fingoldin/lpddr5-testbed/fab/README.md

# Fabrication and assembly package: LPDDR5-CMD-TESTBED ZCU104 R0.2

Generated by `scripts/make_fab.py` and verified by `scripts/check_fab.py`; do not edit by hand. Regenerate with
`scripts/pcb/build.sh && python3 scripts/make_fab.py` (or `scripts/pcb/build.sh --fab`).

| | |
|---|---|
| Board file | `lpddr5-testbed.kicad_pcb` |
| SHA-256 of the board file | `ad7fe7fb7fc2977633b94e019d2710f937414a46d8ac770d9c7f32a83e93a95c` |
| Generated | 2026-11-11 04:40:53 -0800, KiCad (kicad-cli) 10.0.6 |
| Verification | **56 checks, 0 failed** (`verify/report.txt`) |
| KiCad DRC, all severities, with schematic parity | **0 errors, 0 unconnected, 0 parity issues**; 9 warnings (diff_pair_gap_out_of_range x 9) |

No fab vendor is targeted. The data are plain Gerber X2 and Excellon; everything a quotation form asks for is in the next section, and
everything the Gerbers cannot say is in `drawings/lpddr5-testbed-fabrication.pdf` (the notes are also on layer User.Comments).

## Order parameters

### Bare board

| Parameter | Value |
|---|---|
| Size | 69.6 x 30.0 mm (DDR4 SO-DIMM module outline), one board per unit; must be delivered in a panel (30 mm high) |
| Layers | 6 |
| Material | FR-4, Tg >= 170 C |
| **Finished thickness** | **1.20 +/-0.10 mm measured over the gold fingers** (an absolute tolerance, not +/-10 %); nominal 1.212 mm with mask, 1.192 mm at the bare fingers |
| Stackup | specified, see below; the three 0.11 mm prepregs set the impedances |
| Copper | outer 0.035 mm (0.040 mm finished nominal), inner 0.018 mm |
| Minimum track / gap | 0.09 mm track (inside the BGA field of U1 only; 0.10 mm elsewhere) / 0.10 mm gap |
| Holes | 393 plated (235 x 0.15 mm, 158 x 0.20 mm), 2 non-plated (1.80 mm); through holes only |
| Minimum annular ring | 0.10 mm (IPC-6012 class 2; class 3 is not attainable) |
| Via-in-pad | **253 vias filled and capped, IPC-4761 type VII** (235 x 0.15 mm in the lands of U1, 18 x 0.20 mm: `drill/filled_capped_vias.csv`); all other vias tented |
| Unused inner-layer pads | removed in the data on all vias except the ten command node vias: do not add them back |
| Surface finish | hard gold over nickel on the 260 finger lands of J1 (30 uin min), ENIG on all other exposed copper |
| Edge connector | 260 gold fingers, 0.25 mm x 45 deg chamfer only (no deep bevel); finger copper starts <= 0.30 mm from the edge; no plating tie bars left on the card |
| Controlled impedance | yes, five geometries, all +/-10 %, table below; TDR coupons on the panel border |
| Solder mask | LPI, both faces, black (green allowed if the 0.08 mm dam of the 0201 lands cannot be held in black) |
| Legend | white, both faces |
| Copper thieving | **none inside the card outline** (outer layers are 16-17 % copper by design; balance with robber bars on the panel border) |
| Acceptance | IPC-6012 class 2; 100 % netlist test against `netlist/lpddr5-testbed.d356`; bow and twist <= 0.5 %, flatness over the finger row <= 0.15 mm |
| Panel | routed outline, break-off tabs on the top edge or on the sides above the latch notches only (y > 22 mm), no V-score; three fiducials per face on the rails |

Stackup (top to bottom):

| Layer | Material | Thickness mm | er |
|---|---|---|---|
| F.Mask | LPI solder mask | 0.010 | 3.50 |
| F.Cu | copper | 0.035 |  |
|  | prepreg PR2116 | 0.110 | 4.29 |
| In1.Cu | copper | 0.018 |  |
|  | core FR4 | 0.360 | 4.29 |
| In2.Cu | copper | 0.018 |  |
|  | prepreg PR2116 | 0.110 | 4.29 |
| In3.Cu | copper | 0.018 |  |
|  | core FR4 | 0.360 | 4.29 |
| In4.Cu | copper | 0.018 |  |
|  | prepreg PR2116 | 0.110 | 4.29 |
| B.Cu | copper | 0.035 |  |
| B.Mask | LPI solder mask | 0.010 | 3.50 |

Impedance classes (design values from the 2-D field solver, `design/impedance_results.json`; outer layers for 0.040 mm copper under 0.020 mm mask):

| Layer | Type | Width / gap mm | Design | Order |
|---|---|---|---|---|
| In3.Cu (stripline between In2 and In4) | single | 0.15 | 45.6 ohm | 46 ohm |
| In3.Cu | differential | 0.10 / 0.10 | 84.6 ohm | 85 ohm |
| F.Cu / B.Cu (microstrip over In1 / In4) | single | 0.20 | 45.6 ohm | 46 ohm |
| F.Cu | single | 0.15 | 52.4 ohm | 52 ohm |
| F.Cu / B.Cu | differential | 0.10 / 0.10 | 91.8 ohm | 92 ohm |

### Assembly

| Parameter | Value |
|---|---|
| Parts | 119 placements, 27 BOM lines, none DNP: 59 on the top face, 60 on the bottom face (double-sided reflow) |
| Smallest part | 0201 (0603 metric): 61 of them |
| Fine pitch | U1: 315-ball FBGA, 0.80 x 0.70 mm pitch, lands 0.41 mm, via-in-pad filled and capped; U2 VSON-10 0.5 mm; U5 WSON-8 0.5 mm; U4 MLF-6 0.65 mm |
| Tallest part | 1.10 mm on either face (module limit 1.20 mm per face); see the open item on the body height of U1 in `design/DESIGN.md` section 8 |
| Fiducials | three per face on the card (`assembly/lpddr5-testbed-fiducials.csv`): 1.0 mm copper dot in a 2.0 mm mask opening |
| Stencil | 0.10 mm; no paste on the fingers, the test pads and the fiducials |
| Not placed | J1 (the card edge), TP1-TP5 (test pads), FID1-FID6 |

## Conventions of the coordinate files

- **Origin**: the drill / place origin of the board = the lower-left corner of the card rectangle seen from the front (the finger-1 end of the
  finger edge). **x to the right, y up, millimetres** in the Gerber, Excellon and placement files; the IPC-D-356 file uses 0.0001 inch, same origin.
  The profile therefore spans x 0 .. 69.6, y 0 .. 30.0.
- **Gerber**: X2 attributes, format 4.6, aperture macros enabled, one file per layer, KiCad file names (`.gbr`); the mask files are negative
  (drawn = opening); the legend files have the mask openings subtracted.
- **Excellon**: metric, decimal coordinates, plated and non-plated holes in separate files, finished hole sizes.
- **Placement files** (`Ref, Val, Package, PosX, PosY, Rot, Side`): PosX / PosY are the footprint origin (the centre of the part) in the frame above.
  **The bottom face is NOT mirrored**: x is as seen from the front, through the card. **Rot** is the KiCad footprint orientation: degrees
  counter-clockwise **seen from the front (top) of the card for both faces**; at Rot = 0 a top-side part has its library orientation (pin 1 as in the
  KiCad footprint), and a bottom-side part is the library footprint mirrored top-to-bottom (KiCad's flip). Seen from the back, a bottom-side part is
  therefore rotated by (180 - Rot) degrees counter-clockwise from its library orientation. `check_fab.py` recomputes every numbered pad of every part
  from the row and this convention and compares it with the board.

## Files

| File | Size | Content |
|---|---|---|
| `gerber/lpddr5-testbed-F_Cu.gbr` | 64.5 kB | copper layer 1 (top): parts, the DQ comb, finger stubs, 1.2 V strip; no pour |
| `gerber/lpddr5-testbed-In1_Cu.gbr` | 178.0 kB | copper layer 2: GND plane |
| `gerber/lpddr5-testbed-In2_Cu.gbr` | 190.3 kB | copper layer 3: GND plane with the 1.2 V island under the VDD fingers |
| `gerber/lpddr5-testbed-In3_Cu.gbr` | 12.8 kB | copper layer 4: high-speed stripline (command bundle, read branches, RDQS) |
| `gerber/lpddr5-testbed-In4_Cu.gbr` | 212.6 kB | copper layer 5: GND plane with the VDD2H island under U1 |
| `gerber/lpddr5-testbed-B_Cu.gbr` | 81.8 kB | copper layer 6 (bottom): WCK pair, read finger tracks, decoupling, U3 / U4, power pours under U1 |
| `gerber/lpddr5-testbed-F_Mask.gbr` | 17.3 kB | solder mask top (negative: drawn = opening); the finger strip is open up to y = 2.75 mm |
| `gerber/lpddr5-testbed-B_Mask.gbr` | 9.7 kB | solder mask bottom |
| `gerber/lpddr5-testbed-F_Paste.gbr` | 13.7 kB | paste top (stencil) |
| `gerber/lpddr5-testbed-B_Paste.gbr` | 6.3 kB | paste bottom (stencil) |
| `gerber/lpddr5-testbed-F_Silkscreen.gbr` | 79.1 kB | legend top (mask openings subtracted) |
| `gerber/lpddr5-testbed-B_Silkscreen.gbr` | 40.7 kB | legend bottom (mask openings subtracted) |
| `gerber/lpddr5-testbed-Edge_Cuts.gbr` | 1.6 kB | board profile: 69.6 x 30.0 mm with key slot, two latch notches, four corner chamfers |
| `gerber/lpddr5-testbed-User_Comments.gbr` | 1.80 MB | fabrication notes 1-13 as drawn on the board (the same text is sheet 3 of the fabrication drawing) |
| `gerber/lpddr5-testbed-User_Drawings.gbr` | 28.4 kB | mechanical layer of the card-edge footprint: component keep-out and height zones, finger numbers |
| `gerber/lpddr5-testbed-F_Fab.gbr` | 152.8 kB | assembly layer top: part outlines and references |
| `gerber/lpddr5-testbed-B_Fab.gbr` | 141.0 kB | assembly layer bottom |
| `gerber/lpddr5-testbed-job.gbrjob` | 5.5 kB | Gerber job file: layer list, stackup, thickness, finish, design rules |
| `drill/lpddr5-testbed-PTH.drl` | 5.3 kB | Excellon, plated holes: every via (0.15 and 0.20 mm) |
| `drill/lpddr5-testbed-NPTH.drl` | 389 B | Excellon, non-plated holes: the two 1.80 mm tooling holes |
| `drill/lpddr5-testbed-PTH-drl_map.pdf` | 25.3 kB | drill map of the plated holes |
| `drill/lpddr5-testbed-NPTH-drl_map.pdf` | 12.8 kB | drill map of the non-plated holes |
| `drill/lpddr5-testbed-drill_report.txt` | 869 B | KiCad drill report: tools and hit counts |
| `drill/lpddr5-testbed-filled_capped.drl` | 3.9 kB | Excellon subset: the vias to be filled and capped (IPC-4761 type VII) |
| `drill/filled_capped_vias.csv` | 13.7 kB | the same vias as a list: position, drill, pad, net and what each one sits in |
| `drill/gerber_x2/lpddr5-testbed-PTH-drl.gbr` | 9.3 kB | the plated holes as a Gerber X2 drill file (same holes as the Excellon file) |
| `drill/gerber_x2/lpddr5-testbed-NPTH-drl.gbr` | 633 B | the non-plated holes as a Gerber X2 drill file |
| `drill/gerber_x2/lpddr5-testbed-filling-front-back.gbr` | 6.3 kB | KiCad's via-filling layer: the filled vias |
| `drill/gerber_x2/lpddr5-testbed-capping-front-back.gbr` | 6.3 kB | KiCad's via-capping layer: the capped vias (the same set) |
| `netlist/lpddr5-testbed.d356` | 90.0 kB | IPC-D-356 netlist for the bare-board electrical test (inches x 0.0001, same origin) |
| `assembly/lpddr5-testbed-top.pos.csv` | 4.0 kB | pick-and-place, top face |
| `assembly/lpddr5-testbed-bottom.pos.csv` | 4.2 kB | pick-and-place, bottom face (x NOT mirrored) |
| `assembly/lpddr5-testbed-fiducials.csv` | 277 B | the six card fiducials (not in the placement files) |
| `assembly/lpddr5-testbed-bom.csv` | 4.5 kB | bill of materials, one line per part number: item, quantity, references, value, footprint, manufacturer, MPN, DNP, side, quantity per face |
| `assembly/lpddr5-testbed-bom-per-part.csv` | 18.1 kB | bill of materials, one row per reference with its face |
| `assembly/lpddr5-testbed-assembly-top.pdf` | 104.1 kB | assembly drawing top, 4.5 : 1, with the parts of that face |
| `assembly/lpddr5-testbed-assembly-bottom.pdf` | 80.7 kB | assembly drawing bottom, 4.5 : 1, seen from the back |
| `drawings/lpddr5-testbed-fabrication.pdf` | 61.6 kB | fabrication drawing, 3 sheets A3: outline with dimensions and drill map; stackup, impedance, via treatment; notes |
| `drawings/lpddr5-testbed-schematic.pdf` | 545.4 kB | schematic, 7 sheets |
| `3d/lpddr5-testbed.step` | 773.2 kB | STEP model of the card with the parts that have a 3-D model |
| `verify/report.txt` | 8.0 kB | result of scripts/check_fab.py, one line per check |
| `verify/report.json` | 17.5 kB | the same with the measured numbers |
| `verify/drc.json` | 8.9 kB | KiCad DRC report (all severities, schematic parity) |
| `verify/gerber_*.png` | 13 images | the Gerber files read back and rasterised by `check_fab.py` (30 px/mm): six copper layers with the drill hits, masks, pastes, legends, profile |

Notes on single files:

- `3d/lpddr5-testbed.step`: board body with the 117 parts whose footprint has a 3-D model (stock KiCad models). **No model**: FID1, FID2, FID3, FID4, FID5, FID6, J1, TP1, TP2, TP3, TP4, TP5, U1, U4 (project footprints, test pads, fiducials, the card edge): the BGA U1, the tallest part, is NOT in the model.
- `drill/gerber_x2/`: KiCad 10.0.6 writes the file-function attribute of its filling and capping layers as `%TF,FileFunction` (a comma instead of
  the dot); `make_fab.py` corrects that one character in `lpddr5-testbed-capping-front-back.gbr` and `lpddr5-testbed-filling-front-back.gbr`. Nothing else in any exported file is altered.
- The filled-and-capped set is given three ways (Excellon subset, CSV list, KiCad's X2 filling / capping layers) and in fabrication note 6; they are
  checked against each other and against the via attributes of the board file.
- `.gitignore` of the repository ignores `*.csv`: the BOM, placement and via-list files of this directory are hidden from git unless `!fab/**/*.csv` is added.

## Verification (`scripts/check_fab.py`)

The files are read back with parsers written for this purpose (Gerber with aperture macros, regions, arcs and polarity; Excellon; IPC-D-356; CSV)
and compared with the board as the pcbnew API reports its items, not with another plot. Copper layers are rasterised at 80 px/mm from the Gerber
file and, separately, from the tracks, arcs, via pads per layer, pad polygons and zone fills of the board; the two images must agree to one pixel.

| Group | Check | Result | Measured |
|---|---|---|---|
| gerber | all 17 layer files present and readable | pass | 17 files |
| gerber | six copper layers carry the X2 file functions L1 (Top), L2 .. L5 (Inr), L6 (Bot) | pass | F.Cu=Copper,L1,Top; In1.Cu=Copper,L2,Inr; In2.Cu=Copper,L3,Inr; In3.Cu=Copper,L4,Inr; In4.Cu=Copper,L5,Inr; B.Cu=Copper,L6,Bot |
| gerber | mask, paste, legend, profile and drawing files carry their X2 file functions | pass | all as expected |
| gerber | every selected aperture is defined, none has a zero dimension, no unsupported statement | pass | apertures per file: F.Cu 31, In1.Cu 2, In2.Cu 2, In3.Cu 4, In4.Cu 2, B.Cu 27, F.Mask 21, B.Mask 17, F.Paste 16, B.Paste 13, F.Silkscreen 23, B.Silkscreen 19, Edge.Cuts 1, User.Comments 2, User.Drawings 4, F.Fab 4, B.Fab 4 |
| gerber | job file: 6 layers, board thickness of the stackup, edge connector without bevel | pass | layers 6, thickness 1.212 mm, finish ENIG, impedance controlled True |
| profile | extents of the profile centre line = 0 .. 69.6 x 0 .. 30.0 mm, origin at the lower-left card corner | pass | x 0.0000 .. 69.6000, y 0.0000 .. 30.0000 |
| profile | the profile is ONE closed contour; its area equals the board outline of the board file | pass | 1 contour(s), 2069.750 mm2 (board 2069.754 mm2, difference area 0.0084 mm2) |
| drill | plated file: every hit is a via / plated hole of the board with that diameter, and the reverse | pass | file 235 x 0.15 mm, 158 x 0.20 mm; board 235 x 0.15 mm, 158 x 0.20 mm (393 vias) |
| drill | non-plated file: the two 1.80 mm tooling holes of the card edge | pass | file 2 x 1.80 mm; board 2 x 1.80 mm |
| drill | filled = capped on every via that carries either attribute | pass | 253 filled and capped of 393 vias |
| drill | filled-and-capped drill file = the vias with the attribute in the board file | pass | file 235 x 0.15 mm, 18 x 0.20 mm |
| drill | X2 filling layer = the same 253 vias; header well-formed | pass | 253 flashes |
| drill | X2 capping layer = the same 253 vias; header well-formed | pass | 253 flashes |
| drill | filled_capped_vias.csv lists the same vias | pass | 253 rows |
| copper | F.Cu: the Gerber image equals the layer drawn from the board items (tolerance one pixel = 12.5 um) | pass | 2171781 / 2171017 copper pixels, 764 differ at edges (0.035 %), beyond one pixel: 0 only in the Gerber, 0 only on the board |
| copper | F.Cu: no copper outside the profile | pass | nearest copper 0.163 mm from the edge; 16.4 % of the card area is copper |
| copper | In1.Cu: the Gerber image equals the layer drawn from the board items (tolerance one pixel = 12.5 um) | pass | 12184343 / 12184343 copper pixels, 0 differ at edges (0.000 %), beyond one pixel: 0 only in the Gerber, 0 only on the board |
| copper | In1.Cu: no copper outside the profile | pass | nearest copper 0.302 mm from the edge; 92.0 % of the card area is copper |
| copper | In2.Cu: the Gerber image equals the layer drawn from the board items (tolerance one pixel = 12.5 um) | pass | 12386240 / 12386240 copper pixels, 0 differ at edges (0.000 %), beyond one pixel: 0 only in the Gerber, 0 only on the board |
| copper | In2.Cu: no copper outside the profile | pass | nearest copper 0.301 mm from the edge; 93.5 % of the card area is copper |
| copper | In3.Cu: the Gerber image equals the layer drawn from the board items (tolerance one pixel = 12.5 um) | pass | 301158 / 301159 copper pixels, 1 differ at edges (0.000 %), beyond one pixel: 0 only in the Gerber, 0 only on the board |
| copper | In3.Cu: no copper outside the profile | pass | nearest copper 1.818 mm from the edge; 2.3 % of the card area is copper |
| copper | In4.Cu: the Gerber image equals the layer drawn from the board items (tolerance one pixel = 12.5 um) | pass | 12124966 / 12124966 copper pixels, 0 differ at edges (0.000 %), beyond one pixel: 0 only in the Gerber, 0 only on the board |
| copper | In4.Cu: no copper outside the profile | pass | nearest copper 0.302 mm from the edge; 91.5 % of the card area is copper |
| copper | B.Cu: the Gerber image equals the layer drawn from the board items (tolerance one pixel = 12.5 um) | pass | 2089602 / 2088730 copper pixels, 872 differ at edges (0.042 %), beyond one pixel: 0 only in the Gerber, 0 only on the board |
| copper | B.Cu: no copper outside the profile | pass | nearest copper 0.163 mm from the edge; 15.8 % of the card area is copper |
| copper | edge clearance: outer layers 0.15 mm (the fingers), every inner layer pulled back 0.3 mm or more | pass | F.Cu 0.16, In1.Cu 0.30, In2.Cu 0.30, In3.Cu 1.82, In4.Cu 0.30, B.Cu 0.16 |
| drill | every plated hit lies on copper on F.Cu and on B.Cu (outer via pads are kept) | pass | 393 of 393 hits |
| mask | all 260 fingers of J1 are free of solder mask over their whole land | pass | 260 lands inside the openings |
| mask | test pads and fiducials are open | pass | 11 pads |
| mask | plain vias are tented: the mask covers the centre of each on both faces | pass | 140 plain vias, 0 openings over a via centre |
| mask | the mask-free finger strip ends below the row of finger vias (y = 3.05 mm) | pass | 57 finger vias covered |
| paste | F.Paste: one aperture per pad that has paste | pass | 457 flashes, 457 pads with paste |
| paste | F.Paste: every paste aperture lies inside a mask opening | pass | 0 pixels outside |
| paste | B.Paste: one aperture per pad that has paste | pass | 129 flashes, 129 pads with paste |
| paste | B.Paste: every paste aperture lies inside a mask opening | pass | 0 pixels outside |
| paste | no paste on the fingers, the test pads and the fiducials | pass | 271 lands checked |
| legend | F.Silkscreen: no legend ink on exposed copper, none outside the card | pass | 152897 pixels of legend, 0 over mask openings, 0 outside |
| legend | B.Silkscreen: no legend ink on exposed copper, none outside the card | pass | 55630 pixels of legend, 0 over mask openings, 0 outside |
| netlist | IPC-D-356: one record per via, per numbered pad, per fiducial and per non-plated hole of the board | pass | 393 via records (393 vias), 844 pad records (844 numbered pads, 840 distinct pins), 6 fiducials, 2 non-plated holes |
| netlist | IPC-D-356: net names are in one-to-one relation with the nets of the board (names are cut to 14 characters) | pass | 225 nets |
| netlist | IPC-D-356: vias per net equal the board | pass | GND 199, 35 nets with vias |
| position | lpddr5-testbed-top.pos.csv: one row per placed part of that face (fingers, test pads and fiducials excluded) | pass | 59 rows, 59 parts on the board |
| position | lpddr5-testbed-top.pos.csv: X / Y = footprint position in the card frame (origin lower-left corner seen from the front, y up, x not mirrored), side column 'top' | pass | 59 rows |
| position | lpddr5-testbed-top.pos.csv: Rot = KiCad orientation; every numbered pad lands where 'counter-clockwise seen from the front' puts it | pass | 59 parts |
| position | lpddr5-testbed-bottom.pos.csv: one row per placed part of that face (fingers, test pads and fiducials excluded) | pass | 60 rows, 60 parts on the board |
| position | lpddr5-testbed-bottom.pos.csv: X / Y = footprint position in the card frame (origin lower-left corner seen from the front, y up, x not mirrored), side column 'bottom' | pass | 60 rows |
| position | lpddr5-testbed-bottom.pos.csv: Rot = KiCad orientation; every numbered pad lands where 'counter-clockwise seen from the front, footprint mirrored top-to-bottom' puts it | pass | 60 parts |
| position | fiducial list = FID1 .. FID6 of the board, three per face | pass | 6 rows |
| bom | BOM: every line agrees with the board (value, footprint, manufacturer, MPN, DNP, quantity, side counts) | pass | 27 lines |
| bom | BOM: every BOM part of the board is listed exactly once; nothing else is | pass | 119 references in 27 lines; board 119 (59 top, 60 bottom) |
| bom | BOM: lines and quantities equal design/netlist.json (bom_summary) | pass | 27 lines, 119 parts, 0 DNP |
| bom | position files and BOM list the same parts | pass | 119 / 119 |
| bom | per-part list: one row per BOM part with its face | pass | 119 rows |
| drc | kicad-cli DRC, all severities, with schematic parity: 0 errors, 0 unconnected, 0 parity issues; the only warnings are pair gaps where legs part | pass | KiCad 10.0.6: 0 errors, 9 warnings (diff_pair_gap_out_of_range x 9), 0 unconnected, 0 parity issues |
| board | the board file is unchanged by the verification | pass | ad7fe7fb7fc2977633b94e019d2710f937414a46d8ac770d9c7f32a83e93a95c |

Copper per layer, measured on the Gerber images:

| Layer | Flashes / draws / regions | Copper, % of the card | Nearest copper to the edge mm | Pixels that differ from the board items beyond one pixel |
|---|---|---|---|---|
| F.Cu | 982 / 451 / 0 | 16.4 | 0.16 | 0 |
| In1.Cu | 209 / 0 / 1 | 92.0 | 0.30 | 0 |
| In2.Cu | 218 / 0 / 2 | 93.5 | 0.30 | 0 |
| In3.Cu | 40 / 222 / 0 | 2.3 | 1.82 | 0 |
| In4.Cu | 198 / 0 / 2 | 91.5 | 0.30 | 0 |
| B.Cu | 654 / 259 / 6 | 15.8 | 0.16 | 0 |
