fingoldin/lpddr5-testbed/design/gateware/PINMAP.md

# Pin map of the LPDDR5 test card on the ZCU104 (socket J1)

> GENERATED by scripts/gen_gateware.py from design/netlist.json (revision 0.2, 2026-11-10) and
> design/gateware_deskew.json.  Do not edit: change the spec and re-run the generator.

Constraints: `lpddr5_testbed_zcu104.xdc`. The same table as CSV: `pinmap.csv` (with the full FPGA pin names). Part `xczu7ev-ffvc1156-2-e`.

- **P / N** is the polarity of the FPGA pin inside its I/O pair. A port `<x>_p` is always the FPGA P pin.
- **Bitslice** is the position inside the nibble (lower nibble N0-N5 = 0-5, upper nibble N6-N12 = 0-6); position 0 is
  the strobe / clock position of a native-mode nibble.
- **Level** is min / nominal / max over FPGA driver 26 / 36 / 44 ohm, VCCO 1.14 / 1.20 / 1.26 V and 1 % resistors
  (`analysis.dividers`), at the DRAM ball for outputs and at the FPGA pin for inputs.
- **Deskew** is the static delay the FPGA adds on that pin (`design/gateware_deskew.json`): ODELAYE3 for outputs,
  IDELAYE3 for inputs, `DELAY_FORMAT = "TIME"`, ps. Empty = none (matched on the card or static).

## Command (matched on the card)

| Port | Finger | FPGA ball | Bank | Nibble | Bitslice | P / N | Net at the finger | DRAM ball | Direction | I/O standard | On-card network | Level | Deskew ps |
|---|---|---|---|---|---|---|---|---|---|---|---|---|---|
| `ca[0]` | 84 B | AN22 | 65 | T0U | 2 | P | CA0_F | G4 | out | SSTL12, OUTPUT_IMPEDANCE RDRV_40_40, SLEW FAST | finger - R101 91R series - node CA0 - U1.G4; R111 68R node to GND | 0.378 / 0.418 / 0.468 V high, 0 V low |  |
| `ca[1]` | 83 F | AP23 | 65 | T0U | 3 | N | CA1_F | H5 | out | SSTL12, OUTPUT_IMPEDANCE RDRV_40_40, SLEW FAST | finger - R102 91R series - node CA1 - U1.H5; R112 68R node to GND | 0.378 / 0.418 / 0.468 V high, 0 V low |  |
| `ca[2]` | 79 F | AN19 | 65 | T0L | 3 | N | CA2_F | G8 | out | SSTL12, OUTPUT_IMPEDANCE RDRV_40_40, SLEW FAST | finger - R103 91R series - node CA2 - U1.G8; R113 68R node to GND | 0.378 / 0.418 / 0.468 V high, 0 V low |  |
| `ca[3]` | 70 B | AN23 | 65 | T0U | 5 | N | CA3_F | H11 | out | SSTL12, OUTPUT_IMPEDANCE RDRV_40_40, SLEW FAST | finger - R104 91R series - node CA3 - U1.H11; R114 68R node to GND | 0.378 / 0.418 / 0.468 V high, 0 V low |  |
| `ca[4]` | 71 F | AM23 | 65 | T0U | 4 | P | CA4_F | G10 | out | SSTL12, OUTPUT_IMPEDANCE RDRV_40_40, SLEW FAST | finger - R105 91R series - node CA4 - U1.G10; R115 68R node to GND | 0.378 / 0.418 / 0.468 V high, 0 V low |  |
| `ca[5]` | 66 B | AP22 | 65 | T0L | 5 | N | CA5_F | H13 | out | SSTL12, OUTPUT_IMPEDANCE RDRV_40_40, SLEW FAST | finger - R106 91R series - node CA5 - U1.H13; R116 68R node to GND | 0.378 / 0.418 / 0.468 V high, 0 V low |  |
| `ca[6]` | 67 F | AP21 | 65 | T0L | 4 | P | CA6_F | G12 | out | SSTL12, OUTPUT_IMPEDANCE RDRV_40_40, SLEW FAST | finger - R107 91R series - node CA6 - U1.G12; R117 68R node to GND | 0.378 / 0.418 / 0.468 V high, 0 V low |  |
| `ck_p` | 76 B | AM21 | 65 | T0U | 0 | P (DBC) | CK_F_P | H9 | out | DIFF_SSTL12, OUTPUT_IMPEDANCE RDRV_40_40, SLEW FAST | finger - R109 91R series - node CK_P - U1.H9; R119 68R node to GND | per leg 0.378 / 0.418 / 0.468 V high, 0 V low |  |
| `ck_n` | 74 B | AN21 | 65 | T0U | 1 | N (DBC) | CK_F_N | J9 | out | DIFF_SSTL12, OUTPUT_IMPEDANCE RDRV_40_40, SLEW FAST | finger - R110 91R series - node CK_N - U1.J9; R120 68R node to GND | per leg 0.378 / 0.418 / 0.468 V high, 0 V low |  |
| `cs0` | 80 B | AM19 | 65 | T0L | 2 | P | CS0_F | H7 | out | SSTL12, OUTPUT_IMPEDANCE RDRV_40_40, SLEW FAST | finger - R108 33R series - node CS0 - U1.H7; R118 100R node to GND | 0.640 / 0.710 / 0.797 V high, 0 V low |  |
| `cmd_open_low` | 75 F | AP19 | 65 | T0L | 0 | P (DBC) | (open) | - | out (static low) | SSTL12, OUTPUT_IMPEDANCE RDRV_40_40, SLEW SLOW | finger open on the card (no copper) | - |  |

## Write

| Port | Finger | FPGA ball | Bank | Nibble | Bitslice | P / N | Net at the finger | DRAM ball | Direction | I/O standard | On-card network | Level | Deskew ps |
|---|---|---|---|---|---|---|---|---|---|---|---|---|---|
| `wdq[0]` | 150 B | AL15 | 64 | T1L | 3 | N | DQ0_WF | D1 | out (Hi-Z during reads) | SSTL12, OUTPUT_IMPEDANCE RDRV_40_40, SLEW FAST | finger - R201 240R series - node DQ0 - U1.D1; R211 150R node to GND | 0.389 / 0.423 / 0.460 V high, 0 V low | 40.7 |
| `wdq[1]` | 145 F | AL16 | 64 | T1L | 2 | P | DQ1_WF | C2 | out (Hi-Z during reads) | SSTL12, OUTPUT_IMPEDANCE RDRV_40_40, SLEW FAST | finger - R202 240R series - node DQ1 - U1.C2; R212 150R node to GND | 0.389 / 0.423 / 0.460 V high, 0 V low | 51.0 |
| `wdq[2]` | 156 B | AA14 | 64 | T3U | 2 | P | DQ2_WF | E2 | out (Hi-Z during reads) | SSTL12, OUTPUT_IMPEDANCE RDRV_40_40, SLEW FAST | finger - R203 240R series - node DQ2 - U1.E2; R213 150R node to GND | 0.389 / 0.423 / 0.460 V high, 0 V low | 27.1 |
| `wdq[3]` | 151 F | AA16 | 64 | T3U | 0 | P (DBC) | DQ3_WF | D3 | out (Hi-Z during reads) | SSTL12, OUTPUT_IMPEDANCE RDRV_40_40, SLEW FAST | finger - R204 240R series - node DQ3 - U1.D3; R214 150R node to GND | 0.389 / 0.423 / 0.460 V high, 0 V low | 41.0 |
| `wdq[4]` | 143 F | AD16 | 64 | T3U | 5 | N | DQ4_WF | B5 | out (Hi-Z during reads) | SSTL12, OUTPUT_IMPEDANCE RDRV_40_40, SLEW FAST | finger - R205 240R series - node DQ4 - U1.B5; R215 150R node to GND | 0.389 / 0.423 / 0.460 V high, 0 V low | 53.5 |
| `wdq[5]` | 144 B | AH16 | 64 | T2U | 6 | - | DQ5_WF | C6 | out (Hi-Z during reads) | SSTL12, OUTPUT_IMPEDANCE RDRV_40_40, SLEW FAST | finger - R206 240R series - node DQ5 - U1.C6; R216 150R node to GND | 0.389 / 0.423 / 0.460 V high, 0 V low | 23.1 |
| `wdq[6]` | 157 F | AL17 | 64 | T1U | 6 | - | DQ6_WF | E6 | out (Hi-Z during reads) | SSTL12, OUTPUT_IMPEDANCE RDRV_40_40, SLEW FAST | finger - R207 240R series - node DQ6 - U1.E6; R217 150R node to GND | 0.389 / 0.423 / 0.460 V high, 0 V low | 3.4 |
| `wdq[7]` | 161 F | AM16 | 64 | T1L | 0 | P (QBC) | DQ7_WF | F5 | out (Hi-Z during reads) | SSTL12, OUTPUT_IMPEDANCE RDRV_40_40, SLEW FAST | finger - R208 240R series - node DQ7 - U1.F5; R218 150R node to GND | 0.389 / 0.423 / 0.460 V high, 0 V low | 0.0 |
| `wck_p` | 137 F | AF18 | 64 | T2L | 2 | P (GC), **inverted pair** | WCK_F_N | D5 | out | DIFF_SSTL12, OUTPUT_IMPEDANCE RDRV_40_40, SLEW FAST | finger - R210 91R series - node WCK_N - U1.D5; R220 68R node to GND | per leg 0.378 / 0.418 / 0.468 V high, 0 V low |  |
| `wck_n` | 139 F | AG18 | 64 | T2L | 3 | N (GC), **inverted pair** | WCK_F_P | E4 | out | DIFF_SSTL12, OUTPUT_IMPEDANCE RDRV_40_40, SLEW FAST | finger - R209 91R series - node WCK_P - U1.E4; R219 68R node to GND | per leg 0.378 / 0.418 / 0.468 V high, 0 V low |  |

## Read

| Port | Finger | FPGA ball | Bank | Nibble | Bitslice | P / N | Net at the finger | DRAM ball | Direction | I/O standard | On-card network | Level | Deskew ps |
|---|---|---|---|---|---|---|---|---|---|---|---|---|---|
| `rdq_p[0]` | 204 B | AH11 | 66 | T2L | 2 | P (GC) | DQ0 | D1 | in | MIPI_DPHY_DCI, DIFF_TERM_ADV TERM_NONE | U1.D1 - node DQ0 - finger (no series part); R211 150R node to GND = read load; R201 240R to the write finger 150 | read high 0.374 / 0.386 / 0.405 V into 150 ohm (LPDDR4X IBIS proxies (0.766 .. 0.792 x VDDQ into 150 ohm)), low 0 V | 52.8 |
| `rdq_n[0]` | 203 F | AJ11 | 66 | T2L | 3 | N (GC) | VREF_N0 | - | in (DC) | MIPI_DPHY_DCI, DIFF_TERM_ADV TERM_NONE | finger - R321 39R - VREF_RD (DAC_OUT -300R- VREF_RD ; VDDQ -300R- VREF_RD ; VREF_RD -180R- GND ; 1 uF + 8 x 100 nF on the bus) | VREF_RD: 0.187 V with the DAC Hi-Z (power-up), 0.195 V at DAC code 121; range 0.136 .. 0.631 V |  |
| `rdq_p[1]` | 208 B | AG11 | 66 | T2U | 2 | P | DQ1 | C2 | in | MIPI_DPHY_DCI, DIFF_TERM_ADV TERM_NONE | U1.C2 - node DQ1 - finger (no series part); R212 150R node to GND = read load; R202 240R to the write finger 145 | read high 0.374 / 0.386 / 0.405 V into 150 ohm (LPDDR4X IBIS proxies (0.766 .. 0.792 x VDDQ into 150 ohm)), low 0 V | 37.4 |
| `rdq_n[1]` | 207 F | AG10 | 66 | T2U | 3 | N | VREF_N1 | - | in (DC) | MIPI_DPHY_DCI, DIFF_TERM_ADV TERM_NONE | finger - R322 39R - VREF_RD (DAC_OUT -300R- VREF_RD ; VDDQ -300R- VREF_RD ; VREF_RD -180R- GND ; 1 uF + 8 x 100 nF on the bus) | VREF_RD: 0.187 V with the DAC Hi-Z (power-up), 0.195 V at DAC code 121; range 0.136 .. 0.631 V |  |
| `rdq_p[2]` | 190 B | AG13 | 66 | T2L | 4 | P | DQ2 | E2 | in | MIPI_DPHY_DCI, DIFF_TERM_ADV TERM_NONE | U1.E2 - node DQ2 - finger (no series part); R213 150R node to GND = read load; R203 240R to the write finger 156 | read high 0.374 / 0.386 / 0.405 V into 150 ohm (LPDDR4X IBIS proxies (0.766 .. 0.792 x VDDQ into 150 ohm)), low 0 V | 88.3 |
| `rdq_n[2]` | 191 F | AH13 | 66 | T2L | 5 | N | VREF_N2 | - | in (DC) | MIPI_DPHY_DCI, DIFF_TERM_ADV TERM_NONE | finger - R323 39R - VREF_RD (DAC_OUT -300R- VREF_RD ; VDDQ -300R- VREF_RD ; VREF_RD -180R- GND ; 1 uF + 8 x 100 nF on the bus) | VREF_RD: 0.187 V with the DAC Hi-Z (power-up), 0.195 V at DAC code 121; range 0.136 .. 0.631 V |  |
| `rdq_p[3]` | 194 B | AF8 | 66 | T2U | 4 | P | DQ3 | D3 | in | MIPI_DPHY_DCI, DIFF_TERM_ADV TERM_NONE | U1.D3 - node DQ3 - finger (no series part); R214 150R node to GND = read load; R204 240R to the write finger 151 | read high 0.374 / 0.386 / 0.405 V into 150 ohm (LPDDR4X IBIS proxies (0.766 .. 0.792 x VDDQ into 150 ohm)), low 0 V | 69.1 |
| `rdq_n[3]` | 195 F | AG8 | 66 | T2U | 5 | N | VREF_N3 | - | in (DC) | MIPI_DPHY_DCI, DIFF_TERM_ADV TERM_NONE | finger - R324 39R - VREF_RD (DAC_OUT -300R- VREF_RD ; VDDQ -300R- VREF_RD ; VREF_RD -180R- GND ; 1 uF + 8 x 100 nF on the bus) | VREF_RD: 0.187 V with the DAC Hi-Z (power-up), 0.195 V at DAC code 121; range 0.136 .. 0.631 V |  |
| `rdq_p[4]` | 215 F | AJ9 | 66 | T1U | 4 | P (GC) | DQ4 | B5 | in | MIPI_DPHY_DCI, DIFF_TERM_ADV TERM_NONE | U1.B5 - node DQ4 - finger (no series part); R215 150R node to GND = read load; R205 240R to the write finger 143 | read high 0.374 / 0.386 / 0.405 V into 150 ohm (LPDDR4X IBIS proxies (0.766 .. 0.792 x VDDQ into 150 ohm)), low 0 V | 0.0 |
| `rdq_n[4]` | 216 B | AK9 | 66 | T1U | 5 | N (GC) | VREF_N4 | - | in (DC) | MIPI_DPHY_DCI, DIFF_TERM_ADV TERM_NONE | finger - R325 39R - VREF_RD (DAC_OUT -300R- VREF_RD ; VDDQ -300R- VREF_RD ; VREF_RD -180R- GND ; 1 uF + 8 x 100 nF on the bus) | VREF_RD: 0.187 V with the DAC Hi-Z (power-up), 0.195 V at DAC code 121; range 0.136 .. 0.631 V |  |
| `rdq_p[5]` | 212 B | AK12 | 66 | T1L | 4 | P | DQ5 | C6 | in | MIPI_DPHY_DCI, DIFF_TERM_ADV TERM_NONE | U1.C6 - node DQ5 - finger (no series part); R216 150R node to GND = read load; R206 240R to the write finger 144 | read high 0.374 / 0.386 / 0.405 V into 150 ohm (LPDDR4X IBIS proxies (0.766 .. 0.792 x VDDQ into 150 ohm)), low 0 V | 3.5 |
| `rdq_n[5]` | 211 F | AL12 | 66 | T1L | 5 | N | VREF_N5 | - | in (DC) | MIPI_DPHY_DCI, DIFF_TERM_ADV TERM_NONE | finger - R326 39R - VREF_RD (DAC_OUT -300R- VREF_RD ; VDDQ -300R- VREF_RD ; VREF_RD -180R- GND ; 1 uF + 8 x 100 nF on the bus) | VREF_RD: 0.187 V with the DAC Hi-Z (power-up), 0.195 V at DAC code 121; range 0.136 .. 0.631 V |  |
| `rdq_p[6]` | 186 B | AE12 | 66 | T3U | 2 | P | DQ6 | E6 | in | MIPI_DPHY_DCI, DIFF_TERM_ADV TERM_NONE | U1.E6 - node DQ6 - finger (no series part); R217 150R node to GND = read load; R207 240R to the write finger 157 | read high 0.374 / 0.386 / 0.405 V into 150 ohm (LPDDR4X IBIS proxies (0.766 .. 0.792 x VDDQ into 150 ohm)), low 0 V | 105.3 |
| `rdq_n[6]` | 187 F | AF12 | 66 | T3U | 3 | N | VREF_N6 | - | in (DC) | MIPI_DPHY_DCI, DIFF_TERM_ADV TERM_NONE | finger - R327 39R - VREF_RD (DAC_OUT -300R- VREF_RD ; VDDQ -300R- VREF_RD ; VREF_RD -180R- GND ; 1 uF + 8 x 100 nF on the bus) | VREF_RD: 0.187 V with the DAC Hi-Z (power-up), 0.195 V at DAC code 121; range 0.136 .. 0.631 V |  |
| `rdq_p[7]` | 182 B | AD14 | 66 | T3L | 2 | P | DQ7 | F5 | in | MIPI_DPHY_DCI, DIFF_TERM_ADV TERM_NONE | U1.F5 - node DQ7 - finger (no series part); R218 150R node to GND = read load; R208 240R to the write finger 161 | read high 0.374 / 0.386 / 0.405 V into 150 ohm (LPDDR4X IBIS proxies (0.766 .. 0.792 x VDDQ into 150 ohm)), low 0 V | 113.7 |
| `rdq_n[7]` | 183 F | AE14 | 66 | T3L | 3 | N | VREF_N7 | - | in (DC) | MIPI_DPHY_DCI, DIFF_TERM_ADV TERM_NONE | finger - R328 39R - VREF_RD (DAC_OUT -300R- VREF_RD ; VDDQ -300R- VREF_RD ; VREF_RD -180R- GND ; 1 uF + 8 x 100 nF on the bus) | VREF_RD: 0.187 V with the DAC Hi-Z (power-up), 0.195 V at DAC code 121; range 0.136 .. 0.631 V |  |
| `rdqs_p` | 221 F | AK8 | 66 | T1U | 0 | P (QBC), **inverted pair** | RDQS_N | C4 | in | MIPI_DPHY_DCI, DIFF_TERM_ADV TERM_NONE | U1.C4 - finger (no series part); R310 150R to GND | true differential: VID +/-0.386 V, VICM 0.193 V while the DRAM drives; both legs 0 V when idle | 0.0 |
| `rdqs_n` | 219 F | AL8 | 66 | T1U | 1 | N (QBC), **inverted pair** | RDQS_P | B3 | in | MIPI_DPHY_DCI, DIFF_TERM_ADV TERM_NONE | U1.B3 - finger (no series part); R309 150R to GND | true differential: VID +/-0.386 V, VICM 0.193 V while the DRAM drives; both legs 0 V when idle | 0.0 |

## Reset

| Port | Finger | FPGA ball | Bank | Nibble | Bitslice | P / N | Net at the finger | DRAM ball | Direction | I/O standard | On-card network | Level | Deskew ps |
|---|---|---|---|---|---|---|---|---|---|---|---|---|---|
| `reset_n` | 232 B | AP11 | 66 | T0L | 5 | N | RESET_N_F | H1 | out (static) | LVCMOS12, DRIVE 8 | finger - R402 100R series - node RESET_N - U1.H1; R403 1k node to GND | 0.959 / 1.034 / 1.121 V high, 0 V low |  |

## Pair polarities

| Pair | FPGA P pin carries | FPGA N pin carries | Gateware |
|---|---|---|---|
| CK | CK_t (finger 76, AM21) | CK_c (finger 74, AN21) | not inverted |
| WCK | WCK_c (finger 137, AF18) | WCK_t (finger 139, AG18) | **inverted**: drive the pair with inverted data (or shift the WCK generator by 180 degrees) |
| RDQS | RDQS_c (finger 221, AK8) | RDQS_t (finger 219, AL8) | **inverted**: invert the strobe after the differential receiver (or swap the capture edges) |

## Deskew table (start values; training refines them)

| Bit | Write total ps (die pad to ball) | Output delay ps | Read total ps (ball to die pad) | To the strobe ps | Input delay ps |
|---|---|---|---|---|---|
| DQ0 | 760.77 | 40.7 | 896.87 | -26.24 | 52.8 |
| DQ1 | 750.55 | 51.0 | 912.31 | -10.81 | 37.4 |
| DQ2 | 774.43 | 27.1 | 861.37 | -61.75 | 88.3 |
| DQ3 | 760.53 | 41.0 | 880.59 | -42.53 | 69.1 |
| DQ4 | 748.03 | 53.5 | 949.67 | +26.56 | 0.0 |
| DQ5 | 778.44 | 23.1 | 946.18 | +23.06 | 3.5 |
| DQ6 | 798.09 | 3.4 | 844.38 | -78.74 | 105.3 |
| DQ7 | 801.51 | 0.0 | 835.98 | -87.13 | 113.7 |
| RDQS | | | 923.12 / 923.12 | 0 | 0.0 |
| WCK | 784.26 / 784.79 | 0 | | | |

- Write: spread +/-26.7 ps, latest total 801.51 ps; WCK arrives -17.0 ps after the latest DQ before the table is applied
  (negative = before) and is not matched to DQ (tWCK2DQI is trained).
- Read: spread +/-56.8 ps about 892.83 ps; with the table every DQ reaches the capture flop 26.56 ps after the strobe edge that
  left the DRAM with it. Pass the strobe through an IDELAYE3 at value 0 too, so that the insertion delay of the primitive cancels.
- RDQS: In3 from the balls B3 / C4 to a via pair just above fingers 219 / 221 (y = 8.50 mm), then 5.80 mm of F.Cu into the fingers: the same form as a read DQ line. It arrives +30.29 ps from the centre of the read group (-26.56 ps from the latest bit, +87.13 ps from the
  earliest); strobe minus each bit before the table: DQ0 +26.2, DQ1 +10.8, DQ2 +61.8, DQ3 +42.5, DQ4 -26.6, DQ5 -23.1, DQ6 +78.7, DQ7 +87.1 ps.
- IDELAYE3: range 0 .. 1100 ps, 512 taps of 2.1 .. 12.0 ps.
- The command bus needs no table: its ten nets are matched on the card; what the +/-5 ps knowledge of the host leaves is
  removed per bit with the output delay of the command pins.

## What follows from the pin names

- command: bank 65, 11 pins in 2 nibble(s): T0L, T0U
- write: bank 64, 10 pins in 5 nibble(s): T1L, T1U, T2L, T2U, T3U
- read: bank 66, 18 pins in 6 nibble(s): T1L, T1U, T2L, T2U, T3L, T3U
- reset: bank 66, 1 pins in 1 nibble(s): T0L
- ck_p / ck_n on AM21 / AN21 (IO_L4P_T0U_N6_DBC_AD7P_SMBALERT_65, bitslice 0 of T0U): clock-capable: DBC
- wck_p / wck_n on AF18 / AG18 (IO_L14P_T2L_N2_GC_64, bitslice 2 of T2L): clock-capable: GC; pair inverted on the host
- rdqs_p / rdqs_n on AK8 / AL8 (IO_L10P_T1U_N6_QBC_AD4P_66, bitslice 0 of T1U): clock-capable: QBC; pair inverted on the host
- ck_p (AM21, IO_L4P_T0U_N6_DBC_AD7P_SMBALERT_65) has the multi-function name SMBALERT: UG1075 table 1-4 warns that such a pin can be driven before configuration (it names Kintex / Virtex UltraScale+; whether that holds for this Zynq part is not stated). On this card it could only move one divider node between 0 V and its high level while the DRAM is held in reset
- outputs in the read bank: reset_n (AP11, LVCMOS12)
- read data on global-clock (GC) pins: rdq_p[0] (AH11), rdq_p[4] (AJ9)

## Other fingers the card uses (not FPGA socket pins)

| Finger | DDR4 name | Card net | Function |
|---|---|---|---|
| 253 F | SCL | SCL | I2C clock to the reference DAC (host 4.99 k pull-up to 3.3 V, mux 0x74 channel 7) |
| 254 B | SDA | SDA | I2C data to the reference DAC (host 4.99 k pull-up to 3.3 V) |
| 255 F | VDDSPD | V3P3 | VDDSPD: 3.3 V on the ZCU104 (VDD1 regulator input, LDO bias, DAC) |
| 19 fingers | VDD | V1P2 | host 1.2 V rail |
| 94 fingers | VSS | GND | |

## FPGA pins of the socket that the card leaves open

86 pins; none is tied to a rail on the card. Leave them out of the design or drive them low.

| Finger | DDR4 name | FPGA ball | Bank | Nibble |
|---|---|---|---|---|
| 3 F | DQ5 | AG19 | 65 | T2L |
| 4 B | DQ4 | AG20 | 65 | T2L |
| 7 F | DQ1 | AE23 | 65 | T2U |
| 8 B | DQ0 | AE24 | 65 | T2U |
| 11 F | DQS0_C | AG23 | 65 | T2U |
| 12 B | DM0_N/DBI0_N | AH22 | 65 | T2L |
| 13 F | DQS0_T | AF23 | 65 | T2U |
| 16 B | DQ6 | AH21 | 65 | T2L |
| 17 F | DQ7 | AG21 | 65 | T2L |
| 20 B | DQ2 | AF22 | 65 | T2U |
| 21 F | DQ3 | AF21 | 65 | T2U |
| 24 B | DQ12 | AE20 | 65 | T3L |
| 25 F | DQ13 | AD20 | 65 | T3L |
| 28 B | DQ8 | AA20 | 65 | T3U |
| 29 F | DQ9 | AA19 | 65 | T3U |
| 32 B | DQS1_C | AB18 | 65 | T3U |
| 33 F | DM1_N/DBI1_N | AE18 | 65 | T3L |
| 34 B | DQS1_T | AA18 | 65 | T3U |
| 37 F | DQ15 | AB19 | 65 | T3L |
| 38 B | DQ14 | AC19 | 65 | T3L |
| 41 F | DQ10 | AD19 | 65 | T3U |
| 42 B | DQ11 | AC18 | 65 | T3U |
| 45 F | DQ21 | AJ19 | 65 | T1L |
| 46 B | DQ20 | AK19 | 65 | T1L |
| 49 F | DQ17 | AJ21 | 65 | T1U |
| 50 B | DQ16 | AJ22 | 65 | T1U |
| 53 F | DQS2_C | AK23 | 65 | T1U |
| 54 B | DM2_N/DBI2_N | AL20 | 65 | T1L |
| 55 F | DQS2_T | AK22 | 65 | T1U |
| 58 B | DQ22 | AL23 | 65 | T1L |
| 59 F | DQ23 | AL22 | 65 | T1L |
| 62 B | DQ18 | AK20 | 65 | T1U |
| 63 F | DQ19 | AJ20 | 65 | T1U |
| 75 F | DM3_N/DBI3_N | AP19 | 65 | T0L |
| 108 B | RESET_N | AB14 | 64 | T3U |
| 109 F | CKE0 | AD17 | 64 | T3U |
| 110 B | CKE1 | AM15 | 64 | T1L |
| 113 F | BG1 | AB16 | 64 | T3L |
| 114 B | ACT_N | AC17 | 64 | T3L |
| 115 F | BG0 | AC16 | 64 | T3L |
| 116 B | ALERT_N | AB15 | 64 | T3L |
| 119 F | A12 | AL18 | 64 | T1L |
| 120 B | A11 | AK15 | 64 | T1U |
| 121 F | A9 | AJ17 | 64 | T1U |
| 122 B | A7 | AF17 | 64 | T2L |
| 125 F | A8 | AK17 | 64 | T1U |
| 126 B | A5 | AJ14 | 64 | T2U |
| 127 F | A6 | AH14 | 64 | T2U |
| 128 B | A4 | AF16 | 64 | T2U |
| 131 F | A3 | AF15 | 64 | T2U |
| 132 B | A2 | AG15 | 64 | T2U |
| 133 F | A1 | AG14 | 64 | T2U |
| 138 B | CK1_T/NF | AJ16 | 64 | T1U |
| 140 B | CK1_C/NF | AJ15 | 64 | T1U |
| 146 B | A10/AP | AK14 | 64 | T1U |
| 149 F | CS0_N | AA15 | 64 | T3U |
| 152 B | RAS_N/A16 | AD15 | 64 | T3L |
| 155 F | ODT0 | AE15 | 64 | T3L |
| 158 B | A13 | AK18 | 64 | T1L |
| 162 B | C0/CS2_N/NC | AN17 | 64 | T0U |
| 165 F | C1/CS3_N/NC | AN16 | 64 | T0U |
| 169 F | DQ37 | AE13 | 66 | T3L |
| 170 B | DQ36 | AF13 | 66 | T3L |
| 173 F | DQ33 | AB13 | 66 | T3U |
| 174 B | DQ32 | AC13 | 66 | T3U |
| 177 F | DQS4_C | AD12 | 66 | T3U |
| 178 B | DM4_N/DBI4_N | AF11 | 66 | T3L |
| 179 F | DQS4_T | AC12 | 66 | T3U |
| 198 B | DQS5_C | AH9 | 66 | T2U |
| 199 F | DM5_N/DBI5_N | AH12 | 66 | T2L |
| 200 B | DQS5_T | AG9 | 66 | T2U |
| 220 B | DM6_N/DBI6_N | AK13 | 66 | T1L |
| 224 B | DQ54 | AL10 | 66 | T1L |
| 225 F | DQ55 | AL11 | 66 | T1L |
| 228 B | DQ50 | AK10 | 66 | T1U |
| 229 F | DQ51 | AJ10 | 66 | T1U |
| 233 F | DQ61 | AN11 | 66 | T0L |
| 236 B | DQ57 | AM9 | 66 | T0U |
| 237 F | DQ56 | AM8 | 66 | T0U |
| 240 B | DQS7_C | AN8 | 66 | T0U |
| 241 F | DM7_N/DBI7_N | AN12 | 66 | T0L |
| 242 B | DQS7_T | AN9 | 66 | T0U |
| 245 F | DQ62 | AP9 | 66 | T0L |
| 246 B | DQ63 | AP10 | 66 | T0L |
| 249 F | DQ58 | AM10 | 66 | T0U |
| 250 B | DQ59 | AM11 | 66 | T0U |
