fingoldin/lpddr5-testbed/doc/img/all_copper.png

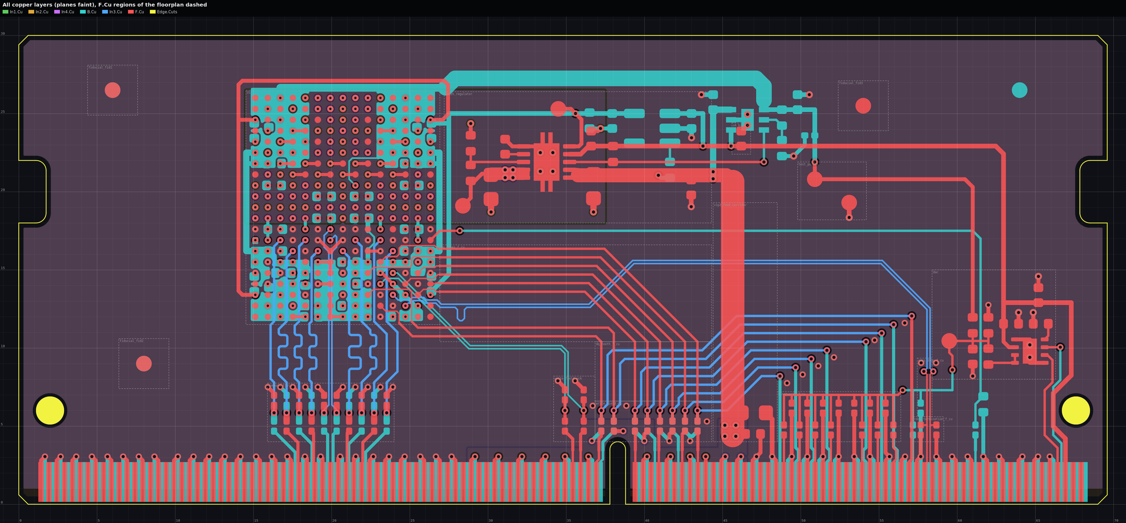
doc/img/all_copper.png
