fingoldin/lpddr5-testbed/doc/img/asm_bottom.png

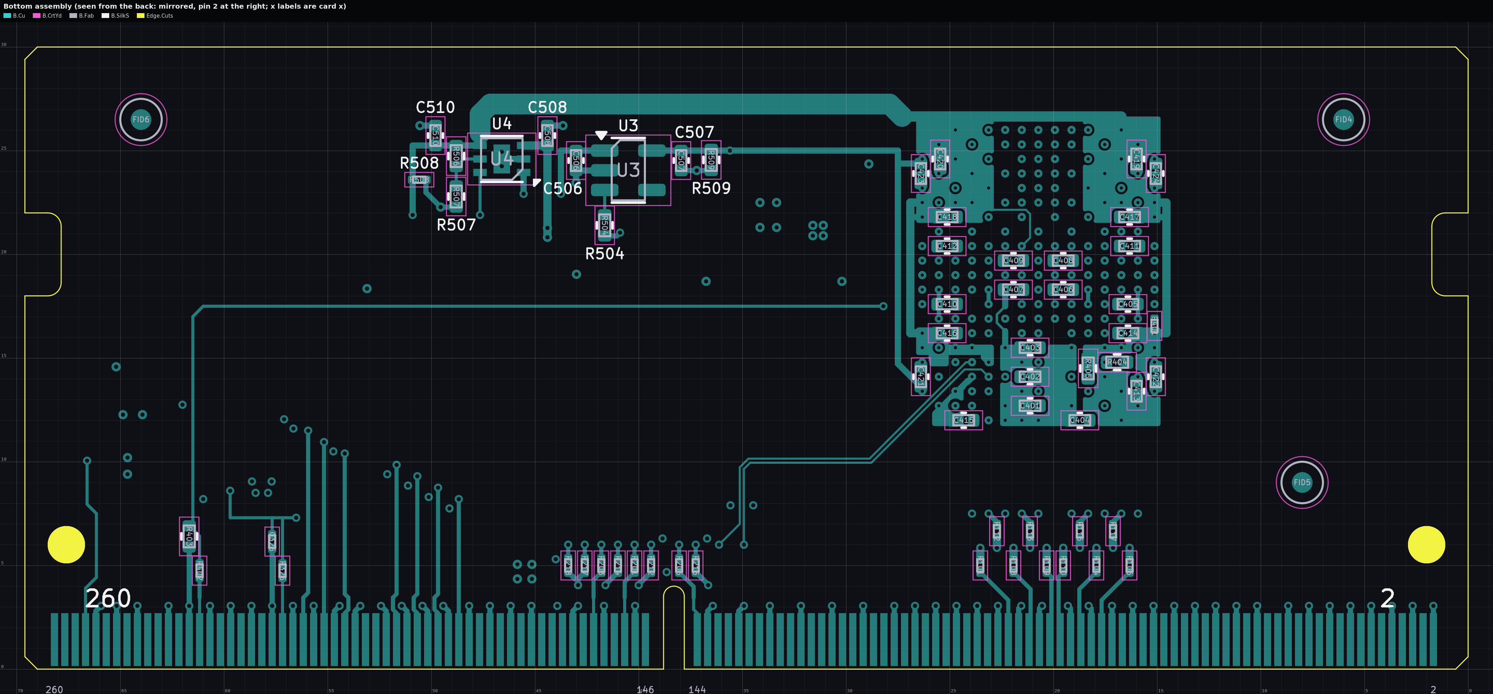
doc/img/asm_bottom.png
