fingoldin/lpddr5-testbed/doc/img/asm_top.png

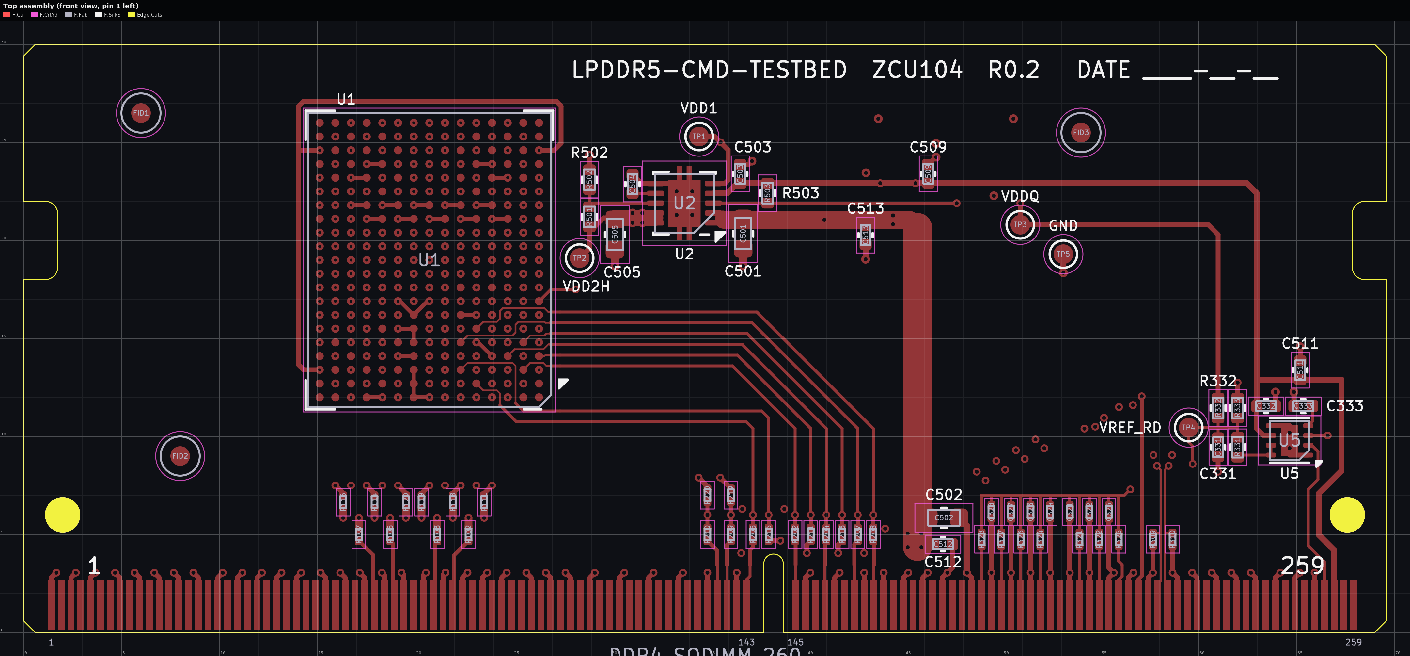
doc/img/asm_top.png
