fingoldin/lpddr5-testbed/doc/img/layer_B_Cu.png

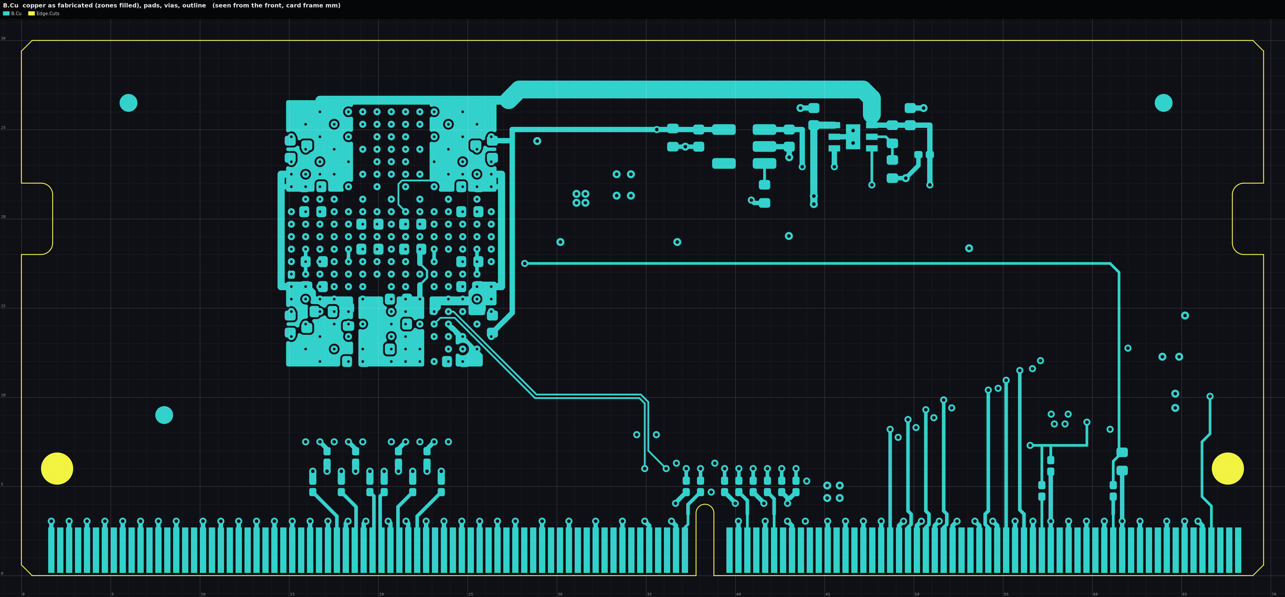
doc/img/layer_B_Cu.png
