fingoldin/lpddr5-testbed/doc/img/layer_F_Cu.png

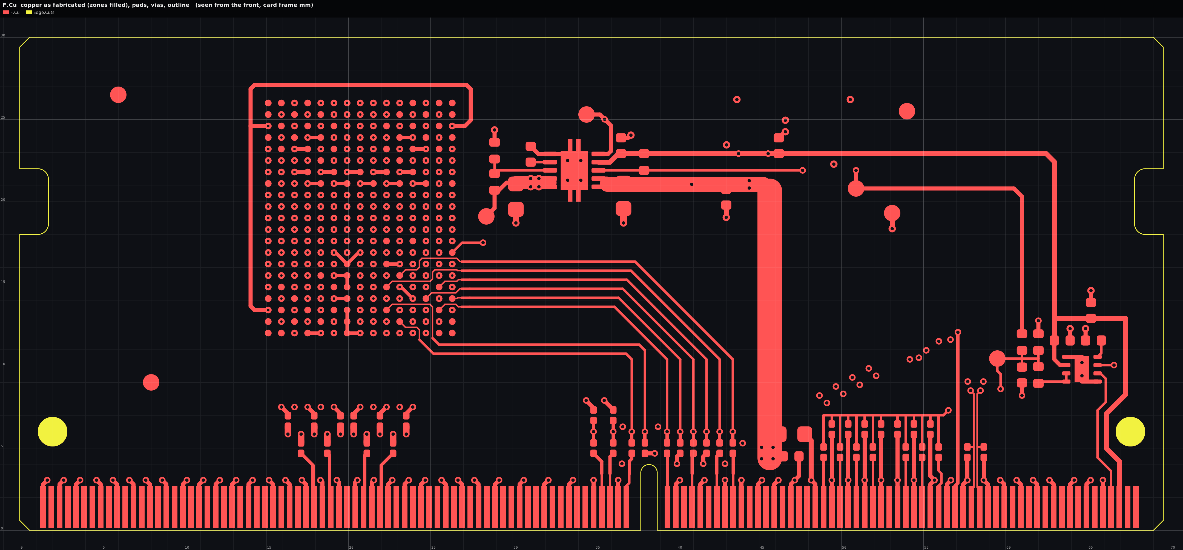
doc/img/layer_F_Cu.png
