fingoldin/lpddr5-testbed/doc/img/layer_In1_Cu.png

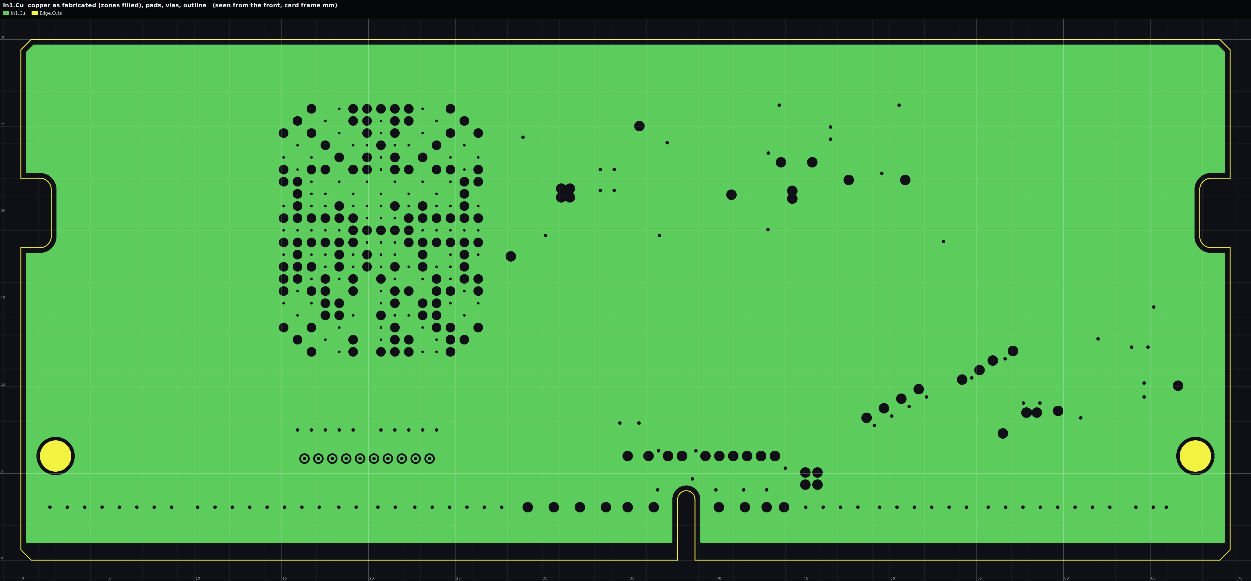
doc/img/layer_In1_Cu.png
