fingoldin/lpddr5-testbed/doc/img/layer_In3_Cu.png

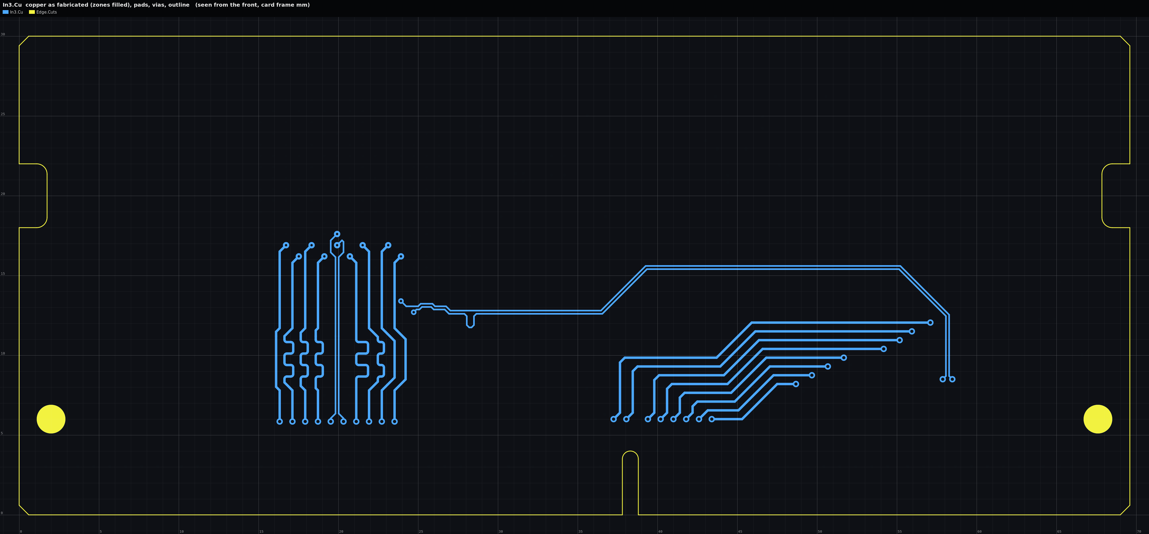
doc/img/layer_In3_Cu.png
