fingoldin/lpddr5-testbed/references/dram/Micron_315b_ballmap.png

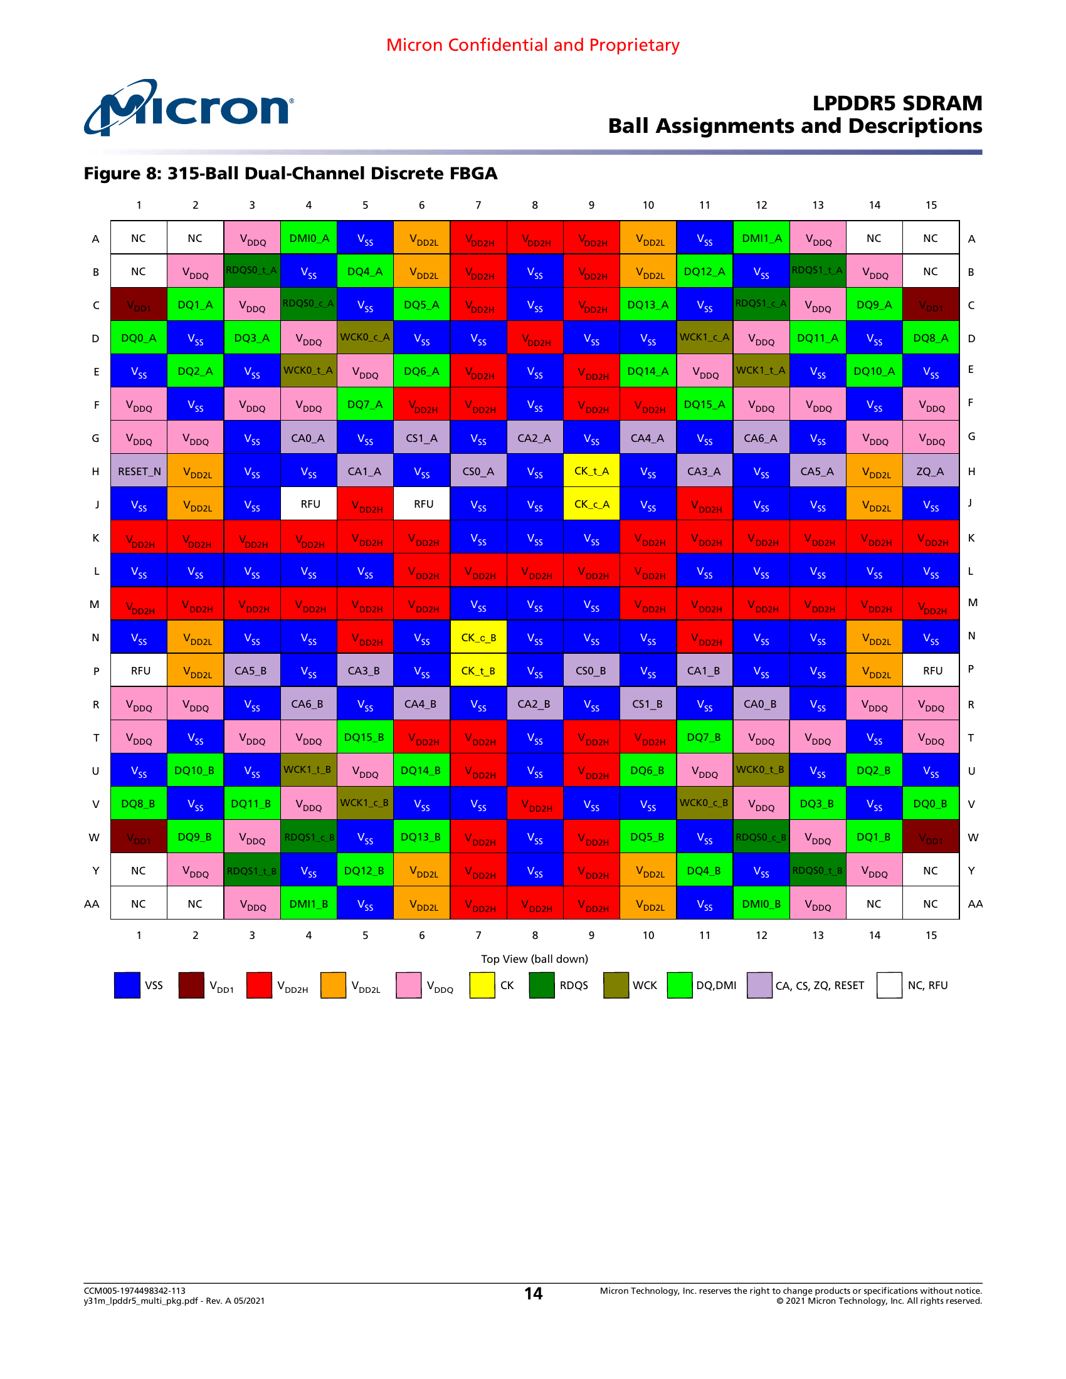
references/dram/Micron_315b_ballmap.png
