fingoldin/lpddr5-testbed/references/sodimm_module/foxconn_317-0000-2253_contact_point_estimate.png

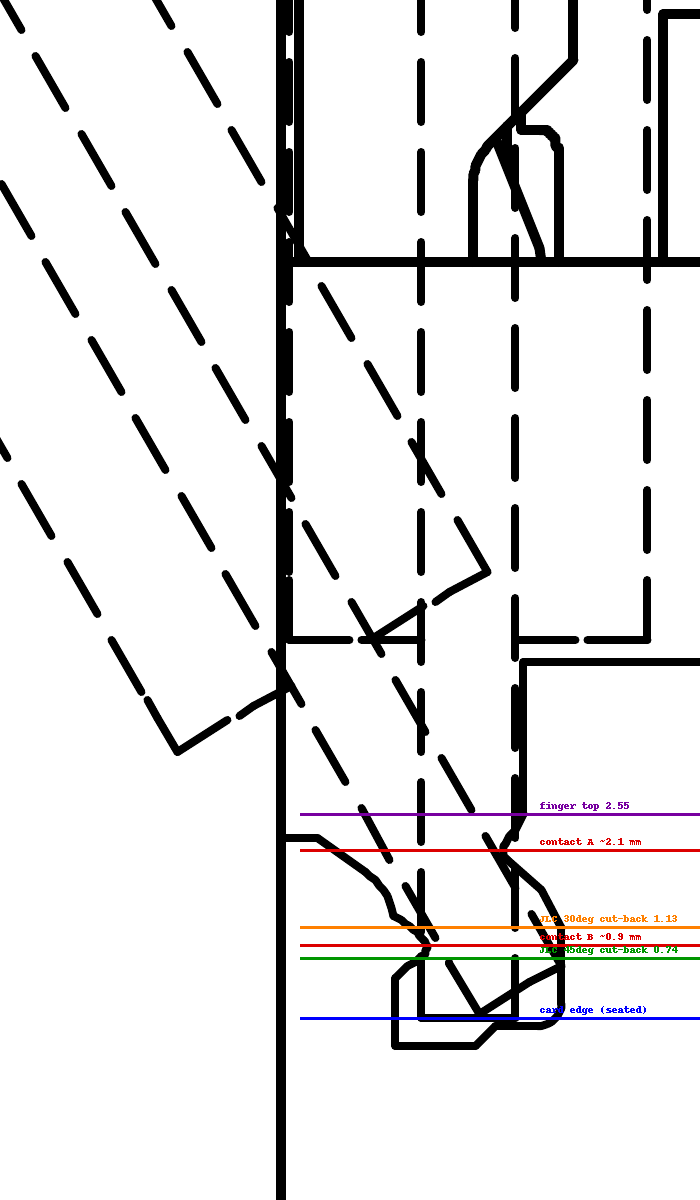
references/sodimm_module/foxconn_317-0000-2253_contact_point_estimate.png
