fingoldin/lpddr5-testbed/references/jlc/jlc_pcba_parts_sourcing.txt

Source: https://jlcpcb.com/help/article/pcba-parts-sourcing-instruction
Retrieved 2026-10-02 (text of the server-rendered HTML, including collapsed sections; layout is in jlc_pcba_parts_sourcing.pdf)

PCBA Parts Sourcing InstructionThis website requires JavaScript.
Account Restriction Notice
Get Coupon Here
Coupons
Country / Region
Language
undefined
Currency
USD $
The currency you select is for reference only, payments must be made in US dollars.
Save
Language Coming Soon
Ship to
JLCPCB PCB Service
FR-4 PCBs
Flexible PCBs
Metal Core PCBs
High-Frequency PCBs
PCBA Service
PCB Assembly
Parts Library
More
SMT Stencil
PCB Layout
Mechanical Services
JLC3DP - 3D Printing
JLCCNC - CNC Machining
JLCCNC - Sheet Metal
JLCMC - Mechanical Components
Tools
EasyEDA - PCB Design Tool
JLCDFM - DFM Check
Impedance Calculator
PI Stiffener Calculator
More
OSHWLAB - Open Source Hardware
JLCPCB - Flexible Heater
Products
Capabilities Contact Us
Online Chat>
Mon-Fri: 24 hours, Sat: 9am-6pm, GMT+8
Email Us>
Mon-Fri: 24 hours, Sat: 9am-6pm, GMT+8
WhatsApp>
Mon-Fri: 24 hours, Sat: 9am-6pm, GMT+8
Support
Help Center Get instant answers. 24/7 Available.
Blog
Community
Support
About Us
JLCPCB delivers one-stop electronic and mechanical manufacturing solutions to empower hardware innovators worldwide.
Explore Us
Why JLCPCB?
Quality Assurance
How We Work
Certifications
Company News
About Us
Search
0
Order Now
Sign In
Sign In
Help Center
Help Center
PCBA Parts Sourcing
PCBA Parts Sourcing Instruction
Help Center
Get Started
Register
Know Before Ordering
Account Setting
Ordering
PCB Ordering
PCB Assembly Ordering
PCB Stencil Ordering
PCB Manufacturing
PCB Files Preparation
PCB Capabilities & Instructions
PCB Technical Guidelines
PCB Assembly
PCB Assembly FAQs
PCBA Price Details
PCBA Parts Sourcing
PCBA Capabilities & Instructions
PCBA Technical Guidelines
PCBA Files Preparation
PCBA Lead Time
PCBA After-Sale
FPC Manufacturing
FPC Materials & Options
FPC Design Guidelines
SMT Stencil
Stencil Ordering
Stencil Technical Guidelines
PCB Layout
PCB Layout Ordering
PCB Layout FAQs
JLCDFM Tool
DFM Tool Help
DFM FAQs
JLCONE
JLCONE FAQs
JLCONE Download and Installation
Shipping & Delivery
Shipping Policies
Shipping Instructions
Payment & Invoice
Payments
Collab & Activities
JLCPCB API
Coupons & Promotions
Policies & Certifications
Policies
Certifications
Information
Notice
Flexible Heater
Flexible Heater Ordering
PCBA Parts Sourcing Instruction
Last updated on Sep 09, 2026
1. What are the sources of PCBA parts?
PCBA parts can be sourced from the following options:
JLCPCB parts: These are JLCPCB's public in-stock parts, readily available for selection in our library.
Global sourcing parts: These parts are sourced by JLCPCB from global distributors, offering a wide range of options. (Lead time: 9-15 days)
Pre-order parts: In cases where we have no stock or low stock, customers can make pre-orders to replenish them in their private library within the JLCPCB library. However, parts can only be selected for use in customers' assembly orders once they arrive at our warehouse.
Consign parts: Customers have the option to consign their own parts to our stock and use them when placing PCBA orders.
New Parts Request: If customers cannot find a specific part in our part library, it may be because it hasn't been listed yet. In such cases, customers can submit a new part request.
2. Are there any limitations when placing PCBA orders with these parts?
Yes, there are limitations based on the type of parts selected.
Global sourcing parts can be chosen alongside consign parts within the same order. Similarly, parts from JLCPCB public parts library can be selected along with private pre-order parts/global sourcing parts/consign parts within the same order.
It's important to note that this rule applies to the same part in a single order. However, customers have the flexibility to choose global sourcing parts and pre-order parts simultaneously for different parts within the same order.
3. Instruction for ordering parts
Global sourcing parts Instruction
Pre-order parts Instruction
Pre-Ordering Parts Terms & Conditions
How to use parts from Pre-order/Global sourcing
Consign parts Instruction
Consignment Parts Terms & Conditions
Online Chat >
Chat with our live agent for fast reply.
Mon-Fri: 24 hours, Sat: 9am-6pm, GMT+8
Email Us >
Contact us at supportjlcpcb.com
Typically reply within hours.
Help Center >
Get instant answers.
24/7 Available.
Products
FR-4 PCBs
Flexible PCBs
Metal Core PCBs
High-Frequency PCBs
PCBA Service
PCB Layout
SMT Stencil
Flex Heater
Support
Help Center
Contact Us
Community
Shipping & Delivery
Payment Methods
How to Order
How to Track
After-Sales Service
Blog
Company
About Us
Quality Assurance
How We Work
Certifications
Security
Environment
JLCAPI
News
Cooperation
Electronics
EasyEDA
JLCPCB
JLCDFM
LCSC
OSHWLAB
Mechanical
JLC3DP
JLCCNC
JLCMC
CONNECT WITH US
© 2026 JLCPCB.COM All Rights Reserved.
Privacy Policy
Terms & Conditions
Cookies Policy
Get Coupon >
Live Chat >
Home
Cart
Files
Message
Me
