fingoldin/lpddr5-testbed/design/ref/zcu104_finger_total_delay.csv

finger | ddr4_name | fpga_ball | fpga_pin_func | bank | byte_group | nibble | io_pair | pn | partner_ball | host_layers | host_nvia | host_len_mm | host_len_L1_mm | host_len_inner_mm | host_stub_mm | host_delay_ps | pkg_min_ps | pkg_max_ps | total_min_ps | total_max_ps | total_mid_ps | ibis_sqrtLC_pkg_ps | vivado_mid_minus_ibis_ps | host_note
3 | DQ5 | AG19 | IO_L15P_T2L_N4_AD11P_65 | 65 | T2 | L | L15 | P | AG20 | L1+L12 | 2 | 63.36 | 1.86 | 61.5 | 0.0 | 378.2 | 138.746 | 140.14 | 517.0 | 518.4 | 517.7 | 138.3 | 1.2
4 | DQ4 | AG20 | IO_L15N_T2L_N5_AD11N_65 | 65 | T2 | L | L15 | N | AG19 | L1+L12 | 2 | 64.53 | 1.59 | 62.94 | 0.0 | 385.4 | 136.194 | 137.563 | 521.6 | 523.0 | 522.3 | 135.3 | 1.6
7 | DQ1 | AE23 | IO_L18P_T2U_N10_AD2P_65 | 65 | T2 | U | L18 | P | AE24 | L1+L12 | 2 | 66.48 | 2.39 | 64.1 | 0.0 | 396.6 | 126.489 | 127.76 | 523.1 | 524.4 | 523.8 | 126.5 | 0.6
8 | DQ0 | AE24 | IO_L18N_T2U_N11_AD2N_65 | 65 | T2 | U | L18 | N | AE23 | L1+L12 | 2 | 65.33 | 1.66 | 63.67 | 0.0 | 390.2 | 130.582 | 131.894 | 520.8 | 522.1 | 521.4 | 130.1 | 1.2
11 | DQS0_C | AG23 | IO_L16N_T2U_N7_QBC_AD3N_65 | 65 | T2 | U | L16 | N | AF23 | L1+L12 | 2 | 65.05 | 3.37 | 61.68 | 0.0 | 387.3 | 131.773 | 133.097 | 519.1 | 520.4 | 519.8 | 131.2 | 1.2
12 | DM0_N/DBI0_N | AH22 | IO_L13P_T2L_N0_GC_QBC_65 | 65 | T2 | L | L13 | P | AH23 | L1+L12 | 2 | 64.24 | 2.55 | 61.69 | 0.0 | 383.0 | 134.767 | 136.121 | 517.8 | 519.2 | 518.5 | 135.2 | 0.2
13 | DQS0_T | AF23 | IO_L16P_T2U_N6_QBC_AD3P_65 | 65 | T2 | U | L16 | P | AG23 | L1+L12 | 2 | 65.1 | 2.28 | 62.82 | 0.0 | 388.4 | 131.587 | 132.909 | 520.0 | 521.3 | 520.6 | 130.7 | 1.5
16 | DQ6 | AH21 | IO_L14N_T2L_N3_GC_65 | 65 | T2 | L | L14 | N | AG21 | L1+L12 | 2 | 64.57 | 2.52 | 62.05 | 0.0 | 385.0 | 132.854 | 134.189 | 517.9 | 519.2 | 518.6 | 132.1 | 1.4
17 | DQ7 | AG21 | IO_L14P_T2L_N2_GC_65 | 65 | T2 | L | L14 | P | AH21 | L1+L12 | 2 | 64.56 | 2.57 | 61.99 | 0.0 | 384.9 | 132.854 | 134.189 | 517.8 | 519.1 | 518.5 | 131.9 | 1.6
20 | DQ2 | AF22 | IO_L17N_T2U_N9_AD10N_65 | 65 | T2 | U | L17 | N | AF21 | L1+L12 | 2 | 67.48 | 1.39 | 66.09 | 0.0 | 403.2 | 118.493 | 119.684 | 521.7 | 522.9 | 522.3 | 117.8 | 1.3
21 | DQ3 | AF21 | IO_L17P_T2U_N8_AD10P_65 | 65 | T2 | U | L17 | P | AF22 | L1+L12 | 2 | 68.49 | 3.21 | 65.29 | 0.0 | 408.1 | 113.13 | 114.267 | 521.2 | 522.4 | 521.8 | 112.8 | 0.9
24 | DQ12 | AE20 | IO_L21N_T3L_N5_AD8N_65 | 65 | T3 | L | L21 | N | AD20 | L1+L3 | 2 | 70.67 | 1.61 | 69.06 | 0.0 | 422.2 | 108.956 | 110.051 | 531.2 | 532.3 | 531.7 | 104.3 | 5.2
25 | DQ13 | AD20 | IO_L21P_T3L_N4_AD8P_65 | 65 | T3 | L | L21 | P | AE20 | L1+L3 | 2 | 71.37 | 1.39 | 69.98 | 0.07 | 426.5 | 107.053 | 108.129 | 533.6 | 534.7 | 534.1 | 101.4 | 6.2
28 | DQ8 | AA20 | IO_L24N_T3U_N11_PERSTN0_65 | 65 | T3 | U | L24 | N | AA19 | L1+L3 | 2 | 68.37 | 1.35 | 67.01 | 0.0 | 408.5 | 119.782 | 120.986 | 528.3 | 529.5 | 528.9 | 116.7 | 3.7
29 | DQ9 | AA19 | IO_L24P_T3U_N10_PERSTN1_I2C_SDA_65 | 65 | T3 | U | L24 | P | AA20 | L1+L3 | 2 | 68.89 | 1.48 | 67.42 | 0.0 | 411.7 | 117.056 | 118.232 | 528.7 | 529.9 | 529.3 | 114.2 | 3.4
32 | DQS1_C | AB18 | IO_L22N_T3U_N7_DBC_AD0N_65 | 65 | T3 | U | L22 | N | AA18 | L1+L3 | 2 | 66.53 | 1.81 | 64.72 | 0.1 | 397.3 | 134.62 | 135.973 | 531.9 | 533.2 | 532.6 | 134.1 | 1.1
33 | DM1_N/DBI1_N | AE18 | IO_L19P_T3L_N0_DBC_AD9P_65 | 65 | T3 | L | L19 | P | AE19 | L1+L3 | 2 | 69.4 | 3.03 | 66.37 | 0.0 | 413.6 | 112.974 | 114.11 | 526.6 | 527.7 | 527.2 | 111.5 | 2.1
34 | DQS1_T | AA18 | IO_L22P_T3U_N6_DBC_AD0P_65 | 65 | T3 | U | L22 | P | AB18 | L1+L3 | 2 | 66.78 | 1.93 | 64.85 | 0.0 | 398.7 | 133.583 | 134.925 | 532.3 | 533.6 | 532.9 | 132.0 | 2.2
37 | DQ15 | AB19 | IO_L20P_T3L_N2_AD1P_65 | 65 | T3 | L | L20 | P | AC19 | L1+L3 | 2 | 67.76 | 3.62 | 64.13 | 0.0 | 403.3 | 123.072 | 124.309 | 526.4 | 527.6 | 527.0 | 122.7 | 1.0
38 | DQ14 | AC19 | IO_L20N_T3L_N3_AD1N_65 | 65 | T3 | L | L20 | N | AB19 | L1+L3 | 2 | 68.61 | 1.28 | 67.33 | 0.0 | 410.1 | 117.99 | 119.176 | 528.1 | 529.3 | 528.7 | 116.6 | 2.0
41 | DQ10 | AD19 | IO_L23N_T3U_N9_65 | 65 | T3 | U | L23 | N | AC18 | L1+L3 | 2 | 71.17 | 1.44 | 69.73 | 0.0 | 425.3 | 109.939 | 111.044 | 535.3 | 536.4 | 535.8 | 108.5 | 2.0
42 | DQ11 | AC18 | IO_L23P_T3U_N8_I2C_SCLK_65 | 65 | T3 | U | L23 | P | AD19 | L1+L3 | 2 | 70.77 | 2.12 | 68.65 | 0.0 | 422.4 | 109.352 | 110.451 | 531.8 | 532.9 | 532.4 | 107.9 | 2.0
45 | DQ21 | AJ19 | IO_L9P_T1L_N4_AD12P_65 | 65 | T1 | L | L9 | P | AK19 | L1+L7 | 2 | 60.5 | 4.42 | 56.08 | 0.0 | 359.3 | 166.817 | 168.493 | 526.2 | 527.8 | 527.0 | 166.7 | 1.0
46 | DQ20 | AK19 | IO_L9N_T1L_N5_AD12N_65 | 65 | T1 | L | L9 | N | AJ19 | L1+L7 | 2 | 60.33 | 1.42 | 58.9 | 0.0 | 360.3 | 166.727 | 168.403 | 527.1 | 528.7 | 527.9 | 166.3 | 1.3
49 | DQ17 | AJ21 | IO_L12P_T1U_N10_GC_65 | 65 | T1 | U | L12 | P | AJ22 | L1+L7 | 2 | 64.54 | 2.09 | 62.45 | 0.0 | 385.2 | 141.862 | 143.288 | 527.0 | 528.4 | 527.7 | 140.6 | 2.0
50 | DQ16 | AJ22 | IO_L12N_T1U_N11_GC_65 | 65 | T1 | U | L12 | N | AJ21 | L1+L7 | 2 | 65.09 | 2.1 | 62.99 | 0.0 | 388.4 | 141.775 | 143.2 | 530.2 | 531.6 | 530.9 | 140.3 | 2.2
53 | DQS2_C | AK23 | IO_L10N_T1U_N7_QBC_AD4N_65 | 65 | T1 | U | L10 | N | AK22 | L1+L7 | 2 | 63.72 | 1.48 | 62.24 | 0.0 | 380.7 | 146.581 | 148.054 | 527.2 | 528.7 | 528.0 | 147.6 | -0.3
54 | DM2_N/DBI2_N | AL20 | IO_L7P_T1L_N0_QBC_AD13P_65 | 65 | T1 | L | L7 | P | AL21 | L1+L7 | 2 | 60.19 | 1.46 | 58.73 | 0.0 | 359.5 | 168.472 | 170.166 | 528.0 | 529.7 | 528.8 | 168.2 | 1.1
55 | DQS2_T | AK22 | IO_L10P_T1U_N6_QBC_AD4P_65 | 65 | T1 | U | L10 | P | AK23 | L1+L7 | 2 | 63.72 | 1.58 | 62.14 | 0.0 | 380.6 | 146.341 | 147.812 | 526.9 | 528.4 | 527.7 | 145.5 | 1.6
58 | DQ22 | AL23 | IO_L8N_T1L_N3_AD5N_65 | 65 | T1 | L | L8 | N | AL22 | L1+L7 | 2 | 62.71 | 1.55 | 61.16 | 0.0 | 374.6 | 149.908 | 151.415 | 524.5 | 526.0 | 525.2 | 150.0 | 0.7
59 | DQ23 | AL22 | IO_L8P_T1L_N2_AD5P_65 | 65 | T1 | L | L8 | P | AL23 | L1+L7 | 2 | 64.41 | 2.06 | 62.34 | 0.0 | 384.3 | 144.393 | 145.845 | 528.7 | 530.2 | 529.5 | 143.5 | 1.6
62 | DQ18 | AK20 | IO_L11N_T1U_N9_GC_65 | 65 | T1 | U | L11 | N | AJ20 | L1+L7 | 2 | 63.86 | 1.5 | 62.36 | 0.0 | 381.5 | 146.231 | 147.701 | 527.7 | 529.2 | 528.5 | 145.9 | 1.1
63 | DQ19 | AJ20 | IO_L11P_T1U_N8_GC_65 | 65 | T1 | U | L11 | P | AK20 | L1+L7 | 2 | 63.62 | 1.53 | 62.08 | 0.08 | 380.0 | 145.798 | 147.264 | 525.8 | 527.2 | 526.5 | 145.9 | 0.6
66 | DQ28 | AP22 | IO_L3N_T0L_N5_AD15N_65 | 65 | T0 | L | L3 | N | AP21 | L1+L5 | 2 | 62.55 | 1.46 | 61.09 | 0.0 | 373.7 | 158.478 | 160.071 | 532.1 | 533.7 | 532.9 | 158.8 | 0.5
67 | DQ29 | AP21 | IO_L3P_T0L_N4_AD15P_65 | 65 | T0 | L | L3 | P | AP22 | L1+L5 | 2 | 61.96 | 1.68 | 60.27 | 0.0 | 369.9 | 156.665 | 158.239 | 526.6 | 528.2 | 527.4 | 157.1 | 0.4
70 | DQ24 | AN23 | IO_L6N_T0U_N11_AD6N_65 | 65 | T0 | U | L6 | N | AM23 | L1+L5 | 2 | 60.59 | 2.95 | 57.63 | 0.0 | 360.8 | 165.511 | 167.174 | 526.3 | 528.0 | 527.2 | 167.8 | -1.4
71 | DQ25 | AM23 | IO_L6P_T0U_N10_AD6P_65 | 65 | T0 | U | L6 | P | AN23 | L1+L5 | 2 | 60.81 | 1.67 | 59.14 | 0.0 | 363.1 | 169.691 | 171.396 | 532.8 | 534.5 | 533.6 | 170.8 | -0.2
74 | DQS3_C | AN21 | IO_L4N_T0U_N7_DBC_AD7N_65 | 65 | T0 | U | L4 | N | AM21 | L1+L5 | 2 | 60.86 | 2.79 | 58.07 | 0.0 | 362.6 | 166.974 | 168.652 | 529.6 | 531.3 | 530.4 | 162.0 | 5.8
75 | DM3_N/DBI3_N | AP19 | IO_L1P_T0L_N0_DBC_65 | 65 | T0 | L | L1 | P | AP20 | L1+L5 | 2 | 62.94 | 2.56 | 60.38 | 0.0 | 375.2 | 151.182 | 152.701 | 526.4 | 527.9 | 527.2 | 151.1 | 0.8
76 | DQS3_T | AM21 | IO_L4P_T0U_N6_DBC_AD7P_SMBALERT_65 | 65 | T0 | U | L4 | P | AN21 | L1+L5 | 2 | 60.84 | 1.53 | 59.31 | 0.0 | 363.4 | 166.975 | 168.653 | 530.4 | 532.0 | 531.2 | 169.4 | -1.6
79 | DQ30 | AN19 | IO_L2N_T0L_N3_65 | 65 | T0 | L | L2 | N | AM19 | L1+L5 | 2 | 62.37 | 2.57 | 59.8 | 0.0 | 371.8 | 153.599 | 155.142 | 525.4 | 527.0 | 526.2 | 155.8 | -1.4
80 | DQ31 | AM19 | IO_L2P_T0L_N2_65 | 65 | T0 | L | L2 | P | AN19 | L1+L5 | 2 | 61.45 | 2.77 | 58.68 | 0.0 | 366.2 | 159.994 | 161.602 | 526.2 | 527.8 | 527.0 | 162.1 | -1.3
83 | DQ26 | AP23 | IO_L5N_T0U_N9_AD14N_65 | 65 | T0 | U | L5 | N | AN22 | L1+L5 | 2 | 59.95 | 2.51 | 57.44 | 0.0 | 357.4 | 172.06 | 173.79 | 529.4 | 531.2 | 530.3 | 174.3 | -1.4
84 | DQ27 | AN22 | IO_L5P_T0U_N8_AD14P_65 | 65 | T0 | U | L5 | P | AP23 | L1+L5 | 2 | 61.48 | 2.27 | 59.21 | 0.0 | 366.7 | 167.514 | 169.198 | 534.2 | 535.9 | 535.1 | 168.8 | -0.5
108 | RESET_N | AB14 | IO_L23N_T3U_N9_64 | 64 | T3 | U | L23 | N | AA14 | L1+L12 | 2 | 70.5 | 4.46 | 66.04 | 0.0 | 419.2 | 73.205 | 73.941 | 492.4 | 493.2 | 492.8 | 72.8 | 0.7
109 | CKE0 | AD17 | IO_L24P_T3U_N10_64 | 64 | T3 | U | L24 | P | AD16 | L1+L14 | 2 | 85.0 | 3.44 | 81.56 | 3.13 | 506.8 | 99.509 | 100.509 | 606.3 | 607.3 | 606.8 | 99.0 | 1.0 | R506 4.70k 1% pull-down to GND
110 | CKE1 | AM15 | IO_L7N_T1L_N1_QBC_AD13N_64 | 64 | T1 | L | L7 | N | AM16 | L1+L12 | 2 | 79.01 | 2.61 | 76.4 | 2.28 | 471.5 | 139.828 | 141.233 | 611.3 | 612.7 | 612.0 | 143.0 | -2.4 | R505 4.70k 1% pull-down to GND
113 | BG1 | AB16 | IO_L21P_T3L_N4_AD8P_64 | 64 | T3 | L | L21 | P | AB15 | L1+L12 | 2 | 89.75 | 2.01 | 87.74 | 0.03 | 536.2 | 72.783 | 73.515 | 609.0 | 609.7 | 609.4 | 73.6 | -0.5
114 | ACT_N | AC17 | IO_L20P_T3L_N2_AD1P_64 | 64 | T3 | L | L20 | P | AC16 | L1+L12 | 2 | 88.9 | 5.62 | 83.28 | 0.13 | 528.6 | 77.892 | 78.674 | 606.5 | 607.3 | 606.9 | 78.5 | -0.2
115 | BG0 | AC16 | IO_L20N_T3L_N3_AD1N_64 | 64 | T3 | L | L20 | N | AC17 | L1+L12 | 2 | 90.11 | 2.83 | 87.29 | 0.0 | 537.9 | 71.312 | 72.029 | 609.2 | 609.9 | 609.5 | 72.0 | -0.3
116 | ALERT_N | AB15 | IO_L21N_T3L_N5_AD8N_64 | 64 | T3 | L | L21 | N | AB16 | L1+L12 | 2 | 89.98 | 5.03 | 84.94 | 0.0 | 535.4 | 71.906 | 72.629 | 607.4 | 608.1 | 607.7 | 70.8 | 1.5
119 | A12 | AL18 | IO_L9N_T1L_N5_AD12N_64 | 64 | T1 | L | L9 | N | AK18 | L1+L14 | 2 | 82.37 | 3.42 | 78.96 | 0.0 | 491.1 | 117.603 | 118.785 | 608.7 | 609.9 | 609.3 | 117.9 | 0.3
120 | A11 | AK15 | IO_L10P_T1U_N6_QBC_AD4P_64 | 64 | T1 | U | L10 | P | AK14 | L1+L14 | 2 | 79.61 | 3.04 | 76.57 | 0.0 | 474.8 | 135.896 | 137.262 | 610.7 | 612.0 | 611.3 | 137.0 | -0.5
121 | A9 | AJ17 | IO_L11P_T1U_N8_GC_64 | 64 | T1 | U | L11 | P | AK17 | L1+L14 | 2 | 82.48 | 1.38 | 81.11 | 0.02 | 493.2 | 117.008 | 118.184 | 610.2 | 611.3 | 610.8 | 118.5 | -0.9
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
191 | DQ44 | AH13 | IO_L15N_T2L_N5_AD11N_66 | 66 | T2 | L | L15 | N | AG13 | L1+L5 | 2 | 72.65 | 4.88 | 67.77 | 0.0 | 431.8 | 172.88 | 174.618 | 604.7 | 606.4 | 605.6 | 170.0 | 3.7
194 | DQ41 | AF8 | IO_L18P_T2U_N10_AD2P_66 | 66 | T2 | U | L18 | P | AG8 | L1+L5 | 2 | 74.41 | 1.59 | 72.82 | 0.0 | 444.6 | 159.33 | 160.931 | 603.9 | 605.5 | 604.7 | 159.0 | 1.1
195 | DQ40 | AG8 | IO_L18N_T2U_N11_AD2N_66 | 66 | T2 | U | L18 | N | AF8 | L1+L5 | 2 | 73.62 | 2.33 | 71.29 | 0.0 | 439.4 | 166.037 | 167.706 | 605.4 | 607.1 | 606.2 | 165.9 | 0.9
198 | DQS5_C | AH9 | IO_L16N_T2U_N7_QBC_AD3N_66 | 66 | T2 | U | L16 | N | AG9 | L1+L5 | 2 | 73.9 | 3.93 | 69.97 | 0.0 | 439.9 | 165.403 | 167.065 | 605.4 | 607.0 | 606.2 | 167.0 | -0.8
199 | DM5_N/DBI5_N | AH12 | IO_L13P_T2L_N0_GC_QBC_66 | 66 | T2 | L | L13 | P | AJ12 | L1+L5 | 2 | 75.88 | 2.81 | 73.08 | 0.0 | 452.6 | 156.913 | 158.49 | 609.6 | 611.1 | 610.3 | 156.4 | 1.3
200 | DQS5_T | AG9 | IO_L16P_T2U_N6_QBC_AD3P_66 | 66 | T2 | U | L16 | P | AH9 | L1+L5 | 2 | 74.15 | 4.03 | 70.13 | 0.0 | 441.4 | 164.115 | 165.764 | 605.6 | 607.2 | 606.4 | 165.3 | -0.4
203 | DQ46 | AJ11 | IO_L14N_T2L_N3_GC_66 | 66 | T2 | L | L14 | N | AH11 | L1+L5 | 2 | 73.46 | 2.18 | 71.28 | 0.05 | 438.5 | 170.805 | 172.522 | 609.3 | 611.0 | 610.2 | 168.4 | 3.3
204 | DQ47 | AH11 | IO_L14P_T2L_N2_GC_66 | 66 | T2 | L | L14 | P | AJ11 | L1+L5 | 2 | 73.28 | 1.7 | 71.57 | 0.0 | 437.7 | 169.468 | 171.171 | 607.2 | 608.9 | 608.0 | 168.9 | 1.4
207 | DQ42 | AG10 | IO_L17N_T2U_N9_AD10N_66 | 66 | T2 | U | L17 | N | AG11 | L1+L5 | 2 | 75.79 | 2.5 | 73.29 | 0.0 | 452.3 | 154.371 | 155.922 | 606.6 | 608.2 | 607.4 | 155.8 | -0.6
208 | DQ43 | AG11 | IO_L17P_T2U_N8_AD10P_66 | 66 | T2 | U | L17 | P | AG10 | L1+L5 | 2 | 75.26 | 1.66 | 73.59 | 0.0 | 449.6 | 154.33 | 155.881 | 603.9 | 605.5 | 604.7 | 153.6 | 1.5
211 | DQ52 | AL12 | IO_L9N_T1L_N5_AD12N_66 | 66 | T1 | L | L9 | N | AK12 | L1+L7 | 2 | 71.86 | 2.58 | 69.29 | 0.0 | 428.7 | 163.386 | 165.028 | 592.1 | 593.7 | 592.9 | 163.9 | 0.3
212 | DQ53 | AK12 | IO_L9P_T1L_N4_AD12P_66 | 66 | T1 | L | L9 | P | AL12 | L1+L7 | 2 | 72.47 | 1.35 | 71.12 | 0.0 | 433.2 | 163.127 | 164.767 | 596.3 | 597.9 | 597.1 | 162.8 | 1.1
215 | DQ49 | AJ9 | IO_L12P_T1U_N10_GC_66 | 66 | T1 | U | L12 | P | AK9 | L1+L7 | 2 | 69.35 | 1.75 | 67.6 | 0.0 | 414.2 | 183.49 | 185.334 | 597.7 | 599.5 | 598.6 | 182.4 | 2.1
216 | DQ48 | AK9 | IO_L12N_T1U_N11_GC_66 | 66 | T1 | U | L12 | N | AJ9 | L1+L7 | 2 | 69.42 | 3.12 | 66.3 | 0.0 | 413.7 | 183.552 | 185.396 | 597.2 | 599.1 | 598.1 | 184.2 | 0.3
219 | DQS6_C | AL8 | IO_L10N_T1U_N7_QBC_AD4N_66 | 66 | T1 | U | L10 | N | AK8 | L1+L7 | 2 | 67.96 | 1.74 | 66.22 | 0.0 | 405.9 | 189.59 | 191.496 | 595.5 | 597.4 | 596.4 | 191.5 | -1.0
220 | DM6_N/DBI6_N | AK13 | IO_L7P_T1L_N0_QBC_AD13P_66 | 66 | T1 | L | L7 | P | AL13 | L1+L7 | 2 | 72.01 | 1.63 | 70.38 | 0.0 | 430.2 | 163.08 | 164.719 | 593.3 | 594.9 | 594.1 | 163.8 | 0.1
221 | DQS6_T | AK8 | IO_L10P_T1U_N6_QBC_AD4P_66 | 66 | T1 | U | L10 | P | AL8 | L1+L7 | 2 | 68.08 | 1.85 | 66.23 | 0.0 | 406.5 | 189.131 | 191.031 | 595.7 | 597.6 | 596.6 | 189.7 | 0.3
224 | DQ54 | AL10 | IO_L8N_T1L_N3_AD5N_66 | 66 | T1 | L | L8 | N | AL11 | L1+L7 | 2 | 70.21 | 2.39 | 67.82 | 0.0 | 418.9 | 179.274 | 181.076 | 598.2 | 600.0 | 599.1 | 180.0 | 0.2
225 | DQ55 | AL11 | IO_L8P_T1L_N2_AD5P_66 | 66 | T1 | L | L8 | P | AL10 | L1+L7 | 2 | 70.97 | 1.39 | 69.59 | 0.0 | 424.2 | 174.129 | 175.879 | 598.3 | 600.1 | 599.2 | 172.4 | 2.6
228 | DQ50 | AK10 | IO_L11N_T1U_N9_GC_66 | 66 | T1 | U | L11 | N | AJ10 | L1+L7 | 2 | 70.61 | 2.79 | 67.82 | 0.0 | 421.0 | 172.191 | 173.922 | 593.2 | 595.0 | 594.1 | 173.5 | -0.5
229 | DQ51 | AJ10 | IO_L11P_T1U_N8_GC_66 | 66 | T1 | U | L11 | P | AK10 | L1+L7 | 2 | 71.35 | 2.13 | 69.23 | 0.0 | 426.0 | 170.932 | 172.65 | 596.9 | 598.6 | 597.8 | 170.4 | 1.4
232 | DQ60 | AP11 | IO_L3N_T0L_N5_AD15N_66 | 66 | T0 | L | L3 | N | AN11 | L1+L3 | 2 | 85.47 | 3.36 | 82.11 | 0.0 | 509.6 | 180.959 | 182.778 | 690.6 | 692.4 | 691.5 | 181.8 | 0.1
233 | DQ61 | AN11 | IO_L3P_T0L_N4_AD15P_66 | 66 | T0 | L | L3 | P | AP11 | L1+L3 | 2 | 85.99 | 1.88 | 84.11 | 0.0 | 513.8 | 175.675 | 177.44 | 689.5 | 691.2 | 690.3 | 175.3 | 1.2
236 | DQ57 | AM9 | IO_L6P_T0U_N10_AD6P_66 | 66 | T0 | U | L6 | P | AM8 | L1+L3 | 2 | 84.48 | 1.74 | 82.74 | 0.0 | 504.8 | 189.548 | 191.453 | 694.4 | 696.3 | 695.3 | 190.2 | 0.3
237 | DQ56 | AM8 | IO_L6N_T0U_N11_AD6N_66 | 66 | T0 | U | L6 | N | AM9 | L1+L3 | 2 | 82.8 | 2.16 | 80.63 | 0.0 | 494.4 | 195.484 | 197.449 | 689.9 | 691.9 | 690.9 | 195.8 | 0.7
240 | DQS7_C | AN8 | IO_L4N_T0U_N7_DBC_AD7N_66 | 66 | T0 | U | L4 | N | AN9 | L1+L3 | 2 | 83.47 | 1.93 | 81.54 | 0.0 | 498.7 | 193.41 | 195.354 | 692.1 | 694.0 | 693.0 | 194.6 | -0.2
241 | DM7_N/DBI7_N | AN12 | IO_L1P_T0L_N0_DBC_66 | 66 | T0 | L | L1 | P | AP12 | L1+L3 | 2 | 85.91 | 1.28 | 84.64 | 0.0 | 513.8 | 176.82 | 178.597 | 690.6 | 692.4 | 691.5 | 177.4 | 0.3
242 | DQS7_T | AN9 | IO_L4P_T0U_N6_DBC_AD7P_66 | 66 | T0 | U | L4 | P | AN8 | L1+L3 | 2 | 83.71 | 1.91 | 81.8 | 0.0 | 500.1 | 192.537 | 194.472 | 692.6 | 694.6 | 693.6 | 192.9 | 0.6
245 | DQ62 | AP9 | IO_L2N_T0L_N3_66 | 66 | T0 | L | L2 | N | AP10 | L1+L3 | 2 | 84.15 | 2.62 | 81.53 | 0.0 | 502.3 | 189.881 | 191.789 | 692.1 | 694.0 | 693.1 | 190.2 | 0.7
246 | DQ63 | AP10 | IO_L2P_T0L_N2_66 | 66 | T0 | L | L2 | P | AP9 | L1+L3 | 2 | 84.36 | 2.69 | 81.66 | 0.0 | 503.4 | 186.811 | 188.689 | 690.2 | 692.1 | 691.2 | 188.0 | -0.2
249 | DQ58 | AM10 | IO_L5N_T0U_N9_AD14N_66 | 66 | T0 | U | L5 | N | AM11 | L1+L3 | 2 | 85.2 | 1.39 | 83.81 | 0.0 | 509.4 | 181.818 | 183.645 | 691.2 | 693.0 | 692.1 | 181.3 | 1.5
250 | DQ59 | AM11 | IO_L5P_T0U_N8_AD14P_66 | 66 | T0 | U | L5 | P | AM10 | L1+L3 | 2 | 86.73 | 1.73 | 85.0 | 0.0 | 518.3 | 177.241 | 179.022 | 695.6 | 697.3 | 696.5 | 176.6 | 1.6
