fingoldin/lpddr5-testbed/fab/3d/lpddr5-testbed.step

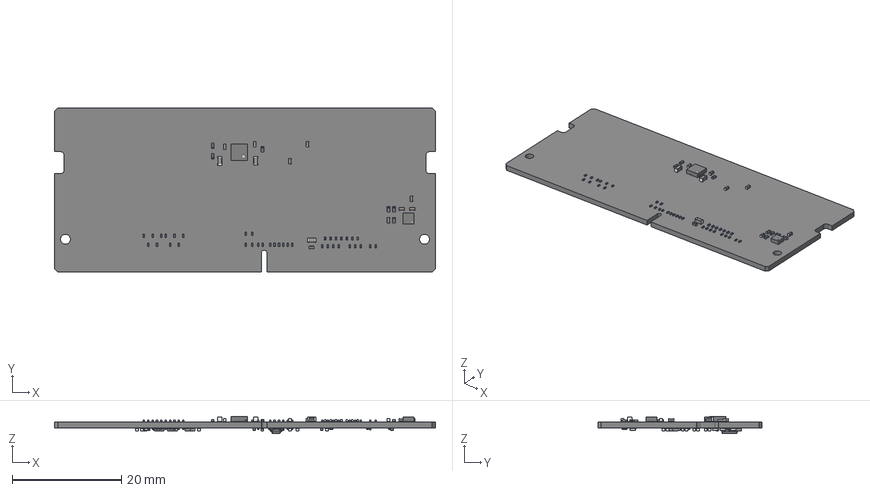
[picture p10: CAD file, 2026-11-12]
fab/3d/lpddr5-testbed.step
69.6 x 30.0 x 3.16 mm
C_0201_0603Metric x 8
C_0402_1005Metric x 37
C_0603_1608Metric x 3
R_0201_0603Metric x 53
R_0402_1005Metric x 13
VSON_10_1EP_3x3mm_Pitch05mm_ThermalPad
WSON_8_1EP_2x2mm_P05mm_EP09x16mm
TSOT_23_5
lpddr5-testbed_PCB
