fingoldin/lpddr5-testbed/references/dram/Acer_service_manual_memory_AVL_extract.txt

Acer Chromebook R756T/R756TN

 SERVICE GUIDE

Revision History
     Refer to the table below for the updates made to this service guide.

 Date           Version     Chapter              Updates

 01-07-2023     V 1.00      All (except CH2)

 03-22-2023     V 1.01      All                  Add CH2 and update SPL

 03-21-2023     V 1.02      CH3                  Update the Keyboard Removal section

 04-20-2023     V 1.03      CH3                  Update the Keyboard Removal section

     Service guide files and updates are available on the ACER/CSD Website. For more
     information, go to http://csd.acer.com.tw.The information in this guide is subject to
     change without notice.

Copyright
     Copyright © 2023 by Acer Incorporated. All rights reserved. No part of this publication
     may be reproduced, transmitted, transcribed, stored in a retrieval system, or translated
     into any language or computer language, in any form or by any means, electronic,
     mechanical, magnetic, optical, chemical, manual or otherwise, without the prior written
     permission of Acer Incorporated.

Disclaimer
     The information in this guide is subject to change without notice.
     There are no representations or warranties, either expressed or implied, with respect to
     the contents hereof and specifically disclaims any warranties of merchantability or
     fitness for any particular purpose. The software described in this manual is sold or
     licensed "as is". Should the programs prove defective following their purchase, the
     buyer (not the manufacturer, distributor, or its dealer) assumes the entire cost of all
     necessary servicing, repair, and any incidental or consequential damages resulting from
     any defect in the software.

ii

Conventions
    The following conventions are used in this manual:

!   WARNING:
               Indicates a potential for personal injury.

!   CAUTION:
              Indicates a potential loss of data or damage to equipment.

+ IMPORTANT:
                  Indicates information that is important to know for the proper
                  completion of a procedure, choice of an option, or completing a task.
    The following typographical conventions are used in this document:
       Book titles, directory names, file names, path names, and program/process names
         are shown in italics.
                  Example:

                      the DRS5 User's Guide
                      /usr/local/bin/fd
                      the /TPH15spool_M program
       Computer output (text that represents information displayed on a computer
         screen, such as menus, prompts, responses to input, and error messages) are
         shown in constant width.
                  Example:

                     [01] The server has been stopped
       User input (text that represents information entered by a computer user, such as
         command names, option letters, and words) are shown in constant width bold.
                  Variables contained within user input are shown in angle brackets (< >).

                  Example:

                      At the prompt, type run <file name> -m
       Keyboard keys are shown in bold italics.

                  Example:

                      After entering data, press Enter.

                                                                                          iii

General Information                                                                                0

     This service guide provides all technical information relating to the basic configuration
     for Acer’s global product offering. To better fit local market requirements and enhance
     product competitiveness, the regional office may have decided to extend the
     functionality of a machine (such as add-on cards, modems, or extra memory capabilities).
     These localized features are not covered in this generic service guide. In such cases,
     contact the regional offices or the responsible personnel/channel to provide further
     technical details.
     When ordering FRU parts: Check the most up-to-date information available on the
     Website. If, for whatever reason, a part number change is made, it may not be noted in
     this printed service guide.
     Acer-authorized Service Providers: The Acer office may have a different part number
     code than those given in the FRU list in this service guide. A list must be provided by the
     regional Acer office to order FRU parts for repair and service of customer machines.

iv

CHAPTER 1
Hardware Specifications

       Features . . . . . . . . . . . . . . . . . . . . . . . . . . . . . . . . . . . . . . . . . . . . 1-4
          Operating System . . . . . . . . . . . . . . . . . . . . . . . . . . . . . . . . . . 1-4
          CPU and Chipset . . . . . . . . . . . . . . . . . . . . . . . . . . . . . . . . . . . 1-4
          System Memory . . . . . . . . . . . . . . . . . . . . . . . . . . . . . . . . . . . 1-4
          Display. . . . . . . . . . . . . . . . . . . . . . . . . . . . . . . . . . . . . . . . . . . 1-5
          Audio. . . . . . . . . . . . . . . . . . . . . . . . . . . . . . . . . . . . . . . . . . . . 1-5
          Graphics . . . . . . . . . . . . . . . . . . . . . . . . . . . . . . . . . . . . . . . . . 1-5
          Storage . . . . . . . . . . . . . . . . . . . . . . . . . . . . . . . . . . . . . . . . . . 1-6
          Webcam . . . . . . . . . . . . . . . . . . . . . . . . . . . . . . . . . . . . . . . . . 1-6
          Wireless and Networking. . . . . . . . . . . . . . . . . . . . . . . . . . . . 1-7
          Dimension and Weight . . . . . . . . . . . . . . . . . . . . . . . . . . . . . 1-7
          Power Adapter and Battery. . . . . . . . . . . . . . . . . . . . . . . . . . 1-7
          Input and Control. . . . . . . . . . . . . . . . . . . . . . . . . . . . . . . . . . 1-7
          Input and Output (I/O) Ports . . . . . . . . . . . . . . . . . . . . . . . . . 1-8
          Sensors . . . . . . . . . . . . . . . . . . . . . . . . . . . . . . . . . . . . . . . . . . 1-8
          Warranty . . . . . . . . . . . . . . . . . . . . . . . . . . . . . . . . . . . . . . . . . 1-8
          Privacy Control . . . . . . . . . . . . . . . . . . . . . . . . . . . . . . . . . . . . 1-8
          Environment . . . . . . . . . . . . . . . . . . . . . . . . . . . . . . . . . . . . . . 1-8
       Notebook Tour. . . . . . . . . . . . . . . . . . . . . . . . . . . . . . . . . . . . . . . 1-9
          TouchPad Basics . . . . . . . . . . . . . . . . . . . . . . . . . . . . . . . . . . . 1-15
          Using the Keyboard . . . . . . . . . . . . . . . . . . . . . . . . . . . . . . . . 1-17
          System Block Diagram . . . . . . . . . . . . . . . . . . . . . . . . . . . . . . 1-19
       Specification Tables . . . . . . . . . . . . . . . . . . . . . . . . . . . . . . . . . . . 1-20
          Computer specifications. . . . . . . . . . . . . . . . . . . . . . . . . . . . . 1-20
          System Board Major Chips . . . . . . . . . . . . . . . . . . . . . . . . . . . 1-21
          Processor . . . . . . . . . . . . . . . . . . . . . . . . . . . . . . . . . . . . . . . . . 1-21
          Processor Specifications . . . . . . . . . . . . . . . . . . . . . . . . . . . . . 1-22
          CPU Fan True Value Table (N/A) . . . . . . . . . . . . . . . . . . . . . . 1-22
          System Memory . . . . . . . . . . . . . . . . . . . . . . . . . . . . . . . . . . . 1-22
          Keyboard. . . . . . . . . . . . . . . . . . . . . . . . . . . . . . . . . . . . . . . . . 1-23
          USB Port . . . . . . . . . . . . . . . . . . . . . . . . . . . . . . . . . . . . . . . . . 1-23
          USB Type-C Port . . . . . . . . . . . . . . . . . . . . . . . . . . . . . . . . . . . 1-23
          HDMI Port (N/A) . . . . . . . . . . . . . . . . . . . . . . . . . . . . . . . . . . . 1-24
          Video Interface (N/A) . . . . . . . . . . . . . . . . . . . . . . . . . . . . . . . 1-24
          Battery. . . . . . . . . . . . . . . . . . . . . . . . . . . . . . . . . . . . . . . . . . . 1-24
          AC Adapter . . . . . . . . . . . . . . . . . . . . . . . . . . . . . . . . . . . . . . . 1-25
          Card Reader . . . . . . . . . . . . . . . . . . . . . . . . . . . . . . . . . . . . . . 1-26
          Hard Disk Drive (N/A) . . . . . . . . . . . . . . . . . . . . . . . . . . . . . . . 1-27
          Solid State Drive (N/A) . . . . . . . . . . . . . . . . . . . . . . . . . . . . . . 1-27
          Embedded MultiMedia Card (eMMC) . . . . . . . . . . . . . . . . . . 1-28
          LCD 11.6” . . . . . . . . . . . . . . . . . . . . . . . . . . . . . . . . . . . . . . . . 1-29
          LCD Inverter (N/A) . . . . . . . . . . . . . . . . . . . . . . . . . . . . . . . . . 1-31

                                                                                                              v

           Graphics Controller . . . . . . . . . . . . . . . . . . . . . . . . . . . . . . . . 1-31
           Display Supported Resolution (LCD Supported
           Resolution) . . . . . . . . . . . . . . . . . . . . . . . . . . . . . . . . . . . . . . . 1-31
           LAN Interface (N/A) . . . . . . . . . . . . . . . . . . . . . . . . . . . . . . . . 1-31
           Wireless + Bluetooth Module . . . . . . . . . . . . . . . . . . . . . . . . 1-32
           Audio Interface. . . . . . . . . . . . . . . . . . . . . . . . . . . . . . . . . . . . 1-32
           Audio Codec and Amplifier . . . . . . . . . . . . . . . . . . . . . . . . . 1-32
           HD Camera . . . . . . . . . . . . . . . . . . . . . . . . . . . . . . . . . . . . . . . 1-33
           5M Camera . . . . . . . . . . . . . . . . . . . . . . . . . . . . . . . . . . . . . . . 1-33
           4G Module . . . . . . . . . . . . . . . . . . . . . . . . . . . . . . . . . . . . . . . 1-34
           VRAM (N/A). . . . . . . . . . . . . . . . . . . . . . . . . . . . . . . . . . . . . . . 1-34
           System Power Management . . . . . . . . . . . . . . . . . . . . . . . . . 1-34
           System LED Indicator . . . . . . . . . . . . . . . . . . . . . . . . . . . . . . . 1-35
           System DMA Specification (N/A) . . . . . . . . . . . . . . . . . . . . . . 1-35
           System Interrupt Specification (N/A) . . . . . . . . . . . . . . . . . . . 1-35
           System I/O Address Map (N/A) . . . . . . . . . . . . . . . . . . . . . . . . 1-35
           Memory Address Map (N/A) . . . . . . . . . . . . . . . . . . . . . . . . . 1-35

CHAPTER 2
System Utilities

       Introduction . . . . . . . . . . . . . . . . . . . . . . . . . . . . . . . . . . . . . . . . . 2-3
       Key Component Replacement and HWID Re-configuration . . . 2-3
           Creating RMA Shim Using “Chromebook Recovery Utility” in
           Windows System/Chromebook . . . . . . . . . . . . . . . . . . . . . . . 2-5
           Install RMA Shim Process by RSU. . . . . . . . . . . . . . . . . . . . . . 2-10
           Run RMA Shim Process. . . . . . . . . . . . . . . . . . . . . . . . . . . . . . 2-17
           Start the RMA Main Test . . . . . . . . . . . . . . . . . . . . . . . . . . . . 2-18
           Start the RMA FFT Test. . . . . . . . . . . . . . . . . . . . . . . . . . . . . . 2-20

CHAPTER 3
Machine Maintenance Procedures

       Introduction . . . . . . . . . . . . . . . . . . . . . . . . . . . . . . . . . . . . . . . . . 3-4
       General Information . . . . . . . . . . . . . . . . . . . . . . . . . . . . . . . . . . 3-4
       Recommended Equipment . . . . . . . . . . . . . . . . . . . . . . . . . . . . . 3-4
       Pre-disassembly Instructions . . . . . . . . . . . . . . . . . . . . . . . . . . . . 3-5
       Disassembly Process . . . . . . . . . . . . . . . . . . . . . . . . . . . . . . . . . . . 3-6
       Main Unit Disassembly Process . . . . . . . . . . . . . . . . . . . . . . . . . . 3-7
           Main Unit Disassembly Flowchart . . . . . . . . . . . . . . . . . . . . . 3-7
           Base Cover Removal . . . . . . . . . . . . . . . . . . . . . . . . . . . . . . . . 3-8
           Battery Pack Removal. . . . . . . . . . . . . . . . . . . . . . . . . . . . . . . 3-10
           Touchpad Module Removal. . . . . . . . . . . . . . . . . . . . . . . . . . 3-12

vi

   Keyboard Removal . . . . . . . . . . . . . . . . . . . . . . . . . . . . . . . . . 3-15
   Speaker Module Removal . . . . . . . . . . . . . . . . . . . . . . . . . . . 3-18
   USB Board Removal . . . . . . . . . . . . . . . . . . . . . . . . . . . . . . . . 3-20
   LED Board Removal . . . . . . . . . . . . . . . . . . . . . . . . . . . . . . . . 3-24
   Microphone Board Removal . . . . . . . . . . . . . . . . . . . . . . . . . 3-26
   LCD Module Removal. . . . . . . . . . . . . . . . . . . . . . . . . . . . . . . 3-28
   Mainboard Removal. . . . . . . . . . . . . . . . . . . . . . . . . . . . . . . . 3-32
   Top Camera Module Removal . . . . . . . . . . . . . . . . . . . . . . . . 3-37
   Top Assembly Removal . . . . . . . . . . . . . . . . . . . . . . . . . . . . . 3-39
LCD Module Disassembly Process . . . . . . . . . . . . . . . . . . . . . . . . 3-40
   LCD Module Disassembly Flowchart . . . . . . . . . . . . . . . . . . . 3-40
   LCD Panel Removal. . . . . . . . . . . . . . . . . . . . . . . . . . . . . . . . . 3-41
   LCD Hinges Removal . . . . . . . . . . . . . . . . . . . . . . . . . . . . . . . 3-44
   Camera Module Removal. . . . . . . . . . . . . . . . . . . . . . . . . . . . 3-46
   G-Sensor Board Removal . . . . . . . . . . . . . . . . . . . . . . . . . . . . 3-49
   eDP Cable Removal . . . . . . . . . . . . . . . . . . . . . . . . . . . . . . . . 3-51
   WLAN Antenna Removal . . . . . . . . . . . . . . . . . . . . . . . . . . . . 3-55
LCD Module Reassembly Process . . . . . . . . . . . . . . . . . . . . . . . . 3-57
   Replacing the WLAN Antenna. . . . . . . . . . . . . . . . . . . . . . . . 3-57
   Replacing the eDP Cable . . . . . . . . . . . . . . . . . . . . . . . . . . . . 3-59
   Replacing the G-Sensor Board . . . . . . . . . . . . . . . . . . . . . . . . 3-63
   Replacing the Camera Module . . . . . . . . . . . . . . . . . . . . . . . 3-64
   Replacing the LCD Hinges . . . . . . . . . . . . . . . . . . . . . . . . . . . 3-66
   Replacing the LCD Panel . . . . . . . . . . . . . . . . . . . . . . . . . . . . 3-68
Main Unit Reassembly Process . . . . . . . . . . . . . . . . . . . . . . . . . . 3-70
   Replacing the Top Assembly . . . . . . . . . . . . . . . . . . . . . . . . . 3-70
   Replacing the Top Camera Module. . . . . . . . . . . . . . . . . . . . 3-71
   Replacing the Mainboard . . . . . . . . . . . . . . . . . . . . . . . . . . . 3-73
   Replacing the LCD Module . . . . . . . . . . . . . . . . . . . . . . . . . . 3-77
   Replacing the Microphone Board . . . . . . . . . . . . . . . . . . . . . 3-80
   Replacing the LED Board . . . . . . . . . . . . . . . . . . . . . . . . . . . . 3-82
   Replacing the USB Board . . . . . . . . . . . . . . . . . . . . . . . . . . . . 3-84
   Replacing the Speaker Module . . . . . . . . . . . . . . . . . . . . . . . 3-88
   Replacing the Keyboard. . . . . . . . . . . . . . . . . . . . . . . . . . . . . 3-90
   Replacing the Touchpad Module . . . . . . . . . . . . . . . . . . . . . 3-92
   Replacing the Battery Pack . . . . . . . . . . . . . . . . . . . . . . . . . . 3-95
   Replacing the Base Cover. . . . . . . . . . . . . . . . . . . . . . . . . . . . 3-97

                                                                                         vii

CHAPTER 4
Troubleshooting

       Introduction . . . . . . . . . . . . . . . . . . . . . . . . . . . . . . . . . . . . . . . . . 4-3
       General Information . . . . . . . . . . . . . . . . . . . . . . . . . . . . . . . . . . 4-3
           Power On Issues . . . . . . . . . . . . . . . . . . . . . . . . . . . . . . . . . . . 4-4
           No Display Issues. . . . . . . . . . . . . . . . . . . . . . . . . . . . . . . . . . . 4-5
           LCD Picture Failure . . . . . . . . . . . . . . . . . . . . . . . . . . . . . . . . . 4-7
           Internal Keyboard Failure . . . . . . . . . . . . . . . . . . . . . . . . . . . 4-8
           Touch Pad Failure . . . . . . . . . . . . . . . . . . . . . . . . . . . . . . . . . . 4-9
           Internal Speaker Failure. . . . . . . . . . . . . . . . . . . . . . . . . . . . . 4-10
           Audio Codec Failure . . . . . . . . . . . . . . . . . . . . . . . . . . . . . . . . 4-12
           Other Functions Failure . . . . . . . . . . . . . . . . . . . . . . . . . . . . . 4-13
       Intermittent Problems . . . . . . . . . . . . . . . . . . . . . . . . . . . . . . . . . 4-14
       Undetermined Problems . . . . . . . . . . . . . . . . . . . . . . . . . . . . . . . 4-14

CHAPTER 5
Jumper and Connector Locations

       Mainboard Jumper and Connector Locations . . . . . . . . . . . . . . 5-3

CHAPTER 6
FRU (Field Replaceable Unit) List

       Exploded Diagrams . . . . . . . . . . . . . . . . . . . . . . . . . . . . . . . . . . . 6-4
       FRU List . . . . . . . . . . . . . . . . . . . . . . . . . . . . . . . . . . . . . . . . . . . . . 6-8
       Screw List . . . . . . . . . . . . . . . . . . . . . . . . . . . . . . . . . . . . . . . . . . . 6-17

CHAPTER 7
Model Definition and Configuration

       Acer Chromebook R756T. . . . . . . . . . . . . . . . . . . . . . . . . . . . . . . 7-3
       Acer Chromebook R756TN . . . . . . . . . . . . . . . . . . . . . . . . . . . . . 7-9

CHAPTER 8
Test Compatible Components

       Chrome OS Environment Test . . . . . . . . . . . . . . . . . . . . . . . . . . . 8-4

viii

CHAPTER 9
Online Support Information

       Introduction . . . . . . . . . . . . . . . . . . . . . . . . . . . . . . . . . . . . . . . . . 9-3

                                                                                                            ix

     CHAPTER 1
Hardware Specifications

Features . . . . . . . . . . . . . . . . . . . . . . . . . . . . . . . . . . . . . . . . . . . . 1-4
   Operating System . . . . . . . . . . . . . . . . . . . . . . . . . . . . . . . . . . .1-4
   CPU and Chipset . . . . . . . . . . . . . . . . . . . . . . . . . . . . . . . . . . . .1-4
   System Memory . . . . . . . . . . . . . . . . . . . . . . . . . . . . . . . . . . . .1-4
   Display. . . . . . . . . . . . . . . . . . . . . . . . . . . . . . . . . . . . . . . . . . . .1-5
   Audio. . . . . . . . . . . . . . . . . . . . . . . . . . . . . . . . . . . . . . . . . . . . .1-5
   Graphics . . . . . . . . . . . . . . . . . . . . . . . . . . . . . . . . . . . . . . . . . .1-5
   Storage . . . . . . . . . . . . . . . . . . . . . . . . . . . . . . . . . . . . . . . . . . .1-6
   Webcam . . . . . . . . . . . . . . . . . . . . . . . . . . . . . . . . . . . . . . . . . .1-6
   Wireless and Networking. . . . . . . . . . . . . . . . . . . . . . . . . . . . .1-7
   Dimension and Weight . . . . . . . . . . . . . . . . . . . . . . . . . . . . . .1-7
   Power Adapter and Battery. . . . . . . . . . . . . . . . . . . . . . . . . . .1-7
   Input and Control. . . . . . . . . . . . . . . . . . . . . . . . . . . . . . . . . . .1-7
   Input and Output (I/O) Ports . . . . . . . . . . . . . . . . . . . . . . . . . .1-8
   Sensors . . . . . . . . . . . . . . . . . . . . . . . . . . . . . . . . . . . . . . . . . . .1-8
   Warranty . . . . . . . . . . . . . . . . . . . . . . . . . . . . . . . . . . . . . . . . . .1-8
   Privacy Control . . . . . . . . . . . . . . . . . . . . . . . . . . . . . . . . . . . . .1-8
   Environment . . . . . . . . . . . . . . . . . . . . . . . . . . . . . . . . . . . . . . .1-8
Notebook Tour. . . . . . . . . . . . . . . . . . . . . . . . . . . . . . . . . . . . . . . 1-9
   TouchPad Basics . . . . . . . . . . . . . . . . . . . . . . . . . . . . . . . . . . . .1-15
   Using the Keyboard . . . . . . . . . . . . . . . . . . . . . . . . . . . . . . . . .1-17
   System Block Diagram . . . . . . . . . . . . . . . . . . . . . . . . . . . . . . .1-19
Specification Tables . . . . . . . . . . . . . . . . . . . . . . . . . . . . . . . . . . . 1-20
   Computer specifications. . . . . . . . . . . . . . . . . . . . . . . . . . . . . .1-20
   System Board Major Chips . . . . . . . . . . . . . . . . . . . . . . . . . . . .1-21
   Processor . . . . . . . . . . . . . . . . . . . . . . . . . . . . . . . . . . . . . . . . . .1-21
   Processor Specifications . . . . . . . . . . . . . . . . . . . . . . . . . . . . . .1-22
   CPU Fan True Value Table (N/A) . . . . . . . . . . . . . . . . . . . . . . .1-22
   System Memory . . . . . . . . . . . . . . . . . . . . . . . . . . . . . . . . . . . .1-22
   Keyboard. . . . . . . . . . . . . . . . . . . . . . . . . . . . . . . . . . . . . . . . . .1-23
   USB Port . . . . . . . . . . . . . . . . . . . . . . . . . . . . . . . . . . . . . . . . . .1-23
   USB Type-C Port . . . . . . . . . . . . . . . . . . . . . . . . . . . . . . . . . . . .1-23
   HDMI Port (N/A) . . . . . . . . . . . . . . . . . . . . . . . . . . . . . . . . . . . .1-24
   Video Interface (N/A) . . . . . . . . . . . . . . . . . . . . . . . . . . . . . . . .1-24
   Battery. . . . . . . . . . . . . . . . . . . . . . . . . . . . . . . . . . . . . . . . . . . .1-24
   AC Adapter . . . . . . . . . . . . . . . . . . . . . . . . . . . . . . . . . . . . . . . .1-25
   Card Reader . . . . . . . . . . . . . . . . . . . . . . . . . . . . . . . . . . . . . . .1-26
   Hard Disk Drive (N/A) . . . . . . . . . . . . . . . . . . . . . . . . . . . . . . . .1-27
   Solid State Drive (N/A) . . . . . . . . . . . . . . . . . . . . . . . . . . . . . . .1-27
   Embedded MultiMedia Card (eMMC) . . . . . . . . . . . . . . . . . . .1-28
   LCD 11.6” . . . . . . . . . . . . . . . . . . . . . . . . . . . . . . . . . . . . . . . . .1-29
   LCD Inverter (N/A) . . . . . . . . . . . . . . . . . . . . . . . . . . . . . . . . . .1-31
   Graphics Controller . . . . . . . . . . . . . . . . . . . . . . . . . . . . . . . . .1-31
   Display Supported Resolution (LCD Supported
   Resolution) . . . . . . . . . . . . . . . . . . . . . . . . . . . . . . . . . . . . . . . .1-31
   LAN Interface (N/A) . . . . . . . . . . . . . . . . . . . . . . . . . . . . . . . . .1-31

                                                                                                  1-2

      Wireless + Bluetooth Module . . . . . . . . . . . . . . . . . . . . . . . . .1-32
      Audio Interface. . . . . . . . . . . . . . . . . . . . . . . . . . . . . . . . . . . . .1-32
      Audio Codec and Amplifier . . . . . . . . . . . . . . . . . . . . . . . . . .1-32
      HD Camera . . . . . . . . . . . . . . . . . . . . . . . . . . . . . . . . . . . . . . . .1-33
      5M Camera . . . . . . . . . . . . . . . . . . . . . . . . . . . . . . . . . . . . . . . .1-33
      4G Module . . . . . . . . . . . . . . . . . . . . . . . . . . . . . . . . . . . . . . . .1-34
      VRAM (N/A). . . . . . . . . . . . . . . . . . . . . . . . . . . . . . . . . . . . . . . .1-34
      System Power Management . . . . . . . . . . . . . . . . . . . . . . . . . .1-34
      System LED Indicator . . . . . . . . . . . . . . . . . . . . . . . . . . . . . . . .1-35
      System DMA Specification (N/A) . . . . . . . . . . . . . . . . . . . . . . .1-35
      System Interrupt Specification (N/A) . . . . . . . . . . . . . . . . . . . .1-35
      System I/O Address Map (N/A) . . . . . . . . . . . . . . . . . . . . . . . . .1-35
      Memory Address Map (N/A) . . . . . . . . . . . . . . . . . . . . . . . . . .1-35

1-3

Hardware Specifications and Configurations

Features                                                                              0

    Below is a summary of the computer’s features:

  Operating System                                                                    0

       Chrome OS

       Chrome OS with Chrome Education Upgrade

  CPU and Chipset                                                                     0

                 ®
       Intel  Processor N200 (6 MB Smart Cache, 1.0 GHz with Intel® Turbo Boost
          Technology 2.0 up to 3.7 GHz)
       Intel® Processor N100 (6 MB Smart Cache, 0.8 MHz with Intel® Turbo Boost
          Technology 2.0 up to 3.4 GHz)

  System Memory                                                                       0

    Single-channel LPDDR5 SDRAM supports:
       8 GB of onboard LPDDR5 system memory

    Single-channel LPDDR5 SDRAM supports:
       4 GB of onboard LPDDR5 system memory

    Memory Frequency: Up to 4266 MT/s

Hardware Specifications and Configurations                                          1-4

  Display                                                                                     0

      R756T
        11.6" display with IPS (In-Plane Switching) technology, HD 1366 x 768 resolution,
          high-brightness, LED-backlit TFT LCD with integrated multi-touch/Antibacterial
          cover glass
              Wide viewing angle

              16:9 aspect ratio

              Mercury free, environment friendly
                                        ®
              Antimicrobial Corning       Gorilla® Glass
      R756TN
        11.6" display with IPS (In-Plane Switching) technology, HD 1366 x 768,
          high-brightness, LED-backlit TFT LCD with integrated multi-touch, supporting USI
          pen solution
              Wide viewing angle

              16:9 aspect ratio

              Mercury free, environment friendly

              Anti-microbial

              Antimicrobial Corning® Gorilla® Glass

  Audio                                                                                       0

        Two built-in stereo speakers

        Two built-in microphones

        Google Assistant™ Lab Certification (ART)

  Graphics                                                                                    0

        Intel® UHD Graphics
          Graphics Special Technology#
              OpenGL & OpenGL ES

              AVC, HEVC,VP9, AV1, VP8 HW Accelerated Video Decode

              AVC, VP9 HW Accelerated Video Encode

              JPEG HW Accelerated Imaging Decode

1-5                                                  Hardware Specifications and Configurations

  Storage                                                                                   0

       32 / 64GB eMMC

       128 GB eMMC

       Card reader: Micro SD / Micro SDHC / Micro SDXC card reader

       Specifications:

                Type                            Model                         Test Result

                           Transcend Micro SD 2G + Transcend Adapter             Pass

             Micro SD      Silicon Power Micro SD 2G                             Pass

                           Ridata Micro SD 2G + RiDATA Adapter                   Pass

                           Kingston 16G UHS-I Class10 U1 & Kingston Adapter      Pass

                           ADATA Micro SDHC 32G C10                              Pass

                           Transcend Micro SDHC 4G C6 + Transcend Adapter        Pass
           Micro SDHC
                           SanDisk Ultra Micro SDHC 32G C10 I + Sandisk
                                                                                 Pass
                           Adapter

                           SAMSUNG 32GB USH-I Class10 EVO                        Pass

                           Kingston Micro SDXC 64G C10 + Kingston Adapter        Pass

                           SanDisk Micro SDXC Ultra 64GB Class4 15MB/s 100x      Pass

           Micro SDXC      ADATA Micro SDXC 64G U1 I Class10                     Pass

                           Toshiba 128GB U3 C10 A1 V30 & Sandisk Adapter         Pass

                           SAMSUNG 64GB USH-I Class10 EVO                        Pass

  Webcam                                                                                    0

    UFC with:
       USB 6 mm HD camera

       Compatible with Chromebook only

       1280 x 720 resolution

       720p HD video at 30 fps with Temporal Noise Reduction

       Support ROI (region of interest) feature

       Blue Glass lens

       Dual Mic (33 mm + 33 mm)

       78 x 6.1 x 3 mm

    5MAF MIPI webcam with:
       2560 x 1920 resolution

       1080p Full HD video recording

Hardware Specifications and Configurations                                              1-6

  Wireless and Networking                                                                         0

      WLAN:
                   ®
         Intel       Wireless Wi-Fi 6E AX211
         802.11 a/b/g/n/ac/ax wireless LAN

         Band: 2.4 GHz, 5 GHz and 6 GHz

         2x2 MU-MIMO technology

         Support Bluetooth® 5.2 and later

         Support CNVi interface

  Dimension and Weight                                                                            0

      Dimensions:
         296 (W) x 208.3 (D) x 21.1 (H) mm (11.65 x 8.2 x 0.83 inches)

      Weight:
         1.35 kg (2.98 lbs.) with 3-cell battery pack

  Power Adapter and Battery                                                                       0

      Power adapter
         USB Type-C 45 W Google PD AC adapter

              95 (W) x 40 (D) x 26.5 (H) mm (3.74 x 1.57 x 1.04 inches)

              5 V / 3 A or 9 V / 3 A or 12 V / 3 A or 15 V / 3 A or 20 V / 2.25 A as output power

              200 g with 150 cm DC cable

      Battery
         50 Wh 3-cell Li-ion battery

         Battery life up to 12 hours

  Input and Control                                                                               0

      Keyboard
         74-/75-/78-key ChromeOS FineTip EDU anchored frame Service 2.0 keyboard with
           international language support

      TouchPad
         Fully clickable touchpad featuring click-anywhere functionality: One-finger touch
           to left-click, two-finger touch to right-click, and two-finger scrolling
         Moisture resistant

         OceanGlass™ Touchpad

1-7                                                Hardware Specifications and Configurations

  Input and Output (I/O) Ports                                                         0

       Two USB Type-C™ ports. These ports support:

           USB 3.2 Gen 1 (up to 5 Gbps)

           DisplayPort over USB-C

           USB charging 5/9/15/20 V; 3 A

           DC-in port 20 V; 45 W

       Two USB 3.2 Gen 1 Type-A ports

       microSD™ card reader

       3.5 mm headphone/speaker jack, supporting headsets with built-in microphone

  Sensors                                                                              0

       Accelerometer (G-sensor)

       Gyroscope

  Warranty                                                                             0

       One-year International Travelers Warranty (ITW)

  Privacy Control                                                                      0

       Discrete H1 Trusted Platform Module (TPM) solution for Chromebook

       Kensington lock

  Environment                                                                          0

       Temperature:

           Operating: 0°C to 40°C

           Non-operating: -20°C to 60°C

       Humidity (non-condensing):

           Operating: 80% (at 40°C)

           Non-operating: 20% to 90%

Hardware Specifications and Configurations                                         1-8

Notebook Tour                                                                                     0

                                              1     2    1

                   3

                   2

                   1                                                                  1

                   4

                   5

             Figure 1-1.      Opened Front View

      Table 1-1.       Opened Front View

 #         Icon                 Item                             Description
 1                      Microphones          Internal microphones for sound recording.
 2                      Integrated webcams   Web camera for video communication.
                                             Also called Liquid-Crystal Display (LCD), displays
                                             computer output (configuration may vary by
 3                      Display screen
                                             model), and supports multi-touch functionality
                                             (for touchscreen model only).
 4                      Keyboard             For entering data into your computer.
                                             Touch-sensitive pointing device which functions
 5                      TouchPad
                                             like a computer mouse.

1-9                                                Hardware Specifications and Configurations

                                                   1      2    3    4

            Figure 1-2.   Right View

     Table 1-2.   Right View

 #         Icon                 Item                          Description
 1                    Volume button          Adjusts the sound volume.
                      USB 3.2 Gen 1 Type-A   Connects to USB devices (e.g., USB mouse,
 2
                      port                   USB camera).
                                              Connects a USB Type-C™ AC adapter to
                                               supply power to the system (20 V; 45 W).
                                              Connects to USB devices with a USB
                                               Type-C connector.
                                              Supports:

                                                USB 3.2 Gen 1 (up to 5 Gbps)
 3           /        USB Type-C™ port
                                                DisplayPort over USB-C

                                                USB charging 5/9/15/20 V; 3 A

                                                NOTE:
                                                USB Type-C™ port can only be used with
                                                products compliant with the USB
                                                Type-C™ cable and connector.
                                             Connects to a Kensington-compatible
                      Kensington lock slot   computer security lock.
                                                NOTE:
                                                Wrap the computer security lock cable
 4                                              around an immovable object such as a
                                                table or handle of a locked drawer.
                                                Insert the lock into the notch and turn
                                                the key to secure the lock. Some keyless
                                                models are also available.

Hardware Specifications and Configurations                                           1-10

                       1      2     3    4 5 6

            Figure 1-3.    Left View

     Table 1-3.   Left View

 #         Icon                   Item                           Description
                                                  Connects a USB Type-C™ AC adapter to
                                                   supply power to the system (20 V; 45 W).
                                                  Connects to USB devices with a USB
                                                   Type-C connector.
                                                  Supports:

                                                    USB 3.2 Gen 1 (up to 5 Gbps)
 1           /        USB Type-C™ port
                                                    DisplayPort over USB-C

                                                    USB charging 5/9/15/20 V; 3 A

                                                    NOTE:
                                                    USB Type-C™ port can only be used with
                                                    products compliant with the USB
                                                    Type-C™ cable and connector.
                      USB 3.2 Gen 1 Type-A       Connects to USB devices (e.g., USB mouse,
 2
                      port                       USB camera).
                                                 Accepts microSD cards.

 3                    MicroSD card slot             NOTE:
                                                    Push to remove/install the card. Only
                                                    one card can operate at any given time.
                                                 Connects to audio line-out devices and
                      Headphone/
 4                                               accepts input from external microphone
                      Microphone jack
                                                 (3.5 mm Standard TRRS / OMTP TRRS Type).

 5                    Power button               Turns the computer on and off.

1-11                                             Hardware Specifications and Configurations

     Table 1-3.   Left View

 #         Icon                 Item                             Description
                                                Indicates the computer's battery status.
                                                  Battery charging: Solid Amber

                                                  Fully charged: Solid Blue

                                                  Discharge in S3: Blinking Amber (1 sec.
                                                   on, 3 sec. off)
 6                    Battery indicator           Discharge in S5: Off

                                                  Error: Blinking Amber (1 sec. on, 1 sec.
                                                   off)
                                                  Discharge in S0: Solid Blue

                                                  Factory mode: Blinking (Blue 2 sec. on,
                                                   Amber 2 sec. on)

     NOTE:        NOTE:
           When plugging a microphone or combined headset into the audio combo jack,
           make sure the required connector type is correct or the microphone will not work.
                               Audio Connector Plug Configurations

 TRS Type (Headphone only)             Standard TRRS Type             OMTP TRRS Type
                                   (Headphone/Mic Combo)          (Headphone/Mic Combo)

                                 Support audio/headphone
Support audio/headphone                                         Support audio/headphone
                                 output and microphone
output only                                                     output only
                                 input

            Figure 1-4.   Audio Connector Plug Configurations

Hardware Specifications and Configurations                                                1-12

       Figure 1-5.   Top View

1-13                            Hardware Specifications and Configurations

          1                                                                          1

          2                                                                          2

                                               1

              Figure 1-6.   Base View

     Table 1-4.   Base View

 #        Icon                  Item                           Description
                                             Use to drain out the liquid from your
 1                   Drain holes
                                             computer.
 2                   Speakers                Emits audio from your computer.

Hardware Specifications and Configurations                                               1-14

  TouchPad Basics                                              0

                  1

                                      2                           3

            Figure 1-7.    TouchPad

         Move your finger across the TouchPad (1) to move the cursor.

         Press the left (2) and right (3) button areas located beneath the TouchPad to
           perform selection and execution functions. These two button areas are the
           equivalent of the left and right buttons on a mouse.

   Function               Main TouchPad (1)         Left Button Area (2) Right Button Area (3)
                  Tap twice (at the same speed
Execute           as double-clicking a mouse        Quickly click twice.
                  button).
Select            Tap once with one finger.         Click once.
                  Tap twice (at the same speed
                                                    Click and hold,
                  as double-clicking a mouse
                                                    then use finger on
Drag              button); rest your finger on
                                                    the TouchPad to
                  the TouchPad on the second
                                                    drag the cursor.
                  tap and drag the cursor.
                  Place two fingers on the
                  TouchPad and move them
Scroll            up and down to scroll
                  vertically or left and right to
                  scroll horizontally.
Access
                  Tap once with two fingers.                               Click once.
context menu

1-15                                                Hardware Specifications and Configurations

    NOTE:     NOTE:
         When using the TouchPad, keep it - and fingers - dry and clean. The TouchPad is
         sensitive to finger movement; hence, the lighter the touch, the better the
         response. Tapping too hard will not increase the TouchPad’s responsiveness.

Hardware Specifications and Configurations                                           1-16

  Using the Keyboard                                           0

       The computer has a close-to-full-sized keyboard and an embedded numeric keypad,
       separate cursor, and special keys.

        Hot Keys                                                                           0

       The computer has a close-to-full-sized keyboard and separate cursor, function and
       special keys.

              Figure 1-8.   Keyboard Hotkeys

 Hot key (icon)             Function                               Description

                      Previous           Jumps to the previous page.

                      Reload             Reloads the current page.

                      Full-screen        Opens the page in full screen.

                      Next window        Shows all windows in Overview mode.

                      Screenshot         Takes a screenshot.

                      Brightness down    Decreases the screen brightness.

                      Brightness up      Increases the screen brightness.

                      Mute               Turns off audio output.

                      Volume down        Decreases the sound volume.

1-17                                             Hardware Specifications and Configurations

 Hot key (icon)       Function                           Description

                  Volume up          Increases the sound volume.

                                     Locks the currently logged in user. To access your
                  Lock
                                     account, you need to provide a password.
                                     Use the Launcher key to search, show your apps,
                                     and interact with Google Assistant.
                  Launcher               NOTE:
                                         To turn Caps Lock on or off, press Alt +
                                         Launcher.

Hardware Specifications and Configurations                                             1-18

  System Block Diagram                                0

       Figure 1-9.   System Block Diagram

1-19                                        Hardware Specifications and Configurations

Specification Tables                                                                                 0

  Computer specifications

               Item                          Metric                              Imperial
Dimensions
Length                             296 mm                         11.65 in.
Width                              208.3 mm                       8.2 in.
Height                             21.1 mm                        0.83 in.
Weight (equipped with 3-cell
                                   1.35 kg                        2.98 lbs.
battery pack)
Input power
Operating voltage                                       5 / 9 / 12 / 15 / 20 V
Operating current                  3 A (5 V) / 3 A (9 V) / 3 A (12 V) / 3 A (15 V) / 2.25 A (20 V)
Temperature
Operating                          0°C to 40°C                    32°F to 104°F
Nonoperating                       -20°C to 60°C                  -4°F to 140°F
Relative humidity
Operating                                                 80% (at 40°C)
Nonoperating                                               20% to 90%
Maximum altitude (unpressurized)
Operating                                                       N/A
Nonoperating                                                    N/A
Shock
Operating                                                  140 G, 2 ms
Nonoperating                                               220 G, 2 ms
Random vibration
Operating                                                    0.6 G-rms
Nonoperating                                  1.66 G-rms (package vibration test)
    NOTE:
    Applicable product safety standards specify thermal limits for plastic surfaces. The
    computer operates well within this range of temperatures.

Hardware Specifications and Configurations                                                    1-20

  System Board Major Chips

          Item                                      Specification

Core logic             Intel® Alder Lake Processor Family

VGA                    Intel® UHD Graphics
LAN                    N/A
                        USB Type-C™ ports x2
USB
                        USB 3.2 Gen 1 ports x2

Super I/O controller   Nuvoton NPCX993FA0BX
Bluetooth              Bluetooth 5.2
                                 ®
                        Intel Wireless Wi-Fi 6E AX211
Wireless                802.11 a/b/g/n/ac/ax wireless LAN

                        Band: 2.4 GHz, 5 GHz and 6 GHz

PCMCIA                 N/A
Audio codec            Nuvoton NAU88L25
Audio amplifier        Maxim Integrated MAX98360A
Card reader            Embedded in CPU (Integrated)
Touch controller       I2C
GPS                    N/A
eMMC                   Embedded in CPU (Integrated), eMMC 5.1 controller
eSata                  N/A
                        Accelerometer (G-sensor)
Sensor
                        Gyroscope

  Processor

          Item                                      Specification

CPU type               Intel® Alder Lake Processor Family
CPU package            FC-BGA16F
Core Logic             N/A
                              ®
                        Intel       N200
Chipset                       ®
                        Intel       N100

1-21                                            Hardware Specifications and Configurations

  Processor Specifications

  Item     CPU Speed     Cores/           Graphics    Mfg Tech    Cache     Package        TDP
             (GHz)      Threads          Frequency     (nm)        Size                   (Watt)
              1.0
N200                         4/4         0.45 GHz         14      6MB      FC-BGA16F        6
           up to 3.7
              0.8
N100                         4/4          0.4 GHz         14      6MB      FC-BGA16F        6
           up to 3.4

  CPU Fan True Value Table (N/A)

         Temperature (°C)                    Fan Speed (RPM)               SPL Spec (dBA)

  System Memory

            Item                                           Specification
Memory controller                  Built-in at CPU
Memory size                         Single-channel LPDDR5 SDRAM supports 4 GB of onboard
                                     LPDDR5 system memory
                                    Single-channel LPDDR5 SDRAM supports 8 GB of onboard
                                     LPDDR5 system memory
                                   MICRON            SAMSUNG          SK HYNIX
                                    MT62F512M32D2D    K3LKLKL0EM-MG   H9JCNNNBK3ML
Model                                R-031              CN               YR-N6E
                                    MT62F1G32D4DR-0   K3LKBKB0BM-M    H9JCNNNCP3ML
                                     31                 GCP              YR-N6E
Supports maximum
                                   4 GB or 8 GB (single-channel design)
memory size
Supports DIMM type                 LPDDR5 SDRAM
Supports DIMM speed                Up to 4266Mbps
Support DIMM voltage               1.8V/1.05V/0.9V/0.5V                      1.05V/0.5V

Hardware Specifications and Configurations                                                   1-22

  Keyboard

             Item                                      Specification
Type                          SUNREX AD01G_C21B
                              74-/75-/78-key ChromeOS FineTip EDU anchored frame
Total number of keypads
                              Service 2.0 keyboard
Simultaneous Operation of
Internal & External           Yes
Keyboard
Features                      Support international language support

  USB Port

             Item                                       Specification
USB compliance level           USB 3.2 Gen 1 compliant
EHCI                           2
Number of USB port(s)          2
Location                       Left side x1, Right side x1
Output Current                 2.0A

  USB Type-C Port

             Item                                       Specification
USB compliance level           USB 3.2 Gen 1 compliant (speed up to 5 Gb/s)
Output Current of Power        5V / 3.0 A max.
Bus
Power-off USB Charging         Not supported
Mode
DisplayPort Version            DisplayPort 1.4a
Thunderbolt Version            Not supported
Power Delivery for Charging    45 mwh (15 V / 3 A) Type-C USB power adapter
Number of USB port(s)          2
Location                       Left side x1, Right side x1

1-23                                             Hardware Specifications and Configurations

  HDMI Port (N/A)

               Item                                Specification
Compliance level
Data throughput
Number of HDMI port(s)
Location

  Video Interface (N/A)

               Item                                Specification
Chipset
Package
Interface
Compatibility
Sampling rate

  Battery

      Item                                   Specification
                                 LGES                              COSMX
Vendor & Model
                                AP18C8K                            AP20CBL

Battery Type                                 Lithium-ion
                       4471 mAh (nominal)             4590 mAh (nominal)
Pack capacity
                       4343 mAh (minimum)             4457 mAh (minimum)

Number of
                                                  3
battery cell
Package
                                                3S1P
configuration

Hardware Specifications and Configurations                                   1-24

  AC Adapter

       Item                                  Specification
                 DELTA                                 LITE-ON
Vendor & Model    ADP-45HG BA                           PA-1450-50AD

                                                         PA-1450-50A9

                 100-240 Vac, 50-60 Hz (The adapter    115-230 Vac, 50-60 Hz (The
Normal Input     should operate from 90-264 Vac        adapter should operate from
voltage          with an input frequency from 47-63    90-264 Vac with an input
                 Hz.)                                  frequency from 47-63 Hz.)
Input current    1.5 Amps max. at 100 Vac              1.3 Amps max. at 90 Vac
                                                        Should not damage fuse and
                                                         rectifier diode.
                 No damage; Meet fuse and bridge                                 2
Inrush current                                          The inrush current and I t shall
                 diode specifications.
                                                         be less than maximum rated
                                                         value of components.
                  More than 81.84% of average          More than 81.83% of average
                   efficiency load tested at 5V          efficiency load tested at 5V
                   output voltage condition.             output voltage condition.
                  More than 87.3% of average           More than 87.3% of average
                   efficiency load tested at 9V          efficiency load tested at 9V
                   output voltage condition.             output voltage condition.
Efficiency        More than 88.3% of average           More than 88.3% of average
                   efficiency load tested at 12V         efficiency load tested at 12V
                   output voltage condition.             output voltage condition.
                  More than 88.85% of average          More than 88.85% of average
                   efficiency load tested at 15V&20V     efficiency load tested at
                   output voltage condition.             15V&20V output voltage
                                                         condition.

1-25                                        Hardware Specifications and Configurations

       Item                                       Specification
                     Chicony
Vendor & Model        A045RP05P

                      A045RP50P

Normal Input         100-240 Vac, 50-60 Hz (The adapter should operate from 90-264 Vac
voltage              with an input frequency from 47-63 Hz.)
Input current        Shall be less than 1.2 Amps at normal operation range
                      Should not damage fuse and rectifier diode.
                                                      2
                      The peak inrush current and I t shall be less than 85% of their
Inrush current
                       maximum rated value of components@ maximum input voltage,
                       Ta=25°C.
                      Efficiency is measured at nominal input voltage, Ta=25°C and after 30
                       minutes warm up.
                      More than 81.39% of average efficiency (DoE VI) load tested at 5V
                       output voltage condition.
                      More than 86.62% of average efficiency (DoE VI) load tested at 9V
Efficiency
                       output voltage condition.
                      More than 87.4% of average efficiency (DoE VI) load tested at 12V
                       output voltage condition.
                      More than 87.73% of average efficiency (DoE VI) load tested at
                       15V&20V output voltage condition.

  Card Reader

              Item                                        Specification
Chipset                         MicroSD Card
Package                         Built-in to the CPU
Location                        Left side
                                Supported card formats:
                                  Micro SD
Features
                                  Micro SDHC

                                  Micro SDXC

Hardware Specifications and Configurations                                               1-26

  Hard Disk Drive (N/A)

        Item                   Specification
Vendor &
Model Name
Capacity (GB)
Bytes per sector
Data heads
Drive Format
Disks
Spindle speed
(RPM)
Performance Specifications
Buffer size
Interface
Fast data transfer
rate
(Gbits / sec, max)
Media data
transfer rate
(Mbytes/sec max)
DC Power Requirements
Voltage tolerance

  Solid State Drive (N/A)

        Item                   Specification
Vendor &
Model Name
Capacity (GB)
Performance Specifications
Interface
Fast data transfer
rate
(Gbits / sec, max)
DC Power Requirements
Voltage tolerance

1-27                         Hardware Specifications and Configurations

  Embedded MultiMedia Card (eMMC)

       Item                                      Specification
Vendor &           Kingston                               Western Digital
Model Name         EMMC128-TY29-PA5B                      SDINBDV4-1281220VT
Capacity (GB)                                         128
                     Packaged NAND flash memory            Complies with eMMC™ 5.1
                      with eMMC™ 5.1 interface               HS400
                     Backward compatible with all          Supports three different data
                      prior eMMC™ specification              bus widths: 1 bit (default),
Features
                      revisions                              4 bits, 8 bits
                     Data transfer rate: up to             Data transfer rate: up to
                      52Mbyte/s (using 8 parallel data       400MB/s (using 8 parallel data
                      lines at 52 MHz)                       lines at 200 MHz, HS400 Mode)

       Item                                      Specification
Vendor &           Kingston                               Western Digital
Model Name         EMMC32G-TX29-PA8B                      SDINBDV4-32-1220VT
Capacity (GB)                                         32
                     Packaged NAND flash memory            Complies with eMMC™ 5.1
                      with eMMC™ 5.1 interface               HS400
                     Compliant with eMMC™                  Supports three different data
                      Specification Ver.4.4, 4.41, 4.5,      bus widths: 1 bit (default),
Features
                      5.0, 5.1                               4 bits, 8 bits
                     Data transfer rate: up to             Data transfer rate: up to
                      52Mbyte/s (using 8 parallel data       400MB/s (using 8 parallel data
                      lines at 52 MHz)                       lines at 200 MHz, HS400 Mode)

       Item                                      Specification
Vendor &           Kingston                               Western Digital
Model Name         EMMC64G-TY29-PA5B                      SDINBDV4-64-1220VT
Capacity (GB)                                         64
                     Packaged NAND flash memory            Complies with eMMC™ 5.1
                      with eMMC™ 5.1 interface               HS400
                     Backward compatible with all          Supports three different data
                      prior eMMC™ specification              bus widths: 1 bit (default),
Features
                      revisions                              4 bits, 8 bits
                     Data transfer rate: up to             Data transfer rate: up to
                      52Mbyte/s (using 8 parallel data       400MB/s (using 8 parallel data
                      lines at 52 MHz)                       lines at 200 MHz, HS400 Mode)

Hardware Specifications and Configurations                                               1-28

  LCD 11.6”

           Item                                         Specification
Vendor & Model name                  HENGHAO                                  AUO
                                 HD-L116HM03-F5PA                         B116XAB01.4
Screen Diagonal (mm)                     295                                  294.09
Active Area (mm)                256.125 (H) x 144 (V)                 309.4 (H) x 173.95 (V)
Display resolution (pixels)                         1366 x 3(RGB) x 768
Pixel Pitch (mm)                                   0.1875 (H) X 0.1875 (V)
Typical White Luminance               250 (typ.)                             235 (typ.)
(cd/m2) also called
Brightness
Contrast Ratio                                           800 (typ.)
Response Time (Optical
                                                    27 (typ.) / 35 (max.)
Rise Time/Fall Time) msec
Typical Power
                                     2.35 (max.)                            2.8 (max.)
Consumption (Watt)
Weight (Without                      200g (max.)                            310g (max.)
inverter)
Physical Size (mm)            278 (W) x 168 (H) x 3.0 (D)       268.52 (W) x 168.52(H) x 3.2
                                        (max.)                        (D) (PCBA side)
Electrical Interface                                      eDP1.2
Viewing Angle (degree)
Horizontal (Right)                     85 (typ.)                       80 (min.) / 85 (typ.)
CR >= 10 (Left)                        85 (typ.)                       80 (min.) / 85 (typ.)
Vertical (Upper)                       85 (typ.)                       80 (min.) / 85 (typ.)
CR >= 10 (Lower)                       85 (typ.)                       80 (min.) / 85 (typ.)

1-29                                           Hardware Specifications and Configurations

           Item                                    Specification
Vendor & Model name                                HENGHAO
                                               HD-L116HM06-F5PA
Screen Diagonal (mm)                                    295
Active Area (mm)                               256.125 (H) x 144 (V)
Display resolution (pixels)                         1366 x 768
Pixel Pitch (mm)                              0.1875 (H) x 0.1875 (V)
Typical White Luminance                              250 (typ.)
(cd/m2) also called
Brightness
Contrast Ratio                                       800 (typ.)
Response Time (Optical
                                                27 (typ.) / 35 (max.)
Rise Time/Fall Time) msec
Typical Power
                                                    2.35 (max.)
Consumption (Watt)
Weight (Without                                     200g (max.)
inverter)
Physical Size (mm)                       278 (W) x 168 (H) x 3.0 (D) (max.)
Electrical Interface                                  eDP1.2
Viewing Angle (degree)
Horizontal (Right)                                    85 (typ.)
CR = 10 (Left)                                        85 (typ.)
Vertical (Upper)                                      85 (typ.)
CR = 10 (Lower)                                       85 (typ.)

Hardware Specifications and Configurations                                    1-30

  LCD Inverter (N/A)

              Item                                  Specification
Vendor & Model name
Brightness conditions
Input voltage (v)
Input current (mA)
Output voltage (V, RMS)
Output current (mA, RMS)
Output voltage frequency
(KHz)

  Graphics Controller

              Item                                  Specification

VGA Chip                     Intel® UHD Graphics
                             Graphics Special Technology#
Package                      Built-in to the CPU
                             Supports:
                               OpenGL & OpenGL ES

Features                       AVC, HEVC,VP9, AV1, VP8 HW Accelerated Video Decode

                               AVC, VP9 HW Accelerated Video Encode

                               JPEG HW Accelerated Imaging Decode

  Display Supported Resolution (LCD Supported Resolution)

           Resolution                               Specification
eDP                          Version 1.2

  LAN Interface (N/A)

              Item                                  Specification
LAN chipset
LAN connector type
LAN connector location
Features

1-31                                         Hardware Specifications and Configurations

  Wireless + Bluetooth Module

              Item                                      Specifications

Vendor & Model                  Intel® Wi-Fi 6E AX211
Chipset                         Garfield Peak 2
                                 M.2 2230
Form factor
                                 M.2 1216

Frequency band                  2.4 GHz, 5 GHz, and 6 GHz
Protocols and data rates         WiFi: 802.11 a/b/g/n/ac/ax wireless LAN
supported                        BT: Bluetooth 5.2

                                Yes.
Antenna
                                Both AUX and MAIN are routed on the top assembly.
                                 Support Windows 10/11, Linux, Chrome OS

Features                         MIMO Tx/Tx and Rx/Rx Concurrency

                                 Support CNVi interface

  Audio Interface

              Item                                      Specification
Audio Controller                Nuvoton NAU88L25
Audio onboard or optional       On board
Mono or Stereo                  Stereo
Compatibility                   I2S/PCM interface
Sampling rate                   8 kHz ~ 192 kHz
Internal microphone             Two built-in microphones
Internal speaker                Two built-in stereo speakers

  Audio Codec and Amplifier

              Item                                      Specification
Audio Controller                Maxim Integrated MAX98360A
Features                         Simple Plug-and-Play Design

                                 Single-Supply Operation (2.5V to 5.5V)

                                 3.2W Output Power into 4Ω, at 5V

                                 2.2mA Quiescent Current

                                 1ms Turn-On Time

                                 92% Efficiency (RL=8Ω, THD+N=10%)

Hardware Specifications and Configurations                                          1-32

  HD Camera

              Item                          Specification
Vendor               Chicony                       Tech Front
Model Name           CNFLH35-2                     YHV-3
Sensor Type          OV9728 CMOS sensor            1/9” HD CMOS (HM1091)
Pixel Resolution     1280 x 720
                      Automatic image control:     Automatic image control:
                       Automatic Exposure            Automatic Exposure
                       Control, Automatic White      Control and Automatic
                       Balance Control, and          White Balance Control.
                       Automatic Gain Control.      Image Quality Control:
                      Image Quality Control:        Brightness, Contrast, Hue,
                       Color saturation, Hue,        Saturation, Sharpness,
                       Gamma, Sharpness,             Gamma, Backlight
Features
                       Brightness, Contrast, and     Compensation, Low Light
                       Backlight Compensation.       Compensation, and Gain.
                      Resolution Support for       Resolution Support for
                       Still/Motion Image:           Still/Motion Image:
                       1280x720, 640x480,            1280x720 (YUV/MJPG),
                       640x360, and 320x240          640x480 (YUV/MJPG),
                                                     640x360 (YUV/MJPG), and
                                                     320x240 (YUV/MJPG)

  5M Camera

              Item                          Specification
Vendor               Tech Front
Model                YHUJ
Sensor Type          1/5” 5MP CMOS (OV05675)
Pixel Resolution     2592 x 1944
                       Auto focus
Features
                       MIPI output RGB camera module

1-33                                 Hardware Specifications and Configurations

  4G Module

            Item                                      Specification
Vendor                        Fibocom LTE FM101-GL
                                LTE FDD: B1, B2, B3, B4, B5, B7, B8, B12, B13, B14, B17,
                                 B18, B19, B20, B25, B26, B28, B29, B30, B66, B71
                                LTE TDD: B38, B39, B40, B41, B42, B43, B48(CBRS)

                                WCDMA: B1, B2, B4, B5, B6, B8, B19
Features
                                HPUE: B41

                                Integrated GPS, GLONASS, BeiDou, Galileo

                                Assisted GNSS (A-GNSS)

                                Built-in eSIM

  VRAM (N/A)

            Item                                      Specification
Vendor & Model name
Memory size
Interface

  System Power Management

            Item                                      Specification
Full On (G0/S0)               This is the normal operating state of the processor.
                              Individual devices may be shut down to save power. The
                              different CPU operating levels are defined by Cx states.
Suspend to RAM (Standby)      S0ix is a suspend state in which the core power planes of
(G1/S0ix)                     the processor are turned off and the suspend wells remain
                              powered.
                                VGA Suspend

                                Audio Power Down

                                Hard Disk Power Down

                                Super I/O Low Power mode

Soft Off (G2/S5)              OS initiated shutdown. All devices in the system are turned
                              off completely. A full boot is required when waking.
Mechanical Off (G3)           All devices in the system are turned off completely.

Hardware Specifications and Configurations                                               1-34

  System LED Indicator

              Item                                     Specification
System power state           System has no Power State LED
                               Battery charging: Solid Amber

                               Fully charged: Solid Blue

                               Discharge in S3: Blinking Amber (1 sec. on, 3 sec. off)

Battery state                  Discharge in S5: Off

                               Error: Blinking Amber (1 sec. on, 1 sec. off)

                               Discharge in S0: Solid Blue

                               Factory mode: Blinking (Blue 2 sec. on, Amber 2 sec. on)

Power button backlight       Power button has no LED
                               Wi-Fi has no LED
Communication state
                               Bluetooth has no LED

  System DMA Specification (N/A)

        Legacy Mode                                Power Management

  System Interrupt Specification (N/A)

        Hardware IRQ                                 System Function

  System I/O Address Map (N/A)

       I/O address (hex)                 System Function (shipping configuration)

  Memory Address Map (N/A)

  Memory address (hex)                   System Function (shipping configuration)

1-35                                             Hardware Specifications and Configurations

CHAPTER 2
 System Utilities

      Introduction . . . . . . . . . . . . . . . . . . . . . . . . . . . . . . . . . . . . . . . . . 2-3
      Key Component Replacement and HWID Re-configuration . . . 2-3
          Creating RMA Shim Using “Chromebook Recovery Utility” in
          Windows System/Chromebook . . . . . . . . . . . . . . . . . . . . . . . .2-5
          Install RMA Shim Process by RSU. . . . . . . . . . . . . . . . . . . . . . .2-10
          Run RMA Shim Process. . . . . . . . . . . . . . . . . . . . . . . . . . . . . . .2-17
          Start the RMA Main Test . . . . . . . . . . . . . . . . . . . . . . . . . . . . .2-18
          Start the RMA FFT Test. . . . . . . . . . . . . . . . . . . . . . . . . . . . . . .2-20

2-2

System Utilities

Introduction                                                                                 0

    This chapter contains information on how to re-configure the Acer Chromebook
    R756T/R756TN HWID as well as test procedures for your notebook’s various components.

Key Component Replacement and HWID
Re-configuration                                                                             0

    When certain key components are replaced, the correct hardware ID (HWID) must be
    re-configured.
        Battery

        Motherboard

        Touchpad

        Keyboard

        Camera

        SSD

        LCD panel

    To re-configure the HWID you must prepare the following items:
        A 16 GB or larger USB 3.0 flash drive.

        The RMA.bin file that is needed to re-configure the HWID after replacing a key
           component.
        The Chrome Recovery Utility is the tool used to write the image to the USB flash
           drive.
           https://chrome.google.com/webstore/detail/chromebook-recovery-utili/jndclpdbaa
           mdhonoechobihbbiimdgai

System Utilities                                                                        2-3

      The HWID re-configuration procedure is outlined in the following flow chart:

                            Use chromebook recovery utility
                            to create a RAM shim install disk

                                                                     Fail
                                                                If always fail
                                   Switch DEV mode              Please try to
                                                                   re-copy
                                                                The RMA.bin

                                Install image from install
                                  shim to chrome book

                                         PASS

                                       Verify HW

                                   Change to release
                                        image

            Figure 2-1.   HWID Re-Configuration Flow Chart

2-4                                                                              System Utilities

  Creating RMA Shim Using “Chromebook Recovery Utility” in
  Windows System/Chromebook                                                                0

    1. In another notebook or PC running Windows, copy RMA_SHIM.bin in a folder.
    2. Insert a USB flash drive or SD card (must be at least 8 GB of storage) into the
       Windows OS system or Chromebook.

            Figure 2-2.   USB Disk

    3. Double-click “Chromebook recovery Utility" to open the program.

            Figure 2-3.   Chromebook Recovery Utility Shortcut Icon

System Utilities                                                                         2-5

      4. Select Use local image.

             Figure 2-4.   Select Local Image

      5. Browse the file and select the RMA_SHIM.bin image file. Then Click Open.

             Figure 2-5.   Access Image File

2-6                                                                          System Utilities

    6. Select the media you’d like to use, and then click Continue.

            Figure 2-6.   Select Media Device

    7. Click Create Now.

            Figure 2-7.   Creating Recovery Image Initialization (1 of 2)

System Utilities                                                            2-7

      8. Click Yes to allow the Chromebook Recovery Utility program to start creating RMA
         shim disk.

             Figure 2-8.   Creating Recovery Image Initialization (2 of 2)

      9. The RMA shim disk creation process begins.

             Figure 2-9.   Writing in Progress

2-8                                                                          System Utilities

    10. Once the program has successfully written the image, the system shows Success!
        Your recovery media is ready message. Click Done, and then remove the USB
        drive from the notebook or PC running Windows.

            Figure 2-10.   Write Successful

System Utilities                                                                   2-9

  Install RMA Shim Process by RSU                                                       0

       The enrolled machine only can use mandatory RMA server Unlock(RSU).

   1. Place the system on a stable work surface.
   2. Plug in the AC adapter and open the lid to turn on the system.
   3. Press and hold Esc + Refresh keys, and press Power. Then release Power. When a
      message shows on the screen, release the Esc + Refresh keys.
   4. When the system displays Let's step you through the recovery process
      message on the screen, press Ctrl+ D keys.

            Figure 2-11.   Enable Developer Mode (1 of 2)

2-10                                                                     System Utilities

    5. Select Confirm.

            Figure 2-12.   Enable Developer Mode (2 of 2)

    6. Press and hold Esc + Refresh keys, and press Power. Then release Power. When a
       message shows on the screen, release the Esc + Refresh keys.

            Figure 2-13.   Return to Secure Mode

System Utilities                                                                        2-11

   7. When the system displays Let's step you through the recovery process
      message on the screen, install the RMA Shim USB disk to the machine.

          Figure 2-14.   Initiate Recovery Process

   8. After the USB disk is inserted, the system starts installing RMA shim.

          Figure 2-15.    Installation Process

2-12                                                                           System Utilities

    9. Scan the QR code to get the link.

            Figure 2-16.   QR Code Scanning

    10. Insert the U2F security key and click the link. Then touch the U2F security key.

                                                                        U2F security key

            Figure 2-17.   U2F Security Key Installation

System Utilities                                                                           2-13

   11. Get the Unlock code.

          Figure 2-18.    Obtain the Unlock Code

   12. Enter the Unlock code into the system and click Enter. The machine will restart.

                          Unlock code

          Figure 2-19.    Enter the Unlock Code

   13. Press and hold Esc + Refresh keys, and press Power. Then release Power. A message
       shows on the screen as shown in Figure 2-20.

          Figure 2-20.   Enter Developer Mode

2-14                                                                         System Utilities

    14. The system will display the RAM shim installation process as shown in Figure 2-21.

            Figure 2-21.    Start RMA Shim Installation

    15. Press Enter twice to restart.

            Figure 2-22.    System Restart

System Utilities                                                                        2-15

   16. Unplug the USB RMA drive and AC adapter from the machine during the restart.
       NOTE:   NOTE:
          If below message appears on the screen as shown in Figure 2-23, do the following:
          a.Enter VT2 by pressing Ctrl + Alt + F2.
          b.Log in as root with password test0000 if required.
          c.Run the following command: enable_dev_usb_boot.
          d.Insert the USB memory stick, reboot and press Ctrl -U at the dev mode warning
           screen to start install RMA shim. You can also enter VT2 and install the RMA shim.

           Figure 2-23.    Error Message

2-16                                                                         System Utilities

  Run RMA Shim Process                                   0

    1. Plug in the AC adapter and open the lid to turn on the system.
    2. The system will restart automatically when RMA image installation is completed and
       automatically boot to Factory Test mode.

            Figure 2-24.   Factory Test Mode

System Utilities                                                                     2-17

  Start the RMA Main Test                              0

   1. Verify the Boxster model name and SKU. Then press Enter to pass.
   2. Verify the Local model name and SKU. Then press Enter to pass.

   3. Update the firmware.

          Figure 2-25.    Firmware Update Screen

   4. Update device data.
       a) Enter the device serial number.

          Figure 2-26.    Enter Device Serial Number

2-18                                                                     System Utilities

        b) Select the region.

            Figure 2-27.   Select the Region

5. Starts running the Finalize procedure.
        a) Factory wiping in progress.

            Figure 2-28.   Finalizing Process

    NOTE:          NOTE:
          Do NOT restart the system or terminate the test manually during the finalize
          procedure.
        b) Unplug the AC adapter. Then the system begins to wipe image. Wait until the
           procedure is completed.

            Figure 2-29.   Finishing RMA Shim Process

System Utilities                                                                         2-19

  Start the RMA FFT Test                                                                         0

       If you need to check the function of each devices, you need to switch the device to FFT
       (Final Functional Test) mode.
   1. Press Ctrl + Alt + 0 simultaneously to enter CrOS mode.
   2. Enter cros in the Password field and click OK to begin the test.

              Figure 2-30.   FFT Test

   3. Select CrOS Factory > Switch test list > Crassk/Crasskbowl/Craskvin Main RMA
      FFT Test-List.

              Figure 2-31.   Start RMA FFT Test

2-20                                                                            System Utilities

    4. Confirm your decision in the pop-up window. The Crassk/Crasskbowl/Craskvin Main
       RMA FFT test will start.

            Figure 2-32.   Confirmation Window

System Utilities                                                                   2-21

Conventions

   Boxster Model and SKU                                                                  0

   Verify the Boxster model name and SKU. Then press Enter to pass.

   Local Model and SKU                                                                    0

   Verify the Local model name and SKU. Then press Enter to pass.

   Wifi Test                                                                              0

   The test will start automatically.

   Touchscreen Uniformity Test                                                            0

   The test will start automatically.

   Display Point Test                                                                     0

       Press Space to test the display point and start the points check.

              Figure 2-33.   Display Point Test

2-22                                                                       System Utilities

    a. Check if there is any point shown. Then enter the number of points found.

            Figure 2-34.   Display Point Test

    b. Check if there is any point shown. Then enter the number of points found.

            Figure 2-35.   Display Point Test

System Utilities                                                                   2-23

   Display Test                                                                                  0

   1. Press Space to test the color listed in the display test.

           Figure 2-36.    Display Test

   2. If the color displayed on the screen matches the color listed in the display test, press
      Enter.
       NOTE:   NOTE:
          If the color displayed on the screen does not match with the description, press Esc.

           Figure 2-37.    Display Test

   3. Repeat this process for each color listed in the display test.

2-24                                                                           System Utilities

   Backlight Test                                                                              0

    1. Press Space to change the backlight brightness. Then press Esc to reset the backlight
       brightness to its default setting.
    2. After checking, enter H if pressing Space changes the backlight to be brighter.
       Otherwise, enter L if pressing Space changes the backlight to be dimmer.

            Figure 2-38.   Backlight Test

    3. Repeat step 1 and 2 twice.

   Update SSFC Test                                                                            0

   The test will start automatically.

System Utilities                                                                        2-25

   Base Accelerometers Auto Calibration Test                                                   0

   Place the device in face-up position and press Enter to start calibration.

           Figure 2-39.   Base Accelerometers Auto Calibration Test

2-26                                                                            System Utilities

   Lid Accelerometers Calibration Test                                               0

   Place the device on a horizontal plane and press Space to start calibration.

            Figure 2-40.   Lid Accelerometers Calibration Test

System Utilities                                                                  2-27

   Accelerometers Lid Angle Test                                                  0

   Open the lid to 180 degrees and press Space to start testing.

          Figure 2-41.    Accelerometers Lid Angle Test

2-28                                                               System Utilities

   Gyroscope Calibration Test                  0

   The test will start automatically.

   Gyroscope Test                              0

   Rotate the device.

            Figure 2-42.   Gyroscope Test

System Utilities                            2-29

   Screen Rotation Test                                                                      0

       a) Tablet mode
       Flip the lid into tablet mode, then tap Confirm tablet mode to start test.

              Figure 2-43.   Tablet Mode Test

       b) Tablet Rotation Base-Accel
   1. Rotate the tablet to correctly align the picture, holding it at an upright 90-degree
      angle.

              Figure 2-44.   Tablet Rotation Base-Accel Test

2-30                                                                          System Utilities

    2. Rotate the tablet to correctly align the picture, holding it at an upright 90-degree
       angle.

            Figure 2-45.   Tablet Rotation Base-Accel Test

    3. Rotate the tablet to correctly align the picture, holding it at an upright 90-degree
       angle.

            Figure 2-46.   Tablet Rotation Base-Accel Test

    4. Rotate the tablet to correctly align the picture, holding it at an upright 90-degree
       angle.

            Figure 2-47.   Tablet Rotation Base-Accel Test

System Utilities                                                                         2-31

   5. Rotate the tablet to correctly align the picture, holding it at an upright 90-degree
      angle.

             Figure 2-48.   Tablet Rotation Base-Accel Test

       c) Notebook mode
       Open the lid back to notebook mode and press Space to confirm notebook mode.

             Figure 2-49.   Notebook Mode Test

2-32                                                                         System Utilities

   Rear Camera QR Code Test                                                                   0

   Print the QR code with a white paper. Then place the QR code in front the camera to test
   it.

            Figure 2-50.   Rear Camera QR Code Test

   Front Camera QR Code Test                                                                  0

   Print the QR code with a white paper. Then place the QR code in front the camera to test
   it.

            Figure 2-51.   Front Camera QR Code Test

System Utilities                                                                       2-33

   Speaker/Front Microphone Test                                        0

   The test will start automatically.

   Speaker/Rear Microphone Test                                         0

   The test will start automatically.

   LED Test                                                             0

   1. Press the number key according to the LED color.

           Figure 2-52.    LED Test

           Figure 2-53.    Battery LED Location

   2. Repeat step 1 until the test is completed.

2-34                                                     System Utilities

     Manual Test Left USB Type-A                                                                  0

     A. USB2 Type-A Performance Test                                                              0

     1. Insert a USB 2.0 drive to the USB port on the left side of the notebook.

 !   CAUTION:
                   Any data in the inserted USB drive will cleared during the USB test. Please
                   ensure that you either use an empty USB drive or backup all the data located
                   in the drive before you proceed with the USB test.

            Figure 2-54.      USB 2.0 Performance Test

     2. Remove the USB 2.0 drive when you see the message instructing you to do so.

            Figure 2-55.      USB 2.0 Performance Test

System Utilities                                                                           2-35

     B. USB3 Type-A Performance Test                                                           0

     1. Insert a USB 3.0 drive to the USB port on the left side of the notebook.

 !   CAUTION:
                Any data in the inserted USB drive will cleared during the USB test. Please
                ensure that you either use an empty USB drive or backup all the data located
                in the drive before you proceed with the USB test.

            Figure 2-56.    USB 3.0 Performance Test

     2. Remove the USB 3.0 drive when you see the message instructing you to do so.

            Figure 2-57.    USB 3.0 Performance Test

2-36                                                                          System Utilities

     Manual Test Right USB Type-A                                                                 0

     A. USB2 Type-A Performance Test                                                              0

     1. Insert a USB 2.0 drive to the USB port on the right side of the notebook.

 !   CAUTION:
                   Any data in the inserted USB drive will cleared during the USB test. Please
                   ensure that you either use an empty USB drive or backup all the data located
                   in the drive before you proceed with the USB test.

            Figure 2-58.      USB 2.0 Performance Test

     2. Remove the USB 2.0 drive when you see the message instructing you to do so.

            Figure 2-59.      USB 2.0 Performance Test

System Utilities                                                                           2-37

     B. USB3 Type-A Performance Test                                                           0

     1. Insert a USB 3.0 drive to the USB port on the right side of the notebook.

 !   CAUTION:
                Any data in the inserted USB drive will cleared during the USB test. Please
                ensure that you either use an empty USB drive or backup all the data located
                in the drive before you proceed with the USB test.

            Figure 2-60.   USB 3.0 Performance Test

     2. Remove the USB 3.0 drive when you see the message instructing you to do so.

            Figure 2-61.   USB 3.0 Performance Test

2-38                                                                          System Utilities

     Manual Test Right USB Type-C                                                                 0

     A. USB2 Performance Test                                                                     0

     1. Insert a USB 2.0 drive to the USB Type-C port on the right side of the notebook.

 !   CAUTION:
                   Any data in the inserted USB drive will cleared during the USB test. Please
                   ensure that you either use an empty USB drive or backup all the data located
                   in the drive before you proceed with the USB test.

            Figure 2-62.      USB 2.0 Performance Test

     2. Remove the USB 2.0 drive when you see the message instructing you to do so.

            Figure 2-63.      USB 2.0 Performance Test

System Utilities                                                                           2-39

     B. USB3 CC1 Performance Test                                                              0

     1. Insert a USB 3.0 drive to the USB Type-C port on the right side of the notebook.

 !   CAUTION:
                Any data in the inserted USB drive will cleared during the USB test. Please
                ensure that you either use an empty USB drive or backup all the data located
                in the drive before you proceed with the USB test.

            Figure 2-64.   USB 3.0 CC1 Performance Test

     2. Remove the USB 3.0 drive when you see the message instructing you to do so.

            Figure 2-65.   USB 3.0 CC1 Performance Test

2-40                                                                          System Utilities

     C. USB3 CC2 Performance Test                                                                 0

     1. Insert a USB 3.0 drive to the USB Type-C port on the right side of the notebook.

 !   CAUTION:
                   Any data in the inserted USB drive will cleared during the USB test. Please
                   ensure that you either use an empty USB drive or backup all the data located
                   in the drive before you proceed with the USB test.

            Figure 2-66.      USB 3.0 CC2 Performance Test

     2. Remove the USB 3.0 drive when you see the message instructing you to do so.

            Figure 2-67.      USB 3.0 CC2 Performance Test

System Utilities                                                                           2-41

   D. USB Type-C 15V Charging Test                                                              0

       Connect the Type-C adapter to the right USB Type-C port to start test the 15V charging
       test.

   E. USB3 External Display Test                                                                0

   1. Connect one end of the USB Type-C cable to the USB Type-C port on the right side of
      the notebook. Then connect the other end of the USB Type-C cable to an external
      monitor.
   2. Press the number displayed on the screen to finish the test.

              Figure 2-68.   USB3 External Display Test

   3. Disconnect the USB Type-C cable from the notebook and external monitor.

              Figure 2-69.   USB3 External Display Test

2-42                                                                           System Utilities

     Manual Test Left USB Type-C                                                                  0

     A. USB2 Performance Test                                                                     0

     1. Insert a USB 2.0 drive to the USB Type-C port on the left side of the notebook.

 !   CAUTION:
                   Any data in the inserted USB drive will cleared during the USB test. Please
                   ensure that you either use an empty USB drive or backup all the data located
                   in the drive before you proceed with the USB test.

            Figure 2-70.      USB 2.0 Performance Test

     2. Remove the USB 2.0 drive when you see the message instructing you to do so.

            Figure 2-71.      USB 2.0 Performance Test

System Utilities                                                                           2-43

     B. USB3 CC1 Performance Test                                                              0

     1. Insert a USB 3.0 drive to the USB Type-C port on the left side of the notebook.

 !   CAUTION:
                Any data in the inserted USB drive will cleared during the USB test. Please
                ensure that you either use an empty USB drive or backup all the data located
                in the drive before you proceed with the USB test.

            Figure 2-72.   USB 3.0 CC1 Performance Test

     2. Remove the USB 3.0 drive when you see the message instructing you to do so.

            Figure 2-73.   USB 3.0 CC1 Performance Test

2-44                                                                          System Utilities

     C. USB3 CC2 Performance Test                                                                 0

     1. Insert a USB 3.0 drive to the USB Type-C port on the left side of the notebook.

 !   CAUTION:
                   Any data in the inserted USB drive will cleared during the USB test. Please
                   ensure that you either use an empty USB drive or backup all the data located
                   in the drive before you proceed with the USB test.

            Figure 2-74.      USB 3.0 CC2 Performance Test

     2. Remove the USB 3.0 drive when you see the message instructing you to do so.

            Figure 2-75.      USB 3.0 CC2 Performance Test

System Utilities                                                                           2-45

   D. USB Type-C 15V Charging Test                                                             0

       Connect the Type-C adapter to the left USB Type-C port to start test the 15V charging
       test.

   E. USB3 External Display Test                                                               0

   1. Connect one end of the USB Type-C cable to the USB Type-C port on the left side of
      the notebook. Then connect the other end of the USB Type-C cable to an external
      monitor.
   2. Press the number displayed on the screen to finish the test.

              Figure 2-76.   USB3 External Display Test

   3. Disconnect the USB Type-C cable from the notebook and external monitor.

              Figure 2-77.   USB3 External Display Test

2-46                                                                           System Utilities

     SD Performance Test                                                                         0

     1. Insert an SD card to the card reader.

 !   CAUTION:
                   Any data in the inserted SD card reader will cleared during the card reader
                   test. Please ensure that you either use an empty SD card or backup all the
                   data located in the drive before you proceed with the card reader test.

            Figure 2-78.      Insert SD Card

     2. Remove the SD card when you see the message instructing you to do so.

            Figure 2-79.      SD Performance Test

System Utilities                                                                            2-47

   Keyboard Test                                                                  0

   Press the keyboard keys from left to right and top to bottom.

          Figure 2-80.   Keyboard Test

2-48                                                               System Utilities

   Hardware Button Test                                 0

    1. Press the Power button.

            Figure 2-81.   Power Button Test

    2. Press the Volume Down button.

            Figure 2-82.   Volume Down Button Test

    3. Press the Volume Up button.

            Figure 2-83.   Volume Up Button Test

System Utilities                                     2-49

   Touchpad Test                                                                              0

   a. Remove your fingers, and then press Space to start testing.

           Figure 2-84.   Touchpad Test

   b. Place one finger on the touchpad and move your finger in the all area.
   c.   Place 2 fingers on the touchpad. One finger hold. The other One finger on the right
        edge of the touchpad and slide the finger up to down.
   d. Click Left-Top/Left Bottom/Right-Top/Right-Bottom by one finger. Repeat the same
      procedure for each item 2 times.
   e. Place 2 fingers on the touchpad and click it 3 times.

             b                                                       c

              d                                           e

           Figure 2-85.   Touchpad Test

2-50                                                                        System Utilities

   Touchscreen Test                                                                   0

    1. Draw blocks on the screen beginning from upper left corner in a sequence.
    2. Press Esc if the test fails.

            Figure 2-86.   Touchscreen Test

   Lid Switch Test                                                                    0

   Close then open the lid. Open the lid when you hear “OK" from the device.

System Utilities                                                                   2-51

   Bluetooth Test                                                                         0

   Enable the Bluetooth function of a device and place the device near the system. Then
   press Enter to start the test.

   Finish the Test                                                                        0

   All tests are complete.

           Figure 2-87.      Finish Test

2-52                                                                       System Utilities

             CHAPTER 3
Machine Maintenance Procedures

      Introduction . . . . . . . . . . . . . . . . . . . . . . . . . . . . . . . . . . . . . . . . . 3-4
      General Information . . . . . . . . . . . . . . . . . . . . . . . . . . . . . . . . . . 3-4
      Recommended Equipment . . . . . . . . . . . . . . . . . . . . . . . . . . . . . 3-4
      Pre-disassembly Instructions . . . . . . . . . . . . . . . . . . . . . . . . . . . . 3-5
      Disassembly Process . . . . . . . . . . . . . . . . . . . . . . . . . . . . . . . . . . . 3-6
      Main Unit Disassembly Process . . . . . . . . . . . . . . . . . . . . . . . . . . 3-7
          Main Unit Disassembly Flowchart . . . . . . . . . . . . . . . . . . . . . .3-7
          Base Cover Removal . . . . . . . . . . . . . . . . . . . . . . . . . . . . . . . . .3-8
          Battery Pack Removal. . . . . . . . . . . . . . . . . . . . . . . . . . . . . . . .3-10
          Touchpad Module Removal. . . . . . . . . . . . . . . . . . . . . . . . . . .3-12
          Keyboard Removal . . . . . . . . . . . . . . . . . . . . . . . . . . . . . . . . . .3-15
          Speaker Module Removal . . . . . . . . . . . . . . . . . . . . . . . . . . . .3-18
          USB Board Removal . . . . . . . . . . . . . . . . . . . . . . . . . . . . . . . . .3-20
          LED Board Removal . . . . . . . . . . . . . . . . . . . . . . . . . . . . . . . . .3-24
          Microphone Board Removal . . . . . . . . . . . . . . . . . . . . . . . . . .3-26
          LCD Module Removal. . . . . . . . . . . . . . . . . . . . . . . . . . . . . . . .3-28
          Mainboard Removal. . . . . . . . . . . . . . . . . . . . . . . . . . . . . . . . .3-32
          Top Camera Module Removal . . . . . . . . . . . . . . . . . . . . . . . . .3-37
          Top Assembly Removal . . . . . . . . . . . . . . . . . . . . . . . . . . . . . .3-39
      LCD Module Disassembly Process . . . . . . . . . . . . . . . . . . . . . . . . 3-40
          LCD Module Disassembly Flowchart . . . . . . . . . . . . . . . . . . . .3-40
          LCD Panel Removal. . . . . . . . . . . . . . . . . . . . . . . . . . . . . . . . . .3-41
          LCD Hinges Removal . . . . . . . . . . . . . . . . . . . . . . . . . . . . . . . .3-44
          Camera Module Removal. . . . . . . . . . . . . . . . . . . . . . . . . . . . .3-46
          G-Sensor Board Removal . . . . . . . . . . . . . . . . . . . . . . . . . . . . .3-49
          eDP Cable Removal . . . . . . . . . . . . . . . . . . . . . . . . . . . . . . . . .3-51
          WLAN Antenna Removal . . . . . . . . . . . . . . . . . . . . . . . . . . . . .3-55
      LCD Module Reassembly Process . . . . . . . . . . . . . . . . . . . . . . . . 3-57
          Replacing the WLAN Antenna. . . . . . . . . . . . . . . . . . . . . . . . .3-57
          Replacing the eDP Cable . . . . . . . . . . . . . . . . . . . . . . . . . . . . .3-59
          Replacing the G-Sensor Board . . . . . . . . . . . . . . . . . . . . . . . . .3-63
          Replacing the Camera Module . . . . . . . . . . . . . . . . . . . . . . . .3-64
          Replacing the LCD Hinges . . . . . . . . . . . . . . . . . . . . . . . . . . . .3-66
          Replacing the LCD Panel . . . . . . . . . . . . . . . . . . . . . . . . . . . . .3-68
      Main Unit Reassembly Process . . . . . . . . . . . . . . . . . . . . . . . . . . 3-70
          Replacing the Top Assembly . . . . . . . . . . . . . . . . . . . . . . . . . .3-70
          Replacing the Top Camera Module. . . . . . . . . . . . . . . . . . . . .3-71
          Replacing the Mainboard . . . . . . . . . . . . . . . . . . . . . . . . . . . .3-73
          Replacing the LCD Module . . . . . . . . . . . . . . . . . . . . . . . . . . .3-77
          Replacing the Microphone Board . . . . . . . . . . . . . . . . . . . . . .3-80
          Replacing the LED Board . . . . . . . . . . . . . . . . . . . . . . . . . . . . .3-82
          Replacing the USB Board . . . . . . . . . . . . . . . . . . . . . . . . . . . . .3-84

3-2

Replacing the Speaker Module . . . . . . . . . . . . . . . . . . . . . . . .3-88
Replacing the Keyboard. . . . . . . . . . . . . . . . . . . . . . . . . . . . . .3-90
Replacing the Touchpad Module . . . . . . . . . . . . . . . . . . . . . .3-92
Replacing the Battery Pack . . . . . . . . . . . . . . . . . . . . . . . . . . .3-95
Replacing the Base Cover. . . . . . . . . . . . . . . . . . . . . . . . . . . . .3-97

                                                                                  3-3

Machine Maintenance Procedures

Introduction                                                                                      0

      This chapter contains general information about the computer, a list of tools needed to
      do the required maintenance and step by step procedures on how to remove and install
      components from the computer.

General Information                                                                               0

      The product previews seen in the following procedures may not represent the final
      product color or configuration. Cable paths and positioning may also differ from the
      actual model. During the removal and installation of components, make sure all
      available cable channels and clips are used and that the cables are installed in the same
      position.
      All prerequisites must be completed prior to starting maintenance.

Recommended Equipment                                                                             0

      The following equipment are recommended to do the following maintenance
      procedures:
         Wrist grounding strap and conductive mat
         Flat screwdriver
         Philips screwdriver
         Polydrive screwdriver
         Plastic tweezers
         Flat plastic pry

3-4                                                         Machine Maintenance Procedures

Pre-disassembly Instructions                                                            0

   Do the following prior to starting any maintenance procedures:
   1. Place the system on a stable work surface.
   2. Remove the power adapter from the USB Type-C port (A) as shown in Figure 3-1 or
      from the USB-C port (B) as shown in Figure 3-2.
   3. Remove all cables from system.

                                                               A

          Figure 3-1.   AC Adapter Outlet

   4. Remove the microSD card from the microSD card slot (C) (Figure 3-2).

                        B       C

          Figure 3-2.   MicroSD Card Removal

    NOTE:     NOTE:
         Make sure the system is completely powered off.

Machine Maintenance Procedures                                                      3-5

Disassembly Process                                                                           0

      The disassembly process is divided into the following sections:
         Main unit disassembly
         LCD module disassembly

      The flowcharts provided in the succeeding disassembly sections illustrate the entire
      disassembly sequence. Observe the order of the sequence to avoid damage to any of the
      hardware components. For example, when removing the mainboard, remove first the
      Base Cover, Battery, and Keyboard in that order.

      Table 3-1.   Main Screw List
                        Size                           Quantity          Acer Part No.
SCREW M2.5*5-I(NI,NYLOK)IRON                               6            86.A6VN7.001
SCREW W/WASHER KIT                                         11            86.VLLN7.003
SCREW M2*2.5-I(BZN,NYLOK)IRON                              1             86.GVJN7.002
SCREW M2.0*4.0-I(BZN)(NYLOK)IRON                           12            86.A91N7.002
SCREW M2.0*5.0- I(BZN)(NYLOK)IRON                         N/A           86.AZGN7.001
SCREW M2.5*2.5-I(BNI)NYLOKD8T0.4IRON                       6            86.GWGN7.001
SCREW ASSY(M2.0*5.5)W/WASHER                               2             86.KE4N7.001
SCREW M2*2.5-I(BNI)(NYLOK)IRON                             3            86.A6VN7.002

3-6                                                         Machine Maintenance Procedures

Main Unit Disassembly Process                                                                                 0

  Main Unit Disassembly Flowchart                                                                             0

                                                Base Cover

                                                    Battery

     Touchpad                                                                 Top Microphone
                       Keyboard    Speaker      USB Board     Top LED Board                    LCD Module
      Module                                                                      Board

                       Mainboard                                       Top Camera
                                                                         Module

                                               Top Assembly

   Table 3-2.     Main Unit Screw List
                Step                         Size                Quantity                 Acer Part No.
Base Cover Removal                       M2.0*5.5              2 (keyboard)              86.KE4N7.001
                                         M2.5*7.0             11 (base cover)             86.VLLN7.003
Touchpad Module Removal                  M2.0*2.5                     3                  86.A6VN7.002
USB Board Removal                        M2.5*5.0                3 (hinge)               86.A6VN7.001
                                         M2.0*4.0             3 (USB board &             86.A91N7.002
                                                                I/O bracket)
Microphone Board Removal                 M2.0*2.5                     1                  86.GVJN7.002
LCD Module Removal                       M2.5*5.0                     6                  86.A6VN7.001
Mainboard Removal                        M2.5*5.0                3 (hinge)               86.A6VN7.001
                                         M2.0*4.0             7 (mainboard &             86.A91N7.002
                                                                I/O bracket)
Top Camera Module                        M2.0*4.0                     2                  86.A91N7.002
Removal

Machine Maintenance Procedures                                                                              3-7

  Base Cover Removal                                                                            0

      1. Remove eleven (11) screws from the base cover. Then remove another two (2) screws
         securing the keyboard (Figure 3-3).

             Figure 3-3.   Base Cover Removal

      2. Carefully pry up the base cover starting from the upper side to release the latches.
         Then continue releasing the remaining latches on the left, right, and bottom sides
         (Figure 3-4).

             Figure 3-4.   Base Cover Removal

3-8                                                         Machine Maintenance Procedures

   3. Grasp and remove the base cover from the system (Figure 3-5).

           Figure 3-5.   Base Cover Removal

   ID           Size             Torque         Quantity              Screw Type
Orange
             M2.0*5.5        2.0+20%kgf-cm     2 (keyboard)
Call out
Red
             M2.5*7.0        3.0±15%kgf-cm    11 (base cover)
Call out

Machine Maintenance Procedures                                                     3-9

  Battery Pack Removal                                                                    0

   Prerequisite:
                  Base Cover Removal

   1. Find the battery pack (A) on the top assembly (Figure 3-6).
   2. Detach the acetate tape (B) securing the battery cable to the mainboard connector
      (Figure 3-6).
   3. Detach the transparent mylar (C) securing the battery cable (Figure 3-6).

                                                          B
                                                 C

                                           A

          Figure 3-6.   Battery Pack Removal

3-10                                                     Machine Maintenance Procedures

   4. Disconnect the battery cable from the mainboard connector (D) (Figure 3-7).

                                                            D

          Figure 3-7.   Battery Pack Removal

   5. Lift to release the battery pack from the guide pins (E) (Figure 3-8). Then remove the
      battery pack from the top assembly.

                 E                                                       E

                WEEE Annex VII Component:
                Battery Pack

          Figure 3-8.   Battery Pack Removal

+ IMPORTANT:
                  Follow local regulations for battery disposal.

Machine Maintenance Procedures                                                          3-11

  Touchpad Module Removal                                                                   0

   Prerequisite:
                  Battery Pack Removal

   1. Detach the adhesive tape (A) securing the touchpad FFC on the touchpad module.
      (Figure 3-9).

                                           A

          Figure 3-9.    Touchpad Module Removal

   2. Disconnect the touchpad FFC (B) from the touchpad module and mainboard
      connectors. Then carefully detach the FFC from its underneath adhesive to remove it
      from the top assembly (Figure 3-10).

                                           B

          Figure 3-10.    Touchpad Module Removal

3-12                                                   Machine Maintenance Procedures

 !   CAUTION:
                Touchpad FFC (Flexible Flat Circuit) can be damaged if removed while the
                mainboard and touchpad module connectors are locked.

     3. Detach the conductive tape (C) from the touchpad module (Figure 3-11).

                                               C

            Figure 3-11.   Touchpad Module Removal

     4. Remove three (3) screws securing the touchpad module (Figure 3-12).

            Figure 3-12.   Touchpad Module Removal

Machine Maintenance Procedures                                                         3-13

   5. Using the screwdriver, push the guide pins (D) firmly to release them from the top
      assembly (Figure 3-13).
   6. Slide the touchpad module slightly to disengage it from the bottom latches (E), and
      then remove the touchpad module (F) from the top assembly (Figure 3-13).

                          D            D                      D

                                                  F

                                    WEEE Annex VII Component:
                                    Touchpad Module

                              E                                   E

           Figure 3-13.       Touchpad Module Removal

   ID           Size                 Torque           Quantity            Screw Type
Red
             M2.0*2.5             2.0+20%kgf-cm          3
Call out

3-14                                                         Machine Maintenance Procedures

  Keyboard Removal                                                                            0

   Prerequisite:
                  Disconnect the power source, and then enter the Shipping Mode by the
                  following SOP if the Refresh and Power     keys remain work.
                  1. Hold the Refresh   and Power     keys at the same time.
                  2. While holding these keys, remove the power cable from the device and
                     then release the keys. The device should shut down and remain off.
                  3. Verify that the battery has been properly disconnected by the pressing
                     the Power key. The device should not be powered on.
                  If the keyboard keys fail to function to enable the Shipping Mode,
                  remove the battery pack to disconnect the power source.
                  Attention!
                  Before removing or installing the keyboard, make sure to complete the
                  Power Down Procedure (Enter Shipping Mode SOP) to avoid damaging
                  the Chromebook.

   1. Carefully flip the top assembly and place it on the surface with the keyboard side
      facing up (Figure 3-14).
   2. Using a flat-headed tool, carefully pry to disengage the bottom side latches of the
      keyboard (A) as shown in Figure 3-14.

                                            A

          Figure 3-14.   Keyboard Removal

Machine Maintenance Procedures                                                         3-15

   3. Carefully lift the bottom part of the keyboard to release it from the top assembly
      (Figure 3-15). The upper latches will automatically disengage as you release the
      keyboard.

          Figure 3-15.   Keyboard Removal

   4. Detach the tape (B) securing the keyboard FPC (Figure 3-16).

                                            B

          Figure 3-16.   Keyboard Removal

3-16                                                     Machine Maintenance Procedures

     5. Disconnect the keyboard FPC from the mainboard connector (C) (Figure 3-17). Then
        remove the keyboard.

                                              C

            Figure 3-17.   Keyboard Removal

 !   CAUTION:
                Keyboard FPC (Flexible Printed Circuit) can be damaged if removed while the
                mainboard connector is locked.

Machine Maintenance Procedures                                                         3-17

  Speaker Module Removal                                                             0

   Prerequisite:
                  Battery Pack Removal

   1. Find the speaker module (A) on the top assembly (Figure 3-18).
   2. Disconnect the speaker cable from the mainboard connector (B) (Figure 3-18).
   3. Unroute the speaker cable (C) from the cable guides (Figure 3-18).

                                                                    B

                                            A

                                            C

          Figure 3-18.   Speaker Module Removal

3-18                                                    Machine Maintenance Procedures

   4. Lift the speakers to release them from the guide pins (D) (Figure 3-19). Then remove
      the speakers from the top assembly.

                       D                                          D

                   D                                                  D

          Figure 3-19.     Speaker Module Removal

Machine Maintenance Procedures                                                        3-19

  USB Board Removal                                                                      0

   Prerequisite:
                   Battery Pack Removal

   1. Remove three (3) screws (A) securing the right LCD hinge (Figure 3-20).

                                         A

           Figure 3-20.   USB Board Removal

   2. Lift the top assembly until it is fully open (Figure 3-21).

           Figure 3-21.   USB Board Removal

3-20                                                        Machine Maintenance Procedures

     3. Close the top assembly and lift the right LCD hinge until it is slightly extended
        (Figure 3-22).

            Figure 3-22.   USB Board Removal

     4. Disconnect the USB board L FFC (B) from the USB board and mainboard connectors
        (Figure 3-23). Then remove it from the top assembly.

                                                    B

            Figure 3-23.   USB Board Removal

 !   CAUTION:
                 USB board L FFC (Flexible Flat Circuit) can be damaged if removed while the
                 USB board and mainboard connectors are locked.

Machine Maintenance Procedures                                                              3-21

     5. Disconnect the USB board H FFC (C) from the USB board and mainboard connectors
        (Figure 3-24). Then remove it from the top assembly.
     6. Remove three (3) screws (D) securing the USB board and I/O bracket (Figure 3-24).

                                                D

                                                      C

            Figure 3-24.   USB Board Removal

 !   CAUTION:
                USB board H FFC (Flexible Flat Circuit) can be damaged if removed while the
                USB board and mainboard connectors are locked.

     7. Release the I/O bracket (E) from the I/O port slot and guide pins (F) on the top
        assembly (Figure 3-25). Then remove the I/O bracket.

                                        F

                                E

            Figure 3-25.   USB Board Removal

3-22                                                        Machine Maintenance Procedures

   8. Release the USB board (G) from the I/O port slots and guide pins (H) on the top
      assembly (Figure 3-26). Then remove the USB board.

                                H

                                      G
                                          WEEE Annex VII Component:
                                          USB Board
                            H

          Figure 3-26.   USB Board Removal

   ID          Size                 Torque            Quantity           Screw Type

   A         M2.5*5.0           3.0±15%kgf-cm             3

   D         M2.0*4.0           2.0+20%kgf-cm             3

Machine Maintenance Procedures                                                          3-23

  LED Board Removal                                                                         0

   Prerequisite:
                  Battery Pack Removal

   1. Detach the mylar (A) securing the LED cable. Then disconnect the cable from the
      mainboard connector (Figure 3-27).
   2. Detach the tape (B) securing the LED board to the mainboard (Figure 3-27).

                                                                B

                                         A

          Figure 3-27.   LED Board Removal

   3. Pry the LED board (C) to release it from the guide tabs (highlighted with the green
      lines) (Figure 3-28). Then remove the LED board.

                                             C

          Figure 3-28.   LED Board Removal

3-24                                                     Machine Maintenance Procedures

   4. Detach the mylar (D) and disconnect the LED cable from the LED board connector (E)
      (Figure 3-29). Then remove the cable.

                                                    E

                                 D

          Figure 3-29.   LED Board Removal

Machine Maintenance Procedures                                                      3-25

  Microphone Board Removal                                                                 0

   Prerequisite:
                 Battery Pack Removal

   1. Detach the mylar (A) securing the microphone cable. Then disconnect the cable from
      the mainboard connector (B) (Figure 3-30).
   2. Remove one (1) screw securing the microphone board (Figure 3-30).

                     B

                                        A

          Figure 3-30.   Microphone Board Removal

3-26                                                   Machine Maintenance Procedures

   3. Slightly pull the microphone board (C) backwards to release it from the guide tab
      (highlighted with the green line) (Figure 3-31). Then remove the microphone board.

                                          C

           Figure 3-31.   Microphone Board Removal

   4. Detach the mylar (D) and disconnect the microphone cable from the microphone
      board connector (E) (Figure 3-32). Then remove the cable.

                                              E

                             D

           Figure 3-32.   Microphone Board Removal

   ID           Size             Torque           Quantity            Screw Type
Red
             M2.0*2.5        2.0+20%kgf-cm           1
Call out

Machine Maintenance Procedures                                                      3-27

  LCD Module Removal                                                                  0

   Prerequisite:
                 Battery Pack Removal

   1. Disconnect the WLAN antennas cables from the WLAN module connectors (A). Then
      unroute the WLAN antennas cables from the cable guides (Figure 3-33).

                                                              A

          Figure 3-33.   LCD Module Removal

3-28                                                Machine Maintenance Procedures

   2. Detach the mylar (B) securing the G-sensor cable. Then disconnect the cable from the
      mainboard connector (C) (Figure 3-34).
   3. Disconnect the eDP cable from the mainboard connector (D). Then unroute the cable
      from the cable guides (Figure 3-34).

                                  C

                                               D
                      B

          Figure 3-34.    LCD Module Removal

   4. Remove six (6) screws securing the LCD hinges (Figure 3-35).

          Figure 3-35.    LCD Module Removal

Machine Maintenance Procedures                                                        3-29

   5. Lift to slightly open the top assembly (Figure 3-36).

          Figure 3-36.   LCD Module Removal

   6. By holding the I/O brackets, continue to fully open the top assembly (Figure 3-37).

          Figure 3-37.   LCD Module Removal

3-30                                                      Machine Maintenance Procedures

     7. Remove the LCD module (E) away from the top assembly (Figure 3-38).

 !   CAUTION:
                Make sure all cables and antennas are moved away from the device to avoid
                damage during removal.

                                                 E

            Figure 3-38.   LCD Module Removal

     ID          Size            Torque           Quantity             Screw Type
Red
              M2.5*5.0        3.0±15%kgf-cm           6
Call out

Machine Maintenance Procedures                                                       3-31

  Mainboard Removal                                                                   0

   Prerequisite:
                  Keyboard Removal

   1. Remove three (3) screws (A) securing the left LCD hinge (Figure 3-39).

                                        A

          Figure 3-39.   Mainboard Removal

   2. Open the top assembly (Figure 3-40).

          Figure 3-40.   Mainboard Removal

3-32                                                     Machine Maintenance Procedures

   3. Lift the left LCD hinge until it is slightly extended (Figure 3-41).

           Figure 3-41.   Mainboard Removal

   4. Disconnect the WLAN antenna cables from the WLAN module connectors (B)
      (Figure 3-42).
   5. Disconnect the microphone cable from the mainboard connector (C) (Figure 3-42).
   6. Disconnect the camera cable from the mainboard connector (D) (Figure 3-42).
   7. Detach the mylar securing the LED cable. Then disconnect the cable from the
      mainboard connector (E) (Figure 3-42).
   8. Detach the tape (F) securing the LED cable to the mainboard (Figure 3-42).
   9. Detach the mylar securing the G-sensor cable. Then disconnect the cable from the
      mainboard connector (G) (Figure 3-42).
   10. Disconnect the eDP cable from the mainboard connector (H) (Figure 3-42).
   11. Disconnect the speaker cable from the mainboard connector (I) (Figure 3-42).
   12. Disconnect the touchpad FFC from the mainboard connector (J) (Figure 3-42).

Machine Maintenance Procedures                                                        3-33

     13. Disconnect the USB board L FFC from the mainboard connector (K) (Figure 3-42).

 !   CAUTION:
                Touchpad FFC (Flexible Flat Circuit) and USB board L FFC, can be damaged if
                removed while the mainboard connectors are locked.

                                               F
                           C
                       B               D      E       G

                                                              H

                                                                      I
                               K J

            Figure 3-42.       Mainboard Removal

     14. Remove seven (7) screws (L) securing the mainboard and I/O bracket (Figure 3-43).
     15. Disconnect the USB board H FFC from the mainboard connector (M) (Figure 3-43).

                           L

                                                                      L
                       M                      L

            Figure 3-43.       Mainboard Removal

 !   CAUTION:
                USB board H FFC (Flexible Flat Circuit) can be damaged if removed while the
                mainboard connector is locked.

3-34                                                      Machine Maintenance Procedures

   16. Release the I/O bracket (N) from the I/O port slot and guide pins (O) on the top
       assembly (Figure 3-44). Then remove the I/O bracket.

                                                   O

                                                           N

                                                       O

          Figure 3-44.   Mainboard Removal

   17. Release the mainboard (P) from the I/O ports slots and guide pins (Q) on the top
       assembly (Figure 3-45). Then remove the mainboard.

                                    WEEE Annex VII Component:
                                    Mainboard

                                       Q

                                               P

                                                       Q

          Figure 3-45.   Mainboard Removal

Machine Maintenance Procedures                                                            3-35

           Figure 3-46.   Mainboard

+ IMPORTANT:
                  Circuit boards >10 cm² have been highlighted with a yellow rectangle as
                  shown in Figure 3-46. Remove the circuit board and follow local
                  regulations for disposal.

   ID           Size              Torque             Quantity           Screw Type

       A     M2.5*5.0         3.0±15%kgf-cm               3

       L     M2.0*4.0         2.0+20%kgf-cm               7

3-36                                                    Machine Maintenance Procedures

  Top Camera Module Removal                                                                0

   Prerequisite:
                 LED Board Removal and Microphone Board Removal

   1. Disconnect the camera cable from the mainboard connector (A) (Figure 3-47).
   2. Remove two (2) screws securing the camera module assembly (Figure 3-47).

                                                A

          Figure 3-47.   Top Camera Module Removal

   3. Release the camera module assembly (B) from the guide pins (C) on the top assembly
      (Figure 3-48). Then remove the camera module assembly.

                                                B                 C
                                       C

          Figure 3-48.   Top Camera Module Removal

Machine Maintenance Procedures                                                      3-37

   4. Carefully detach and remove the camera module (D) from its holder (Figure 3-49).

                                    D

           Figure 3-49.   Top Camera Module Removal

   ID           Size            Torque           Quantity              Screw Type
Red
             M2.0*4.0        2.0+20%kgf-cm            2
Call out

3-38                                                      Machine Maintenance Procedures

  Top Assembly Removal                                                          0

   Prerequisite:
                 Touchpad Module Removal, Speaker Module Removal,
                 USB Board Removal, LCD Module Removal, Mainboard Removal,
                 and Top Camera Module Removal

          Figure 3-50.   Top Assembly

Machine Maintenance Procedures                                               3-39

LCD Module Disassembly Process                                                                      0

  LCD Module Disassembly Flowchart                                                                  0

                                                LCD Module

                                                LCD Panel

                                                        G-Sensor
                        LCD Hinge     Camera Module                     eDP Cable
                                                         Board

                       WLAN Antenna

   Table 3-3.   LCD Module Screw List
            Step                         Size                  Quantity             Acer Part No.
LCD Hinges Removal                    M2.5*2.5                      6               86.GWGN7.001

3-40                                                               Machine Maintenance Procedures

  LCD Panel Removal                                                                    0

   Prerequisite:
                  LCD Module Removal

   1. Pry the LCD panel from the upper side to release the latches (Figure 3-51).

          Figure 3-51.   LCD Panel Removal

   2. Continue prying the latches on the right side of the LCD panel as shown in
      Figure 3-52.

          Figure 3-52.   LCD Panel Removal

Machine Maintenance Procedures                                                      3-41

   3. Pry the latches on the left side of the LCD panel as shown in Figure 3-53.

          Figure 3-53.   LCD Panel Removal

   4. Continue prying the remaining latches on the bottom side of the LCD panel as shown
      in Figure 3-54.

          Figure 3-54.   LCD Panel Removal

3-42                                                     Machine Maintenance Procedures

   5. Release the eDP cable (A) from the left hinge cap (Figure 3-55). Then remove the LCD
      panel (B).

                               WEEE Annex VII Component:
                               LCD Panel
                                             B

                                       A

          Figure 3-55.   LCD Panel Removal

Machine Maintenance Procedures                                                        3-43

  LCD Hinges Removal                                                                       0

   Prerequisite:
                  LCD Panel Removal

   1. Release the WLAN antennas cables from the right hinge cap as shown in Figure 3-56.

          Figure 3-56.   LCD Hinges Removal

   2. Remove six (6) screws securing the LCD hinges to the LCD cover (Figure 3-57).

          Figure 3-57.   LCD Hinges Removal

3-44                                                    Machine Maintenance Procedures

   3. Release the LCD hinges (A) from the guide pins (B) on the LCD cover (Figure 3-58).
      Then remove the LCD hinges.

                       B                                          B

                                              A

           Figure 3-58.    LCD Hinges Removal

   ID           Size             Torque           Quantity             Screw Type
Red
             M2.5*2.5         3.0±15%kgf-cm           6
Call out

Machine Maintenance Procedures                                                        3-45

  Camera Module Removal                                                                     0

   Prerequisite:
                   LCD Panel Removal
       NOTE:   NOTE:
          Please take note that the eDP cable includes the LCD panel cable, camera cable,
          and G-sensor cable.

   1. Find the camera module (A) on the LCD bezel (Figure 3-59).

                                             A

           Figure 3-59.   Camera Module Removal

3-46                                                     Machine Maintenance Procedures

   2. Lift the camera module to release it from the guide pins (B) (Figure 3-60). Then
      remove the camera module from the LCD bezel.

                                                       B

                          B

          Figure 3-60.   Camera Module Removal

   3. Disconnect the eDP cable from the camera module connector (C) (Figure 3-61).

                                                       C

          Figure 3-61.   Camera Module Removal

Machine Maintenance Procedures                                                           3-47

   4. Carefully detach the microphone rubbers (D) from the camera module (Figure 3-62).

                   D                                            D

          Figure 3-62.   Camera Module Removal

3-48                                                  Machine Maintenance Procedures

  G-Sensor Board Removal                                                                   0

   Prerequisite:
                  LCD Panel Removal
    NOTE:     NOTE:
         Please take note that the eDP cable includes the LCD panel cable, camera cable,
         and G-sensor cable.

   1. Find the G-sensor board (A) on the LCD bezel (Figure 3-63).

                                                         A

          Figure 3-63.   G-Sensor Board Removal

Machine Maintenance Procedures                                                        3-49

   2. Disconnect the eDP cable from the G-sensor board connector (B). Then unroute the
      cable from the cable guides (Figure 3-64).

                                                    B

          Figure 3-64.   G-Sensor Board Removal

   3. Pry to remove the G-sensor board from the LCD bezel (Figure 3-65).

          Figure 3-65.   G-Sensor Board Removal

3-50                                                    Machine Maintenance Procedures

  eDP Cable Removal                                                                          0

   Prerequisite:
                  LCD Panel Removal
    NOTE:     NOTE:
         Please take note that the eDP cable includes the LCD panel cable, camera cable,
         and G-sensor cable.

   1. Lift the camera module (A) to release it from the guide pins (B) (Figure 3-66). Then
      remove the camera module from the LCD bezel.

                                                        B
                                         A
                           B

          Figure 3-66.   eDP Cable Removal

Machine Maintenance Procedures                                                          3-51

   2. Disconnect the eDP cable from the camera module connector (C) (Figure 3-67).

                                                     C

          Figure 3-67.   eDP Cable Removal

   3. Disconnect the eDP cable from the G-sensor board connector (D). Then unroute the
      cable from the cable guides (Figure 3-68).

                                                    D

          Figure 3-68.   eDP Cable Removal

3-52                                                     Machine Maintenance Procedures

   4. Unroute the eDP cable (E) from the cable guides on the LCD bezel and LCD panel as
      shown in Figure 3-69. Carefully detach the cable from its underneath adhesive.

                                                      E

          Figure 3-69.   eDP Cable Removal

   5. Detach the mylar tape (F) securing the eDP cable to the LCD panel (Figure 3-70).

                                             F

          Figure 3-70.   eDP Cable Removal

Machine Maintenance Procedures                                                           3-53

   6. Lift the latch (G) securing the eDP cable (Figure 3-71).

                                             G

          Figure 3-71.   eDP Cable Removal

   7. Disconnect the eDP cable from the LCD panel connector (H) (Figure 3-72). Then
      remove the LCD panel.

                                               H

          Figure 3-72.   eDP Cable Removal

3-54                                                       Machine Maintenance Procedures

  WLAN Antenna Removal                                                                   0

   Prerequisite:
                 LCD Hinges Removal

   1. Unroute the WLAN antennas cables from the cable guides on the LCD cover as shown
      in Figure 3-73.

          Figure 3-73.   WLAN Antenna Removal

Machine Maintenance Procedures                                                    3-55

     2. Gently peel off the MAIN antenna and its grounding foil (Figure 3-74). Then remove
        the MAIN antenna from the LCD cover.

 !   CAUTION:
                Use care not to damage the antenna PCB circuit area when the grounding
                foil is removed.

                                              MAIN

            Figure 3-74.   WLAN Antenna Removal

     3. Gently peel off the AUX antenna and its grounding foil (Figure 3-75). Then remove
        the AUX antenna from the LCD cover.

                                    AUX

            Figure 3-75.   WLAN Antenna Removal

 !   CAUTION:
                Use care not to damage the antenna PCB circuit area when the grounding
                foil is removed.

3-56                                                     Machine Maintenance Procedures

LCD Module Reassembly Process                                                              0

  Replacing the WLAN Antenna                                                               0

   1. Place the AUX antenna to the left side of the LCD cover. Make sure the antenna PCB
      circuit area is properly seated and placed onto its compartment highlighted by a
      green rectangle as shown in Figure 3-76.
   2. Adhere the grounding foil of the AUX antenna as marked in yellow (Figure 3-76).

                                    AUX

          Figure 3-76.   Replacing the AUX Antenna

Machine Maintenance Procedures                                                      3-57

   3. Place the MAIN antenna to the right side of the LCD cover. Make sure the antenna
      PCB circuit area is properly seated and placed onto its compartment highlighted by a
      green rectangle as shown in Figure 3-77.
   4. Adhere the grounding foil of the MAIN antenna as marked in yellow (Figure 3-77).

                                            MAIN

          Figure 3-77.   Replacing the MAIN Antenna

   5. Route the WLAN antennas cables through the cable guides on the LCD cover as
      shown in Figure 3-78.

          Figure 3-78.   Replacing the WLAN Antenna

3-58                                                    Machine Maintenance Procedures

  Replacing the eDP Cable                                                                0

    NOTE:     NOTE:
         The eDP cable includes the LCD panel cable, camera cable, and G-sensor cable.

   1. Connect the eDP cable to the LCD panel connector (A) (Figure 3-79).

                                             A

          Figure 3-79.   Replacing the eDP Cable

   2. Push the latch (B) down to secure the eDP cable in place (Figure 3-80).

                                            B

          Figure 3-80.   Replacing the eDP Cable

Machine Maintenance Procedures                                                       3-59

   3. Adhere the mylar tape (C) to secure the eDP cable to the LCD panel (Figure 3-81).

                                           C

          Figure 3-81.   Replacing the eDP Cable

   4. Connect the eDP cable to the camera module connector (D) (Figure 3-81).

                                                          D

          Figure 3-82.   Replacing the eDP Cable

3-60                                                    Machine Maintenance Procedures

   5. By aligning with the guide pins (E), install the camera module (F) onto its
      compartment on the LCD bezel (Figure 3-83).
   6. Route and attach the eDP cable through the cable guides on the LCD bezel and LCD
      panel as shown in Figure 3-83.

                                                        E
                           E
                                          F

          Figure 3-83.   Replacing the eDP Cable

   7. Starting from the upper part (highlighted with the green line), route the eDP cable
      (G) through the cable guides as shown in Figure 3-84. Then press and straighten the
      cable to ensure its underneath adhesive is properly attached to the LCD panel.

                                                        G

          Figure 3-84.   Replacing the eDP Cable

    NOTE:     NOTE:
         During cable routing, ensure that the bottom portion of the eDP cable is also
         properly aligned with the highlighted with the green line as shown in Figure 3-84.

Machine Maintenance Procedures                                                        3-61

   8. Route the eDP cable through the cable guides on the LCD bezel. Then connect the
      cable to the G-sensor board connector (H) (Figure 3-85).
   9. Continue to route another portion of the eDP cable through the cable guides as
      shown in Figure 3-85.

                                                    H

          Figure 3-85.   Replacing the eDP Cable

3-62                                                    Machine Maintenance Procedures

  Replacing the G-Sensor Board                                                           0

    NOTE:     NOTE:
         The eDP cable includes the LCD panel cable, camera cable, and G-sensor cable.

   1. By aligning with the guide pin (A), install the G-sensor board (B) onto its
      compartment on the LCD bezel (Figure 3-86).

                                                     A

                                               B

          Figure 3-86.   Replacing the G-Sensor Board

   2. Route the eDP cable through the cable guides on the LCD bezel. Then connect the
      cable to the G-sensor board connector (C) (Figure 3-87).

                                                       C

          Figure 3-87.   Replacing the G-Sensor Board

Machine Maintenance Procedures                                                       3-63

  Replacing the Camera Module                                                               0

       NOTE:   NOTE:
          The eDP cable includes the LCD panel cable, camera cable, and G-sensor cable.

   1. Install the microphone rubbers (A) onto their respective slots on the camera module
      (Figure 3-88).

                    A                                               A

           Figure 3-88.   Replacing the Camera Module

   2. Connect the eDP cable to the camera module connector (B) (Figure 3-89).

                                                        B

           Figure 3-89.   Replacing the Camera Module

3-64                                                        Machine Maintenance Procedures

   3. By aligning with the guide pins (C), install the camera module (D) onto its
      compartment on the LCD bezel (Figure 3-90).

                                                        C
                                          D
                          C

          Figure 3-90.   Replacing the Camera Module

Machine Maintenance Procedures                                                      3-65

  Replacing the LCD Hinges                                                                     0

   1. Place the LCD hinges (A) on the LCD cover (Figure 3-91).
+ IMPORTANT:
                   When installing the LCD hinges, make sure they are properly aligned with
                   the guide pins (B) and placed onto their designated locations as shown in
                   Figure 3-91.

                       B                                              B

                                              A

           Figure 3-91.    Replacing the LCD Hinges

   2. Install six (6) screws to secure the LCD hinges in place (Figure 3-92).

           Figure 3-92.    Replacing the LCD Hinges

3-66                                                       Machine Maintenance Procedures

   3. Insert the WLAN antennas cables into the right hinge cap as shown in Figure 3-93.

           Figure 3-93.   Replacing the LCD Hinges

   ID           Size             Torque              Quantity         Screw Type
Red
             M2.5*2.5        3.0±15%kgf-cm              6
Call out

Machine Maintenance Procedures                                                       3-67

  Replacing the LCD Panel                                                                    0

   1. Insert the eDP cable (A) into the left hinge cap as shown in Figure 3-94. Then align
      and place the LCD panel (B) on the LCD cover.

                                              B

                                       A

          Figure 3-94.   Replacing the LCD Panel

3-68                                                     Machine Maintenance Procedures

     2. Start pressing along the bottom side (C) of the LCD panel to secure the latches to the
        LCD cover (Figure 3-95).
     3. Continue pressing upward along the left and right sides (D) of the LCD panel to
        engage the latches (Figure 3-95).
     4. Finally, press along the upper side (E) of the LCD panel to fully secure the panel to
        the LCD cover (Figure 3-95).
     NOTE:      NOTE:
           When pressing on the latches, make sure to follow the direction of the arrows
           (Figure 3-95).

                                               E

                  D                                                        D

                                               C

            Figure 3-95.   Replacing the LCD Panel

 !   CAUTION:
                 Use care not to damage all cables during LCD panel installation.

Machine Maintenance Procedures                                                             3-69

Main Unit Reassembly Process                                      0

  Replacing the Top Assembly                                      0

       Figure 3-96.   Top Assembly

3-70                                 Machine Maintenance Procedures

  Replacing the Top Camera Module                                                              0

   1. Install the camera module (A) onto its slot on the camera module holder
      (Figure 3-97).

                                     A

          Figure 3-97.   Replacing the Top Camera Module

   2. Install the camera module assembly (B) onto its compartment on the top assembly
      (Figure 3-98).

                                                  B                 C
                                         C

          Figure 3-98.   Replacing the Top Camera Module

+ IMPORTANT:
                  When installing the camera module assembly, make sure it is properly
                  aligned with the guide pins (C) and placed onto its designated location as
                  shown in Figure 3-98.

Machine Maintenance Procedures                                                          3-71

   3. Install two (2) screws to secure the camera module assembly in place (Figure 3-99).
   4. Connect the camera cable to the mainboard connector (D) (Figure 3-99).

                                                  D

           Figure 3-99.   Replacing the Top Camera Module

   ID           Size             Torque           Quantity              Screw Type
Red
             M2.0*4.0        2.0+20%kgf-cm            2
Call out

3-72                                                      Machine Maintenance Procedures

  Replacing the Mainboard                                                                       0

   1. Attach the thermal pad (A) on the top assembly (Figure 3-100).

                                           A

          Figure 3-100.   Replacing the Mainboard

   2. Align and slide the I/O ports on the mainboard (B) into their slots on the top assembly
      (Figure 3-101).
   3. Place the mainboard onto its compartment until it is fully seated and secured to the
      guide pins (C) (Figure 3-101).

                                       C

                                               B

                                                      C

          Figure 3-101.   Replacing the Mainboard

Machine Maintenance Procedures                                                           3-73

 !   CAUTION:
                Make sure all cables, FFCs, and FPC are moved away from the mainboard
                during installation.

     4. By aligning with the I/O port slot, slide and install the I/O bracket (D) onto the
        mainboard. Ensure that the bracket is fully seated and secured to the guide pins (E)
        (Figure 3-102).

                                                    E

                                                            D

                                                        E

            Figure 3-102.    Replacing the Mainboard

     5. Install seven (7) screws (F) to secure the mainboard and I/O bracket in place
        (Figure 3-103).

     6. Connect the USB board H FFC to the mainboard connector (G) (Figure 3-103).

                         F

                                                                          F
                        G                    F

            Figure 3-103.    Replacing the Mainboard

3-74                                                            Machine Maintenance Procedures

    NOTE:     NOTE:
         Make sure that the USB board H FFC is firmly secured to the mainboard connector.

   7. Connect the WLAN antenna cables to the WLAN module connectors (H)
      (Figure 3-104).
   8. Connect the microphone cable to the mainboard connector (I) (Figure 3-104).
   9. Connect the camera cable to the mainboard connector (J) (Figure 3-104).
   10. Connect the LED cable to the mainboard connector (K). Then attach the mylar to
       secure the cable connection (Figure 3-104).
   11. Attach the tape (L) to secure the LED cable in place (Figure 3-104).
   12. Connect the G-sensor cable to the mainboard connector (M). Then attach the mylar
       to secure the cable connection (Figure 3-104).
   13. Connect the eDP cable to the mainboard connector (N) (Figure 3-104).
   14. Connect the speaker cable to the mainboard connector (O) (Figure 3-104).
   15. Connect the touchpad FFC to the mainboard connector (P) (Figure 3-104).
   16. Connect the USB board L FFC to the mainboard connector (Q) (Figure 3-104).

                                               L
                          I
                      H              J        K         M

                                                              N

                                                                      O
                              Q P

          Figure 3-104.       Replacing the Mainboard

    NOTE:     NOTE:
         Make sure that the touchpad FFC and USB board L FFC are firmly secured to the
         mainboard connectors.

Machine Maintenance Procedures                                                      3-75

   17. Close the left LCD hinge until it is fully seated in place (Figure 3-105).

           Figure 3-105.   Replacing the Mainboard

   18. Install three (3) screws (R) to secure the left LCD hinge in place (Figure 3-106).

                                           R

           Figure 3-106.   Replacing the Mainboard

   ID           Size                 Torque               Quantity             Screw Type

       F      M2.0*4.0          2.0+20%kgf-cm                  7

       R      M2.5*5.0          3.0±15%kgf-cm                  3

3-76                                                         Machine Maintenance Procedures

  Replacing the LCD Module                                                                 0

   1. By holding the top assembly upright and the keyboard is facing you, align the top
      assembly with the LCD hinges slots on the LCD module (A) as shown in Figure 3-107.

                                               A

          Figure 3-107.   Replacing the LCD Module

   2. By holding the I/O brackets, close the top assembly (Figure 3-108).

          Figure 3-108.   Replacing the LCD Module

Machine Maintenance Procedures                                                      3-77

   3. Install six (6) screws to secure the LCD hinges in place (Figure 3-109).

           Figure 3-109.   Replacing the LCD Module

   4. Route and secure the eDP cable along the cable guides on the top assembly. Then
      connect the eDP cable to the mainboard connector (B) (Figure 3-110).
   5. Connect the G-sensor cable to the mainboard connector (C). Then attach the mylar
      (D) to secure the cable connection (Figure 3-110).

                                   C

                                                 B
                       D

           Figure 3-110.   Replacing the LCD Module

3-78                                                       Machine Maintenance Procedures

   6. Route and secure the WLAN antenna cables along the cable guides on the top
      assembly (Figure 3-111).
   7. Connect the WLAN antennas cables to the WLAN module connectors (E)
      (Figure 3-111).

                                                               E

           Figure 3-111.   Replacing the LCD Module

   ID           Size             Torque          Quantity           Screw Type
Red
             M2.5*5.0        3.0±15%kgf-cm            6
Call out

Machine Maintenance Procedures                                                     3-79

  Replacing the Microphone Board                                                            0

   1. Connect the microphone cable to the microphone board connector (A). Then attach
      the mylar (B) to secure the cable connection (Figure 3-112).

                                               A

                             B

          Figure 3-112.   Replacing the Microphone Board

   2. Slide the microphone board (C) into the guide tab (highlighted with the green line)
      until it is fully engaged (Figure 3-113).

                                           C

          Figure 3-113.   Replacing the Microphone Board

3-80                                                    Machine Maintenance Procedures

   3. Install one (1) screw to secure the microphone board in place (Figure 3-114).
   4. Connect the microphone cable to the mainboard connector (D). Then attach the
      mylar (E) to secure the cable connection (Figure 3-114).

                       D

                                          E

           Figure 3-114.   Replacing the Microphone Board

   ID           Size             Torque           Quantity              Screw Type
Red
             M2.0*2.5        2.0+20%kgf-cm            1
Call out

Machine Maintenance Procedures                                                        3-81

  Replacing the LED Board                                                                    0

   1. Connect the LED cable to the LED board connector (A). Then attach the mylar (B) to
      secure the cable connection (Figure 3-115).

                                                       A

                                   B

          Figure 3-115.   Replacing the LED Board

   2. Slide the LED board (C) into the guide tab (D). Then press the right side of the LED
      board until it is fully seated into the guide tab (E) (Figure 3-116).

                                       D       E

                                           C

          Figure 3-116.   Replacing the LED Board

3-82                                                       Machine Maintenance Procedures

   3. Connect the LED cable to the mainboard connector. Then attach the mylar (F) to
      secure the cable connection (Figure 3-117).
   4. Attach the tape (G) to secure the LED cable in place (Figure 3-117).

                                                                 G

                                         F

          Figure 3-117.   Replacing the LED Board

Machine Maintenance Procedures                                                         3-83

  Replacing the USB Board                                                                       0

   1. Align and slide the I/O ports on the USB board (A) into their slots on the top assembly
      (Figure 3-118).
   2. Place the USB board onto its compartment until it is fully seated and secured to the
      guide pins (B) (Figure 3-118).

                                 B

                                      A

                             B

          Figure 3-118.   Replacing the USB Board

   3. By aligning with the I/O port slot, slide and install the I/O bracket (C) onto the USB
      board. Ensure that the bracket is fully seated and secured to the guide pins (D)
      (Figure 3-119).

                                      D

                                 C

          Figure 3-119.   Replacing the USB Board

3-84                                                       Machine Maintenance Procedures

   4. Install three (3) screws (E) to secure the USB board and I/O bracket in place
      (Figure 3-120).
   5. Connect the USB board H FFC (F) to the mainboard and USB board connectors
      (Figure 3-120).

                                              E

                                                      F

          Figure 3-120.   Replacing the USB Board

    NOTE:     NOTE:
         Make sure that the USB board H FFC is firmly secured to the mainboard and USB
         board connectors.

   6. Connect the USB board L FFC (G) to the mainboard and USB board connectors
      (Figure 3-121).

                                                  G

          Figure 3-121.   Replacing the USB Board

Machine Maintenance Procedures                                                        3-85

       NOTE:   NOTE:
          Make sure that the USB board L FFC is firmly secured to the mainboard and USB
          board connectors.

   7. Close the right LCD hinge until it is fully seated in place (Figure 3-122).

           Figure 3-122.   Replacing the USB Board

   8. Install three (3) screws (H) to secure the right LCD hinge in place (Figure 3-123).

                                        H

           Figure 3-123.   Replacing the USB Board

3-86                                                        Machine Maintenance Procedures

   ID         Size               Torque     Quantity   Screw Type

    E       M2.0*4.0        2.0+20%kgf-cm      3

   H        M2.5*5.0        3.0±15%kgf-cm      3

Machine Maintenance Procedures                                      3-87

  Replacing the Speaker Module                                                                0

   1. Place the speakers (A) to their respective compartments on the top assembly
      (Figure 3-124).

                      B                                           B
                                            A

                  B                                                   B

          Figure 3-124.   Replacing the Speaker Module

+ IMPORTANT:
                  When installing the speakers, make sure there are properly aligned with
                  the guide pins (B) and placed onto their designated locations as shown in
                  Figure 3-124.

3-88                                                     Machine Maintenance Procedures

   2. Route the speaker cable (C) through the cable guides on the top assembly
      (Figure 3-125).
   3. Connect the speaker cable to the mainboard connector (D) (Figure 3-125).

                                                                  D

                                            C

          Figure 3-125.   Replacing the Speaker Module

Machine Maintenance Procedures                                                   3-89

  Replacing the Keyboard                                                                  0

   1. Connect the keyboard FPC to the mainboard connector (A) (Figure 3-126).

                                           A

           Figure 3-126.   Replacing the Keyboard

       NOTE:   NOTE:
          Make sure that the keyboard FPC is firmly secured to the mainboard connector.

   2. Detach the tape (B) to secure the keyboard FPC connection (Figure 3-127).

                                            B

           Figure 3-127.   Replacing the Keyboard

3-90                                                    Machine Maintenance Procedures

   3. Insert the bottom side latches of the keyboard (C) into the slots on the top assembly
      (Figure 3-128).

                                            C

          Figure 3-128.   Replacing the Keyboard

   4. Press all edges of the keyboard firmly to secure the latches. Make sure they are fully
      engaged (Figure 3-129).

          Figure 3-129.   Replacing the Keyboard

Machine Maintenance Procedures                                                          3-91

  Replacing the Touchpad Module                                                                0

   1. Slide the touchpad module (A) into the bottom latches (B) until those are fully
      engaged (Figure 3-130).
   2. Ensure that the touchpad module is properly aligned with the guide pins (C), push
      the touchpad module firmly onto its slot until it is fully seated in place (Figure 3-130).

                               C            C                 C

                                                A

                           B                                       B

           Figure 3-130.   Replacing the Touchpad Module

   3. Install three (3) screws to secure the touchpad module in place (Figure 3-131).

           Figure 3-131.   Replacing the Touchpad Module

3-92                                                       Machine Maintenance Procedures

   4. Attach the conductive tape (D) onto the touchpad module. Make sure the conductive
      tape is properly aligned and placed onto its slot highlighted by the yellow and green
      lines as shown in Figure 3-132.

                                             D

          Figure 3-132.   Replacing the Touchpad Module

   5. Connect the touchpad FFC (E) to the touchpad module and mainboard connectors
      Then press the middle portion of the FFC to ensure its underneath adhesive is
      properly attached to the top assembly (Figure 3-133).

                                            E

          Figure 3-133.   Replacing the Touchpad Module

    NOTE:     NOTE:
         Make sure that the touchpad FFC is firmly secured to the mainboard and touchpad
         module connectors.

Machine Maintenance Procedures                                                         3-93

   6. Attach the adhesive tape (F) to secure the touchpad FFC connection (Figure 3-134).

                                             F

           Figure 3-134.   Replacing the Touchpad Module

   ID           Size            Torque           Quantity              Screw Type
Red
             M2.0*2.5        2.0+20%kgf-cm           3
Call out

3-94                                                     Machine Maintenance Procedures

  Replacing the Battery Pack                                                                  0

   1. By aligning with the guide pins (A), place the battery pack (B) to its compartment on
      the system (Figure 3-135).

                 A                                                      A

                                      B

          Figure 3-135.   Replacing the Battery Pack

   2. Connect the battery cable to the mainboard connector (C) (Figure 3-136).

                                                           C

          Figure 3-136.   Replacing the Battery Pack

Machine Maintenance Procedures                                                         3-95

   3. Attach the acetate tape (D) to secure the battery cable to the mainboard connector
      (Figure 3-137).
   4. Attach the transparent mylar (E) to secure the battery cable in place (Figure 3-137).

                                                          D
                                                  E

          Figure 3-137.   Replacing the Battery Pack

3-96                                                      Machine Maintenance Procedures

  Replacing the Base Cover                                                                0

   1. Carefully place the base cover onto the top assembly. Make sure that the edges of
      the base cover are aligned properly to those of the top assembly (Figure 3-138).

          Figure 3-138.   Replacing the Base Cover

   2. Press downward on the system to engage the tabs. Make sure all the tabs are fully
      engaged (Figure 3-139).

          Figure 3-139.   Replacing the Base Cover

Machine Maintenance Procedures                                                       3-97

   3. Install eleven (11) screws to secure the base cover in place. Then install another two
      (2) screws to secure the keyboard (Figure 3-140).

           Figure 3-140.   Replacing the Base Cover

   ID           Size             Torque            Quantity              Screw Type
Orange
             M2.0*5.5        2.0+20%kgf-cm       2 (keyboard)
Call out
Red
             M2.5*7.0        3.0±15%kgf-cm      11 (base cover)
Call out

3-98                                                      Machine Maintenance Procedures

CHAPTER 4
Troubleshooting

      Introduction . . . . . . . . . . . . . . . . . . . . . . . . . . . . . . . . . . . . . . . . . 4-3
      General Information . . . . . . . . . . . . . . . . . . . . . . . . . . . . . . . . . . 4-3
          Power On Issues . . . . . . . . . . . . . . . . . . . . . . . . . . . . . . . . . . . .4-4
          No Display Issues. . . . . . . . . . . . . . . . . . . . . . . . . . . . . . . . . . . .4-5
          LCD Picture Failure . . . . . . . . . . . . . . . . . . . . . . . . . . . . . . . . . .4-7
          Internal Keyboard Failure . . . . . . . . . . . . . . . . . . . . . . . . . . . .4-8
          Touch Pad Failure . . . . . . . . . . . . . . . . . . . . . . . . . . . . . . . . . . .4-9
          Internal Speaker Failure. . . . . . . . . . . . . . . . . . . . . . . . . . . . . .4-10
          Audio Codec Failure . . . . . . . . . . . . . . . . . . . . . . . . . . . . . . . . .4-12
          Other Functions Failure . . . . . . . . . . . . . . . . . . . . . . . . . . . . . .4-13
      Intermittent Problems . . . . . . . . . . . . . . . . . . . . . . . . . . . . . . . . . 4-14
      Undetermined Problems . . . . . . . . . . . . . . . . . . . . . . . . . . . . . . . 4-14

4-2

Troubleshooting

Introduction                                                                                    0

    This chapter contains information about troubleshooting common problems associated
    with the notebook.

General Information                                                                             0

    The following procedures are a guide for troubleshooting computer problems. The step
    by step procedures are designed to be performed as described.
    NOTE:      NOTE:
         The diagnostic tests are intended for Acer products only. Non-Acer products,
         prototype cards, or modified options can give false errors and invalid system
         responses.
   1. Obtain as much detailed information as possible about the problem.
   2. If possible, verify the symptoms by re-creating the failure through diagnostic tests or
      repeating the operation that led to the problem.
   3. Use Table 4-1 with the verified symptom to determine the solution.

                             Table 4-1.   Common Problems

                                    Symptoms (Verified)
                         Power On Issues
                         No Display Issues
                         LCD Picture Failure
                         Internal Keyboard Failure
                         Touch Pad Failure
                         Internal Speaker Failure
                         Audio Codec Failure
                         Other Functions Failure
                         Intermittent Problems
                         Undetermined Problems

   4. If the Issue is still not resolved, refer to Online Support Information.
    NOTE:      NOTE:
         Do not replace non-defective FRU parts.

Troubleshooting                                                                           4-3

  Power On Issues                                              0

      If the system does not power on, perform the following:

                                   Start

                                                   OK

                                  Check            NG
                                AC/Battery                     Swap AC /Battery
                                 Power on                           to try

                                 OK                OK

                                   Check
                                 Daughter/B        NG         Remove daughter/B
                               & FFC Whether                 Re-plug AC PWR only
                                    OK

                                 Swap M/B

              Figure 4-1.   Power On Issue

        Computer Shuts Down Intermittently                                                        0

      If the system powers off at intervals, perform the following.
      1. Makes sure the power cable is properly connected to the computer and the electrical
         outlet.
      2. Remove all extension cables between the computer and the outlet.
      3. Remove all surge protectors between the computer and the electrical outlet. Plug the
         computer directly into a known serviceable electrical outlet.
      4. Remove all external and non-essential hardware connected to the computer that are
         not necessary to boot the computer to the failure point.
      5. Remove any recently installed software.
      6. If the Issue is still not resolved, refer to Online Support Information.

4-4                                                                                 Troubleshooting

  No Display Issues                                             0

    If the Display does not work, perform the following:

                                                        Start

         Replace
                      NO          LCD module                         NO         Goto no Power
        LCD panel/                                   Power on ?
        LCD cable                    OK?                                     trouble shooting step

                                                    Ext. DDR RAM     NO            Connect
                                                     module well                    it well
                                                     connected?

                                                                     NO            Replace
                                                    Ext. DDR RAM                Ext.DDR RAM
                                                     module OK?                    module

                                                     CPU thermal     NO
                                   Replace                                       Screw it well
                                                     module well
                                    M/B
                                                       screw?

            Figure 4-2.    No Display Issue

     No POST or Video                                                                                0

    If the POST or video does not appear, perform the following:
   1. Make sure that internal display is selected. Reference product pages for specific
      model procedures on how to switch between the internal display and the external
      display.
   2. Make sure the computer has been turned on.
    If no power, refer to Power On Issues.
   3. Turn off the Chromebook. Remove the power cable, and then plug it back in. Then
      perform the hard reset.
   4. Connect an external monitor to the computer and switch between the internal
      display and the external display.

    NOTE:        NOTE:
          If you've connected an external monitor, the screen will only appear on the
          external monitor. If you've connected a projector, the screen will be displayed on
          both your Chromebook and via the projector.
   5. If the POST or video appears on the external display only, refer to LCD Picture Failure.

Troubleshooting                                                                                  4-5

      6. Disconnect power and all external devices including port replicators or docking
         stations. Remove any memory cards.
      7. Start the computer. If the computer boots correctly, add the devices one by one until
         the failure point is discovered.
      8. If the Issue is still not resolved, refer to Online Support Information.

        Abnormal Video                                                                              0

      If the video appears abnormal, perform the following:
      1. Boot the computer.
          If permanent vertical/horizontal lines or dark spots appear in the same location,
            the LCD is faulty and should be replaced. Refer to Disassembly Process.
          If extensive pixel damage is present (different colored spots in the same locations
            on the screen), the LCD is faulty and should be replaced. Refer to LCD Module
            Removal and Replacing the LCD Module.
      NOTE:       NOTE:
            Make sure that the computer is not running on battery alone as this may reduce
            display brightness.
      2. Adjust the brightness to its highest level. Refer to the User Manual for instructions on
         adjusting the settings. If the display is too dim at the highest brightness setting, the
         LCD is faulty and should be replaced. Refer to Disassembly Process.
      3. Check the display resolution is correctly configured:
          Minimize or close all Windows.

          If display size is only abnormal in an application, check the view settings and
            control/mouse wheel zoom feature in the application.
          If the Chromebook display resolution is not normal, click the status area where
            your account picture appears.
          Click Settings > Display      Settings.
          Click on the Resolution drop-down menu to choose the desired resolution.

          Check the display again. Readjust if necessary.
      4. Roll back the video driver to the previous version if updated.
      5. Remove and reinstall the video driver.
      6. Run the Diagnostic test and follow the on-screen prompts, refer to Key Component
         Replacement and HWID Re-configuration.
      7. If the Issue is still not resolved, refer to Online Support Information.

4-6                                                                                 Troubleshooting

  LCD Picture Failure                                 0

    If the LCD fails, perform the following:

                                Start

                                               OK

                                               NG         Swap
                          Check LCD module?         LCD cable /LCD panel

                              OK               OK

                              Check MB         NG       Reassemble
                            LCD connector
                                                     Re-plug LCD cable
                             and cable ?

                              Swap M/B

           Figure 4-3.   LCD Failure

Troubleshooting                                                            4-7

  Internal Keyboard Failure                                    0

      If the internal keyboard fails, perform the following:

                                   Start

                                                  OK

                              Keyboard FPC        NG
                                                                   Connect it well
                              Well connected?

                                 OK               OK

                                                  NG
                              Keyboard OK?                     Replace keyboard

                               Replace M/B

             Figure 4-4.   Internal Keyboard Failure

4-8                                                                                  Troubleshooting

  Touch Pad Failure                                     0

    If the touch pad fails, perform the following:

                                 Start

                                               OK

                                               NG      Re-assemble the
                          Check M/B T/P FFC            T/P FFC to M/B

                              OK               OK

                                               NG    Swap/Reassemble the
                           Check TouchPad            T/P board or T/P FFC

                              Swap M/B

           Figure 4-5.   Touch Pad Failure

Troubleshooting                                                             4-9

  Internal Speaker Failure                                       0

       If the internal speaker fails, perform the following:

                                    Start

                                                    OK

                                 Check M/B          NG          Re-assemble the
                                 SPK cable                      SPK cable to M/B

                                  OK                OK

                                 Check Logic        NG             Swap Logic
                              lower/Logic upper                 lower/Logic upper

                                 Swap M/B

              Figure 4-6.   Internal Speaker Failure

        Sound Problems                                                                            0

       Perform the following, one at a time.
   1. Boot the computer.
   2. If updated recently, roll back the audio driver to the previous version. Remove and
      reinstall the audio driver.
   3. Make sure that all volume controls are set mid range:
          Click     or    , or click the status area of the taskbar.
          Drag the slider to 50. Confirm that the volume is not muted.

          Click Mixer to verify that other audio applications are set to 50 and not muted.

   4. Remove any recently installed hardware or software.
   5. Factory reset your Chromebook:
       NOTE:        NOTE:
            Make sure to back up all the files on Google Drive or an external hard drive.
          Sign out of the Chromebook and press and hold Ctrl + Alt + Shift + R.

          Click Restart to restart the Chromebook, and then follow the on-screen

4-10                                                                                Troubleshooting

         instructions.
       Check if the problem is fixed once you set up the Chromebook.

   6. Restore system and file settings from a known good date using Chromebook
      Recovery Utility.
   7. Reinstall the operating system.
   8. If the issue is still not resolved, refer to Online Support Information.

Troubleshooting                                                                  4-11

  Audio Codec Failure                                     0

       If the audio codec fails, perform the following:

                                    Start

                                                   OK

                                                          Re-assemble the
                                Check Audio        NG
                                                          Audio and USB
                                to M/B cable              DB to M/B cable

                                 OK                OK

                                Check Audio        NG
                                                          Swap DB Codec
                                  Codec

                                 Swap M/B

              Figure 4-7.   Audio Codec Failure

4-12                                                                        Troubleshooting

  Other Functions Failure                                0

   1. Check if the drives are functioning correctly.
   2. Check if the external modules are functioning correctly.
   3. Change the mainboard to check if current one is defective.

Troubleshooting                                                    4-13

Intermittent Problems                                                                              0

       Intermittent system hang problems can be caused by a variety of reasons that have
       nothing to do with a hardware defect, such as: cosmic radiation, electrostatic discharge,
       or software errors. FRU replacement should be considered only when a recurring
       problem exists.
       When analyzing an intermittent problem, perform the following:
   1. Run the advanced diagnostic test for the system board in loop mode at least 10 times.
   2. If no error is detected, do not replace any FRU.
   3. If an error is detected, replace the FRU. Rerun the test to verify that there are no
      more errors.

Undetermined Problems                                                                              0

       The diagnostic problems do not identify which adapter or device failed, which installed
       devices are incorrect, whether a short circuit is suspected, or whether the system is
       inoperative.
       Perform the following procedures to isolate the failing FRU (do not isolate non-defective
       FRU).
       NOTE:      NOTE:
            Verify that all attached devices are supported by the computer.
       NOTE:      NOTE:
            Verify that the power supply being used at the time of the failure is operating
            correctly. (Refer to Power On Issues).
   1. Remove power from the computer.
   2. Visually check components for damage. If any problems are found, replace the FRU.
   3. Remove or disconnect all of the following devices:
          Non-Acer devices

          Printer, mouse, and other external devices

          Battery pack

          Hard disk drive

          DIMM

          BD/CD-ROM/Diskette drive Module

          PC Cards

   4. Apply power to the computer.
   5. Determine if the problem has changed.
   6. If the problem does not recur, connect the removed devices one at a time until failing
      FRU is found.
   7. If the problem remains, replace the following FRUs:
          System board

          LCD assembly

4-14                                                                           Troubleshooting

             CHAPTER 5
Jumper and Connector Locations

      Mainboard Jumper and Connector Locations . . . . . . . . . . . . . . 5-3

5-2

Jumper and Connector Locations

Mainboard Jumper and Connector Locations                                            0

                                             1          2       3

                        10

                         9

                         8

                         7

                                        6           5       4

          Figure 5-1.   Mainboard Top

   Table 5-1.   Mainboard Top

 Item                Description            Item                    Description
   1    CPU                                  6     Memory*2
   2    eMMC                                 7     Audio Jack
   3    Keyboard Connector                   8     Card Reader Slot
   4    H1                                   9     USB Type-A Connector
   5    EC                                  10     USB Type-C Connector

Jumper and Connector Locations                                                    5-3

                                      1       2   3              4     5

                            12

                            11

                            10

                                  9       8                  7              6

             Figure 5-2.   Mainboard Bottom

      Table 5-2.   Mainboard Bottom

  Item                  Description                   Item                      Description
      1    Microphone Connector                        7             Battery Connector
      2    MIPI Connector                              8             Touchpad Connector
      3    LED Connector                               9             USB Board (L) Connector
      4    G-Sensor Connector                         10             USB Board (H) Connector
      5    eDP Connector                              11             LTE Connector
      6    Speaker Connector                          12             WLAN Module Connectors

5-4                                                                    Jumper and Connector Locations

              CHAPTER 6
FRU (Field Replaceable Unit) List

      Exploded Diagrams . . . . . . . . . . . . . . . . . . . . . . . . . . . . . . . . . . . 6-4
      FRU List . . . . . . . . . . . . . . . . . . . . . . . . . . . . . . . . . . . . . . . . . . . . . 6-8
      Screw List . . . . . . . . . . . . . . . . . . . . . . . . . . . . . . . . . . . . . . . . . . . 6-17

6-2

FRU (Field Replaceable Unit) List
    This chapter provides users with a FRU (Field Replaceable Unit) listing in global
    configurations for the Chromebook R756T/R756TN. Refer to this chapter whenever
    ordering for parts to repair or for RMA (Return Merchandise Authorization).
    NOTE:      NOTE:
          WHEN ORDERING FRU PARTS, check the most up-to-date information available on
          the regional web or channel. Part number changes will not be noted on the
          printed Service Guide. For Acer AUTHORIZED SERVICE PROVIDERS, the Acer office
          may have a DIFFERENT part number code from those given in the FRU list of this
          printed Service Guide. Users MUST use the local FRU list provided by the regional
          Acer office to order FRU parts for repair and service of customer machines.
    NOTE:      NOTE:
          To scrap or to return the defective parts, users should follow the local government
          ordinance or regulations on how to dispose it properly, or follow the rules set by
          the regional Acer office on how to return it.

FRU (Field Replaceable Unit) List                                                         6-3

Exploded Diagrams                                                             0

             1

                                                              2

             3                                                4
             5                                                6
             7                                                8

             9                                                10

                                                              11
            12                                                13
            14                                                15

            16

            17
                                                              18

            19

                                                              20

      Figure 6-1.   System Exploded Diagram

6-4                                           FRU (Field Replaceable Unit) List

      Table 6-1.   System Exploded Diagram

 No.                                Description                   Acer Part No.
  1      UPPER CASE WIFI N-STYLUS SKU                             63.KEAN7.001
  2      Keyboard SUNREX AD01G_C21B AD01G Internal 11 Standard    NK.I111S.0MY
         74KS Black Arabic Chrome OS for Full Size EDU anchored
         frameV0 lock
  3      5M CAMERA HOLDER                                         33.A91N7.003
  4      MICROPHONE BOARD - BOTTOM                                55.A91N7.004
  5      BOARD LED                                                55.KE4N7.002
  6      FFC CABLE - MICROPHONE                                   50.A91N7.004
  7      FFC CABLE - LED BOARD                                    50.A91N7.003
  8      Camera Tech-Front 5M AF MIPI Camera TF_OV05675_AOET      KS.05M0Q.002
         1L4D030B1
  9      Mainboard R756TN N100 4GB eMMC32GB UMA AX201             NB.KED11.003
 10      BOARD USB                                                55.KE4N7.001
 11      CABLE FFC TOUCHPAD                                       50.KEDN7.001
 12      IO BRACKET - L                                           33.AYWN7.003
 13      CABLE FFC BOARD USB HIGH SPEED                           50.KE4N7.001
 14      BRACKET IO R                                             33.KE4N7.003
 15      CABLE FFC BOARD USB LOW SPEED                            50.KE4N7.002
 16      Battery CosMx Typ.53Wh 3S1P AP20CBL 248x84.4x5.5(mm)     KT.0030B.004
         AP20C 11.55V 65W Li-Ion TI BQ40Z555 FW5.09
 17      CONDUCTIVE TAPE                                          47.KEDN7.001
 18      TOUCHPAD MODULE SYNAPTICS NC.24611.050                   56.KEDN7.001
 19      SPEAKER R+L                                              23.KEDN7.001
 20      LOWER CASE N-STYLUS SKU                                  64.KEDN7.001

FRU (Field Replaceable Unit) List                                                 6-5

                           1

                           2
                                                                  3
                                                                  4

                                                                  5

                           6                                      6

                           7

                                                                  8

             Figure 6-2.   LCD Assembly Exploded Diagram

      Table 6-2.   LCD Assembly Exploded Diagram

 No.                              Description                             Acer Part No.
  1      LCD COVER                                                       61.KEDN7.001
  2      CABLE LCD N-STYLUS 6M.KEAN7.001                                 50.KEDN7.002
  3      BOARD G-SENSOR                                                  55.KE4N7.003
  4      RUBBER CAMERA                                                   47.KE4N7.001
         Camera Tech-Front HD Camera YHV-1 HM1091C SPCA2112N             KS.0HD0Q.019
  5
         DS-31041M(BG) KMM4030102664DN9 TNR , Chrome V1.0
         HINGE L                                                         33.KEDN7.001
  6
         HINGE R                                                         33.KEDN7.002

6-6                                                        FRU (Field Replaceable Unit) List

      Table 6-2.   LCD Assembly Exploded Diagram (Continued)

 No.                                Description                Acer Part No.
  7      ANTENNA MAIN+AUX                                      50.KEDN7.003
  8      LCD MODULE STYLUS SKU W/ BEZEL,LCD Panel HENGHAO      6M.KEDN7.001
         11.6" WXGA IPS Glare HD-L116HM03-F5PA/B116XAN06.1
         /(HW:0A) KL.1160H.021

FRU (Field Replaceable Unit) List                                              6-7

FRU List                                                                                   0

      Table 6-3.   FRU List

          Category                           Description                   Acer Part No.
ADAPTER
                              Adapter LITE-ON 45W                        KP.04503.014
                              5V/3A_9V/3A_12V/3A_15V/3A_20V/2.25A
                              Type C PA-1450-50AD LF Black Meet DOE6,
                              CoC Tier2, IEC 62368
                              Adapter Chicony Power 45W                  KP.0450H.012
                              5V/3A_9V/3A_12V/3A_15V/3A_20V/2.25A
                              Type C A045RP05P LF Black Meet DOE6, CoC
                              Tier2, IEC 62368
                              Adapter DELTA 45W                          KP.04501.023
                              5V/3A_9V/3A_12V/3A_15V/3A_20V/2.25A
                              Type C ADP-45HG BA LF Black Meet CoC
                              Tier-2 & IEC 62368
                              Adapter LITE-ON PA-1450-50A9 45W Type C    KP.04503.017
                              Brick
                              5V/3A_9V/3A_12V/3A_15V/3A_20V_2.25A
                              Black ,TCO9.0
                              Adapter Chicony Power A045RP50P 45W        KP.0450H.018
                              Type C Brick
                              5V/3A_9V/3A_12V/3A_15V/3A_20V_2.25A
                              Black ,TCO9.0
BATTERY
                              Battery CosMx Typ.53Wh 3S1P AP20CBL        KT.0030B.004
                              248x84.4x5.5(mm) AP20C 11.55V 65W Li-Ion
                              TI BQ40Z555 FW5.09
                              Battery LGES Typ.50Wh 4470mAh 3S1P         KT.0030G.020
                              AP18C8K 248x84.4x5.5(mm) AP18C 11.25V
                              65W Polymer
BOARD
                              BOARD USB                                  55.KE4N7.001

                              BOARD LTE                                  55.KE6N7.001

6-8                                                        FRU (Field Replaceable Unit) List

   Table 6-3.   FRU List (Continued)

        Category                          Description          Acer Part No.
                            BOARD LED                         55.KE4N7.002

                            BOARD G-SENSOR                    55.KE4N7.003

CABLE
                            CABLE FFC BOARD USB HIGH SPEED    50.KE4N7.001

                            CABLE FFC BOARD USB LOW SPEED     50.KE4N7.002

                            CABLE FFC BOARD LTE               50.KE6N7.001

                            FFC CABLE - LED BOARD             50.A91N7.003

                            CABLE FFC TOUCHPAD                50.KEDN7.001

                            FFC CABLE - MICROPHONE            50.A91N7.004

                            CABLE STYLUS CHARGER              50.KE4N7.004

                            CABLE LCD STYLUS                  50.KEDN7.004
                            6M.KEDN7.001,6M.KEAN7.002
                            CABLE LCD N-STYLUS 6M.KEAN7.001   50.KEDN7.002
                            CABLE LCD STYLUS                  50.KEDN7.004
                            6M.KEDN7.001,6M.KEAN7.002
                            ANTENNA MAIN+AUX                  50.KEDN7.003

FRU (Field Replaceable Unit) List                                              6-9

   Table 6-3.   FRU List (Continued)

       Category                           Description                     Acer Part No.
                          ANTENNA LTE MAIN+AUX                          50.KEEN7.001

CAMERA
                          Camera Tech-Front 5M AF MIPI Camera           KS.05M0Q.002
                          TF_OV05675_AOET 1L4D030B1

                          Camera Tech-Front HD Camera YHV-1             KS.0HD0Q.019
                          HM1091C SPCA2112N DS-31041M(BG)
                          KMM4030102664DN9 TNR , Chrome V1.0
                          Camera Tech-Front HD Camera YHV-3             KS.0HD0Q.026
                          HM1091C SPCA2112N DS-31041M(BG)
                          KMM4030102664DN9 TNR , Chrome V1.0
                          (ROI)
                          Camera CHICONY HD Camera CNFLH35              KS.0HD06.033
                          GC1009 RTS5855 1L3B059F2 (BG)
                          KMM4030102664DN9 TNR Chrom V1.0
                          Camera CHICONY HD Camera CNFLH35-2            KS.0HD06.038
                          GC1009 RTS5855 1L3B059F2 (BG)
                          KMM4030102664DN9 TNR Chrome V1.0
                          (ROI)
KEYBOARD
                          Keyboard SUNREX AD01G_C21B AD01G              NK.I111S.0MY
                          Internal 11 Standard 74KS Black Arabic
                          Chrome OS for Full Size EDU anchored
                          frameV0 lock
                          Keyboard SUNREX AD01G_C21B AD01G              NK.I111S.0NG
                          Internal 11 Standard 75KS Black FR/Arabic
                          Chrome OS for Full Size EDU anchored
                          frameV0 lock
                          Keyboard SUNREX AD01G_C21B AD01G              NK.I111S.0NC
                          Internal 11 Standard 75KS Black Belgium
                          Chrome OS for Full Size EDU anchored
                          frameV0 lock
                          Keyboard SUNREX AD01G_C21B AD01G              NK.I111S.0ND
                          Internal 11 Standard 75KS Black Brazilian
                          Portuguese Chrome OS for Full Size EDU
                          anchored frameV0 lock

6-10                                                      FRU (Field Replaceable Unit) List

   Table 6-3.   FRU List (Continued)

        Category                            Description                     Acer Part No.
                            Keyboard SUNREX AD01G_C21B AD01G               NK.I111S.0NA
                            Internal 11 Standard 74KS Black US
                            International w/ Bulgaria Chrome OS for Full
                            Size EDU anchored frameV0 lock
                            Keyboard SUNREX AD01G_C21B AD01G               NK.I111S.0N9
                            Internal 11 Standard 74KS Black US w/
                            Canadian French Chrome OS for Full Size
                            EDU anchored frameV0 lock
                            Keyboard SUNREX AD01G_C21B AD01G               NK.I111S.0NO
                            Internal 11 Standard 75KS Black SLO/CRO
                            Chrome OS for Full Size EDU anchored
                            frameV0 lock
                            Keyboard SUNREX AD01G_C21B AD01G               NK.I111S.0NE
                            Internal 11 Standard 75KS Black CZ/SK
                            Chrome OS for Full Size EDU anchored
                            frameV0 lock
                            Keyboard SUNREX AD01G_C21B AD01G               NK.I111S.0NF
                            Internal 11 Standard 75KS Black Danish
                            Chrome OS for Full Size EDU anchored
                            frameV0 lock
                            Keyboard SUNREX AD01G_C21B AD01G               NK.I111S.0NH
                            Internal 11 Standard 75KS Black French
                            Chrome OS for Full Size EDU anchored
                            frameV0 lock
                            Keyboard SUNREX AD01G_C21B AD01G               NK.I111S.0NI
                            Internal 11 Standard 75KS Black German
                            Chrome OS for Full Size EDU anchored
                            frameV0 lock
                            Keyboard SUNREX AD01G_C21B AD01G               NK.I111S.0N0
                            Internal 11 Standard 74KS Black Greek
                            Chrome OS for Full Size EDU anchored
                            frameV0 lock
                            Keyboard SUNREX AD01G_C21B AD01G               NK.I111S.0N8
                            Internal 11 Standard 74KS Black US
                            International w/ Hebrew Chrome OS for Full
                            Size EDU anchored frameV0 lock
                            Keyboard SUNREX AD01G_C21B AD01G               NK.I111S.0NJ
                            Internal 11 Standard 75KS Black Hungarian
                            Chrome OS for Full Size EDU anchored
                            frameV0 lock
                            Keyboard SUNREX AD01G_C21B AD01G               NK.I111S.0N4
                            Internal 11 Standard 74KS Black Persian
                            Chrome OS for Full Size EDU anchored
                            frameV0 lock

FRU (Field Replaceable Unit) List                                                         6-11

   Table 6-3.   FRU List (Continued)

       Category                           Description                    Acer Part No.
                          Keyboard SUNREX AD01G_C21B AD01G              NK.I111S.0NK
                          Internal 11 Standard 75KS Black Italian
                          Chrome OS for Full Size EDU anchored
                          frameV0 lock
                          Keyboard SUNREX AD01G_C21B AD01G              NK.I111S.0NU
                          Internal 11 Standard 78KS Black Japanese
                          Chrome OS for Full Size EDU anchored
                          frameV0 lock
                          Keyboard SUNREX AD01G_C21B AD01G              NK.I111S.0N1
                          Internal 11 Standard 74KS Black Korean
                          Chrome OS for Full Size EDU anchored
                          frameV0 lock
                          Keyboard SUNREX AD01G_C21B AD01G              NK.I111S.0NB
                          Internal 11 Standard 75KS Black ALA-Spanish
                          Chrome OS for Full Size EDU anchored
                          frameV0 lock
                          Keyboard SUNREX AD01G_C21B AD01G              NK.I111S.0NM
                          Internal 11 Standard 75KS Black Norwegian
                          Chrome OS for Full Size EDU anchored
                          frameV0 lock
                          Keyboard SUNREX AD01G_C21B AD01G              NK.I111S.0NN
                          Internal 11 Standard 75KS Black Portuguese
                          Chrome OS for Full Size EDU anchored
                          frameV0 lock
                          Keyboard SUNREX AD01G_C21B AD01G              NK.I111S.0N2
                          Internal 11 Standard 74KS Black Russian
                          Chrome OS for Full Size EDU anchored
                          frameV0 lock
                          Keyboard SUNREX AD01G_C21B AD01G              NK.I111S.0NL
                          Internal 11 Standard 75KS Black Nordic
                          Chrome OS for Full Size EDU anchored
                          frameV0 lock
                          Keyboard SUNREX AD01G_C21B AD01G              NK.I111S.0NP
                          Internal 11 Standard 75KS Black Spanish
                          Chrome OS for Full Size EDU anchored
                          frameV0 lock
                          Keyboard SUNREX AD01G_C21B AD01G              NK.I111S.0NQ
                          Internal 11 Standard 75KS Black Sweden
                          Chrome OS for Full Size EDU anchored
                          frameV0 lock
                          Keyboard SUNREX AD01G_C21B AD01G              NK.I111S.0NR
                          Internal 11 Standard 75KS Black Swiss/G
                          Chrome OS for Full Size EDU anchored
                          frameV0 lock

6-12                                                     FRU (Field Replaceable Unit) List

   Table 6-3.   FRU List (Continued)

        Category                            Description                    Acer Part No.
                            Keyboard SUNREX AD01G_C21B AD01G              NK.I111S.0N5
                            Internal 11 Standard 74KS Black Thailand
                            Chrome OS for Full Size EDU anchored
                            frameV0 lock
                            Keyboard SUNREX AD01G_C21B AD01G              NK.I111S.0NS
                            Internal 11 Standard 75KS Black Turkish
                            Chrome OS for Full Size EDU anchored
                            frameV0 lock
                            Keyboard SUNREX AD01G_C21B AD01G              NK.I111S.0MZ
                            Internal 11 Standard 74KS Black Traditional
                            Chinese Chrome OS for Full Size EDU
                            anchored frameV0 lock
                            Keyboard SUNREX AD01G_C21B AD01G              NK.I111S.0N7
                            Internal 11 Standard 74KS Black US
                            International Chrome OS for Full Size EDU
                            anchored frameV0 lock
                            Keyboard SUNREX AD01G_C21B AD01G              NK.I111S.0NT
                            Internal 11 Standard 75KS Black UK Chrome
                            OS for Full Size EDU anchored frameV0 lock
                            Keyboard SUNREX AD01G_C21B AD01G              NK.I111S.0N3
                            Internal 11 Standard 74KS Black Ukrainian
                            Chrome OS for Full Size EDU anchored
                            frameV0 lock
                            Keyboard SUNREX AD01G_C21B AD01G              NK.I111S.0N6
                            Internal 11 Standard 74KS Black US Chrome
                            OS for Full Size EDU anchored frameV0 lock
LCD COVER
                            LCD COVER                                     61.KEDN7.001

LCD MODULE
                            LCD MODULE STYLUS SKU W/ BEZEL,LCD            6M.KEDN7.001
                            Panel HENGHAO 11.6" WXGA IPS Glare
                            HD-L116HM03-F5PA/B116XAN06.1 /(HW:0A)
                            KL.1160H.021
                            LCD MODULE N-STYLUS SKU W/ BEZEL,LED          6M.KEAN7.001
                            Touch Panel AUO 11.6" HD IPS Glare
                            116XAB01.4 H/W:2B KL.11605.066

FRU (Field Replaceable Unit) List                                                        6-13

   Table 6-3.   FRU List (Continued)

        Category                           Description                   Acer Part No.
                          LCD MODULE N-STYLUS SKU W/ BEZEL,LCD         6M.KEAN7.002
                          Panel HENGHAO 11.6" WXGA IPS Glare
                          HD-L116HM06-F5PA/B116XAN06.1 /(HW:0A)
                          KL.1160H.022

LOWER CASE
                          LOWER CASE N-STYLUS SKU                      64.KEDN7.001
                          LOWER CASE STYLUS SKU                        64.KEAN7.001

MAINBOARD
                          Mainboard R756TN N100 4GB eMMC32GB           NB.KED11.003
                          UMA AX201
                          Mainboard R756TN N100 8GB eMMC64GB           NB.KED11.004
                          UMA Intel AX211.D2WG
                          Mainboard R756T N100 4GB eMMC32GB            NB.KEA11.002
                          UMA intel AX211
                          Mainboard R756T N100 8GB eMMC64GB            NB.KEA11.003
                          UMA Intel AX211.D2WG
METAL
                          HINGE L                                      33.KEDN7.001
                          HINGE R                                      33.KEDN7.002

                          SIM TRAY                                     47.KE6N7.001

                          PRIMETEK PRIMETEK Sim Card Ejector with      NC.23811.0AK
                          Packing

                          IO BRACKET - L                               33.AYWN7.003

                          BRACKET IO R                                 33.KE4N7.003

6-14                                                     FRU (Field Replaceable Unit) List

   Table 6-3.   FRU List (Continued)

        Category                            Description          Acer Part No.
PLASTICS
                            HOLDER STYLUS                       42.KE4N7.001

                            5M CAMERA HOLDER                    33.A91N7.003

POWER CORD
                            POWER CORD 1M 125V JAP BLACK        27.NE307.001
                            POWER CORD 1M 125V ARG BLACK        27.NE307.004
                            POWER CORD 1M 125V AUS BLACK        27.NE307.005
                            POWER CORD 1M 125V BRAZIL BLACK     27.NE307.006
                            POWER CORD 1M 125V CHINA BLACK      27.NE307.007
                            POWER CORD 1M 125V DENMARK BLACK    27.NE307.008
                            POWER CORD 1M 125V INDIA BLACK      27.NE307.009
                            POWER CORD 1M 125V ISRAEL BLACK     27.NE307.010
                            POWER CORD 1M 125V ITL BLACK        27.NE307.011
                            POWER CORD 1M 125V S.AFRICA BLACK   27.NE307.012
                            POWER CORD 1M 125V SWISS BLACK      27.NE307.013
                            POWER CORD 1M 125V EUR+KOR BLACK    27.NE307.015
                            POWER CORD 1M 125V US BLACK         27.NE307.003
                            POWER CORD 1M 125V UK BLACK         27.NE307.014
                            POWER CORD 1M 125V TAIWAN BLACK     27.NE307.002
SIM
                            LTE Fibocom LTE FM101-GL FM101-GL   KI.LTE0F.002

SPEAKER/MICROPHONE
                            SPEAKER R+L                         23.KEDN7.001

                            MICROPHONE BOARD - BOTTOM           55.A91N7.004

FRU (Field Replaceable Unit) List                                              6-15

   Table 6-3.   FRU List (Continued)

       Category                           Description                     Acer Part No.
STYLUS
                          Acer Active Stylus Pen ESP-233-02B-6 USI 1.0   NC.23811.09R

TOUCHPAD
                          TOUCHPAD MODULE SYNAPTICS                      56.KEDN7.001
                          NC.24611.050
                          TOUCHPAD MODULE ELANTECH                       56.KEDN7.002
                          NC.24611.04K
UPPER CASE
                          UPPER CASE LTE STYLUS SKU                      63.KEGN7.001
                          UPPER CASE WIFI STYLUS SKU                     63.KEDN7.001
                          UPPER CASE LTE N-STYLUS SKU                    63.KEEN7.001
                          UPPER CASE WIFI N-STYLUS SKU                   63.KEAN7.001

MISCELLANEOUS
                          CONDUCTIVE TAPE                                47.KEDN7.001

                          RUBBER CAMERA                                  47.KE4N7.001

                          MYLAR BATTERY CABLE                            47.KE4N7.003

                          THERMAL PAD                                    47.AY4N7.004

                          MYLAR FFC COONECTOR                            47.KE4N7.004

                          ACETATE TAPE FOR BATTERY(21*21mm)              47.HKKN7.001

6-16                                                      FRU (Field Replaceable Unit) List

Screw List                                                                      0

   Table 6-4.    Screw List

      Category                          Description             Acer Part No.
                        SCREW M2.5*5-I(NI,NYLOK)IRON           86.A6VN7.001

                        SCREW W/WASHER KIT                     86.VLLN7.003

                        SCREW M2*2.5-I(BZN,NYLOK)IRON          86.GVJN7.002

                        SCREW M2.0*4.0-I(BZN)(NYLOK)IRON       86.A91N7.002

                        SCREW M2.0*5.0- I(BZN)(NYLOK)IRON      86.AZGN7.001

                        SCREW M2.5*2.5-I(BNI)NYLOKD8T0.4IRON   86.GWGN7.001

                        SCREW ASSY(M2.0*5.5)W/WASHER           86.KE4N7.001

                        SCREW M2*2.5-I(BNI)(NYLOK)IRON         86.A6VN7.002

FRU (Field Replaceable Unit) List                                          6-17

                CHAPTER 7
Model Definition and Configuration

Acer Chromebook R756T. . . . . . . . . . . . . . . . . . . . . . . . . . . . . . . 7-3
Acer Chromebook R756TN . . . . . . . . . . . . . . . . . . . . . . . . . . . . . 7-9

                                                                                         7-2

Model Definition and Configuration

Acer Chromebook R756T                                                                            0

      Table 7-1.   RO, Description (UMA2C5MkkR_5LT(KEA))
      Model         RO       Country     Acer Part No                   Description

                                                            R756T-C9PB CHROMENUS7
                                                            UMA2C5MkkR_5LT
R756T-C9PB         PA        USA       NX.KEAAA.002         N100/1*8G/64G/50Wh/R/1HITNAM_WI
                                                            FI6E+BT5.2_HDMic25M AF_Sha
                                                            Black_ENP1 -
                                                            R756T-C822 CHROMENUS7
                                                            UMA2C5MkkR_5LT
R756T-C822         PA        USA       NX.KEAAA.001         N100/1*4G/32G/50Wh/R/1HITNAM_WI
                                                            FI6E+BT5.2_HDMic25M AF_Sha
                                                            Black_ENP1 -

      Table 7-2.   CPU, LCD, VGA Chip (UMA2C5MkkR_5LT(KEA))
      Model        Country     Acer Part No           CPU             LCD             VGA Chip

                                                                  N11.6HDGSUP
R756T-C9PB         USA       NX.KEAAA.002      N100                                UMA
                                                                  I/TP3NAM
                                                                  N11.6HDGSUP
R756T-C822         USA       NX.KEAAA.001      N100                                UMA
                                                                  I/TP3NAM

      Table 7-3.   Memory, HDD (UMA2C5MkkR_5LT(KEA))
      Model        Country     Acer Part No              Memory                       HDD

R756T-C9PB         USA       NX.KEAAA.002      LPDDR5_8GB(4GBx2)             eMMC64GB
R756T-C822         USA       NX.KEAAA.001      LPDDR5_4GB(2GBx2)             eMMC32GB

      Table 7-4.   Card Reader, Wireless LAN (UMA2C5MkkR_5LT(KEA))
      Model        Country     Acer Part No     Card Reader                 Wireless LAN

R756T-C9PB         USA        NX.KEAAA.002     MicroSD            WIFI 6E 2X2 BT INTEL CNVi SD
R756T-C822         USA        NX.KEAAA.001     MicroSD            WIFI 6E 2X2 BT INTEL CNVi SD

7-3                                                          Model Definition and Configuration

   Table 7-5.   Camera (UMA2C5MkkR_5LT(KEA))
   Model        Country    Acer Part No                Camera               Camera 2

R756T-C9PB      USA       NX.KEAAA.002    HDFF_U_C_M2R0_6mm01TN           5MAF MIPI
R756T-C822      USA       NX.KEAAA.001    HDFF_U_C_M2R0_6mm01TN           5MAF MIPI

   Table 7-6.   NB Chipset, Battery, Adapter (UMA2C5MkkR_5LT(KEA))
   Model        Country    Acer Part No   NB Chipset            Battery     Adapter

                                          none NB                         45W_Google
R756T-C9PB      USA       NX.KEAAA.002                   50Wh_150300
                                          Chipset                         PD
                                          none NB                         45W_Google
R756T-C822      USA       NX.KEAAA.001                   50Wh_150300
                                          Chipset                         PD

Model Definition and Configuration                                                     7-4

      Table 7-7.   RO, Description (UMA2C5MkkR_5LT(KEB))
         Model           RO    Country    Acer Part No              Description

                                                         R756T-TCO-C1LL CHROMENFR1
                                                         UMA2C5MkkR_5LT
R756T-TCO-C1LL         EMEA    France    NX.KEBEF.001    N100/1*4G/32G/50Wh/R/1HITNAM
                                                         _WIFI6E+BT5.2_HDMic25M AF_Sha
                                                         Black_FRWG -
                                                         R756T-TCO-C53H CHROMENFR1
                                                         UMA2C5MkkR_5LT
R756T-TCO-C53H         EMEA    France    NX.KEBEF.002    N100/1*4G/64G/50Wh/R/1HITNAM
                                                         _WIFI6E+BT5.2_HDMic25M AF_Sha
                                                         Black_FRWG -
                                                         R756T-TCO-C7Z8 CHROMENFR1
                                                         UMA2C5MkkR_5LT
R756T-TCO-C7Z8         EMEA    France    NX.KEBEF.004    N100/1*8G/64G/50Wh/R/1HITNAM
                                                         _WIFI6E+BT5.2_HDMic25M AF_Sha
                                                         Black_FRWG -
                                                         R756T-TCO-C7ZA CHROMENFR1
                                                         UMA2C5MkkR_5LT
R756T-TCO-C7ZA         EMEA    France    NX.KEBEF.003    N100/1*8G/32G/50Wh/R/1HITNAM
                                                         _WIFI6E+BT5.2_HDMic25M AF_Sha
                                                         Black_FRWG -
                                                         R756T-TCO-C950 CHROMENFR1
                                                         UMA2C5MkkR_5LT
R756T-TCO-C950         EMEA    France    NX.KEBEF.005    N100/1*8G/128G/50Wh/R/1HITNA
                                                         M_WIFI6E+BT5.2_HDMic25M
                                                         AF_Sha Black_FRWG -
                                                         R756T-TCO-P292 CHROMENFR1
                                                         UMA2C5MkkR_5LT
R756T-TCO-P292         EMEA    France    NX.KEBEF.007    N200/1*4G/64G/50Wh/R/1HITNAM
                                                         _WIFI6E+BT5.2_HDMic25M AF_Sha
                                                         Black_FRWG -
                                                         R756T-TCO-P2BY CHROMENFR1
                                                         UMA2C5MkkR_5LT
R756T-TCO-P2BY         EMEA    France    NX.KEBEF.008    N200/1*8G/32G/50Wh/R/1HITNAM
                                                         _WIFI6E+BT5.2_HDMic25M AF_Sha
                                                         Black_FRWG -
                                                         R756T-TCO-P91F CHROMENFR1
                                                         UMA2C5MkkR_5LT
R756T-TCO-P91F         EMEA    France    NX.KEBEF.006    N200/1*4G/32G/50Wh/R/1HITNAM
                                                         _WIFI6E+BT5.2_HDMic25M AF_Sha
                                                         Black_FRWG -
                                                         R756T-TCO-P6HC CHROMENFR1
                                                         UMA2C5MkkR_5LT
                                         NX.KEBEF.00
R756T-TCO-P6HC         EMEA    France                    N200/1*8G/128G/50Wh/R/1HITNA
                                         A
                                                         M_WIFI6E+BT5.2_HDMic25M
                                                         AF_Sha Black_FRWG -

7-5                                                      Model Definition and Configuration

   Table 7-7.   RO, Description (UMA2C5MkkR_5LT(KEB)) (Continued)
      Model           RO      Country    Acer Part No             Description

                                                        R756T-TCO-P7AE CHROMENFR1
                                                        UMA2C5MkkR_5LT
R756T-TCO-P7AE      EMEA      France    NX.KEBEF.009    N200/1*8G/64G/50Wh/R/1HITNAM
                                                        _WIFI6E+BT5.2_HDMic25M AF_Sha
                                                        Black_FRWG -

   Table 7-8.   CPU, LCD, VGA Chip (UMA2C5MkkR_5LT(KEB))
      Model         Country    Acer Part No       CPU           LCD             VGA Chip

                                                           N11.6HDGSUPI
R756T-TCO-C1LL      France    NX.KEBEF.001     N100                        UMA
                                                           /TP3NAM
                                                           N11.6HDGSUPI
R756T-TCO-C53H      France    NX.KEBEF.002     N100                        UMA
                                                           /TP3NAM
                                                           N11.6HDGSUPI
R756T-TCO-C7Z8      France    NX.KEBEF.004     N100                        UMA
                                                           /TP3NAM
                                                           N11.6HDGSUPI
R756T-TCO-C7ZA      France    NX.KEBEF.003     N100                        UMA
                                                           /TP3NAM
                                                           N11.6HDGSUPI
R756T-TCO-C950      France    NX.KEBEF.005     N100                        UMA
                                                           /TP3NAM
                                                           N11.6HDGSUPI
R756T-TCO-P292      France    NX.KEBEF.007     N200                        UMA
                                                           /TP3NAM
                                                           N11.6HDGSUPI
R756T-TCO-P2BY      France    NX.KEBEF.008     N200                        UMA
                                                           /TP3NAM
                                                           N11.6HDGSUPI
R756T-TCO-P91F      France    NX.KEBEF.006     N200                        UMA
                                                           /TP3NAM
                                                           N11.6HDGSUPI
R756T-TCO-P6HC      France    NX.KEBEF.00A     N200                        UMA
                                                           /TP3NAM
                                                           N11.6HDGSUPI
R756T-TCO-P7AE      France    NX.KEBEF.009     N200                        UMA
                                                           /TP3NAM

Model Definition and Configuration                                                         7-6

      Table 7-9.    Memory, HDD (UMA2C5MkkR_5LT(KEB))
        Model          Country    Acer Part No          Memory                   HDD

R756T-TCO-C1LL         France    NX.KEBEF.001    LPDDR5_4GB(2GBx2)        eMMC32GB
R756T-TCO-C53H         France    NX.KEBEF.002    LPDDR5_4GB(2GBx2)        eMMC64GB
R756T-TCO-C7Z8         France    NX.KEBEF.004    LPDDR5_8GB(4GBx2)        eMMC64GB
R756T-TCO-C7ZA         France    NX.KEBEF.003    LPDDR5_8GB(4GBx2)        eMMC32GB
R756T-TCO-C950         France    NX.KEBEF.005    LPDDR5_8GB(4GBx2)        eMMC128GB
R756T-TCO-P292         France    NX.KEBEF.007    LPDDR5_4GB(2GBx2)        eMMC64GB
R756T-TCO-P2BY         France    NX.KEBEF.008    LPDDR5_8GB(4GBx2)        eMMC32GB
R756T-TCO-P91F         France    NX.KEBEF.006    LPDDR5_4GB(2GBx2)        eMMC32GB
R756T-TCO-P6HC         France    NX.KEBEF.00A    LPDDR5_8GB(4GBx2)        eMMC128GB
R756T-TCO-P7AE         France    NX.KEBEF.009    LPDDR5_8GB(4GBx2)        eMMC64GB

      Table 7-10.   Card Reader, Wireless LAN (UMA2C5MkkR_5LT(KEB))
        Model          Country    Acer Part No   Card Reader            Wireless LAN

                                                                WIFI 6E 2X2 BT INTEL CNVi
R756T-TCO-C1LL         France    NX.KEBEF.001    MicroSD
                                                                SD
                                                                WIFI 6E 2X2 BT INTEL CNVi
R756T-TCO-C53H         France    NX.KEBEF.002    MicroSD
                                                                SD
                                                                WIFI 6E 2X2 BT INTEL CNVi
R756T-TCO-C7Z8         France    NX.KEBEF.004    MicroSD
                                                                SD
                                                                WIFI 6E 2X2 BT INTEL CNVi
R756T-TCO-C7ZA         France    NX.KEBEF.003    MicroSD
                                                                SD
                                                                WIFI 6E 2X2 BT INTEL CNVi
R756T-TCO-C950         France    NX.KEBEF.005    MicroSD
                                                                SD
                                                                WIFI 6E 2X2 BT INTEL CNVi
R756T-TCO-P292         France    NX.KEBEF.007    MicroSD
                                                                SD
                                                                WIFI 6E 2X2 BT INTEL CNVi
R756T-TCO-P2BY         France    NX.KEBEF.008    MicroSD
                                                                SD
                                                                WIFI 6E 2X2 BT INTEL CNVi
R756T-TCO-P91F         France    NX.KEBEF.006    MicroSD
                                                                SD
                                                                WIFI 6E 2X2 BT INTEL CNVi
R756T-TCO-P6HC         France    NX.KEBEF.00A    MicroSD
                                                                SD
                                                                WIFI 6E 2X2 BT INTEL CNVi
R756T-TCO-P7AE         France    NX.KEBEF.009    MicroSD
                                                                SD

7-7                                                        Model Definition and Configuration

   Table 7-11.   Camera (UMA2C5MkkR_5LT(KEB))
      Model         Country    Acer Part No                Camera           Camera 2

R756T-TCO-C1LL      France    NX.KEBEF.001    HDFF_U_C_M2R0_6mm01TN       5MAF MIPI
R756T-TCO-C53H      France    NX.KEBEF.002    HDFF_U_C_M2R0_6mm01TN       5MAF MIPI
R756T-TCO-C7Z8      France    NX.KEBEF.004    HDFF_U_C_M2R0_6mm01TN       5MAF MIPI
R756T-TCO-C7ZA      France    NX.KEBEF.003    HDFF_U_C_M2R0_6mm01TN       5MAF MIPI
R756T-TCO-C950      France    NX.KEBEF.005    HDFF_U_C_M2R0_6mm01TN       5MAF MIPI
R756T-TCO-P292      France    NX.KEBEF.007    HDFF_U_C_M2R0_6mm01TN       5MAF MIPI
R756T-TCO-P2BY      France    NX.KEBEF.008    HDFF_U_C_M2R0_6mm01TN       5MAF MIPI
R756T-TCO-P91F      France    NX.KEBEF.006    HDFF_U_C_M2R0_6mm01TN       5MAF MIPI
R756T-TCO-P6HC      France    NX.KEBEF.00A    HDFF_U_C_M2R0_6mm01TN       5MAF MIPI
R756T-TCO-P7AE      France    NX.KEBEF.009    HDFF_U_C_M2R0_6mm01TN       5MAF MIPI

   Table 7-12.   NB Chipset, Battery, Adapter (UMA2C5MkkR_5LT(KEB))
      Model        Country     Acer Part No   NB Chipset        Battery     Adapter

                                              none NB                     45W_PD_BK
R756T-TCO-C1LL     France     NX.KEBEF.001                  50Wh_150301
                                              Chipset                     _TCO9.0
                                              none NB                     45W_PD_BK
R756T-TCO-C53H     France     NX.KEBEF.002                  50Wh_150301
                                              Chipset                     _TCO9.0
                                              none NB                     45W_PD_BK
R756T-TCO-C7Z8     France     NX.KEBEF.004                  50Wh_150301
                                              Chipset                     _TCO9.0
                                              none NB                     45W_PD_BK
R756T-TCO-C7ZA     France     NX.KEBEF.003                  50Wh_150301
                                              Chipset                     _TCO9.0
                                              none NB                     45W_PD_BK
R756T-TCO-C950     France     NX.KEBEF.005                  50Wh_150301
                                              Chipset                     _TCO9.0
                                              none NB                     45W_PD_BK
R756T-TCO-P292     France     NX.KEBEF.007                  50Wh_150301
                                              Chipset                     _TCO9.0
                                              none NB                     45W_PD_BK
R756T-TCO-P2BY     France     NX.KEBEF.008                  50Wh_150301
                                              Chipset                     _TCO9.0
                                              none NB                     45W_PD_BK
R756T-TCO-P91F     France     NX.KEBEF.006                  50Wh_150301
                                              Chipset                     _TCO9.0
                                              none NB                     45W_PD_BK
R756T-TCO-P6HC     France     NX.KEBEF.00A                  50Wh_150301
                                              Chipset                     _TCO9.0
                                              none NB                     45W_PD_BK
R756T-TCO-P7AE     France     NX.KEBEF.009                  50Wh_150301
                                              Chipset                     _TCO9.0

Model Definition and Configuration                                                     7-8

Acer Chromebook R756TN                                                                            0

      Table 7-13.   RO, Description (UMA2C5MkkR_5LT(KED))
       Model        RO    Country     Acer Part No                     Description

                                                       R756TN-C1X1 CHROMENUS7
                                                       UMA2C5MkkR_5LT
R756TN-C1X1         PA    USA       NX.KEDAA.002       N100/1*8G/64G/50Wh/R/1HITU5AM_WIF
                                                       I6E+BT5.2_HDMic25M AF_G-USI
                                                       Pen_Sha Black_ENP1 -
                                                       R756TN-C01B CHROMENUS7
                                                       UMA2C5MkkR_5LT
R756TN-C01B         PA    USA       NX.KEDAA.001       N100/1*4G/32G/50Wh/R/1HITU5AM_WIF
                                                       I6E+BT5.2_HDMic25M AF_G-USI
                                                       Pen_Sha Black_ENP1 -

      Table 7-14.   CPU, LCD, VGA Chip (UMA2C5MkkR_5LT(KED))
       Model        Country      Acer Part No          CPU             LCD             VGA Chip

                                                                   N11.6HDGSUPI
R756TN-C1X1         USA         NX.KEDAA.002     N100                                UMA
                                                                   /TP1U5AM
                                                                   N11.6HDGSUPI
R756TN-C01B         USA         NX.KEDAA.001     N100                                UMA
                                                                   /TP1U5AM

      Table 7-15.   Memory, HDD (UMA2C5MkkR_5LT(KED))
       Model        Country      Acer Part No             Memory                      HDD

R756TN-C1X1         USA         NX.KEDAA.002     LPDDR5_8GB(4GBx2)           eMMC64GB
R756TN-C01B         USA         NX.KEDAA.001     LPDDR5_4GB(2GBx2)           eMMC32GB

      Table 7-16.   Card Reader, Wireless LAN (UMA2C5MkkR_5LT(KED))
       Model        Country      Acer Part No        Card Reader             Wireless LAN

                                                                     WIFI 6E 2X2 BT INTEL CNVi
R756TN-C1X1         USA         NX.KEDAA.002     MicroSD
                                                                     SD
                                                                     WIFI 6E 2X2 BT INTEL CNVi
R756TN-C01B         USA         NX.KEDAA.001     MicroSD
                                                                     SD

      Table 7-17.   Camera (UMA2C5MkkR_5LT(KED))
       Model        Country      Acer Part No                 Camera                   Camera 2

R756TN-C1X1         USA         NX.KEDAA.002     HDFF_U_C_M2R0_6mm01TN               5MAF MIPI
R756TN-C01B         USA         NX.KEDAA.001     HDFF_U_C_M2R0_6mm01TN               5MAF MIPI

7-9                                                          Model Definition and Configuration

   Table 7-18.   NB Chipset, Battery, Adapter (UMA2C5MkkR_5LT(KED))
    Model         Country    Acer Part No   NB Chipset      Battery      Adapter

                                            none NB                    45W_Google
R756TN-C1X1      USA        NX.KEDAA.002                 50Wh_150300
                                            Chipset                    PD
                                            none NB                    45W_Google
R756TN-C01B      USA        NX.KEDAA.001                 50Wh_150300
                                            Chipset                    PD

Model Definition and Configuration                                                 7-10

   Table 7-19.   RO, Description (UMA2C5MkkR_5LT(KEC))
       Model           RO     Country    Acer Part No            Description

                                                         R756TN-TCO-P17X
                                                         CHROMENNL1
                                                         UMA2C5MkkR_5LT
R756TN-TCO-P17X      EMEA    Holland    NX.KECEH.001     N200/1*8G/64G/50Wh/R/1HITU
                                                         5AM_WIFI6E+BT5.2_HDMic25
                                                         M AF_G-USI Pen_Sha
                                                         Black_NLBA -
                                                         R756TN-TCO-C0LJ
                                                         CHROMENFR1
                                                         UMA2C5MkkR_5LT
R756TN-TCO-C0LJ      EMEA    France     NX.KECEF.003     N100/1*8G/32G/50Wh/R/1HITU
                                                         5AM_WIFI6E+BT5.2_HDMic25
                                                         M AF_G-USI Pen_Sha
                                                         Black_FRWG -
                                                         R756TN-TCO-C4H0
                                                         CHROMENFR1
                                                         UMA2C5MkkR_5LT
R756TN-TCO-C4H0      EMEA    France     NX.KECEF.002     N100/1*4G/64G/50Wh/R/1HITU
                                                         5AM_WIFI6E+BT5.2_HDMic25
                                                         M AF_G-USI Pen_Sha
                                                         Black_FRWG -
                                                         R756TN-TCO-C8EM
                                                         CHROMENFR1
                                                         UMA2C5MkkR_5LT
R756TN-TCO-C8EM      EMEA    France     NX.KECEF.001     N100/1*4G/32G/50Wh/R/1HITU
                                                         5AM_WIFI6E+BT5.2_HDMic25
                                                         M AF_G-USI Pen_Sha
                                                         Black_FRWG -
                                                         R756TN-TCO-C0BD
                                                         CHROMENFR1
                                                         UMA2C5MkkR_5LT
R756TN-TCO-C0BD      EMEA    France     NX.KECEF.005     N100/1*8G/128G/50Wh/R/1HIT
                                                         U5AM_WIFI6E+BT5.2_HDMic25
                                                         M AF_G-USI Pen_Sha
                                                         Black_FRWG -
                                                         R756TN-TCO-C7PV
                                                         CHROMENFR1
                                                         UMA2C5MkkR_5LT
R756TN-TCO-C7PV      EMEA    France     NX.KECEF.004     N100/1*8G/64G/50Wh/R/1HITU
                                                         5AM_WIFI6E+BT5.2_HDMic25
                                                         M AF_G-USI Pen_Sha
                                                         Black_FRWG -

7-11                                                Model Definition and Configuration

   Table 7-19.   RO, Description (UMA2C5MkkR_5LT(KEC)) (Continued)
       Model           RO     Country    Acer Part No           Description

                                                        R756TN-TCO-P6NA
                                                        CHROMENFR1
                                                        UMA2C5MkkR_5LT
R756TN-TCO-P6NA       EMEA    France    NX.KECEF.007    N200/1*4G/64G/50Wh/R/1HITU
                                                        5AM_WIFI6E+BT5.2_HDMic25
                                                        M AF_G-USI Pen_Sha
                                                        Black_FRWG -
                                                        R756TN-TCO-P9T7
                                                        CHROMENFR1
                                                        UMA2C5MkkR_5LT
R756TN-TCO-P9T7       EMEA    France    NX.KECEF.006    N200/1*4G/32G/50Wh/R/1HITU
                                                        5AM_WIFI6E+BT5.2_HDMic25
                                                        M AF_G-USI Pen_Sha
                                                        Black_FRWG -
                                                        R756TN-TCO-P000
                                                        CHROMENFR1
                                                        UMA2C5MkkR_5LT
R756TN-TCO-P000       EMEA    France    NX.KECEF.008    N200/1*8G/32G/50Wh/R/1HITU
                                                        5AM_WIFI6E+BT5.2_HDMic25
                                                        M AF_G-USI Pen_Sha
                                                        Black_FRWG -
                                                        R756TN-TCO-P62B
                                                        CHROMENFR1
                                                        UMA2C5MkkR_5LT
R756TN-TCO-P62B       EMEA    France    NX.KECEF.009    N200/1*8G/64G/50Wh/R/1HITU
                                                        5AM_WIFI6E+BT5.2_HDMic25
                                                        M AF_G-USI Pen_Sha
                                                        Black_FRWG -
                                                        R756TN-TCO-P8PT
                                                        CHROMENFR1
                                                        UMA2C5MkkR_5LT
R756TN-TCO-P8PT       EMEA    France    NX.KECEF.00A    N200/1*8G/128G/50Wh/R/1HIT
                                                        U5AM_WIFI6E+BT5.2_HDMic25
                                                        M AF_G-USI Pen_Sha
                                                        Black_FRWG -

Model Definition and Configuration                                              7-12

   Table 7-20.   CPU, LCD, VGA Chip (UMA2C5MkkR_5LT(KEC))
       Model          Country    Acer Part No     CPU            LCD      VGA Chip

                                                           N11.6HDGSUPI
R756TN-TCO-P17X      Holland    NX.KECEH.001    N200                      UMA
                                                           /TP1U5AM
                                                           N11.6HDGSUPI
R756TN-TCO-C0LJ      France     NX.KECEF.003    N100                      UMA
                                                           /TP1U5AM
                                                           N11.6HDGSUPI
R756TN-TCO-C4H0      France     NX.KECEF.002    N100                      UMA
                                                           /TP1U5AM
                                                           N11.6HDGSUPI
R756TN-TCO-C8EM      France     NX.KECEF.001    N100                      UMA
                                                           /TP1U5AM
                                                           N11.6HDGSUPI
R756TN-TCO-C0BD      France     NX.KECEF.005    N100                      UMA
                                                           /TP1U5AM
                                                           N11.6HDGSUPI
R756TN-TCO-C7PV      France     NX.KECEF.004    N100                      UMA
                                                           /TP1U5AM
                                                           N11.6HDGSUPI
R756TN-TCO-P6NA      France     NX.KECEF.007    N200                      UMA
                                                           /TP1U5AM
                                                           N11.6HDGSUPI
R756TN-TCO-P9T7      France     NX.KECEF.006    N200                      UMA
                                                           /TP1U5AM
                                                           N11.6HDGSUPI
R756TN-TCO-P000      France     NX.KECEF.008    N200                      UMA
                                                           /TP1U5AM
                                                           N11.6HDGSUPI
R756TN-TCO-P62B      France     NX.KECEF.009    N200                      UMA
                                                           /TP1U5AM
                                                           N11.6HDGSUPI
R756TN-TCO-P8PT      France     NX.KECEF.00A    N200                      UMA
                                                           /TP1U5AM

   Table 7-21.   Memory, HDD (UMA2C5MkkR_5LT(KEC))
       Model          Country    Acer Part No           Memory            HDD

R756TN-TCO-P17X      Holland    NX.KECEH.001    LPDDR5_8GB(4GBx2)      eMMC64GB
R756TN-TCO-C0LJ      France     NX.KECEF.003    LPDDR5_8GB(4GBx2)      eMMC32GB
R756TN-TCO-C4H0      France     NX.KECEF.002    LPDDR5_4GB(2GBx2)      eMMC64GB
R756TN-TCO-C8EM      France     NX.KECEF.001    LPDDR5_4GB(2GBx2)      eMMC32GB
R756TN-TCO-C0BD      France     NX.KECEF.005    LPDDR5_8GB(4GBx2)      eMMC128GB
R756TN-TCO-C7PV      France     NX.KECEF.004    LPDDR5_8GB(4GBx2)      eMMC64GB
R756TN-TCO-P6NA      France     NX.KECEF.007    LPDDR5_4GB(2GBx2)      eMMC64GB
R756TN-TCO-P9T7      France     NX.KECEF.006    LPDDR5_4GB(2GBx2)      eMMC32GB
R756TN-TCO-P000      France     NX.KECEF.008    LPDDR5_8GB(4GBx2)      eMMC32GB
R756TN-TCO-P62B      France     NX.KECEF.009    LPDDR5_8GB(4GBx2)      eMMC64GB
R756TN-TCO-P8PT      France     NX.KECEF.00A    LPDDR5_8GB(4GBx2)      eMMC128GB

7-13                                               Model Definition and Configuration

   Table 7-22.   Card Reader, Wireless LAN (UMA2C5MkkR_5LT(KEC))
       Model          Country    Acer Part No     Card Reader         Wireless LAN

                                                                   WIFI 6E 2X2 BT
R756TN-TCO-P17X      Holland    NX.KECEH.001    MicroSD
                                                                   INTEL CNVi SD
                                                                   WIFI 6E 2X2 BT
R756TN-TCO-C0LJ      France     NX.KECEF.003    MicroSD
                                                                   INTEL CNVi SD
                                                                   WIFI 6E 2X2 BT
R756TN-TCO-C4H0      France     NX.KECEF.002    MicroSD
                                                                   INTEL CNVi SD
                                                                   WIFI 6E 2X2 BT
R756TN-TCO-C8EM      France     NX.KECEF.001    MicroSD
                                                                   INTEL CNVi SD
                                                                   WIFI 6E 2X2 BT
R756TN-TCO-C0BD      France     NX.KECEF.005    MicroSD
                                                                   INTEL CNVi SD
                                                                   WIFI 6E 2X2 BT
R756TN-TCO-C7PV      France     NX.KECEF.004    MicroSD
                                                                   INTEL CNVi SD
                                                                   WIFI 6E 2X2 BT
R756TN-TCO-P6NA      France     NX.KECEF.007    MicroSD
                                                                   INTEL CNVi SD
                                                                   WIFI 6E 2X2 BT
R756TN-TCO-P9T7      France     NX.KECEF.006    MicroSD
                                                                   INTEL CNVi SD
                                                                   WIFI 6E 2X2 BT
R756TN-TCO-P000      France     NX.KECEF.008    MicroSD
                                                                   INTEL CNVi SD
                                                                   WIFI 6E 2X2 BT
R756TN-TCO-P62B      France     NX.KECEF.009    MicroSD
                                                                   INTEL CNVi SD
                                                                   WIFI 6E 2X2 BT
R756TN-TCO-P8PT      France     NX.KECEF.00A    MicroSD
                                                                   INTEL CNVi SD

   Table 7-23.   Camera (UMA2C5MkkR_5LT(KEC))
       Model          Country    Acer Part No         Camera              Camera 2

                                                HDFF_U_C_M2R0_6mm
R756TN-TCO-P17X      Holland    NX.KECEH.001                           5MAF MIPI
                                                01TN
                                                HDFF_U_C_M2R0_6mm
R756TN-TCO-C0LJ      France     NX.KECEF.003                           5MAF MIPI
                                                01TN
                                                HDFF_U_C_M2R0_6mm
R756TN-TCO-C4H0      France     NX.KECEF.002                           5MAF MIPI
                                                01TN
                                                HDFF_U_C_M2R0_6mm
R756TN-TCO-C8EM      France     NX.KECEF.001                           5MAF MIPI
                                                01TN
                                                HDFF_U_C_M2R0_6mm
R756TN-TCO-C0BD      France     NX.KECEF.005                           5MAF MIPI
                                                01TN
                                                HDFF_U_C_M2R0_6mm
R756TN-TCO-C7PV      France     NX.KECEF.004                           5MAF MIPI
                                                01TN

Model Definition and Configuration                                                   7-14

   Table 7-23.   Camera (UMA2C5MkkR_5LT(KEC)) (Continued)
       Model          Country    Acer Part No          Camera               Camera 2

                                                HDFF_U_C_M2R0_6mm
R756TN-TCO-P6NA      France     NX.KECEF.007                              5MAF MIPI
                                                01TN
                                                HDFF_U_C_M2R0_6mm
R756TN-TCO-P9T7      France     NX.KECEF.006                              5MAF MIPI
                                                01TN
                                                HDFF_U_C_M2R0_6mm
R756TN-TCO-P000      France     NX.KECEF.008                              5MAF MIPI
                                                01TN
                                                HDFF_U_C_M2R0_6mm
R756TN-TCO-P62B      France     NX.KECEF.009                              5MAF MIPI
                                                01TN
                                                HDFF_U_C_M2R0_6mm
R756TN-TCO-P8PT      France     NX.KECEF.00A                              5MAF MIPI
                                                01TN

   Table 7-24.   NB Chipset, Battery, Adapter (UMA2C5MkkR_5LT(KEC))
       Model          Country    Acer Part No   NB Chipset      Battery       Adapter

                                                none NB                      45W_PD_B
R756TN-TCO-P17X       Holland   NX.KECEH.001                 50Wh_150301
                                                Chipset                      K_TCO9.0
                                                none NB                      45W_PD_B
R756TN-TCO-C0LJ       France    NX.KECEF.003                 50Wh_150301
                                                Chipset                      K_TCO9.0
                                                none NB                      45W_PD_B
R756TN-TCO-C4H0       France    NX.KECEF.002                 50Wh_150301
                                                Chipset                      K_TCO9.0
                                                none NB                      45W_PD_B
R756TN-TCO-C8EM       France    NX.KECEF.001                 50Wh_150301
                                                Chipset                      K_TCO9.0
                                                none NB                      45W_PD_B
R756TN-TCO-C0BD       France    NX.KECEF.005                 50Wh_150301
                                                Chipset                      K_TCO9.0
                                                none NB                      45W_PD_B
R756TN-TCO-C7PV       France    NX.KECEF.004                 50Wh_150301
                                                Chipset                      K_TCO9.0
                                                none NB                      45W_PD_B
R756TN-TCO-P6NA       France    NX.KECEF.007                 50Wh_150301
                                                Chipset                      K_TCO9.0
                                                none NB                      45W_PD_B
R756TN-TCO-P9T7       France    NX.KECEF.006                 50Wh_150301
                                                Chipset                      K_TCO9.0
                                                none NB                      45W_PD_B
R756TN-TCO-P000       France    NX.KECEF.008                 50Wh_150301
                                                Chipset                      K_TCO9.0
                                                none NB                      45W_PD_B
R756TN-TCO-P62B       France    NX.KECEF.009                 50Wh_150301
                                                Chipset                      K_TCO9.0
                                                none NB                      45W_PD_B
R756TN-TCO-P8PT       France    NX.KECEF.00A                 50Wh_150301
                                                Chipset                      K_TCO9.0

7-15                                                 Model Definition and Configuration

         CHAPTER 8
Test Compatible Components

      Chrome OS Environment Test . . . . . . . . . . . . . . . . . . . . . . . . . . . 8-4

8-2

Test Compatible Components
   This computer’s compatibility is tested and verified by Acer’s internal testing
   department. All of its system functions are tested under Chrome OS environment.
   Refer to the following lists for components, adapter cards, and peripherals which have
   passed these tests. Regarding configuration, combination and test procedures, please
   refer to the Acer Chromebook R756T/R756TN. Compatibility Test Report released by the
   Acer Mobile System Testing Department.

Test Compatible Components                                                            8-3

Chrome OS Environment Test                                                             0

      Table 8-1.   Test Compatible Components
         Vendor              Type                  Description              Part No.

A Cover
                       Shale Black 11   Quanta A cover Shale Black 11
10001028 QUANTA                                                         NC.21011.12G
                       P+R Texture      P+R Texture
Accessory
                       Active Stylus
                                        Acer Active Stylus Pen
60059218 WACOM         Pen                                              NC.23811.09R
                                        ESP-233-02B-6 USI 1.0
                       AU1.0GL0ET
                       PRIMETEK Sim
10423762                                PRIMETEK PRIMETEK Sim Card
                       Card Ejector                                     NC.23811.0AK
PRIMETEK                                Ejector with Packing
                       with Packing
Adapter
                                        Adapter DELTA ADP-45HG BA
60035715                                45W Type C Brick
                       45W_Google PD                                    KP.04501.023
DELTA-SINGAPORE                         5V/3A_9V/3A_12V/3A_15V/3A_2
                                        0V_2.25A Black
                                        Adapter LITE-ON PA-1450-50AD
60036752 LITE-ON                        45W Type C Brick
                       45W_Google PD                                    KP.04503.014
SINGAPORE                               5V/3A_9V/3A_12V/3A_15V/3A_2
                                        0V/3A Black
                                        Adapter Chicony Power
60016453                                A045RP05P 45W Type C Brick
                       45W_Google PD                                    KP.0450H.012
CHICONY POWER                           5V/3A_9V/3A_12V/3A_15V/3A_2
                                        0V_2.25A Black
                                        Adapter LITE-ON PA-1450-50A9
60036752 LITE-ON       45W_PD_BK_TC     45W Type C Brick
                                                                        KP.04503.017
SINGAPORE              O9.0             5V/3A_9V/3A_12V/3A_15V/3A_2
                                        0V_2.25A Black ,TCO9.0
                                        Adapter Chicony Power
60016453               45W_PD_BK_TC     A045RP50P 45W Type C Brick
                                                                        KP.0450H.018
CHICONY POWER          O9.0             5V/3A_9V/3A_12V/3A_15V/3A_2
                                        0V_2.25A Black ,TCO9.0
Audio Codec
10000981 MISC          Non-AVAP
                                        Non-AVAP Audio Codec WW         NC.21011.00V
(END USER)             Audio Codec
B Cover
                       Shale Black 11
                                        QUANTA B cover Shale Black 11
10001028 QUANTA        PC+ABS Texture                                   NC.21011.0R3
                                        PC+ABS Texture w/ Camera
                       w/ Camera

8-4                                                          Test Compatible Components

   Table 8-1.   Test Compatible Components (Continued)
      Vendor               Type                 Description              Part No.

Battery
                                     Battery LGES Typ.50Wh
60070657 LG                          4470mAh 3S1P AP18C8K
                    3CELL4.2                                          KT.0030G.020
ENERGY                               248x84.4x5.5(mm) AP18C 11.25V
                                     65W Polymer
                                     Battery CosMx Typ.53Wh 3S1P
60069689 COSMX                       AP20CBL 248x84.4x5.5(mm)
                    3CELL4.59                                         KT.0030B.004
BATTERY                              AP20C 11.55V 65W Li-Ion TI
                                     BQ40Z555 FW5.09
10000981 MISC                                                         KT.DUM00.03
                    50Wh_150300      Battery 50Wh_150300 Dummy
(END USER)                                                            3
10000981 MISC                                                         KT.DUM00.04
                    50Wh_150301      Battery 50Wh_150301 Dummy
(END USER)                                                            5
C Cover
                    Shale Black 11   Quanta C cover Shale Black 11
10001028 QUANTA                                                       NC.21011.191
                    P+R Texture      P+R Texture
Camera
                                     Camera CHICONY HD Camera
                                     CNFLH35-2 GC1009 RTS5855
10256402            HDFF_U_C_M2R
                                     1L3B059F2 (BG)                   KS.0HD06.038
CHICONY             0_6mm01TN
                                     KMM4030102664DN9 TNR
                                     Chrome V1.0 (ROI)
                                     Camera Tech-Front HD Camera
                                     YHV-3 HM1091C SPCA2112N
10174742            HDFF_U_C_M2R
                                     DS-31041M(BG)                    KS.0HD0Q.026
TECH-FRONT(CQ)      0_6mm01TN
                                     KMM4030102664DN9 TNR ,
                                     Chrome V1.0 (ROI)
Camera 2
                                     Camera Tech-Front 5M AF MIPI
10174742
                    5MAF MIPI        Camera TF_OV05675_AOET           KS.05M0Q.002
TECH-FRONT(CQ)
                                     1L4D030B1
CPU
                                     CPU(BGA) Intel Intel Processor
                                     N100 BGA 3.4 GHz 2M 6W N0
10001067 INTEL      N100                                              KC.N1001.000
                                     Alder Lake-N 99C62J MM
                                     #99C62J
                                     CPU(BGA) Intel Intel Processor
                                     N200 BGA 3.7 GHz 2M 6W N0
10001067 INTEL      N200                                              KC.N2001.000
                                     Alder Lake-N 99C62K MM
                                     #99C62K

Test Compatible Components                                                          8-5

      Table 8-1.   Test Compatible Components (Continued)
         Vendor              Type                  Description              Part No.

D Cover
                       Shale Black 11
                                        QUANTA D cover Shale Black 11
10001028 QUANTA        PC+ABS Texture                                    NC.21011.0R5
                                        PC+ABS Texture BB
                       BB
Digital Mic
10000981 MISC                           Dual Digital Mic (Built on
                       Digital Mic                                       NC.26711.001
(END USER)                              Camera Module)
G Sensor
                       G sensor
PLM00016 Bosch                          G Sensor - Bosch - BMA422        NC.23711.00N
                       BMA422
Gyroscope
                       G+Gyro Sensor
PLM00016 Bosch                          G+Gyro Sensor - Bosch - BMI323   NC.25111.00E
                       BMI323
HDD
                                        eMMC KINGSTON NAND 128GB
60035660
                       eMMC128GB        EMMC128-TY29-PA5B LF+HF          KN.12807.036
KINGSTON
                                        FW: PA5B
                                        eMMC WD NAND 128GB
60070114 WDSG          eMMC128GB        SDINBDV4-1281220VT LF+HF         KN.1280D.016
                                        FW: RC30B007
                                        eMMC KINGSTON NAND 32GB
60035660
                       eMMC32GB         EMMC32G-TX29-PA8B LF+HF          KN.03207.025
KINGSTON
                                        FW: PA8B
                                        eMMC WD NAND 32GB
60070114 WDSG          eMMC32GB         SDINBDV4-32-1220VT LF+HF         KN.0320D.011
                                        F/W: RC30B007
                                        eMMC KINGSTON NAND 64GB
60035660
                       eMMC64GB         EMMC64G-TY29-PA5B LF+HF          KN.06407.014
KINGSTON
                                        FW: PA5B
                                        eMMC WD NAND 64GB
60070114 WDSG          eMMC64GB         SDINBDV4-64-1220VT LF+HF         KN.0640D.013
                                        F/W: RC30B007
Keyboard
                                        Phantom KB SUNREX
                                        AD01G_C21B AD01G Internal 11
60052236 SUNREX        AD01G_C21B       Standard Black Chrome OS for     NK.I111S.0MX
                                        Full Size EDU anchored frameV0
                                        lock
LAN
10000981 MISC          none LAN         LAN none LAN without LAN         NI.22400.051

8-6                                                          Test Compatible Components

   Table 8-1.   Test Compatible Components (Continued)
      Vendor             Type                Description              Part No.

LCD
                                    LED LCD Panel HENGHAO 11.6"
                                    WXGA IPS Glare
60043733            N11.6HDGSUPI/   HD-L116HM03-F5PA/B116XAN06
                                                                   KL.1160H.021
HENGHAO             TP1U5AM         .1 /(HW:0A) 200nit NTSC 50%
                                    60Hz 25ms 800:1 (OFM/AM GG3
                                    0.55t/Elan 7B18U/HID-I2C)
                                    LED Touch Panel AUO 11.6" HD
                    N11.6HDGSUPI/   IPS Glare 116XAB01.4 H/W:2B
60003316 AUO                                                       KL.11605.066
                    TP3NAM          235nit NTSC 50% 60Hz 25ms
                                    800:1 (oTP2)
                                    LED LCD Panel HENGHAO 11.6"
                                    WXGA IPS Glare
60043733            N11.6HDGSUPI/   HD-L116HM06-F5PA/B116XAN06
                                                                   KL.1160H.022
HENGHAO             TP3NAM          .1 /(HW:0A) 200nit NTSC 50%
                                    60Hz 25ms 800:1 (GFF/AM GG3
                                    0.55t/Elan3912N/HID-I2C)
Memory
                                    Mobile Memory MICRON
60002050 MICRON     LPDDR5_2GB_31   LPDDR5 6400 2GB
                                                                   KN.2GB04.027
SG                  5b              MT62F512M32D2DR-031 WT:B
                                    LF+HF Y31M
                                    Mobile Memory SAMSUNG
60002215            LPDDR5_2GB_31
                                    LPDDR5 5500 2GB                KN.2GB0B.047
SAMSUNG             5b
                                    K3LKLKL0EM-MGCN LF+HF 1y
                                    Mobile Memory HYNIX LPDDR5
60002045 SK         LPDDR5_2GB_31   6400 2GB
                                                                   KN.2GB0G.060
HYNIX               5b              H9JCNNNBK3MLYR-N6E LF+HF
                                    DA
                                    Mobile Memory LPDDR5 4GB
10000981 MISC       LPDDR5_4GB(2G
                                    Dummy (x32_2GBx2) LF+HF        KN.4GB00.037
(END USER)          Bx2)
                                    Dummy
                                    Mobile Memory MICRON
60002050 MICRON     LPDDR5_4GB_31   LPDDR5 6400 4GB
                                                                   KN.4GB04.028
SG                  5b              MT62F1G32D4DR-031 WT:B
                                    LF+HF Y31M
                                    Mobile Memory SAMSUNG
60002215            LPDDR5_4GB_31
                                    LPDDR5 6400 4GB                KN.4GB0B.055
SAMSUNG             5b
                                    K3LKBKB0BM-MGCP LF+HF D1z
                                    Mobile Memory HYNIX LPDDR5
60002045 SK         LPDDR5_4GB_31   6400 4GB
                                                                   KN.4GB0G.057
HYNIX               5b              H9JCNNNCP3MLYR-N6E LF+HF
                                    DA

Test Compatible Components                                                       8-7

      Table 8-1.   Test Compatible Components (Continued)
         Vendor              Type                   Description                 Part No.

                                         Mobile Memory LPDDR5 8GB
10000981 MISC          LPDDR5_8GB(4G
                                         Dummy (x32_4GBx2) LF+HF             KN.8GB00.039
(END USER)             Bx2)
                                         Dummy
NB Chipset
10000981 MISC                            NB Chipset none NB Chipset
                       none NB Chipset                                       KI.22600.054
(END USER)                               without NB Chipset
Packaging
60059923 SEN HSIN      2023-Brown Box    2023 Brown Box SY Rev 1.0           NC.25811.192
Speaker
10000981 MISC
                       Speaker           Stereo Speaker                      NC.24211.002
(END USER)
Touchpad
                                         Elantech Chromebook 13
60040786
                       CP3CIG3M          CP3CIG3M SA459C-12C0                NC.24611.04K
ELANTECH
                                         104x59x0.86mm 6-pin Moisture
                                         Synaptics Chromebook 13
60040547
                       CP3CIG3M          CP3CIG3M TM-03509-001               NC.24611.050
SYNAPTICS
                                         104x59x0.86mm 6-pin Moisture
Touchpad Surface
                                         Sankai Touchpad surface Green
10923599
                       Green Mylar       Mylar, Glass-Like and Ocean         NC.26911.001
KUNSHAN SANKAI
                                         bound PET
TPM
                       TPM H1 None
PLM00014 ODM                             None AVAP TPM H1 None AVAP          NC.22911.00G
                       AVAP
VGA Chip
10001067 INTEL         UMA               UMA (Intel)                         KI.23200.038
WiFi Antenna
                                         WNC Wifi6E PCB WiFi Antenna
10000105 WNC           Wifi6E PCB 0.7                                        NC.23511.01A
                                         0.7
Wireless LAN
                                         Wireless LAN Intel Wi-Fi 6E BT5.2
                       WIFI 6E 2X2 BT
10001067 INTEL                           AX211.D2WG.NV Intel 2x2 M.2         KE.WF60N.004
                       INTEL CNVi SD
                                         1216 SD CNVi GFP2 No vPro
WWAN
10489622                                 LTE Fibocom LTE FM101-GL
                       FM101-GL                                              KI.LTE0F.002
FIBOCOM                                  FM101-GL

8-8                                                           Test Compatible Components

   Table 8-1.   Test Compatible Components (Continued)
      Vendor             Type                Description        Part No.

WWAN Antenna
                    4GLTE WWAN      WNC 4GLTE WWAN Antenna
10000105 WNC                                                 NC.26511.001
                    152             (PCB)

Test Compatible Components                                                 8-9

        CHAPTER 9
Online Support Information

Introduction . . . . . . . . . . . . . . . . . . . . . . . . . . . . . . . . . . . . . . . . . 9-3

                                                                                                9-2

Online Support Information

Introduction                                                                                          0

      This section describes online technical support services available to help users repair their
      Acer Systems.
      For distributors, dealers, ASP or TPM, please refer the technical queries to a local Acer
      branch office. Acer Branch Offices and Regional Business Units may access our website.
      However some information sources will require a user i.d. and password. These can be
      obtained directly from Acer CSD Taiwan.
      Acer's Website offers convenient and valuable support resources.
      In the Technical Information section users can download information on all of Acer's
      Notebook, Desktop and Server models including:
         Service guides for all models

         Bios updates

         Software utilities

         Spare parts lists

         TABs (Technical Announcement Bulletin)

      For these purposes, we have included an Acrobat File to facilitate the problem-free
      downloading of our technical material.
      Also contained on this website are:
         Detailed information on Acer's International Traveller’s Warranty (ITW)

         Returned material authorization procedures

         An overview of all the support services we offer, accompanied by a list of
            telephone, fax and email contacts for all technical queries.
      We are always looking for ways to optimize and improve our services, so do not hesitate
      to direct any suggestions or comments to us.

9-3                                                                  Online Support Information
