fingoldin/lpddr5-testbed/references/hs_design/Altera_AN224_HighSpeed_Board_Layout_Guidelines.txt

                                                               High-Speed Board
                                                               Layout Guidelines

August 2009, ver. 1.2                                                        Application Note 224

Introduction            As both device pin density and system frequency increase, printed circuit
                        board (PCB) layout becomes more complex. A successful high-speed
                        board must effectively integrate the devices and other elements while
                        avoiding signal transmission problems associated with high-speed I/O
                        standards. Because Altera® devices feature fast I/O pins, a wide variety of
                        high-speed features, and edge rates less than a hundred picoseconds, it is
                        imperative that an effective design successfully:

                        ■     Reduces system noise by filtering and evenly distributing power to
                              all devices
                        ■     Terminates the signal line to diminish signal reflection
                        ■     Minimizes crosstalk between parallel traces
                        ■     Reduces the effects of ground bounce
                        ■     Matches impedance

                        This application note discusses the following issues and provides
                        guidelines for successful, effective board design using Altera devices:

                        ■     Material selection
                        ■     Transmission line
                        ■     Routing scheme for minimizing crosstalk and maintaining signal
                              integrity
                        ■     Termination schemes
                        ■     Simultaneous switching noise (SSN)
                        ■     Additional FPGA-specific board design/signal integrity tips

Material                Fast edge rates contribute to noise and crosstalk, depending on the PCB
                        dielectric construction material. Dielectric material can be assigned a
Selection               dielectric constant (r) that is related to the force (i.e., Equation 1) of
                        attraction between two opposite charges separated by a distance in a
                        uniform medium.

                            Equation 1:
                                                              Q1Q2
                                                         F=
                                                              4πεr2

                        Where Q1, Q2 = charges, r = distance between the charges (m), F = force
                        (N),  = permittivity of dielectric (F/m)

Altera Corporation                                                                                    1

AN-224-1.2

AN 224: High-Speed Board Layout Guidelines

                         Each PCB substrate has a different relative dielectric constant. The
                         dielectric constant is the permittivity of a relative to that of empty space
                         (i.e., Equation 2).

                             Equation 2:
                                                                     ε
                                                            εr =
                                                                    εo

                         Where r = dielectric constant, o = permittivity of empty space (F/m), 
                          = permittivity (F/m).
                         The dielectric constant compares the effect of an insulator on the
                         capacitance of a conductor pair, to the capacitance of the conductor pair in
                         a vacuum. The dielectric constant affects the impedance of a transmission
                         line, and signals can propagate faster in materials that have a lower r .

                         A high-frequency signal that propagates through a long line on the PCB
                         from driver to receiver is severely affected by the loss tangent of the
                         dielectric material. A large loss tangent means higher dielectric
                         absorption. Material with a high loss tangent value affects the high-
                         frequency signal on a long line. Dielectric absorption increases
                         attenuation at higher frequencies. Table 1 shows the loss tangent value for
                         FR-4 and GETEK materials.

                         The most widely used dielectric material for PCBs is FR-4, a glass laminate
                         with epoxy resin that meets a wide variety of processing conditions. The
                         r for FR-4 is between 4.1 and 4.5. GETEK is another material that can be
                         used in high-speed boards. GETEK is composed of epoxy and resin
                         (polyphenylene oxide) and has an r between 3.6 and 4.2.

                           Table 1. Loss Tangent Value of FR4 & GETEK Materials

                                  Manufacturer                     Material       Loss Tangent Value
                          GE Electromaterials           GETEK                  0.010 @ 1 MHz
                          Isola Laminate Systems        FR-4                   0.019 @ 1 MHz

Transmission             The transmission line is a trace, and has a distributed mixture of resistance
                         (R), inductance (L), and capacitance (C). There are two types of
Line                     transmission line layouts:

                         ■     Microstrip
                         ■     Stripline

2                                                                                  Altera Corporation

                                                        AN 224: High-Speed Board Layout Guidelines

                     Figure 1 shows a microstrip layout, which refers to a trace routed as the
                     top or bottom layer of a PCB and has only one voltage-reference plane
                     (i.e., power or GND). Figure 2 shows a stripline layout, which uses a trace
                     routed on the inside layer of a PCB and has two voltage-reference planes
                     (i.e., power and/or GND).

                     Figure 1. Microstrip Transmission Line Layout            Note (1)

                                                                          W

                                        Trace                                             T

                                                                                                          H
                           Dialectric Material

                                 Power/GND

                     Figure 2. Stripline Transmission Line Layout          Note (2)

                                                         W

                                                                                         Power/Ground

                             H                   T                                       Trace
                                                                                         Dielectric Material
                                                                                         Power/Ground

                     Notes to Figures 1 & 2:
                     (1)   W = width of trace, T = thickness of trace, and H = height between trace and
                           reference plane.
                     (2)   W = width of trace, T = thickness of trace, and H = height between trace and two
                           reference planes.

                     Impedance Calculation
                     Any circuit trace on the PCB has characteristic impedance associated with
                     it. This impedance is dependent on width (W) of the trace, thickness (T) of
                     the trace, dielectric constant (r) of the material used, and height (H)
                     between the trace and reference plane.

Altera Corporation                                                                                             3

AN 224: High-Speed Board Layout Guidelines

                           Microstrip Impedance
                           A circuit trace routed on an outside layer of the PCB with a reference plane
                           (i.e., GND or VCC) below it, constitutes a microstrip layout. Use
                           Equation 3 to calculate the impedance of a microstrip trace layout.

                                 Equation 3: .
                                                                                  5.98 × H
                                                   Z0 =     87
                                                           εr + 1.41
                                                                        ln
                                                                              (   0.8W + T   )     Ω

                           Using typical values of W = 8 mil, H = 5 mil, T = 1.4 mil, r and 
                           (FR-4) = 4.1 with Equation 3 and solving for microstrip impedance (Zo)
                           yields:

                                                                                  5.98 × (5)
                                                   Z0 =        87
                                                           4.1 + 1.41
                                                                        ln
                                                                              (   0.8(8) + 1.4     )   Ω

                                                   Z0 ~ 50 Ω

                           1            The measurement unit in Equation 3 is mils (i.e., 
                                        1 mil = .001 inches). Also, copper (Cu) trace thickness (T) is
                                        usually measured in ounces (i.e., 1 oz = 1.4 mil).

                           Figure 3 shows microstrip trace impedance vs. trace width (W) using the
                           values in Equation 3, keeping dielectric height and trace thickness
                           constant.

Figure 3. Microstrip Trace Impedance with Changing Trace Width
         80

         70

         60

         50
                                                                                                                            Z0
Z0 (Ω)   40                                                                                                          T = 1.4 mils
                                                                                                                     H = 5.0 mils
         30

         20

         10

          0

               4     4.5     5       5.5     6      6.5     7           7.5        8         8.5           9

                                                 W (mil)

4                                                                                                              Altera Corporation

                                                                      AN 224: High-Speed Board Layout Guidelines

                           Figure 4 shows microstrip trace impedance vs. height (H), using the
                           values in Equation 3, keeping trace width and trace thickness constant.

Figure 4. Microstrip Trace Impedance with Changing Height
            80

            70

            60

            50
                                                                                                              Z0
  Z0 (Ω)    40                                                                                         T = 1.4 mils
                                                                                                       W = 8.0 mils
            30

            20

            10

             0

                    4     5           6                   7              8           9        10

                                            H (mil)

                           The impedance graphs show that the change in impedance is inversely
                           proportional to trace width and directly proportional to trace height
                           above the ground plane.

                           Figure 5 plots microstrip trace impedance vs. trace thickness (T) using the
                           values in Equation 3, keeping trace width and dielectric height constant.
                           Figure 5 shows that as trace thickness increases, trace impedance
                           decreases.

Figure 5. Microstrip Trace Impedance with Changing Trace Thickness

                    60

                    50

                    40
                                                                                                     Z0
           Z0 (Ω)   30                                                                        H = 5.0 mils
                                                                                              W = 8.0 mils
                    20

                    10

                    0

                         0.7              1.4                   2.8            4.2
                                                      T (mil)

Altera Corporation                                                                                                    5

AN 224: High-Speed Board Layout Guidelines

                           Stripline Impedance

                           A circuit trace routed on the inside layer of the PCB with two low-voltage
                           reference planes (i.e., power and/or GND) constitutes a stripline layout.
                           You can use Equation 4 to calculate the impedance of a stripline trace
                           layout.

                               Equation 4:
                                                                                  4H
                                              Zo =     60
                                                       εr
                                                              ln
                                                                    (    0.67    (T + 0.8W )       )   Ω

                           Using typical values of W = 9 mil, H = 24 mil, T = 1.4 mil, r and 
                           (FR-4) = 4.1 with Equation 4 and solving for stripline impedance (Z o)
                           yields:

                                               Zo=     60
                                                        4.1
                                                              ln
                                                                     (   0.67
                                                                                4 (24)
                                                                                 (1.4) + 0.8(9)    )   Ω

                                               Zo ~ 50 Ω

                           Figure 6 shows impedance vs. trace width using Equation 4, keeping
                           height and thickness constant for stripline trace.

Figure 6. Stripline Trace Impedance with Changing Trace Width
         80

         70

         60

         50
                                                                                                                         Z0
Z0 (Ω)   40                                                                                                       T = 1.4 mils
                                                                                                                  H = 24.0 mils
         30

         20

         10

         0

              4    4.5     5     5.5    6       6.5     7          7.5     8        8.5        9       10

                                             W (mil)

6                                                                                                          Altera Corporation

                                                                 AN 224: High-Speed Board Layout Guidelines

                            Figure 7 shows stripline trace impedance vs. dielectric height (H) using
                            Equation 4, keeping trace width and trace thickness constant.

Figure 7. Stripline Trace Impedance with Changing Dielectric Height
          80

          70

          60

          50
                                                                                                        Z0
 Z0 (Ω)   40                                                                                     T = 1.4 mils
                                                                                                 W = 9.0 mils
          30

          20

          10

          0

               16      20         24         28             32         36        40        44

                                                  H (mil)

                            As with microstrip layout, the stripline layout impedance also changes
                            inversely proportional to line width and directly proportional to height.
                            However, the rate of change with trace height above GND is much slower
                            in a stripline layout compared with a microstrip layout. A stripline layout
                            has a signal sandwiched by FR-4 material, whereas a microstrip layout has
                            one conductor open to air. This exposure causes a higher, effective
                            dielectric constant stripline layout compared to microstrip layouts. Thus,
                            to achieve the same impedance, the dielectric span must be greater in
                            stripline layouts compared with microstrip layouts. Therefore, stripline-
                            layout PCBs with controlled impedance lines are thicker than microstrip-
                            layout PCBs.

Altera Corporation                                                                                              7

AN 224: High-Speed Board Layout Guidelines

                            Figure 8 shows stripline trace impedance vs. trace thickness using
                            Equation 4, keeping trace width and dielectric height constant. Figure 8
                            shows that the characteristic impedance decreases as the trace thickness
                            increases.

Figure 8. Stripline Trace Impedance with Changing Trace Thickness
                60

                50

                40
                                                                                                     Z0
       Z0 (Ω)   30                                                                            H = 24.0 mils
                                                                                              W = 9.0 mils
                20

                10

                0

                           0.7             1.4             2.8               4.2
                                                 T (mil)

                            Propagation Delay
                            Propagation delay (tPD) is the time required for a signal to travel from one
                            point to another. Transmission line propagation delay is a function of the
                            dielectric constant of the material.

                            Microstrip Layout Propagation Delay
                            You can use Equation 5 to calculate the microstrip trace layout
                            propagation delay.

                                 Equation 5:
                                                   tPD (microstrip) = 85     0.475εr + 0.67

                            Stripline Layout Propagation Delay
                            You can use Equation 6 to calculate the stripline trace layout propagation
                            delay.

                                 Equation 6:
                                                      tPD (stripline) = 85     εr

8                                                                                             Altera Corporation

                                                             AN 224: High-Speed Board Layout Guidelines

                             Figure 9 shows the propagation delay vs. the dielectric constant for
                             microstrip and stripline traces. As the r increases, the propagation delay
                             (tPD) also increases.

Figure 9. Propagation Delay vs. Dielectric Constant for Microstrip & Stripline Traces
              300

              250

              200                                                                              Microstrip
                                                                                               Stripline
 tPD (ps/inch) 150                                                                      T = 1.4
                                                                                        Z0 = 50 Ω
                                                                                        Wstripline = 9.0 mils
              100                                                                       Wmicrostrip = 8.0 mils

               50

                0

                     1      2       3      4      5      6      7      8      9

                                                 εr

                             Pre-Emphasis
                             Typical transmission media like copper trace and coaxial cable have low
                             pass characteristics, so they attenuate higher frequencies more than lower
                             frequencies. A typical digital signal that approximates a square wave
                             contains high frequencies near the switching region and low frequencies
                             in the constant region. When this signal travels through low pass media,
                             its higher frequencies are attenuated more than the lower frequencies,
                             resulting in increased signal rise times. Consequently, the eye opening
                             narrows and the probability of error increases.

                             The high-frequency content of a signal is also degraded by what is called
                             “skin effect.” The cause of skin effect is the high-frequency current that
                             flows primarily on the surface (skin) of a conductor. The changing current
                             distribution causes the resistance to increase as a function of frequency.

                             You can use pre-emphasis to compensate for the skin effect. By Fourier
                             analysis, a square wave signal contains an infinite number of frequencies.
                             The high frequencies are located in the low-to-high and high-to-low
                             transition regions and the low frequencies are located in the flat (constant)
                             regions. Increasing the signal’s amplitude near the transition region
                             emphasizes higher frequencies more than the lower frequencies. When
                             this pre-emphasized signal passes through low pass media, it will come
                             out with minimal distortion, if you apply the correct amount of pre-
                             emphasis. See Figure 10 for a graphical illustration of this concept.

Altera Corporation                                                                                               9

AN 224: High-Speed Board Layout Guidelines

Figure 10. Input & Output Signals with & without Pre-Emphasis
                                          |H (jw)|

                                          1
                                                                      Signal is attenuated
                                                                      at high frequencies.

                                                                       W

       Input Vi (t)                                                                                      Output Vo(t)

                                                  Transmission Line

                        Vi (t)                                           Vo (t)

                                                  t                                                t

                      Input signal approximates                        Output signal has higher rise time,
                      a square wave but has no                         and the eye opening is smaller.
                      pre-emphasis.

                        Vi (t)                                           Vo (t)

                                                  t                                                t

                      Input signal has pre-emphasis.                  Output signal has similar rise
                                                                      time and eye opening as input
                                                                      signal.

10                                                                                                           Altera Corporation

                                                                   AN 224: High-Speed Board Layout Guidelines

                                 StratixTM GX devices provide programmable pre-emphasis to compensate
                                 for variable lengths of transmission media. You can set the pre-emphasis
                                 to be between 5% and 25%, depending on the value of the output
                                 differential voltage (VOD ). Table 2 shows the available Stratix GX
                                 programmable pre-emphasis settings.

                                      Table 2. Programmable Pre-Emphasis with Stratix GX Devices

                                          VOD                            Pre-emphasis Setting
                                                       5%          10%           15%             20%    25%
                                          400           420         440           460             480    500
                                          480           504         528           552             576    600
                                          600           630         660           690             720    750
                                          800           840         880           920             960   1,000
                                          960         1,008        1,056        1,104           1,152   1,200
                                         1,000        1,050        1,100        1,150           1,200   1,250
                                         1,200        1,260        1,320        1,380           1,440   1,500
                                         1,400        1,470        1,540           -               -      -
                                         1,440        1,512        1,584           -               -      -
                                         1,500        1,575          -             -               -      -
                                         1,600           -           -             -               -      -

Routing                          Crosstalk is the unwanted coupling of signals between parallel traces.
                                 Proper routing and layer stack-up through microstrip and stripline
Scheme For                       layouts can minimize crosstalk.
Minimizing                       To reduce crosstalk in dual-stripline layouts, which have two signal layers
Crosstalk &                      next to each other (see Figure 11), route all traces perpendicular, increase
                                 the distance between the two signal layers, and minimize the distance
Maintaining                      between the signal layer and the adjacent reference plane.
Signal Integrity

Figure 11. Dual-Stripline Layout
                        W                                                                W

                                                       Ground

                                                        Trace                                                   H
                                                      Dialectric
                                                      Material
                                                       Ground
            Single-Stripline Layout                                            Dual-Stripline Layout

Altera Corporation                                                                                              11

AN 224: High-Speed Board Layout Guidelines

                         Use the following steps to reduce crosstalk in either microstrip or stripline
                         layouts:

                         ■    Widen spacing between signal lines as much as routing restrictions
                              will allow. Try not to bring traces closer than three times the dielectric
                              height.
                         ■    Design the transmission line so that the conductor is as close to the
                              ground plane as possible. This technique will couple the transmission
                              line tightly to the ground plane and help decouple it from adjacent
                              signals.
                         ■    Use differential routing techniques where possible, especially for
                              critical nets (i.e., match the lengths as well as the gyrations that each
                              trace goes through).
                         ■    If there is significant coupling, route single-ended signals on different
                              layers orthogonal to each other.
                         ■    Minimize parallel run lengths between single-ended signals. Route
                              with short parallel sections and minimize long, coupled sections
                              between nets.

                         Crosstalk also increases when two or more single-ended traces run
                         parallel and are not spaced far enough apart. The distance between the
                         centers of two adjacent traces should be at least four times the trace width,
                         as shown in Figure 12. To improve design performance, lower the
                         distance between the trace and the ground plane to under 10 mils without
                         changing the separation between two traces.

                         Figure 12. Separating Traces for Crosstalk
                                             A                                     A

                                                               4A

                         Compared with high dielectric materials, low dielectric materials help
                         reduce the thickness between the trace and ground plane while
                         maintaining signal integrity. Figure 13 plots the relationship of height vs.
                         dielectric constant using Equations 3 and 4, keeping impedance, width,
                         and thickness constant.

12                                                                                     Altera Corporation

                                                              AN 224: High-Speed Board Layout Guidelines

Figure 13. Height vs. Dielectric Constant
           30

           25

                                                                                             Microstrip
           20
                                                                                             Stripline
                                                                                      T = 1.4
 H (mil)   15
                                                                                      Z0 = 50 Ω
                                                                                      Wstripline = 9.0 mils
           10                                                                         Wmicrostrip = 8.0 mils

           5

           0

                     2.2          2.9         3.3           4.1       4.5

                                              εr

                             Signal Trace Routing

                             Proper routing helps to maintain signal integrity. To route a clean trace,
                             you should perform simulation with good signal integrity (SI) tools. The
                             following section describes the two different types of signal traces
                             available for routing:

                             ■    Single-ended trace
                             ■    Differential pair trace

                             Single-Ended Trace Routing

                             A single-ended trace connects the source and the load/receiver. Single-
                             ended traces are used in general point-to-point routing, clock routing,
                             low-speed, and non-critical I/O routing. This section discusses different
                             routing schemes for clock signals. You can use the following types of
                             routing to drive multiple devices with the same clock.

                             ■    Daisy chain routing
                                  –    With stub
                                  –    Without stub
                             ■    Star routing
                             ■    Serpentine routing

Altera Corporation                                                                                         13

AN 224: High-Speed Board Layout Guidelines

                         Use the following guidelines to improve the clock transmission line’s
                         signal integrity:

                         ■     Keep clock traces as straight as possible. Use arc-shaped traces
                               instead of right-angle bends.
                         ■     Do not use multiple signal layers for clock signals.
                         ■     Do not use vias in clock transmission lines. Vias can cause impedance
                               change and reflection.
                         ■     Place a ground plane next to the outer layer to minimize noise. If you
                               use an inner layer to route the clock trace, sandwich the layer between
                               reference planes.
                         ■     Terminate clock signals to minimize reflection.
                         ■     Use point-to-point clock traces as much as possible.

                         Daisy Chain Routing With Stubs
                         Daisy chain routing is a common practice in designing PCBs. One
                         disadvantage of daisy chain routing is that stubs, or short traces, are
                         usually necessary to connect devices to the main bus (see Figure 14). If a
                         stub is too long, it will induce transmission line reflections and degrade
                         signal quality. Therefore, the stub length should not exceed the following
                         conditions:

                         TDstub < (T 10% to 90%)/3

                         Where TDstub = Electrical delay of the stub
                              T10% to 90% = Rise or fall time of signal edge

                         For a 1-ns rise-time edge, the stub length should be less than 0.5 inches
                         (see “References” on page 33). If your design uses multiple devices, all
                         stub lengths should be equal to minimize clock skew. Figure 14 shows
                         stub routing. If possible, you should avoid using stubs in your PCB
                         design. For high-speed designs, even very short stubs can create signal
                         integrity problems.

                         Figure 14. Daisy Chain Routing with Stubs
                                             Main Bus
                                                                                              Clock
                                                                                             Source

                                                                     Stub

                                                                                           Device Pin
                                                                                           (BGA Ball)
                                                        Device 1              Device 2
                             Termination
                                Resistor

14                                                                                  Altera Corporation

                                                           AN 224: High-Speed Board Layout Guidelines

                            Figures 15 through 17 show the SPICE simulation with different stub
                            length. As the stub length decreases, there is less reflection noise, and the
                            eye opening increases due to less reflection noise.

Figure 15. Stub Length = 0.5 Inch

Figure 16. Stub Length = 0.25 Inch

Figure 17. Stub Length = Zero Inches

Altera Corporation                                                                                    15

AN 224: High-Speed Board Layout Guidelines

                         Daisy Chain Routing without Stub
                         Figure 18 shows daisy chain routing with the main bus running through
                         the device pins, eliminating stubs. This layout removes the risk of
                         impedance mismatch between the main bus and the stubs, minimizing
                         signal integrity problems.

                         Figure 18. Daisy Chain Routing without Stubs
                                          Main Bus
                                                     Device 1              Device 2
                                                                                               Clock
                                                                                              Source

                            Termination                                                    Device Pin
                               Resistor                                                    (BGA Ball)

                         Star Routing
                         In star routing, the clock signal travels to all the devices at the same time
                         (see Figure 19). Therefore, all trace lengths between the clock source and
                         devices must be matched to minimize the clock skew. Each load should be
                         identical to minimize signal integrity problems. In star routing, you must
                         match the impedance of the main bus with the impedance of the long trace
                         that connects to multiple devices.

16                                                                                    Altera Corporation

                                                  AN 224: High-Speed Board Layout Guidelines

                     Figure 19. Star Routing

                                                  Device 1

                                                                         Main Bus

                                                                                     Clock
                                                                                    Source
                         Termination
                            Resistor
                                                  Device 2

                                                  Device 3
                                                                Device Pin
                                                                (BGA Ball)

                     Serpentine Routing
                     When a design requires equal-length traces between the source and
                     multiple loads, you can bend some traces to match trace lengths (see
                     Figure 20). Improper trace bending affects signal integrity and
                     propagation delay. To minimize crosstalk, ensure that S  3  H, where S
                     is the spacing between the parallel sections and H is the height of the
                     signal trace above the reference ground plane. See Figure 21.

Altera Corporation                                                                           17

AN 224: High-Speed Board Layout Guidelines

Figure 20. Serpentine Routing

                                                Device 1
                                                                                                           Clock
                                                                                                          Source
               Termination
                  Resistor
                                                                                               S

                                                                 Device 2
                                      Termination
                                         Resistor

                                     1          Altera recommends avoiding serpentine routing if possible.
                                                Instead, use arcs to create equal-length traces.

                                     Differential Trace Routing
                                     To maximize signal integrity, proper routing techniques for differential
                                     signals are important for high-speed designs. Figure 21 shows a
                                     differential pair using the microstrip layout.

Figure 21. Differential Trace Routing               Note (1)

                      W                    W                       D                    W                    W
                                S                                                                  S

      H                                                    Dielectric Material

                                                                                                                           GND

Note to Figure 21:
(1)       D = Distance between two differential pair signals; W = Width of a trace in a differential pair; S = Distance between
          the trace in a differential pair; and H = Dielectric height above the group plane.

18                                                                                                       Altera Corporation

                                                    AN 224: High-Speed Board Layout Guidelines

                     Use the following guidelines when using two differential pairs:

                     ■   Make sure D > 2S to minimize the crosstalk between the two
                         differential pairs.
                     ■   To minimize reflection noise, place the differential traces S = 3H as
                         they leave the device.
                     ■   Keep the distance between the differential traces (S) constant over the
                         entire trace length.
                     ■   Keep the length of the two differential traces the same to minimize
                         the skew and phase difference.
                     ■   Avoid using multiple vias, because they can cause impedance
                         mismatch and inductance.

Termination          Mismatched impedance causes signals to reflect back and forth along the
                     lines, which causes ringing at the load receiver. The ringing reduces the
Schemes              dynamic range of the receiver and can cause false triggering. To eliminate
                     reflections, the impedance of the source (ZS ) must equal the impedance of
                     the trace (Zo), as well as the impedance of the load (ZL). Stratix devices
                     feature support for on-chip implementation of the resistor. This section
                     discusses the following signal termination schemes:

                     ■   Simple parallel termination
                     ■   Thevenin parallel termination
                     ■   Active parallel termination
                     ■   Series-RC parallel termination
                     ■   Series termination
                     ■   Differential pair termination
                     ■   On-chip termination

                     Simple Parallel Termination

                     In a simple parallel termination scheme, the terminating resistor (RT) is
                     equal to the line impedance. Place the termination resistor as close to the
                     load as possible to be efficient. See Figure 22.

                     Figure 22. Simple Parallel Termination

                                                                Stub

                                       S            Zo = 50 Ω              L

                                                                       RT = Zo

Altera Corporation                                                                            19

AN 224: High-Speed Board Layout Guidelines

                         The stub length from RT to the receiver pin and pads should be as small as
                         possible. A long stub length causes reflections from the receiver pads,
                         resulting in signal degradation. If your design requires a long termination
                         line between the terminator and receiver, the placement of the resistor
                         becomes important. For long termination line lengths, use fly-by
                         termination (see Figure 23).

                         Figure 23. Simple Parallel Fly-By Termination

                                                                      Receiver/ Load
                                                                          Pad
                                          Source          Zo = 50 Ω

                                                                                    RT = Zo

                         Thevenin Parallel Termination
                         An alternative parallel termination scheme uses a Thevenin voltage
                         divider (see Figure 24). The terminating resistor is split between R1 and
                         R2, which equals the line impedance when combined. Although this
                         scheme reduces the current drawn from the source device, it adds current
                         drawn from the power supply because the resistors are tied between VCC
                         and GND.

                         Figure 24. Thevenin Termination
                                                                         VCC

                                                                                Stub

                                                                               R1

                                             S             Zo= 50 Ω                    L

                                                                               R2
                                                     R1    R2 = Zo

20                                                                                         Altera Corporation

                                                    AN 224: High-Speed Board Layout Guidelines

                     As noted in the previous section, stub length is dependent on signal rise
                     and fall time and should be kept to a minimum. If your design requires a
                     long termination line between the terminator and receiver, use fly-by
                     termination or Thevenin fly-by termination. See Figures 23 and 25.

                     Figure 25. Thevenin Fly-By Termination
                                                                      VCC

                                                   Receiver/Load            R1

                                      Source         Zo = 50 Ω                        Pad

                                                                            R2

                     Active Parallel Termination
                     Figure 26 shows an active parallel termination scheme, where the
                     terminating resistor (RT = Zo) is tied to a bias voltage (VBIAS). In this
                     scheme, the voltage is selected so that the output drivers can draw current
                     from the high- and low-level signals. However, this scheme requires a
                     separate voltage source that can sink and source currents to match the
                     output transfer rates.

                     Figure 26. Active Parallel Termination
                                                                   VBIAS

                                                                       RT = Zo

                                        S             Zo = 50 Ω                   L

                                                                           Stub

Altera Corporation                                                                           21

AN 224: High-Speed Board Layout Guidelines

                         Figure 27 shows the active parallel fly-by termination scheme.

                         Figure 27. Active Parallel Fly-By Termination
                                                                                VBIAS

                                                        Receiver/Load               RT = Zo

                                          Source        Zo = 50 Ω

                                                                                              Pad

                         Series-RC Parallel Termination

                         A series-RC parallel termination scheme uses a resistor and capacitor (i.e.,
                         series-RC) network as the terminating impedance. The terminating
                         resistor (RT) is equal to Z0. The capacitor must be large enough to filter the
                         constant flow of DC current. However, if the capacitor is too large, it will
                         delay the signal beyond the design threshold.

                         Capacitors smaller than 100 pF diminish the effectiveness of termination.
                         The capacitor blocks low-frequency signals while passing high-frequency
                         signals. Therefore, the DC loading effect of RT does not have an impact on
                         the driver, as there is no DC path to ground. The series-RC termination
                         scheme requires balanced DC signaling (i.e., the signals spend half the
                         time on and half the time off). AC termination is typically used if there is
                         more than one load. See Figure 28.

                         Figure 28. Series-RC Parallel Termination
                                                                         Stub

                                             S            Zo= 50 Ω                        L

                                                                                RT = Zo

                                                                                C

22                                                                                            Altera Corporation

                                                     AN 224: High-Speed Board Layout Guidelines

                     Figure 29 shows series-RC parallel fly-by termination.

                     Figure 29. Series-RC Parallel Fly-By Termination

                                                                         Receiver/
                                                                          Load
                                      S              Zo = 50 Ω
                                                                              Pad

                                                                              RT = Zo

                                                                               C

                     Series Termination

                     In a series termination scheme, the resistor matches the impedance at the
                     signal source instead of matching the impedance at each load (see
                     Figure 30). The sum of RT and the impedance of the output driver should
                     be equal to the Z0 . Because Altera device output impedance is low, you
                     should add a series resistor to match the signal source to the line
                     impedance. The advantage of series termination is that it consumes little
                     power. However, the disadvantage is that the rise time degrades due to
                     the increased RC time constant. Therefore, for high-speed designs, you
                     should perform the pre-layout signal integrity simulation with Altera
                     input/output buffer information specification (IBIS) models before using
                     the series termination scheme.

                     Figure 30. Series Termination

                                                     RT
                                       S                         Z0 = 50 Ω           L

                     Differential Pair Termination
                     Differential signal I/O standards require a termination resistor between
                     the signals at the receiving device (see Figure 31). For the LVDS and
                     LVPECL standard, the termination resistor should match the differential
                     load impedance of the bus (i.e., typically 100 ). Altera Stratix, Stratix GX,
                     and MercuryTM devices have an on-chip termination option. Using on-
                     chip termination decreases required board space. For more information,
                     see “On-Chip Termination for Stratix GX Transceivers” on page 25.

Altera Corporation                                                                              23

AN 224: High-Speed Board Layout Guidelines

                         Figure 31. Differential Pair (LVDS & LVPECL) Termination
                                                                         Stub

                                                                Z0 = 50 Ω

                                               S                         100 Ω                    L

                                                                Z0 = 50 Ω

                                                                         Stub

                         Figure 32 shows the differential pair fly-by termination scheme for the
                         LVDS and LVPECL standard.

                         Figure 32. Differential Pair (LVDS & LVPECL) Fly-By Termination
                                                                            Receiver/Load

                                                                                            +
                                                             Z0 = 50 Ω

                                           S                                      Pads            100 Ω

                                                             Z0 = 50 Ω                      −

                         3.3-V PCML uses two parallel 100- termination resistors at the
                         transmitter and two parallel 50- termination resistors at the receiver (see
                         Figure 33). The termination voltage (V T) is the same as the VCCIO voltage
                         (3.3 V).

                         Figure 33. Differential Pair (3.3-V PCML) Termination
                                                   VT   VT                       VT   VT

                                          100 Ω              100 Ω       50 Ω              50 Ω       Stub

                                                                Z0 = 50 Ω

                                      S                                                                      L
                                                                Z0 = 50 Ω

                                                                                                      Stub

24                                                                                                    Altera Corporation

                                                           AN 224: High-Speed Board Layout Guidelines

                     Figure 34 shows the differential pair, fly-by termination scheme for 3.3-V
                     PCML.

                     Figure 34. Differential Pair (3.3-V PCML) Fly-By Termination
                                        VT   VT                                         VT   VT

                                100 Ω             100 Ω                          50 Ω             50 Ω

                                                                                   +
                                                     Z0 = 50 Ω

                            S                                        Pads

                                                     Z0 = 50 Ω                     −

                                                                 Receiver/Load

              f      Refer to the Board Design Guidelines for LVDS Systems White Paper for more
                     information on terminating differential signals. Refer to AN 209: Using
                     Terminator Technology in Stratix & Stratix GX Devices for more information
                     on Stratix and Stratix GX on-chip termination.

                     On-Chip Termination for Stratix GX Transceivers

                     Stratix GX devices also have on-chip resistors designed to support
                     termination for several I/O standards. On-chip resistors simplify the task
                     of board design by freeing board space and offering more freedom in
                     signal routing. Also, because the distance from the resistor to the signal
                     pin is smaller, the on-chip resistors reduce stub reflection. Consequently,
                     Stratix GX devices provide better load and/or source termination, which
                     leads to better signal integrity.

                     All transceivers in Stratix GX devices have programmable, per channel
                     internal termination resistors, which can be programmed to be either 50-,
                     60-, or 75- single-ended resistors. In differential mode, the resistors
                     generate 100-, 120-, or 150-termination. Figures 35 and 36 show receiver
                     and transmitter on-chip termination schemes for Stratix GX devices.

                     Because different I/O standards require different termination resistors,
                     programmable internal termination resistors can be helpful. For example,
                     XAUI and Infiniband applications require 100- differential termination,
                     while Gigabit Ethernet and Fibre Channel require 150-differential
                     termination.

Altera Corporation                                                                                       25

AN 224: High-Speed Board Layout Guidelines

                         Figure 35. Receiver On-Chip Termination Scheme for Stratix GX Devices
                                                                                          Stratix GX Device
                                                                                 VTT = 0.75 V

                                                                                               Rt = 50, 60, or 75 Ω

                                                                                 Rt            Rt
                                                                  rxin_p
                                                                                                            rxout_p
                                      100-, 120-, or 150-Ω
                            Differential Transmission Line
                                                                                                            rxout_n
                                                                  rxin_n                         Receiver

                         1          You can bypass the on-chip resistors used in the receiver and use
                                    external resistors.

                         Figure 36. Transmit On-Chip Termination Scheme for Stratix GX Transceivers
                                    Stratix GX Device

                                               VCM = 0.75 V

                             Rt = 50, 60, or 75 Ω

                                              Rt             Rt
                                                                       rxout_p

                                                                                      100-, 120-, or 150-Ω
                                                                                      Differential Transmission Line

                            Transmitter
                                                                       rxout_n

                         1          For non-transceiver I/O pins in Stratix GX devices, the
                                    termination scheme is the same as with Stratix devices.

             f           For more information on designing termination schemes with Stratix and
                         Stratix GX devices, refer to AN 209: Using Terminator Technology in Stratix
                         & Stratix GX Devices.

26                                                                                               Altera Corporation

                                                   AN 224: High-Speed Board Layout Guidelines

Simultaneous         As digital devices become faster, their output switching times decrease,
                     causing higher transient currents in outputs as the devices discharge load
Switching            capacitances. These higher transient currents result in a board-level
                     phenomenon known as ground bounce.
Noise (SSN)
                     Because many factors contribute to ground bounce, you cannot use a
                     standard test method to predict its magnitude for all possible PCB
                     environments. You can only test the device under a given set of conditions
                     to determine the relative contributions of each condition and of the device
                     itself. Load capacitance, socket inductance, and the number of switching
                     outputs are the predominant factors that influence the magnitude of
                     ground bounce in FPGAs.

                     Altera requires 0.01- to 0.1-F surface-mount capacitors in parallel to
                     reduce ground bounce. Add an additional 0.001-F capacitor in parallel to
                     these capacitors to filter high-frequency noise (>100 MHz).

                     Altera recommends that you take the following steps to reduce ground
                     bounce and VCC sag:
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
