fingoldin/lpddr5-testbed/references/hs_design/Altera_AN958_Board_Design_Guidelines_2023-06-26.txt

 Explore more resources
 Altera® Design Hub

AN 958: Board Design Guidelines

  Online Version                      683073
  Send Feedback           AN-958   2023.06.26

                                                                                                                       Contents

Contents

1. Power Distribution Network............................................................................................4
       1.1. Target Impedance Decoupling Method...................................................................... 4
              1.1.1. FDTIM Decoupling Concepts........................................................................ 4
              1.1.2. Select Decoupling CAPS to Meet ZTARGET....................................................... 5
       1.2. Voltage Regulator Selection.....................................................................................6
       1.3. PDN Design Tool.................................................................................................... 6
       1.4. Plane Capacitance..................................................................................................6
       1.5. Minimization Parasitic Inductances........................................................................... 8
              1.5.1. VRM.........................................................................................................8
              1.5.2. Decaps.....................................................................................................8
              1.5.3. Mounting Inductance..................................................................................8
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
