fingoldin/lpddr5-testbed/design/gateware/BRINGUP.md

# Bring-up: what the gateware has to do, in order

> GENERATED by scripts/gen_gateware.py from design/netlist.json (revision 0.2, 2026-11-10) and
> design/gateware_deskew.json.  Do not edit: change the spec and re-run the generator.

Card: LPDDR5 command-bus testbed, DDR4 SO-DIMM form factor, for the ZCU104 PL socket J1. DRAM: SK hynix H58G56BK7BX068N (JEDEC 315-ball 2CHx32 ball map). Scope: LPDDR5 channel A, byte 0, rank 0.
Pins: `PINMAP.md`, `lpddr5_testbed_zcu104.xdc`. Delays and polarities as Verilog parameters: `lpddr5_testbed_pins.vh`.

Every statement carries its source: **D n** = `design/DESIGN.md` section n; **N** = `design/netlist.json` (key given);
**K** = `design/gateware_deskew.json`; **J** = `references/jedec/JESD209-5C_LPDDR5.txt` (table or clause);
**TI** = `references/parts/TI_DAC53401.txt`; **UG1267** / **XTP484** = `references/zcu104/`; **V** = the Vivado check in
`vivado_pincheck/`. **[no source]** marks what none of them states; such lines are suggestions, not design facts.

## 0. What the card does without any gateware

- Rails are made on the card from the host 1.2 V and 3.3 V: VDD1 1.764 / 1.800 / 1.836 V, VDD2H = VDD2L 1.032 / 1.048 / 1.064 V, VDDQ 0.488 / 0.500 / 0.512 V. Nothing starts until
  both host rails are up; all rails are in range about 5 ms after the first one moves; any host rail order works (D 4).
- No power-good or enable signal of the card reaches the FPGA, and no FPGA pin can switch a rail (D 4: "Nothing else is on
  the enable net"; N `fingers`: no finger carries PG or an enable).
- While the FPGA is unconfigured every divider node is held at 0 V by its shunt (CA / CK / WCK 68 ohm, CS 100 ohm, DQ 150 ohm)
  and RESET_n is held low by 1 k: with a 100 uA configuration pull-up the ball sits at 0.11 V (limit 0.21 V) (D 1).
- VREF_RD is 0.187 V with the DAC output Hi-Z, its factory default: reads work before any I2C traffic (D 3; N `analysis.reference`).

## 1. Pin states from configuration until the rails are known to be up

1. Drive every divider-driven pin low: `ca[6:0]`, `cs0`, both CK legs, both WCK legs, `wdq[7:0]`, and keep `reset_n` low
   (D 7: "All divider-driven pins low until the rails are up"). Reason: a high FPGA output puts 0.378 / 0.418 / 0.468 V on a CA ball and
   0.640 / 0.710 / 0.797 V on CS; JEDEC wants DQ, WCK, CK and CA between VSS and VDDQ during the ramp and CS at or below ViLPD (J 4.1.1 step 2).
2. Drive `cmd_open_low` (finger 75, AP19) low for good: the finger is open on the card and lies between the CK fingers (D 1).
3. The read pins are inputs only; never enable an output buffer on `rdq_p / rdq_n / rdqs_p / rdqs_n` (D 7).
4. How long to wait: the card gives no signal. The rails follow the host rails within about 5 ms (D 4) and the host rails are
   up before the PL is configured. A fixed wait of at least tINIT0 (20 ms, J table 20) after configuration covers it **[no source
   for the figure: suggestion]**. Check the rails on TP1 (VDD1), TP2 (VDD2H), TP3 (VDDQ) the first time (section 7).

## 2. Reset and initialisation (J 4.1.1, table 20)

| Step | What | Limit | Source |
|---|---|---|---|
| 1 | `reset_n` low after the rails are in range | tINIT1 >= 200 us | J table 20 |
| 2 | `cs0` low before `reset_n` goes high | tINIT2 >= 10 ns | J table 20 |
| 3 | CK toggling, or static at a valid complementary level, about when `reset_n` is released (until here both CK legs were low, section 1) | - | J 4.1.1 step 4 |
| 4 | `reset_n` high: FPGA LVCMOS12 on AP11 gives 0.959 / 1.034 / 1.121 V at the ball (VIH 0.85 V, maximum VDD2H + 0.2 V = 1.23 V) | - | D 1, N `analysis.dividers.RESET_n` |
| 5 | `cs0` low after `reset_n` high | tINIT3 >= 2 ms | J table 20 |
| 6 | CK stable before the first `cs0` high | tINIT4 >= 5 tCK | J table 20 |
| 7 | idle before the first MRW / MRR | tINIT5 >= 2 us | J table 20 |
| 8 | boot clock: tCKb >= 18 ns is what the DRAM guarantees (55 MHz); faster is system dependent | - | J table 20 notes |
| 9 | the initial ZQ calibration runs by itself after `reset_n` goes high (ZQ = 240 ohm to VDDQ, R401); issue ZQCal Latch, then wait tZQLAT = max(30 ns, 4 nCK) | - | J 4.1.1 step 7, D 5 |

- Levels during boot: with the default VREF(CA) of 50 % of VDDQ a CA high needs >= 0.351 V; the divider gives 0.378 / 0.418 / 0.468 V (D 1).
- CS is sampled against VDD2H / 3 = 0.35 V; the CS divider gives 0.640 / 0.710 / 0.797 V (D 1).
- The 1 k on RESET_n and the 100 ohm series part are on the card; the FPGA pin needs no pull.

## 3. Mode-register writes

Write them at the boot clock, in this order, to frequency set point 0 (the default set point; D does not name another).
"Byte" is the whole operand with every other field at its JEDEC default; where a default is not stated in J the field is
given alone and the register is to be read back first (MRR) and modified.

| # | Register | Field = value | Byte | Why | Source |
|---|---|---|---|---|---|
| 1 | MR13 | OP[7] = 1 (single 1.05 V VDD2 rail); OP[5] = 1 (data mask off); OP[6] = 0 (CBT mode 1); OP[4] = 0 (DMI output behaviour mode 1: with mode 2 and data mask on the DRAM would drive DMI during READ DQ CALIBRATION into the strap, J table 234) | 0xA0 | The VDD2L balls are tied to VDD2H: write it first, right after MRW becomes possible and before any CBT. DMI0 is strapped to VSS, so the DRAM must not expect a mask and MASKED WRITE is never issued. CBT mode 2 needs DMI0 as an input. | D 4, D 5, D 7; J table 18 note 1, J figure 13 note 3, J table 89 |
| 2 | MR17 | OP[2:0] = 110b (SoC ODT code RZQ/6); OP[3] = OP[4] = OP[5] = 1 (CK, CS, CA termination disabled) | 0x3E | With DQ termination off this field sets the pull-up strength of the DRAM driver: it defines the read high level (0.374 / 0.386 / 0.405 V into the 150 ohm load). CA / CK / CS are unterminated on purpose: the dividers source-match the lines. | D 3 ("Requires MR17 OP[2:0] = 110b"), D 7; J table 99 note 6 |
| 3 | MR3 | OP[2:0] = 110b (PDDS 40 ohm, the default); OP[7:6] = 00 (write and read DBI off) | read-modify-write | Pull-down strength for the read low; DBI stays off because DMI is strapped. If the receiver minds the 1-2 ns of ringing after an edge, use 48 or 60 ohm (101b / 100b) and re-centre VREF_RD (60 ohm nominal: 0.357 V high). | D 3, D 7; J table 68 |
| 4 | MR11 | OP[2:0] = 000 (DQ ODT off), OP[3] = 0, OP[6:4] = 000 (CA ODT off) | 0x00 (default) | All DRAM ODT off: the 150 ohm shunt is the only DC load of a DQ; a DQ ODT would pull the write level down. | D 7 ("all DRAM ODT off"); J table 84 |
| 5 | MR18 | OP[2:0] = 000 (WCK ODT off, default); OP[7] = 1 (CKR 2:1, default) | default | WCK reaches 0.378 / 0.418 / 0.468 V per leg only without termination; with 40 ohm it is 0.34 V p-p, the JEDEC minimum. | D 2; J table 101 |
| 6 | MR20 | OP[1:0] = 10b (RDQS_t and RDQS_c both enabled); OP[3:2] = 00 (differential WCK) | 0x02 | The card receives RDQS as a true differential pair, 150 ohm to GND on each leg. With the default 01b RDQS_c stays Hi-Z and sits at 0 V. | D 3 ("Needs MR20 OP[1:0] = 10b"), D 7; J table 105 |
| 7 | MR12 | OP[6:0] = 1000000b (VREF(CA) 42.0 % of VDDQ = 0.21 V); OP[7] = 0 | 0x40, then train | Half of the CA high level (0.378 / 0.418 / 0.468 V). The boot default (50 % = 0.25 V) is only good at low rate. | D 1, D 7; J table 87 |
| 8 | MR14 | OP[6:0] = 1000000b (VREF(DQ[7:0]) 42.0 % = 0.21 V); OP[7] = 0 | 0x40, then train | Half of the write level (0.389 / 0.423 / 0.460 V); must stay at or below 0.225 V. | D 2, D 7; J table 91 / 92 |

- **Never use**, because DMI is strapped to VSS: READ FIFO, read DBI, link ECC, read data copy, MASKED WRITE, CBT mode 2.
  READ DQ CALIBRATION is fine (D 5, D 7). JEDEC's DQ training flow names RD FIFO / WT FIFO (J 4.1.1 step 9): use READ DQ CALIBRATION
  and plain WRITE / READ instead.
- **Command-bus training is not needed and must not be relied on**: it forces a 40 ohm WCK ODT, which leaves WCK at the JEDEC
  minimum in the slowest driver corner (D 2). The command bus is matched on the card; VREF(CA) is set by MR12 directly.
- **CA ODT stays off.** If the 800 MHz eye needs it, it is a gateware change (MR11 OP[6:4] with MR17 OP[5] / OP[3] = 0); it lowers
  the CA level (240 ohm: 0.35 V) (D 8 item 4).
- **Clock plan (D 7).** WCK is tied to CK at 2:1 (MR18 OP[7] = 1, the reset default) or 4:1 (OP[7] = 0). The data target of this card is
  100 Mb/s (set by the 2.6 ns write node, D 2): WCK = 50 MHz, so **CK = 25 MHz at 2:1 or 12.5 MHz at 4:1 for every READ and WRITE**
  (tCK(avg) may be as long as 200 ns, J table 15.1). **CK = 800 MHz (1.6 Gb/s on CA) is for command-only traffic**, the purpose of the card.
  The controller therefore changes the clock frequency between the command stream and any read or write: stop or slow CK with the
  clock-change procedure (J 7.6.7) or switch frequency set points (FSP, J 7.6.3), each set point with its own MR1 / MR2 latencies,
  MR12 / MR14 VREF and MR11 / MR17 / MR18 termination codes. JEDEC defaults after reset are WL = 4, RL = 6, nWR = 5, CKR 2:1, set point 0
  (J table 18); the latencies per set point are for the controller to choose **[no value prescribed by D]**.
- Option on the FPGA side: `OUTPUT_IMPEDANCE RDRV_48_48` on the command pins matches the 39 ohm host line better than RDRV_40_40
  and still gives 0.386 / 0.420 / 0.453 V (D 7).

## 4. The reference DAC (VREF_RD, the N leg of every read pair)

- Network: DAC_OUT -300R- VREF_RD ; VDDQ -300R- VREF_RD ; VREF_RD -180R- GND ; 1 uF + 8 x 100 nF on the bus (N `analysis.reference.network`).
- DAC53401 U5, I2C address 0x48 (A0 to AGND); broadcast address 0x47 (D 3; TI table 11 / 12).
- Bus: card fingers 253 (SCL) / 254 (SDA) -> ZCU104 I2C1 switch TCA9548A U34, address 0x74, port 7 (UG1267 table 3-16). The bus is
  PS I2C1 (MIO16 / MIO17) and is also wired to PL bank 87 (N12 = PL_I2C1_SCL_LS, P12 = PL_I2C1_SDA_LS) through a level shifter
  (UG1267 figure 3-12; XTP484). Select port 7 on the switch, then address 0x48. The control byte of the switch is not in the
  repository **[no source]** (TCA9548A: one bit per port, port 7 = 0x80).
- **Default, no I2C traffic:** DAC output Hi-Z -> VREF_RD = 0.1873 V from VDDQ through 300 / 180 ohm, source 112.5 ohm (N).
- **Active:** V = 0.2727 x Vdac + 0.1363 V, source 81.8 ohm. With the internal reference at gain 1.5 (1.21 V x 1.5 = 1.815 V full scale, 10 bits):
  VREF_RD = 0.1363 V + code x 0.484 mV, range 0.136 .. 0.631 V (N; TI 8.3.1.1.2).
- **Target: code 121 = 0.195 V** (N `analysis.reference.dac_code_for_0p195_v`, `analysis.read.reference_v`).
- Registers (16-bit, TI 8.6): `DAC_DATA` (0x21) = code << 2 (bits 11:2, left aligned): code 121 -> 0x01E4. `GENERAL_CONFIG` (0xD1):
  DAC_PDN[4:3] = 00 (power up; reset value 10 = Hi-Z), REF_EN[2] = 1 (internal reference), DAC_SPAN[1:0] = 00 (gain 1.5),
  SLEW_RATE[8:5] = 1111 (no slew, the reset value) -> 0x01E4 (reset value 0x01F0). Write DAC_DATA first, then GENERAL_CONFIG, so that
  the output starts at the target **[order: suggestion, no source]**. Nothing is stored in the DAC's NVM by these writes.
- **Sweep:** step the code and count bit errors at 100 Mb/s (D 8 item 6).

  | Code | VREF_RD |
  |---|---|
  | 0 | 0.136 V |
  | 60 | 0.165 V |
  | 90 | 0.180 V |
  | 121 (target) | 0.195 V |
  | 150 | 0.209 V |
  | 180 | 0.223 V |
  | 210 | 0.238 V |
  | 240 | 0.252 V |
  | 300 | 0.281 V |
  | 400 | 0.330 V |
  | 1023 | 0.631 V |

- Limits of the sweep: the receiver needs VICM = (pin + VREF_RD) / 2 <= 0.33 V and >= 0.07 V. With the pin at 0 V the common
  mode is VREF_RD / 2: 0.0975 V at the target. **Keep VREF_RD at or below 0.20 V if the measured read high level is above
  0.42 V** (D 3, N `analysis.read.reference_rule`). The network cannot go below 0.136 V and, misprogrammed to the VDD reference
  at full scale, stays at 1.04 V, inside the FPGA's input range (D 3).

## 5. Per-bit delays

Neither data group is matched on the card (accepted by the user; D 0, D 7, D 14). Load these as start values and let training
refine them: the host figures inside them are good to about +/-5 ps and a bit may sit 15 ps from its value on the real card (D 8
items 20, 23). Source: K (written by gate 7 of `scripts/pcb/check_pcb.py` at every build).

| Bit | Write port | FPGA ball | Nibble | ODELAYE3 ps | Read port | FPGA ball P / N | Nibble | IDELAYE3 ps |
|---|---|---|---|---|---|---|---|---|
| DQ0 | `wdq[0]` | AL15 | T1L | 40.7 | `rdq_p[0]` | AH11 / AJ11 | T2L | 52.8 |
| DQ1 | `wdq[1]` | AL16 | T1L | 51.0 | `rdq_p[1]` | AG11 / AG10 | T2U | 37.4 |
| DQ2 | `wdq[2]` | AA14 | T3U | 27.1 | `rdq_p[2]` | AG13 / AH13 | T2L | 88.3 |
| DQ3 | `wdq[3]` | AA16 | T3U | 41.0 | `rdq_p[3]` | AF8 / AG8 | T2U | 69.1 |
| DQ4 | `wdq[4]` | AD16 | T3U | 53.5 | `rdq_p[4]` | AJ9 / AK9 | T1U | 0.0 |
| DQ5 | `wdq[5]` | AH16 | T2U | 23.1 | `rdq_p[5]` | AK12 / AL12 | T1L | 3.5 |
| DQ6 | `wdq[6]` | AL17 | T1U | 3.4 | `rdq_p[6]` | AE12 / AF12 | T3U | 105.3 |
| DQ7 | `wdq[7]` | AM16 | T1L | 0.0 | `rdq_p[7]` | AD14 / AE14 | T3L | 113.7 |
| RDQS | | | | | `rdqs_p` / `rdqs_n` | AK8 / AL8 | T1U | 0.0 |

- Primitives: ODELAYE3 / IDELAYE3, `DELAY_FORMAT = "TIME"`, `DELAY_VALUE` in ps, one per pin (the write pins lie in 4 nibbles: T1L, T1U, T2U, T3U; the
  read pins in 6: T1L, T1U, T2L, T2U, T3L, T3U): not one native byte interface (D 7). IDELAYE3: range 0 .. 1100 ps (K).
  TIME mode needs an `IDELAYCTRL` (reference clock 300 .. 800 MHz) and `EN_VTC` handling per UG571; one tap is 2.1 .. 12 ps, so table
  values below one tap (the smallest non-zero entries) are within the resolution of the primitive and are left to training.
- After the table every read DQ arrives 26.6 ps after the strobe edge that left the DRAM with it; the capture delay of the
  strobe (a quarter of the bit time and tDQSQ) is added by the gateware as in any DDR read. The strobe is not on the centre of the read
  group and need not be: it stays on In3 down to its fingers, like the read DQ lines, and arrives +30.3 ps from the centre, inside the span
  of the eight bits, so the table delays data only. If the strobe is sampled like data (section 6: the check does that at 100 Mb/s) give it
  its own IDELAYE3 at 0, so that it sees the same insertion delay; an IDELAYE3 output cannot drive a BUFG (V, case N1) (D 7).
- WCK is not matched to DQ (tWCK2DQI is 300 .. 900 ps inside the DRAM: write timing is trained). Before the table WCK arrives -17.0 ps
  relative to the latest write DQ (negative = earlier) (D 2, K).
- Polarity: CK is not inverted; WCK is INVERTED on the host pair; RDQS is INVERTED on the host pair (D 7, N `groups`).
- The RDQS receiver output is valid only inside a read burst (both legs sit at 0 V otherwise): gate it with the read-enable
  window (D 3, D 7).
- `wdq[*]` Hi-Z during reads (D 2, D 7). Write rate: 100 Mb/s is the design target; the write node has tau 2.6 ns and does not
  support 200 Mb/s (D 2). At 100 Mb/s sample reads in the second half of the unit interval (D 7).

## 6. The receiver

| | First choice | Fall-back |
|---|---|---|
| Primitive | `IBUFDS_DPHY`, HS path (`HSRX_O`), `HSRX_DISABLE = 0`, `LPRX_DISABLE = 1`, LP outputs open | plain `IBUFDS` |
| Standard | `MIPI_DPHY_DCI`, in the XDC **and** as the `IOSTANDARD` attribute of the instance | `SLVS_400_18` (`lpddr5_testbed_zcu104_rx_slvs.xdc`) |
| Termination | `DIFF_TERM = "FALSE"` (`DIFF_TERM_ADV TERM_NONE`) | `DIFF_TERM_ADV TERM_NONE` |
| Window | VID >= 0.07 V, VICM 0.07 .. 0.33 V, pin -0.04 .. 0.46 V | VID 0.14 .. 0.45 V, VICM 0.07 .. 0.33 V |
| Static one (min / nom / max) | VID 0.179 / 0.191 / 0.210 V, VICM 0.284 / 0.290 / 0.300 V | same signal |
| Static zero | VID -0.195 V, VICM 0.0975 V | same signal |
| Margin at the JEDEC bound of the read level | VICM to 0.33 V: 17 mV; pin to 0.46 V: 29 mV; zero-state VICM to 0.07 V: 27.5 mV | VID to 0.14 V: 27 mV |

Source: N `analysis.read`, D 3. No termination in either case: one leg of every data pair is a DC reference, and a 100 ohm
differential termination would load the read level. Whether a D-PHY HS receiver works with one static leg (200 mV common-mode
step per edge) is an open bench question (D 8 item 6); that is why the fall-back exists and why RDQS is a true pair: it tells
on the bench whether a read problem is the receiver or the reference (D 3).

**Vivado legality of this pin plan (V).** Legality only: Vivado knows nothing about levels.

| Case | Tool | What | Result | Errors | Critical warnings | Setup slack ns | Pulse-width slack ns |
|---|---|---|---|---|---|---|---|
| M1_dphy_native16 | 2026.1 | first-choice receiver (IBUFDS_DPHY, MIPI_DPHY_DCI), native TX_BITSLICE command bus at 1.6 Gb/s | passes through write_bitstream | 0 | 0 | 0.297 | 0.098 |
| M1_dphy_native16_vivado2023 | 2023.1 | M1 in Vivado 2023.1 (IDELAYCTRL SIM_DEVICE = ULTRASCALE) | passes through write_bitstream | 0 | 0 | 0.113 | 0.098 |
| M2_slvs_native16 | 2026.1 | fall-back receiver (IBUFDS, SLVS_400_18), the rest as M1 | passes through write_bitstream | 0 | 0 | 0.297 | 0.098 |
| M2_slvs_native16_vivado2023 | 2023.1 | M2 in Vivado 2023.1 (IDELAYCTRL SIM_DEVICE = ULTRASCALE) | passes through write_bitstream | 0 | 0 | 0.113 | 0.098 |
| M3_dphy_native16_guard_obuf | 2026.1 | as M1, the open finger 75 as a plain OBUF inside the native nibble | passes through write_bitstream | 0 | 0 | 0.297 | 0.098 |
| M4_dphy_comp_1200 | 2026.1 | as M1, command bus on OSERDESE3 with a 600 MHz bit clock (1.2 Gb/s) | passes through write_bitstream | 0 | 0 | 0.213 | 0.066 |
| M5_dphy_comp_1600 | 2026.1 | as M1, command bus on OSERDESE3 with an 800 MHz bit clock (1.6 Gb/s) | passes through write_bitstream | 0 | 0 | 0.097 | -0.350 |
| N1_rdqs_clock_behind_idelay | 2026.1 | negative test: RDQS -> IDELAYE3 -> BUFGCE as the capture clock | FAILS at place (REQP-1741) | 2 | 0 | - | - |
| N2_rdqs_clock_from_receiver | 2026.1 | negative test: RDQS receiver -> BUFGCE as the capture clock | FAILS at place (Place 30-675) | 3 | 0 | - | - |
| N2b_rdqs_clock_cdr_false | 2026.1 | as N2 with CLOCK_DEDICATED_ROUTE FALSE on the strobe net | passes through write_bitstream | 0 | 0 | 0.301 | 0.075 |
| N3_dphy_attr_default | 2026.1 | IBUFDS_DPHY without IOSTANDARD = MIPI_DPHY_DCI on the instance (the standard only in the XDC) | passes through write_bitstream | 0 | 0 | 0.297 | 0.098 |
| N3_dphy_attr_default_vivado2023 | 2023.1 | N3 in Vivado 2023.1 | FAILS at bitstream (AVAL-252) | 10 | 0 | 0.113 | 0.098 |
| N4_dphy_primitive_with_slvs | 2026.1 | negative test: IBUFDS_DPHY on ports constrained to SLVS_400_18 | FAILS at bitstream (AVAL-252) | 19 | 0 | 0.297 | 0.098 |

Summaries with every error and critical warning verbatim, the port properties and the bank properties:
`vivado_pincheck/results/`. Sources of the check: `vivado_pincheck/lpddr5_pincheck_top.v`, `run_pincheck.tcl`, `run_pincheck.sh`.

What the check establishes for the gateware (V):

- **Command bus at 1.6 Gb/s needs native mode.** `TX_BITSLICE` (DATA_WIDTH 8) with one `BITSLICE_CONTROL` per nibble and a
  `PLLE4_ADV` in the command bank (VCO 800 MHz, `CLKOUTPHY_MODE = VCO_2X` = 1600 MHz, fabric clock 200 MHz) meets timing and
  pulse width. CK is the `TX_BITSLICE` at bitslice 0 of the upper nibble with an `OBUFDS`. Each `TX_BITSLICE` has its own output
  delay for the per-bit command deskew. Component-mode `OSERDESE3` is limited to a 625 MHz bit clock (1.25 Gb/s) on this
  speed grade: at 800 MHz Vivado reports the minimum period of `OSERDESE3/CLK` (1.600 ns) violated (case M5).
  `references/amd/DS925` agrees: component mode 1250 Mb/s (table 70), native `TX_BITSLICE` DDR with DATA_WIDTH 8 375 .. 1600 Mb/s
  (table 71). 1.6 Gb/s is therefore the data-sheet maximum, and the PLL cannot be slowed below 375 Mb/s for the boot clock:
  keep the bit rate at 1.6 Gb/s and make slow CK / CA / CS by repeating bits in the 8-bit words.
- The open finger of the command nibble may be a `TX_BITSLICE` at constant 0 or a plain `OBUF`; both are accepted.
- Write side and read side in component mode, one delay primitive per pin, as section 5 says; `wdq[*]` on `OBUFT`.
- Reads at 100 Mb/s: receiver -> `IDELAYE3` -> `ISERDESE3` clocked by the system clock (8x oversampling), the strobe sampled
  like data and inverted in logic. Using RDQS as a clock is harder: an `IDELAYE3` output may not drive a BUFG (DRC REQP-1741),
  and the strobe pin is a QBC pin, not a global-clock pin, so receiver -> `BUFGCE` needs `CLOCK_DEDICATED_ROUTE FALSE`
  (Place 30-675 without it).
- `IDELAYCTRL`: `SIM_DEVICE = "ULTRASCALE_PLUS"` for Vivado 2026.1, `"ULTRASCALE"` for Vivado 2023.1; each release refuses the
  bitstream for the other value (DRC ADEF-911).
- `IBUFDS_DPHY`: keep `IOSTANDARD = "MIPI_DPHY_DCI"` on the instance. Vivado 2023.1 refuses the bitstream without it (DRC
  AVAL-252, case N3 in 2023.1); Vivado 2026.1 accepts the standard from the XDC alone. The primitive cannot be used with
  SLVS_400_18: the fall-back needs a plain `IBUFDS`.
- No `INTERNAL_VREF`, no `DCI_CASCADE`; the VRP pins of the three banks stay free. The ZCU104 system clock CLK_300 (AH18 / AH17)
  lies in the write bank, in the nibble of WCK; that is accepted.

## 7. What to measure first (D 8)

1. **Rails** on TP1 (VDD1 1.764 / 1.800 / 1.836 V), TP2 (VDD2H 1.032 / 1.048 / 1.064 V), TP3 (VDDQ 0.488 / 0.500 / 0.512 V), TP4 (VREF_RD 0.187 V with the DAC untouched), TP5 (GND); the
   host 1.2 V at the card under load (>= 1.12 V for 0.52 A) (D 4, D 8 item 10).
2. **A static high at a divider node** with the FPGA driving one command pin high: expect 0.378 / 0.418 / 0.468 V on CA, 0.640 / 0.710 / 0.797 V on CS, 0.389 / 0.423 / 0.460 V
   on a write DQ. It gives the real driver resistance (D 8 item 2). No test pads on signal nets: probe at the shunt resistor.
3. **Termination really off:** under 1 mV across a 39 ohm N resistor with the P pin at 0 V (D 8 item 7).
4. **RESET_n** low 0 V / high 0.959 / 1.034 / 1.121 V at R403 before releasing reset for real (D 1).
5. **First MRR** at the boot clock (MR8 or any register with a known value) through the RDQS-independent path: sample the eight read
   pairs with the system clock and look for the value **[choice of register: no source]**.
6. **Read high level** of this DRAM into 150 ohm (proxies 0.386 V nominal, JEDEC bound 0.362 .. 0.431 V) and how it moves with MR17 / MR3
   (D 8 item 5). If it is above 0.42 V keep VREF_RD at or below 0.20 V.
7. **VREF_RD sweep against bit errors at 100 Mb/s**, with `IBUFDS_DPHY` first, then with the SLVS fall-back (D 8 item 6).
8. **A read finger with an active probe at 100 Mb/s** for the three drive strengths (40 / 48 / 60 ohm): the open FPGA end overshoots
   for 1-2 ns per edge (0.549 V / -0.131 V in the strong corner) (D 3, D 8 item 29).
9. **The unused half of the x16 die** (DQ8-15 and RDQS1 of channel A are open balls, WCK1 is held at its static level by two 10 k) and the
   idle channel-B die with a single VDD2 rail: JEDEC is silent; watch VDDQ / VDD2H current and read stability (D 5, D 8 items 8, 9).
10. **Command eye at 1.6 Gb/s** (800 MHz CK): the goal of the card. Sweep the per-bit output delay of each CA pin and the MR12 code
    against command errors; TDR of CA2 against CA0 at the fingers of a bare card checks the on-card match (D 8 items 3, 4, 18).
