fingoldin/lpddr5-testbed/references/amd/DS925_ZynqUSplus_DC_AC_Switching_Characteristics_v1.30.txt

                                                  Zynq UltraScale+ MPSoC Data Sheet:
                                                  DC and AC Switching Characteristics

DS925 (v1.30) July 9, 2026                                                                   Product Specification

Summary
The AMD Zynq™ UltraScale+™ MPSoCs are available in -3, -2, -1 speed grades, with -3E devices having the
highest performance. Some -2LE and -1LI devices can operate at a VCCINT voltage at 0.85V or 0.72V and are
screened for lower maximum static power. When operated at VCCINT = 0.85V, using -2LE and -1LI devices,
the speed specification for the L devices is the same as the -2I or -1I speed grades. When operated at
VCCINT = 0.72V, the -2LE and -1LI performance and static and dynamic power is reduced.

DC and AC characteristics are specified in extended (E), industrial (I), automotive (Q), and military (M)
temperature ranges. Except the operating temperature range or unless otherwise noted, all the DC and AC
electrical parameters are the same for a particular speed grade (that is, the timing characteristics of a -1 speed
grade extended device are the same as for a -1 speed grade industrial device). However, only selected speed
grades and/or devices are available in each temperature range.

The XQ references in this data sheet are specific to the devices available in XQ Ruggedized packages. See
the Defense-Grade UltraScale Architecture Data Sheet: Overview (DS895) for further information on XQ Defense-
grade part numbers, packages, and ordering information.

All supply voltage and junction temperature specifications are representative of worst-case conditions. The
parameters included are common to popular designs and typical applications.

This data sheet, part of an overall set of documentation on the Zynq UltraScale+ MPSoCs, is available on the
AMD Technical Information Portal.

DC Characteristics
Absolute Maximum Ratings
Table 1: Absolute Maximum Ratings

      Symbol                                  Description1                     Min              Max           Units
Processor System (PS)
VCC_PSINTFP         PS primary logic full-power domain supply voltage         –0.500            1.000           V
VCC_PSINTLP         PS primary logic low-power domain supply voltage          –0.500            1.000           V
VCC_PSAUX           PS auxiliary supply voltage                               –0.500            2.000           V
VCC_PSINTFP_DDR     PS DDR controller and PHY supply voltage                  –0.500            1.000           V
VCC_PSADC           PS SYSMON ADC supply voltage relative to GND_PSADC        –0.500            2.000           V
VCC_PSPLL           PS PLL supply voltage                                     –0.500            1.320           V
VPS_MGTRAVCC        PS-GTR supply voltage                                     –0.500            1.000           V
VPS_MGTRAVTT        PS-GTR termination voltage                                –0.500            2.000           V

DS925 (v1.30) July 9, 2026
                                                                                            Send Feedback
Product Specification                                                                                                1

                                                 Zynq UltraScale+ MPSoC Data Sheet: DC and AC Switching Characteristics

Table 1: Absolute Maximum Ratings (cont'd)

          Symbol                               Description1                             Min            Max            Units
VPS_MGTREFCLK       PS-GTR reference clock input voltage                                –0.500         1.100            V
VPS_MGTRIN          PS-GTR receiver input voltage                                       –0.500         1.100            V
VCCO_PSDDR          PS DDR I/O supply voltage                                           –0.500         1.650            V
VCC_PSDDR_PLL       PS DDR PLL supply voltage                                           –0.500         2.000            V
VCCO_PSIO           PS I/O supply                                                       –0.500         3.630            V
VPSIN2              PS I/O input voltage                                                –0.500   VCCO_PSIO + 0.550      V
                    PS DDR I/O input voltage                                            –0.500   VCCO_PSDDR + 0.550     V
VCC_PSBATT          PS battery-backed RAM and battery-backed real-time clock (RTC)      –0.500         2.000            V
                    supply voltage
Programmable Logic (PL)
VCCINT              Internal supply voltage                                             –0.500         1.000            V
VCCINT_IO     3     Internal supply voltage for the I/O banks                           –0.500         1.000            V
VCCAUX4             Auxiliary supply voltage                                            –0.500         2.000            V
VCCBRAM      3      Supply voltage for the block RAM and UltraRAM                       –0.500         1.000            V
VCCO                Output drivers supply voltage for HD I/O banks                      –0.500         3.400            V
                    Output drivers supply voltage for HP I/O banks                      –0.500         2.000            V
VCCAUX_IO4          Auxiliary supply voltage for the I/O banks                          –0.500         2.000            V
VREF                Input reference voltage for HP I/O banks                            –0.500         2.000            V
VIN   2, 5, 6, 7    I/O input voltage for HD I/O banks                                  –0.550     VCCO + 0.550         V
                    I/O input voltage for HP I/O banks                                  –0.550     VCCO + 0.550         V
IDC                 Available output current at the pad                                  –20            20             mA
IRMS                Available RMS output current at the pad                              –20            20             mA
GTH or GTY Transceiver8
VMGTAVCC            Analog supply voltage for transceiver circuits                      –0.500         1.000            V
VMGTAVTT            Analog supply voltage for transceiver termination circuits          –0.500         1.300            V
VMGTVCCAUX          Auxiliary analog Quad PLL (QPLL) voltage supply for transceivers    –0.500         1.900            V
VMGTREFCLK          Transceiver reference clock absolute input voltage                  –0.500         1.300            V
VMGTAVTTRCAL        Analog supply voltage for the resistor calibration circuit of the   –0.500         1.300            V
                    transceiver column
VIN                 Receiver (RXP/RXN) and transmitter (TXP/TXN) absolute input         –0.500         1.200            V
                    voltage
IDCIN-FLOAT         DC input current for receiver input pins DC coupled RX                –             10             mA
                    termination = floating9
IDCIN-MGTAVTT       DC input current for receiver input pins DC coupled RX                –             10             mA
                    termination = VMGTAVTT
IDCIN-GND           DC input current for receiver input pins DC coupled RX                –              0             mA
                    termination = GND10
IDCIN-PROG          DC input current for receiver input pins DC coupled RX                –              0             mA
                    termination = programmable11
IDCOUT-FLOAT        DC output current for transmitter pins DC coupled RX                  –              6             mA
                    termination = floating
IDCOUT-MGTAVTT      DC output current for transmitter pins DC coupled RX                  –              6             mA
                    termination = VMGTAVTT
Video Codec Unit
VCCINT_VCU          Internal supply voltage for the video codec unit                    –0.500         1.000            V

DS925 (v1.30) July 9, 2026
                                                                                                  Send Feedback
Product Specification                                                                                                       2

                                                      Zynq UltraScale+ MPSoC Data Sheet: DC and AC Switching Characteristics

Table 1: Absolute Maximum Ratings (cont'd)

        Symbol                                      Description1                                           Min              Max          Units
PL System Monitor
VCCADC                   PL System Monitor supply relative to GNDADC                                   –0.500               2.000           V
VREFP                    PL System Monitor reference input relative to GNDADC                          –0.500               2.000           V
Temperature12
TSTG                     Storage temperature (ambient)                                                     –65               150            °C
TSOL                     Maximum dry rework soldering temperature                                           –                260            °C
                         Maximum reflow soldering temperature for SBVA484, SFVA625,                         –                250            °C
                         SFVC784, SFVD784, and SFVE784 packages
                         Maximum reflow soldering temperature for UBVA494, UBVA530,                         –                245            °C
                         FBVB900, FFVC900, FFVB1156, FFVC1156, FFVB1517, FFVF1517,
                         FFVC1760, FFVD1760, and FFVE1924 packages
                         Maximum reflow soldering temperature for SFRA484, SFRC784,                         –                225            °C
                         FFRB900, FFRC900, FFRB1156, FFRC1156, FFRB1517, and FFRC1760
                         packages
Tj                       Maximum junction temperature                                                       –                125            °C
Notes:
1.     Stresses beyond those listed under Absolute Maximum Ratings might cause permanent damage to the device. These are stress ratings
       only, and functional operation of the device at these or any other conditions beyond those listed under Operating Conditions is not
       implied. Exposure to Absolute Maximum Ratings conditions for extended periods of time might affect device reliability.
2.     When operating outside of the recommended operating conditions, refer to Table 6, Table 7, and Table 8 for maximum overshoot and
       undershoot specifications.
3.     VCCINT_IO must be connected to VCCBRAM.
4.     VCCAUX_IO must be connected to VCCAUX.
5.     The lower absolute voltage specification always applies.
6.     For I/O operation, see the UltraScale Architecture SelectIO Resources User Guide (UG571).
7.     VIN for the POR_OVERRIDE pin is unique. POR_OVERRIDE must be connected to either GND (default) or VCCINT. See TPOR in Configuration
       Switching Characteristics for additional information.
8.     For more information on supported GTH or GTY transceiver terminations see the UltraScale Architecture GTH Transceivers User Guide
       (UG576) or UltraScale Architecture GTY Transceivers User Guide (UG578).
9.     AC coupled operation is not supported for RX termination = floating.
10. For GTY transceivers, DC coupled operation is not supported for RX termination = GND.
11. DC coupled operation is not supported for RX termination = programmable.
12. For soldering guidelines and thermal considerations, see the Zynq UltraScale+ Device Packaging and Pinouts Product Specification User
    Guide (UG1075).

Recommended Operating Conditions
Table 2: Recommended Operating Conditions

        Symbol                                    Description1, 2                                  Min           Typ         Max         Units
Processor System
VCC_PSINTFP3              PS full-power domain supply voltage                                      0.808         0.850       0.892          V
                          For -1LI and -2LE (VCCINT = 0.72V) devices: PS full-power domain         0.808         0.850       0.892          V
                          supply voltage
                          For -3E devices: PS full-power domain supply voltage                     0.873         0.900       0.927          V
VCC_PSINTLP               PS low-power domain supply voltage                                       0.808         0.850       0.892          V
                          For -1LI and -2LE (VCCINT = 0.72V) devices: PS low-power domain          0.808         0.850       0.892          V
                          supply voltage
                          For -3E devices: PS low-power domain supply voltage                      0.873         0.900       0.927          V

DS925 (v1.30) July 9, 2026
                                                                                                                         Send Feedback
Product Specification                                                                                                                            3

                                                    Zynq UltraScale+ MPSoC Data Sheet: DC and AC Switching Characteristics

Table 2: Recommended Operating Conditions (cont'd)

         Symbol                               Description1, 2                             Min      Typ           Max            Units
VCC_PSAUX             PS auxiliary supply voltage                                         1.710    1.800         1.890            V
VCC_PSINTFP_DDR3      PS DDR controller and PHY supply voltage                            0.808    0.850         0.892            V
                      For -1LI and -2LE (VCCINT = 0.72V) devices: PS DDR controller and   0.808    0.850         0.892            V
                      PHY supply voltage
                      For -3E devices: PS DDR controller and PHY supply voltage           0.873    0.900         0.927            V
VCC_PSADC             PS SYSMON ADC supply voltage relative to GND_PSADC                  1.710    1.800         1.890            V
VCC_PSPLL             PS PLL supply voltage                                               1.164    1.200         1.236            V
VPS_MGTRAVCC4         PS-GTR supply voltage                                               0.825    0.850         0.875            V
VPS_MGTRAVTT4         PS-GTR termination voltage                                          1.746    1.800         1.854            V
VCCO_PSDDR5           PS DDR I/O supply voltage                                            1.06     –            1.575            V
VCC_PSDDR_PLL         PS DDR PLL supply voltage                                           1.710    1.800         1.890            V
VCCO_PSIO6            PS I/O supply                                                       1.710     –            3.465            V
VPSIN                 PS I/O input voltage                                                –0.200    –      VCCO_PSIO + 0.200      V
                      PS DDR I/O input voltage                                            –0.200    –      VCCO_PSDDR + 0.200     V
VCC_PSBATT        7   PS battery-backed RAM and battery-backed real-time clock (RTC)      1.200     –            1.500            V
                      supply voltage
Programmable Logic
VCCINT                PL internal supply voltage                                          0.825    0.850         0.876            V
                      For -1LI and -2LE (VCCINT = 0.72V) devices: PL internal supply      0.698    0.720         0.742            V
                      voltage
                      For -3E devices: PL internal supply voltage                         0.873    0.900         0.927            V
VCCINT_IO     8       PL internal supply voltage for the I/O banks                        0.825    0.850         0.876            V
                      For -1LI and -2LE (VCCINT = 0.72V) devices: PL internal supply      0.825    0.850         0.876            V
                      voltage for the I/O banks
                      For -3E devices: PL internal supply voltage for the I/O banks       0.873    0.900         0.927            V
VCCBRAM8              Block RAM and UltraRAM supply voltage                               0.825    0.850         0.876            V
                      For -3E devices: block RAM and UltraRAM supply voltage              0.873    0.900         0.927            V
VCCAUX   11           Auxiliary supply voltage                                            1.746    1.800         1.854            V
VCCO                  Supply voltage for HD I/O banks9                                    1.140     –            3.400            V
                      Supply voltage for HP I/O banks10                                   0.950     –            1.900            V
VCCAUX_IO11           Auxiliary I/O supply voltage                                        1.746    1.800         1.854            V
VIN12, 13             I/O input voltage                                                   –0.200    –        VCCO + 0.200         V
IIN14                 Maximum current through any PL or PS pin in a powered or              –       –             10             mA
                      unpowered bank when forward biasing the clamp diode
GTH or GTY Transceiver
VMGTAVCC15            Analog supply voltage for the GTH or GTY transceiver                0.873    0.900         0.927            V
VMGTAVTT      15      Analog supply voltage for the GTH or GTY transmitter and            1.164    1.200         1.236            V
                      receiver termination circuits
VMGTVCCAUX15          Auxiliary analog QPLL voltage supply for the transceivers           1.746    1.800         1.854            V
VMGTAVTTRCAL15        Analog supply voltage for the resistor calibration circuit of the   1.164    1.200         1.236            V
                      GTH or GTY transceiver column
VCU
VCCINT_VCU            Internal supply voltage for the VCU                                 0.873    0.900         0.927            V

DS925 (v1.30) July 9, 2026
                                                                                                           Send Feedback
Product Specification                                                                                                                 4

                                                         Zynq UltraScale+ MPSoC Data Sheet: DC and AC Switching Characteristics

Table 2: Recommended Operating Conditions (cont'd)

        Symbol                                        Description1, 2                            Min       Typ              Max            Units
PL System Monitor
VCCADC                    PL System Monitor supply relative to GNDADC                           1.746      1.800            1.854              V
VREFP                     PL System Monitor externally supplied reference voltage relative      1.200      1.250            1.300              V
                          to GNDADC
Temperature
Tj16                      Junction temperature operating range for extended (E)                   0          –              100                °C
                          temperature devices17
                          Junction temperature operating range for industrial (I)                –40         –              100                °C
                          temperature devices
                          Junction temperature operating range for automotive (Q)                –40         –              125                °C
                          temperature devices
                          Junction temperature operating range for military (M)                  –55         –              125                °C
                          temperature devices
                          Junction temperature operating range for eFUSE programming             –40         –              125                °C
Notes:
1.     All voltages are relative to GND, assuming supplies are present.
2.     For the design of the power distribution system consult the UltraScale Architecture PCB Design User Guide (UG583).
3.     VCC_PSINTFP_DDR must be tied to VCC_PSINTFP.
4.     Each voltage listed requires filtering as described in the UltraScale Architecture PCB Design User Guide (UG583).
5.     Includes VCCO_PSDDR of 1.2V, 1.35V, 1.5V at ±5% and 1.1V +0.07V/–0.04V depending upon the tolerances required by specific memory
       standards.
6.     Applies to all PS I/O supply banks. Includes VCCO_PSIO of 1.8V, 2.5V, and 3.3V at ±5%.
7.     Up to 1.89V is acceptable on VCC_PSBATT. If the battery-backed RAM or RTC is not used, connect VCC_PSBATT to GND or VCC_PSAUX.
8.     VCCINT_IO must be connected to VCCBRAM.
9.     Includes VCCO of 1.2V, 1.35V, 1.5V, 1.8V, and 2.5V at ±5%, and 3.3V at +3/–5%.
10. Includes VCCO of 1.0V, 1.2V, 1.35V, 1.5V, and 1.8V at ±5%.
11. VCCAUX_IO must be connected to VCCAUX.
12. The lower absolute voltage specification always applies.
13. VIN for the POR_OVERRIDE pin is unique. POR_OVERRIDE must be connected to either GND (default) or VCCINT. See TPOR in Configuration
    Switching Characteristics for additional information.
14. A total of 200 mA per bank should not be exceeded.
15. Each voltage listed requires filtering as described in the UltraScale Architecture GTH Transceivers User Guide (UG576) or the UltraScale
    Architecture GTY Transceivers User Guide (UG578).
16. AMD recommends measuring the Tj of a device using the system monitor as described in the UltraScale Architecture System Monitor User
    Guide (UG580). The SYSMON temperature measurement errors (that are described in Table 69 and Table 127) must be accounted for in
    your design. For example, when using the PL system monitor with an external reference of 1.25V, and when SYSMON reports 97°C, there
    is a measurement error ±3°C. A reading of 97°C is considered the maximum adjusted Tj (100°C – 3°C = 97°C).
17. Devices labeled with the speed/temperature grade of -2LE can operate for a limited time at a junction temperature between 100°C and
    110°C. Timing parameters adhere to the same speed file at 110°C as they do below 110°C, regardless of operating voltage (nominal
    voltage of 0.85V or a low-voltage of 0.72V). Operation up to Tj = 110°C is limited to 1% of the device lifetime and can occur sequentially or
    at regular intervals as long as the total time does not exceed 1% of the device lifetime.

Available Speed Grades and Operating Voltages
Table 3 describes the speed grades and the VCCINT operating supply voltages for the full-power, low-power,
and DDR domains. For more information on selecting devices and for available speed grades per device, see
the UltraScale Architecture and Product Data Sheet: Overview (DS890), XA Zynq UltraScale+ MPSoC Data Sheet:
Overview (DS894) or the Defense-Grade UltraScale Architecture Data Sheet: Overview (DS895).

DS925 (v1.30) July 9, 2026
                                                                                                                      Send Feedback
Product Specification                                                                                                                               5

                                                    Zynq UltraScale+ MPSoC Data Sheet: DC and AC Switching Characteristics

Table 3: Available Speed Grades and Operating Voltages

       Speed Grade1                  VCCINT                  VCC_PSINTLP               VCC_PSINTFP             VCC_PSINTFP_DDR      Units
              -3E                     0.90                       0.90                        0.90                     0.90            V
              -2E                     0.85                       0.85                        0.85                     0.85            V
              -2I                     0.85                       0.85                        0.85                     0.85            V
             -2LE                     0.85                       0.85                        0.85                     0.85            V
              -1E                     0.85                       0.85                        0.85                     0.85            V
              -1I                     0.85                       0.85                        0.85                     0.85            V
             -1Q                      0.85                       0.85                        0.85                     0.85            V
             -1M                      0.85                       0.85                        0.85                     0.85            V
             -1LI                     0.85                       0.85                        0.85                     0.85            V
             -2LE                     0.72                       0.85                        0.85                     0.85            V
             -1LI                     0.72                       0.85                        0.85                     0.85            V
Notes:
1.     Refer to Speed Grade Designations for speed grade, temperature ranges, and VCCINT operating voltages for specific devices.

DC Characteristics Over Recommended Operating Conditions
Table 4: DC Characteristics Over Recommended Operating Conditions

         Symbol                                       Description                                   Min        Typ1          Max    Units
VDRINT                      Data retention VCCINT voltage (below which configuration data           0.68         –             –      V
                            might be lost)
VDRAUX                      Data retention VCCAUX voltage (below which configuration data            1.5         –             –      V
                            might be lost)
IREF                        VREF leakage current per pin                                             –           –            15     µA
IL                          Input or output leakage current per pin (HD I/O and HP I/O2)             –           –            15     µA
                            (sample-tested)
                            Input or output leakage current per pin (PS DDR I/O) (sample-            –           –           113     µA
                            tested)
CIN3                        Die input capacitance at the pad (HP I/O)                                –           –            3.1     pF
                            Die input capacitance at the pad (HD I/O)                                –           –           4.75     pF
IRPU                        Pad pull-up (when selected) at VIN = 0V, VCCO = 3.3V                     75          –           190     µA
                            Pad pull-up (when selected) at VIN = 0V, VCCO = 2.5V                     50          –           169     µA
                            Pad pull-up (when selected) at VIN = 0V, VCCO = 1.8V                     60          –           120     µA
                            Pad pull-up (when selected) at VIN = 0V, VCCO = 1.5V                     30          –           120     µA
                            Pad pull-up (when selected) at VIN = 0V, VCCO = 1.2V                     10          –           100     µA
IRPD                        Pad pull-down (when selected) at VIN = 3.3V                              60          –           200     µA
                            Pad pull-down (when selected) at VIN = 1.8V                              29          –           120     µA
ICCADCONPL                  Analog supply current for the PL SYSMON circuits in the power-up         –           –             8     mA
                            state
ICCADCONPS                  Analog supply current for the PS SYSMON circuits in the power-up         –           –            10     mA
                            state
ICCADCOFFPL                 Analog supply current for the PL SYSMON circuits in the power-           –           –            1.5    mA
                            down state
ICCADCOFFPS                 Analog supply current for the PS SYSMON circuits in the power-           –           –            1.8    mA
                            down state

DS925 (v1.30) July 9, 2026
                                                                                                                 Send Feedback
Product Specification                                                                                                                       6

                                                   Zynq UltraScale+ MPSoC Data Sheet: DC and AC Switching Characteristics

Table 4: DC Characteristics Over Recommended Operating Conditions (cont'd)

         Symbol                                      Description                            Min          Typ1          Max         Units
ICC_PSBATT4, 5             Battery supply current at VCC_PSBATT = 1.50V, RTC enabled         –             –            3650        nA
                           Battery supply current at VCC_PSBATT = 1.50V, RTC disabled        –             –            650         nA
                           Battery supply current at VCC_PSBATT = 1.20V, RTC enabled         –             –            3150        nA
                           Battery supply current at VCC_PSBATT = 1.20V, RTC disabled        –             –            150         nA
IPSFS6                     PS VCC_PSAUX additional supply current during eFUSE               –             –            115         mA
                           programming
Internal VREF              50% VCCO                                                      VCCO x 0.49   VCCO x 0.50   VCCO x 0.51     V
                           70% VCCO                                                      VCCO x 0.69   VCCO x 0.70   VCCO x 0.71     V
Differential termination   Programmable differential termination (TERM_100) for HP I/O     –35%           100          +35%         Ω
                           banks
n                          Temperature diode ideality factor                                 –           1.026           –           –
r                          Temperature diode series resistance                               –             2             –          Ω
Calibrated programmable on-die termination (DCI) in HP I/O banks7 (measured per JEDEC specification)
R9                         Thevenin equivalent resistance of programmable input            –10%8           40          +10%8        Ω
                           termination to VCCO/2 where ODT = RTT_40
                           Thevenin equivalent resistance of programmable input            –10%8           48          +10%8        Ω
                           termination to VCCO/2 where ODT = RTT_48
                           Thevenin equivalent resistance of programmable input            –10%8           60          +10%8        Ω
                           termination to VCCO/2 where ODT = RTT_60
                           Programmable input termination to VCCO where ODT = RTT_40       –10%8           40          +10%8        Ω
                           Programmable input termination to VCCO where ODT = RTT_48       –10%8           48          +10%8        Ω
                           Programmable input termination to VCCO where ODT = RTT_60       –10%8           60          +10%8        Ω
                           Programmable input termination to VCCO where ODT = RTT_120      –10%8          120          +10%8        Ω
                           Programmable input termination to VCCOwhere ODT = RTT_240       –10%8          240          +10%8        Ω
Uncalibrated programmable on-die termination in HP I/Os banks (measured per JEDEC specification)
R9                         Thevenin equivalent resistance of programmable input            –50%            40          +50%         Ω
                           termination to VCCO/2 where ODT = RTT_40
                           Thevenin equivalent resistance of programmable input            –50%            48          +50%         Ω
                           termination to VCCO/2 where ODT = RTT_48
                           Thevenin equivalent resistance of programmable input            –50%            60          +50%         Ω
                           termination to VCCO/2 where ODT = RTT_60
                           Programmable input termination to VCCO where ODT = RTT_40       –50%            40          +50%         Ω
                           Programmable input termination to VCCO where ODT = RTT_48       –50%            48          +50%         Ω
                           Programmable input termination to VCCO where ODT = RTT_60       –50%            60          +50%         Ω
                           Programmable input termination to VCCO where ODT = RTT_120      –50%           120          +50%         Ω
                           Programmable input termination to VCCO where ODT = RTT_240      –50%           240          +50%         Ω

DS925 (v1.30) July 9, 2026
                                                                                                           Send Feedback
Product Specification                                                                                                                    7

                                                          Zynq UltraScale+ MPSoC Data Sheet: DC and AC Switching Characteristics

Table 4: DC Characteristics Over Recommended Operating Conditions (cont'd)

             Symbol                                        Description                                   Min          Typ1         Max        Units
Uncalibrated programmable on-die termination in HD I/O banks (measured per JEDEC specification)
R9                               Thevenin equivalent resistance of programmable input                   –50%           48          +50%        Ω
                                 termination to VCCO/2 where ODT = RTT_48
Notes:
1.         Typical values are specified at nominal voltage, 25°C.
2.         For the HP I/O banks with a VCCO of 1.8V and separated VCCO and VCCAUX_IO power supplies, the IL maximum current is 70 µA.
3.         This measurement represents the die capacitance at the pad, not including the package.
4.         Maximum value specified for worst case process at 25°C.
5.         ICC_PSBATT is measured when the battery-backed RAM (BBRAM) is enabled.
6.         Do not program eFUSE during device configuration (e.g., during configuration, during configuration readback, or when readback CRC is
           active).
7.         VRP resistor tolerance is (240Ω ±1%).
8.         If VRP resides at a different bank (DCI cascade), the range increases to ±15%.
9.         On-die input termination resistance, for more information see the UltraScale Architecture SelectIO Resources User Guide (UG571).

Table 5: PS MIO Pull-up and Pull-down Current

     Symbol                                             Description                                            Min              Max           Units
IRPU   1                 Pad pull-up (when selected) at VIN = 0V, VCCO_PSIO = 3.3V                             20                 80           µA
                         Pad pull-up (when selected) at VIN = 0V, VCCO_PSIO = 2.5V                             20                 80           µA
                         Pad pull-up (when selected) at VIN = 0V, VCCO_PSIO = 1.8V                             15                 65           µA
IRPD                     Pad pull-down (when selected) at VIN = 3.3V                                           20                 80           µA
                         Pad pull-down (when selected) at VIN = 2.5V                                           20                 80           µA
                         Pad pull-down (when selected) at VIN = 1.8V                                           15                 65           µA
Notes:
1.         After power-on, the reset values of the MIO pin configuration registers enable and select the PS MIO pull-ups.

DS925 (v1.30) July 9, 2026
                                                                                                                        Send Feedback
Product Specification                                                                                                                               8

                                                   Zynq UltraScale+ MPSoC Data Sheet: DC and AC Switching Characteristics

VIN Maximum Allowed AC Voltage Overshoot and Undershoot
Table 6: VIN Maximum Allowed AC Voltage Overshoot and Undershoot for HD I/O Banks

 AC Voltage Overshoot1             % of UI2 at –40°C to 100°C3           AC Voltage Undershoot1             % of UI2 at –40°C to 100°C3
          VCCO + 0.30                            100%                                 –0.30                               100%
          VCCO + 0.35                            100%                                 –0.35                                90%
          VCCO + 0.40                            100%                                 –0.40                                78%
          VCCO + 0.45                            100%                                 –0.45                                40%
          VCCO + 0.50                            100%                                 –0.50                                24%
          VCCO + 0.55                            100%                                 –0.55                               18.0%
          VCCO + 0.60                            100%                                 –0.60                               13.0%
          VCCO + 0.65                            100%                                 –0.65                               10.8%
          VCCO + 0.70                             92%                                 –0.70                               9.0%
          VCCO + 0.75                             92%                                 –0.75                               7.0%
          VCCO + 0.80                             92%                                 –0.80                               6.0%
          VCCO + 0.85                             92%                                 –0.85                               5.0%
          VCCO + 0.90                             92%                                 –0.90                               4.0%
          VCCO + 0.95                             92%                                 –0.95                               2.5%
Notes:
1.   A total of 200 mA per bank should not be exceeded.
2.   For UI smaller than 20 µs.
3.   For the -1Q devices, the upper temperature limit is 125°C. For the -1M devices, the temperature limits are –55°C to 125°C.

Table 7: VIN Maximum Allowed AC Voltage Overshoot and Undershoot for HP I/O Banks

 AC Voltage Overshoot1             % of UI2 at –40°C to 100°C3           AC Voltage Undershoot1             % of UI2 at –40°C to 100°C3
          VCCO + 0.30                            100%                                 –0.30                               100%
          VCCO + 0.35                            100%                                 –0.35                               100%
          VCCO + 0.40                             92%                                 –0.40                                92%
          VCCO + 0.45                             50%                                 –0.45                                50%
          VCCO + 0.50                             20%                                 –0.50                                20%
          VCCO + 0.55                             10%                                 –0.55                                10%
          VCCO + 0.60                             6%                                  –0.60                                6%
          VCCO + 0.65                             2%                                  –0.65                                2%
          VCCO + 0.70                             2%                                  –0.70                                2%
Notes:
1.   A total of 200 mA per bank should not be exceeded.
2.   For UI smaller than 20 µs.
3.   For the -1Q devices, the upper temperature limit is 125°C. For the -1M devices, the temperature limits are –55°C to 125°C.

DS925 (v1.30) July 9, 2026
                                                                                                                  Send Feedback
Product Specification                                                                                                                     9

                                                   Zynq UltraScale+ MPSoC Data Sheet: DC and AC Switching Characteristics

Table 8: VPSIN Maximum Allowed AC Voltage Overshoot and Undershoot for PS I/O Banks

 AC Voltage Overshoot1             % of UI2 at –40°C to 100°C3           AC Voltage Undershoot1             % of UI2 at –40°C to 100°C3
         VCCO_PSIO + 0.30                        100%                                 –0.30                               100%
         VCCO_PSIO + 0.35                        100%                                 –0.35                                75%
         VCCO_PSIO + 0.40                        100%                                 –0.40                                45%
         VCCO_PSIO + 0.45                        100%                                 –0.45                                40%
         VCCO_PSIO + 0.50                         75%                                 –0.50                                10%
         VCCO_PSIO + 0.55                         75%                                 –0.55                                6%
         VCCO_PSIO + 0.60                         60%                                 –0.60                                2%
         VCCO_PSIO + 0.65                         30%                                 –0.65                                0%
         VCCO_PSIO + 0.70                         20%                                 –0.70                                0%
         VCCO_PSIO + 0.75                         10%                                 –0.75                                0%
         VCCO_PSIO + 0.80                         10%                                 –0.80                                0%
         VCCO_PSIO + 0.85                         8%                                  –0.85                                0%
         VCCO_PSIO + 0.90                         6%                                  –0.90                                0%
         VCCO_PSIO + 0.95                         6%                                  –0.95                                0%
Notes:
1.   A total of 200 mA per bank should not be exceeded.
2.   For UI smaller than 20 µs.
3.   For the -1Q devices, the upper temperature limit is 125°C. For the -1M devices, the temperature limits are –55°C to 125°C.

DS925 (v1.30) July 9, 2026
                                                                                                                  Send Feedback
Product Specification                                                                                                                     10

                                              Zynq UltraScale+ MPSoC Data Sheet: DC and AC Switching Characteristics

Quiescent Supply Current
Table 9: Typical Quiescent Supply Current

                                                                 Speed Grade and VCCINT Operating Voltages
  Symbol              Description1, 2, 3, 4           Device     0.90V            0.85V                 0.72V          Units
                                                                   -3       -2             -1     -2             -1
ICCINTQ     Quiescent VCCINT supply current         XCZU1         N/A      212            212    193            193     mA
                                                    XCZU2         N/A      393            393    344            344     mA
                                                    XCZU3         N/A      393            393    344            344     mA
                                                    XCZU3T        N/A      394            394    348            348     mA
                                                    XCZU4         719      684            684    601            601     mA
                                                    XCZU5         719      684            684    601            601     mA
                                                    XCZU6         1629     1549           1549   1358           1358    mA
                                                    XCZU7         1263     1201           1201   1055           1055    mA
                                                    XCZU9         1629     1549           1549   1358           1358    mA
                                                    XCZU11        1786     1699           1699   1491           1491    mA
                                                    XCZU15        1987     1890           1890   1660           1660    mA
                                                    XCZU17        2728     2594           2594   2275           2275    mA
                                                    XCZU19        2728     2594           2594   2275           2275    mA
                                                    XAZU1         N/A      N/A            212    N/A            193     mA
                                                    XAZU2         N/A      N/A            393    N/A            344     mA
                                                    XAZU3         N/A      N/A            393    N/A            344     mA
                                                    XAZU3T        N/A      N/A            394    N/A            348     mA
                                                    XAZU4         N/A      N/A            684    N/A            601     mA
                                                    XAZU5         N/A      N/A            684    N/A            601     mA
                                                    XAZU7         N/A      N/A            1201   N/A            N/A     mA
                                                    XAZU11        N/A      N/A            1699   N/A            N/A     mA
                                                    XQZU3         N/A      393            393    N/A            344     mA
                                                    XQZU5         N/A      684            684    N/A            601     mA
                                                    XQZU7         N/A      1201           1201   N/A            1055    mA
                                                    XQZU9         N/A      1549           1549   N/A            1358    mA
                                                    XQZU11        N/A      1699           1699   N/A            1491    mA
                                                    XQZU15        N/A      1890           1890   N/A            1660    mA
                                                    XQZU19        N/A      2594           2594   N/A            2275    mA

DS925 (v1.30) July 9, 2026
                                                                                                 Send Feedback
Product Specification                                                                                                        11

                                                  Zynq UltraScale+ MPSoC Data Sheet: DC and AC Switching Characteristics

Table 9: Typical Quiescent Supply Current (cont'd)

                                                                      Speed Grade and VCCINT Operating Voltages
  Symbol               Description1, 2, 3, 4              Device      0.90V           0.85V               0.72V         Units
                                                                       -3       -2            -1     -2           -1
ICCINT_IOQ   Quiescent VCCINT_IO supply current         XCZU1          N/A      44            44     44           44     mA
                                                        XCZU2          N/A      44            44     44           44     mA
                                                        XCZU3          N/A      44            44     44           44     mA
                                                        XCZU3T         N/A      16            16     16           16     mA
                                                        XCZU4          61       59            59     59           59     mA
                                                        XCZU5          61       59            59     59           59     mA
                                                        XCZU6          61       59            59     59           59     mA
                                                        XCZU7          120      115           115   115           115    mA
                                                        XCZU9          61       59            59     59           59     mA
                                                        XCZU11         120      115           115   115           115    mA
                                                        XCZU15         61       59            59     59           59     mA
                                                        XCZU17         164      158           158   158           158    mA
                                                        XCZU19         164      158           158   158           158    mA
                                                        XAZU1          N/A      N/A           44    N/A           44     mA
                                                        XAZU2          N/A      N/A           44    N/A           44     mA
                                                        XAZU3          N/A      N/A           44    N/A           44     mA
                                                        XAZU3T         N/A      N/A           16    N/A           16     mA
                                                        XAZU4          N/A      N/A           59    N/A           59     mA
                                                        XAZU5          N/A      N/A           59    N/A           59     mA
                                                        XAZU7          N/A      N/A           115   N/A           N/A    mA
                                                        XAZU11         N/A      N/A           115   N/A           N/A    mA
                                                        XQZU3          N/A      44            44    N/A           44     mA
                                                        XQZU5          N/A      59            59    N/A           59     mA
                                                        XQZU7          N/A      115           115   N/A           115    mA
                                                        XQZU9          N/A      59            59    N/A           59     mA
                                                        XQZU11         N/A      115           115   N/A           115    mA
                                                        XQZU15         N/A      59            59    N/A           59     mA
                                                        XQZU19         N/A      158           158   N/A           158    mA
ICCOQ        Quiescent VCCO supply current              All devices     1        1             1     1             1     mA

DS925 (v1.30) July 9, 2026
                                                                                                    Send Feedback
Product Specification                                                                                                         12

                                              Zynq UltraScale+ MPSoC Data Sheet: DC and AC Switching Characteristics

Table 9: Typical Quiescent Supply Current (cont'd)

                                                                 Speed Grade and VCCINT Operating Voltages
  Symbol              Description1, 2, 3, 4           Device     0.90V           0.85V               0.72V         Units
                                                                  -3        -2           -1     -2           -1
ICCAUXQ     Quiescent VCCAUX supply current         XCZU1         N/A       29           29     29           29     mA
                                                    XCZU2         N/A       55           55     55           55     mA
                                                    XCZU3         N/A       55           55     55           55     mA
                                                    XCZU3T        N/A       72           72     72           72     mA
                                                    XCZU4         90        90           90     90           90     mA
                                                    XCZU5         90        90           90     90           90     mA
                                                    XCZU6         227      227           227   227           227    mA
                                                    XCZU7         174      174           174   174           174    mA
                                                    XCZU9         227      227           227   227           227    mA
                                                    XCZU11        255      255           255   255           255    mA
                                                    XCZU15        266      266           266   266           266    mA
                                                    XCZU17        396      396           396   396           396    mA
                                                    XCZU19        396      396           396   396           396    mA
                                                    XAZU1         N/A      N/A           29    N/A           29     mA
                                                    XAZU2         N/A      N/A           55    N/A           55     mA
                                                    XAZU3         N/A      N/A           55    N/A           55     mA
                                                    XAZU3T        N/A      N/A           72    N/A           72     mA
                                                    XAZU4         N/A      N/A           90    N/A           90     mA
                                                    XAZU5         N/A      N/A           90    N/A           90     mA
                                                    XAZU7         N/A      N/A           174   N/A           N/A    mA
                                                    XAZU11        N/A      N/A           255   N/A           N/A    mA
                                                    XQZU3         N/A       55           55    N/A           55     mA
                                                    XQZU5         N/A       90           90    N/A           90     mA
                                                    XQZU7         N/A      174           174   N/A           174    mA
                                                    XQZU9         N/A      227           227   N/A           227    mA
                                                    XQZU11        N/A      255           255   N/A           255    mA
                                                    XQZU15        N/A      266           266   N/A           266    mA
                                                    XQZU19        N/A      396           396   N/A           396    mA

DS925 (v1.30) July 9, 2026
                                                                                               Send Feedback
Product Specification                                                                                                    13

                                                  Zynq UltraScale+ MPSoC Data Sheet: DC and AC Switching Characteristics

Table 9: Typical Quiescent Supply Current (cont'd)

                                                                     Speed Grade and VCCINT Operating Voltages
  Symbol               Description1, 2, 3, 4              Device     0.90V           0.85V              0.72V         Units
                                                                      -3        -2           -1    -2           -1
ICCAUX_IOQ   Quiescent VCCAUX_IO supply current         XCZU1         N/A       26           26    26           26     mA
                                                        XCZU2         N/A       26           26    26           26     mA
                                                        XCZU3         N/A       26           26    26           26     mA
                                                        XCZU3T        N/A       8            8     8             8     mA
                                                        XCZU4         32        32           32    32           32     mA
                                                        XCZU5         32        32           32    32           32     mA
                                                        XCZU6         33        33           33    33           33     mA
                                                        XCZU7         56        56           56    56           56     mA
                                                        XCZU9         33        33           33    33           33     mA
                                                        XCZU11        56        56           56    56           56     mA
                                                        XCZU15        33        33           33    33           33     mA
                                                        XCZU17        74        74           74    74           74     mA
                                                        XCZU19        74        74           74    74           74     mA
                                                        XAZU1         N/A      N/A           26   N/A           26     mA
                                                        XAZU2         N/A      N/A           26   N/A           26     mA
                                                        XAZU3         N/A      N/A           26   N/A           26     mA
                                                        XAZU3T        N/A      N/A           8    N/A            8     mA
                                                        XAZU4         N/A      N/A           32   N/A           32     mA
                                                        XAZU5         N/A      N/A           32   N/A           32     mA
                                                        XAZU7         N/A      N/A           56   N/A           N/A    mA
                                                        XAZU11        N/A      N/A           56   N/A           N/A    mA
                                                        XQZU3         N/A       26           26   N/A           26     mA
                                                        XQZU5         N/A       32           32   N/A           32     mA
                                                        XQZU7         N/A       56           56   N/A           56     mA
                                                        XQZU9         N/A       33           33   N/A           33     mA
                                                        XQZU11        N/A       56           56   N/A           56     mA
                                                        XQZU15        N/A       33           33   N/A           33     mA
                                                        XQZU19        N/A       74           74   N/A           74     mA

DS925 (v1.30) July 9, 2026
                                                                                                  Send Feedback
Product Specification                                                                                                       14

                                                    Zynq UltraScale+ MPSoC Data Sheet: DC and AC Switching Characteristics

Table 9: Typical Quiescent Supply Current (cont'd)

                                                                               Speed Grade and VCCINT Operating Voltages
  Symbol                  Description1, 2, 3, 4                 Device         0.90V              0.85V                    0.72V           Units
                                                                                 -3          -2           -1          -2           -1
ICCBRAMQ       Quiescent VCCBRAM supply current               XCZU1             N/A           3           3            3            3        mA
                                                              XCZU2             N/A           6           6            6            6        mA
                                                              XCZU3             N/A           6           6            6            6        mA
                                                              XCZU3T            N/A           7           7            7            7        mA
                                                              XCZU4              9            9           9            9            9        mA
                                                              XCZU5              9            9           9            9            9        mA
                                                              XCZU6              25          24           24          24           24        mA
                                                              XCZU7              16          15           15          15           15        mA
                                                              XCZU9              25          24           24          24           24        mA
                                                              XCZU11             23          22           22          22           22        mA
                                                              XCZU15             29          28           28          28           28        mA
                                                              XCZU17             37          35           35          35           35        mA
                                                              XCZU19             37          35           35          35           35        mA
                                                              XAZU1             N/A         N/A           3          N/A            3        mA
                                                              XAZU2             N/A         N/A           6          N/A            6        mA
                                                              XAZU3             N/A         N/A           6          N/A            6        mA
                                                              XAZU3T            N/A         N/A           7          N/A            7        mA
                                                              XAZU4             N/A         N/A           9          N/A            9        mA
                                                              XAZU5             N/A         N/A           9          N/A            9        mA
                                                              XAZU7             N/A         N/A           15         N/A           N/A       mA
                                                              XAZU11            N/A         N/A           22         N/A           N/A       mA
                                                              XQZU3             N/A           6           6          N/A            6        mA
                                                              XQZU5             N/A           9           9          N/A            9        mA
                                                              XQZU7             N/A          15           15         N/A           15        mA
                                                              XQZU9             N/A          24           24         N/A           24        mA
                                                              XQZU11            N/A          22           22         N/A           22        mA
                                                              XQZU15            N/A          28           28         N/A           28        mA
                                                              XQZU19            N/A          35           35         N/A           35        mA
Notes:
1.   Typical values are specified at nominal voltage, 85°C junction temperatures (Tj) with single-ended SelectIO™ resources.
2.   Typical values are for blank configured devices with no output current loads, no active input pull-up resistors, and all I/O pins are 3-state
     and floating.
3.   Use the Xilinx Power Estimator (XPE) spreadsheet tool (download at www.amd.com/power) to estimate static power consumption for
     conditions or supplies other than those specified.
4.   Typical values depend upon your configuration. To accurately estimate all PS supply currents, use the interactive XPE spreadsheet tool.

DS925 (v1.30) July 9, 2026
                                                                                                                    Send Feedback
Product Specification                                                                                                                             15

                                       Zynq UltraScale+ MPSoC Data Sheet: DC and AC Switching Characteristics

Power Supply Sequencing
PS Power-On/Off Power Supply Sequencing
The low-power domain (LPD) must operate before the full-power domain (FPD) can function. The low-power
and full-power domains can be powered simultaneously. The PS_POR_B input must be asserted to GND during
the power-on sequence (see Table 37). The FPD (when used) must be powered before PS_POR_B is released.

To achieve minimum current draw at power-on, the recommended power-on sequence for the low-power
domain (LPD) is listed. The recommended power-off sequence is the reverse of the power-on sequence.

1. VCC_PSINTLP
2. VCC_PSAUX, VCC_PSADC, and VCC_PSPLL in any order or simultaneously.
3. VCCO_PSIO

To achieve minimum current draw at power-on, the recommended power-on sequence for the full-power
domain (FPD) is listed. The recommended power-off sequence is the reverse of the power-on sequence.

1. VCC_PSINTFP and VCC_PSINTFP_DDR driven from the same supply source.
2. VPS_MGTRAVCC and VCC_PSDDR_PLL in any order or simultaneously.
3. VPS_MGTRAVTT and VCCO_PSDDR in any order or simultaneously.

PL Power-On/Off Power Supply Sequencing
The recommended power-on sequence is VCCINT, VCCINT_IO/VCCBRAM/VCCINT_VCU, VCCAUX/VCCAUX_IO, and VCCO
to achieve minimum current draw and ensure that the I/Os are 3-stated at power-on. The recommended
power-off sequence is the reverse of the power-on sequence. If VCCINT and VCCINT_IO/VCCBRAM have the same
recommended voltage levels, they can be powered by the same supply and ramped simultaneously. VCCINT_IO
must be connected to VCCBRAM. If VCCAUX/VCCAUX_IO and VCCO have the same recommended voltage levels,
they can be powered by the same supply and ramped simultaneously. VCCAUX and VCCAUX_IO must be connected
together. VCCADC and VREF can be powered at any time and have no power-up sequencing requirements.

The recommended power-on sequence to achieve minimum current draw for the GTH or GTY transceivers
is VCCINT, VMGTAVCC, VMGTAVTT OR VMGTAVCC, VCCINT, VMGTAVTT. There is no recommended sequencing for
VMGTVCCAUX. Both VMGTAVCC and VCCINT can be ramped simultaneously. The recommended power-off sequence
is the reverse of the power-on sequence to achieve minimum current draw. If these recommended sequences
are not met, current drawn from VMGTAVTT can be higher than specifications during power-up and power-down.

PS-PL Power Sequencing
The PS and PL power supplies are fully independent. All PS power supplies can be powered before or after any
PL power supplies. The PS and PL power regions are isolated to prevent damage.

DS925 (v1.30) July 9, 2026
                                                                                      Send Feedback
Product Specification                                                                                      16

                                        Zynq UltraScale+ MPSoC Data Sheet: DC and AC Switching Characteristics

Power Supply Requirements
Table 10 shows the minimum current, in addition to ICCQ maximum, required by each Zynq UltraScale+ MPSoC
for proper power-on and configuration. If these current minimums are met, the device powers on after all
supplies have passed through their power-on reset threshold voltages. The device must not be configured until
after VCCINT is applied. Once initialized and configured, use the Xilinx Power Estimator (XPE) spreadsheet tool
(download at www.amd.com/power) to estimate current drain on these supplies. XPE is also used to estimate
power-on current for all supplies.

Table 10: Power-on Current by Device

    ICC Min =         ICCINTMIN    ICCINT_IOMIN + ICCBRAMMIN     ICCOMIN        ICCAUXMIN + ICCAUX_IOMIN
                                                                                                           Units
     ICCQ +           ICCINTQ +      ICCBRAMQ + ICCINT_IOQ +      ICCOQ +        ICCAUXQ + ICCAUX_IOQ +
      XCZU1              464                  155                   50                    111               mA
      XAZU1
      XCZU2              464                  155                   50                    111               mA
      XAZU2
      XCZU3              464                  155                   50                    111               mA
      XAZU3
      XQZU3
     XCZU3T              472                  158                   50                    113               mA
     XAZU3T
      XCZU4              770                  257                   50                    386               mA
      XAZU4
      XCZU5              770                  257                   50                    386               mA
      XAZU5
      XQZU5
      XCZU6              1800                 600                   50                    650               mA
      XCZU7              1514                 505                   50                    362               mA
      XAZU7
      XQZU7
      XCZU9              1800                 600                   50                    650               mA
      XQZU9
     XCZU11              1961                 654                   55                    709               mA
     XAZU11
     XQZU11
     XCZU15              2242                 748                   63                    810               mA
     XQZU15
     XCZU17              3433                 1145                  96                    1240              mA
     XCZU19              3433                 1145                  96                    1240              mA
     XQZU19

DS925 (v1.30) July 9, 2026
                                                                                         Send Feedback
Product Specification                                                                                            17

                                                      Zynq UltraScale+ MPSoC Data Sheet: DC and AC Switching Characteristics

Table 11: Power Supply Ramp Time

                 Symbol                                            Description                               Min            Max        Units
TVCCINT                                  Ramp time from GND to 95% of VCCINT                                  0.2           40          ms
TVCCINT_IO                               Ramp time from GND to 95% of VCCINT_IO                               0.2           40          ms
TVCCINT_VCU                              Ramp time from GND to 95% of VCCINT_VCU                              0.2           40          ms
TVCCO                                    Ramp time from GND to 95% of VCCO                                    0.2           40          ms
TVCCAUX                                  Ramp time from GND to 95% of VCCAUX                                  0.2           40          ms
TVCCBRAM                                 Ramp time from GND to 95% of VCCBRAM                                 0.2           40          ms
TMGTAVCC                                 Ramp time from GND to 95% of VMGTAVCC                                0.2           40          ms
TMGTAVTT                                 Ramp time from GND to 95% of VMGTAVTT                                0.2           40          ms
TMGTVCCAUX                               Ramp time from GND to 95% of VMGTVCCAUX                              0.2           40          ms
TVCC_PSINTFP                             Ramp time from GND to 95% of VCC_PSINTFP                             0.2           40          ms
TVCC_PSINTLP                             Ramp time from GND to 95% of VCC_PSINTLP                             0.2           40          ms
TVCC_PSAUX                               Ramp time from GND to 95% of VCC_PSAUX                               0.2           40          ms
TVCC_PSINTFP_DDR                         Ramp time from GND to 95% of VCC_PSINTFP_DDR                         0.2           40          ms
TVCC_PSADC                               Ramp time from GND to 95% of VCC_PSADC                               0.2           40          ms
TVCC_PSPLL                               Ramp time from GND to 95% of VCC_PSPLL                               0.2           40          ms
TPS_MGTRAVCC                             Ramp time from GND to 95% of VCC_MGTRAVCC                            0.2           40          ms
TPS_MGTRAVTT                             Ramp time from GND to 95% of VCC_MGTRAVTT                            0.2           40          ms
TVCCO_PSDDR                              Ramp time from GND to 95% of VCCO_PSDDR                              0.2           40          ms
TVCC_PSDDR_PLL                           Ramp time from GND to 95% of VCC_PSDDR_PLL                           0.2           40          ms
TVCCO_PSIO                               Ramp time from GND to 95% of VCCO_PSIO                               0.2           40          ms

DC Input and Output Levels
Values for VIL and VIH are recommended input voltages. Values for IOL and IOH are guaranteed over the
recommended operating conditions at the VOL and VOH test points. Only selected standards are tested. These
are chosen to ensure that all standards meet their specifications. The selected standards are tested at a
minimum VCCO with the respective VOL and VOH voltage levels shown. Other standards are sample tested.

PS I/O Levels
Table 12: PS MIO and CONFIG DC Input and Output Levels

        I/O                       VIL                                  VIH                       VOL          VOH                IOL     IOH
     Standard1       V, Min          V, Max              V, Min                 V, Max          V, Max      V, Min               mA      mA
LVCMOS33              –0.300            0.800             2.000                 VCCO_PSIO        0.40         2.40                12     –12
LVCMOS25              –0.300            0.700             1.700              VCCO_PSIO + 0.30    0.70         1.70                12     –12
LVCMOS18              –0.300      35% VCCO_PSIO        65% VCCO_PSIO         VCCO_PSIO + 0.30    0.45    VCCO_PSIO – 0.45         12     –12
Notes:
1.     Tested according to relevant specifications.

DS925 (v1.30) July 9, 2026
                                                                                                              Send Feedback
Product Specification                                                                                                                        18

                                                            Zynq UltraScale+ MPSoC Data Sheet: DC and AC Switching Characteristics

Table 13: PS DDR DC Input and Output Levels

    DDR                     VIL                               VIH                              VOL2                             VOH2                 IOL     IOH
 Standard1        V, Min       V, Max             V, Min            V, Max                  V, Max                            V, Min                 mA mA
DDR4                0.000     VREF – 0.100      VREF + 0.100        VCCO_PSDDR       0.8 x VCCO_PSDDR – 0.150          0.8 x VCCO_PSDDR + 0.150      10      –0.1
LPDDR4              0.000     VREF – 0.100      VREF + 0.100        VCCO_PSDDR       0.3 x VCCO_PSDDR – 0.150          0.3 x VCCO_PSDDR + 0.150      0.1      –10
DDR3               –0.300     VREF – 0.100      VREF + 0.100        VCCO_PSDDR       0.5 x VCCO_PSDDR – 0.175          0.5 x VCCO_PSDDR + 0.175       8       –8
LPDDR3              0.000     VREF – 0.100      VREF + 0.100        VCCO_PSDDR       0.5 x VCCO_PSDDR – 0.150          0.5 x VCCO_PSDDR + 0.150       8       –8
DDR3L              –0.300     VREF – 0.090      VREF + 0.090        VCCO_PSDDR       0.5 x VCCO_PSDDR – 0.150          0.5 x VCCO_PSDDR + 0.150       8       –8
Notes:
1.     Tested according to relevant specifications.
2.     DDR4 VOL/VOH specifications are only applicable for DQ/DQS pins.

PL I/O Levels
Table 14: SelectIO DC Input and Output Levels For HD I/O Banks

                                        VIL                                   VIH                         VOL                  VOH            IOL           IOH
     I/O Standard1, 2
                             V, Min           V, Max             V, Min              V, Max             V, Max               V, Min          mA             mA
HSTL_I                        –0.300         VREF – 0.100      VREF + 0.100         VCCO + 0.300          0.400            VCCO – 0.400       8.0           –8.0
HSTL_I_18                     –0.300         VREF – 0.100      VREF + 0.100         VCCO + 0.300          0.400            VCCO – 0.400       8.0           –8.0
HSUL_12                       –0.300         VREF – 0.130      VREF + 0.130         VCCO + 0.300        20% VCCO            80% VCCO          0.1           –0.1
LVCMOS12                      –0.300          35% VCCO          65% VCCO            VCCO + 0.300          0.400            VCCO – 0.400     Note 3         Note 3
LVCMOS15                      –0.300          35% VCCO          65% VCCO            VCCO + 0.300          0.450            VCCO – 0.450     Note 4         Note 4
LVCMOS18                      –0.300          35% VCCO          65% VCCO            VCCO + 0.300          0.450            VCCO – 0.450     Note 4         Note 4
LVCMOS25                      –0.300            0.700               1.700           VCCO + 0.300          0.400            VCCO – 0.400     Note 4         Note 4
LVCMOS33                      –0.300            0.800               2.000              3.400              0.400            VCCO – 0.400     Note 4         Note 4
LVTTL                         –0.300            0.800               2.000              3.400              0.400               2.400         Note 4         Note 4
SSTL12                        –0.300         VREF – 0.100      VREF + 0.100         VCCO + 0.300      VCCO/2 – 0.150      VCCO/2 + 0.150     14.25         –14.25
SSTL135                       –0.300         VREF – 0.090      VREF + 0.090         VCCO + 0.300      VCCO/2 – 0.150      VCCO/2 + 0.150      8.9           –8.9
SSTL135_II                    –0.300         VREF – 0.090      VREF + 0.090         VCCO + 0.300      VCCO/2 – 0.150      VCCO/2 + 0.150     13.0          –13.0
SSTL15                        –0.300         VREF – 0.100      VREF + 0.100         VCCO + 0.300      VCCO/2 – 0.175      VCCO/2 + 0.175      8.9           –8.9
SSTL15_II                     –0.300         VREF – 0.100      VREF + 0.100         VCCO + 0.300      VCCO/2 – 0.175      VCCO/2 + 0.175     13.0          –13.0
SSTL18_I                      –0.300         VREF – 0.125      VREF + 0.125         VCCO + 0.300      VCCO/2 – 0.470      VCCO/2 + 0.470      8.0           –8.0
SSTL18_II                     –0.300         VREF – 0.125      VREF + 0.125         VCCO + 0.300      VCCO/2 – 0.600      VCCO/2 + 0.600     13.4          –13.4
Notes:
1.     Tested according to relevant specifications.
2.     Standards specified using the default I/O standard configuration. For details, see the UltraScale Architecture SelectIO Resources User Guide
       (UG571).
3.     Supported drive strengths of 4, 8, or 12 mA in HD I/O banks.
4.     Supported drive strengths of 4, 8, 12, or 16 mA in HD I/O banks.

DS925 (v1.30) July 9, 2026
                                                                                                                                Send Feedback
Product Specification                                                                                                                                              19

                                                       Zynq UltraScale+ MPSoC Data Sheet: DC and AC Switching Characteristics

Table 15: SelectIO DC Input and Output Levels for HP I/O Banks

                                       VIL                                  VIH                      VOL                VOH             IOL         IOH
 I/O Standard1, 2, 3
                            V, Min        V, Max            V, Min                 V, Max          V, Max              V, Min          mA           mA
HSTL_I                       –0.300     VREF – 0.100      VREF + 0.100            VCCO + 0.300       0.400           VCCO – 0.400       5.8         –5.8
HSTL_I_12                    –0.300     VREF – 0.080      VREF + 0.080            VCCO + 0.300     25% VCCO           75% VCCO          4.1         –4.1
HSTL_I_18                    –0.300     VREF – 0.100      VREF + 0.100            VCCO + 0.300       0.400           VCCO – 0.400       6.2         –6.2
HSUL_12                      –0.300     VREF – 0.130      VREF + 0.130            VCCO + 0.300     20% VCCO           80% VCCO          0.1         –0.1
LVCMOS12                     –0.300       35% VCCO         65% VCCO               VCCO + 0.300       0.400           VCCO – 0.400     Note 4    Note 4
LVCMOS15                     –0.300       35% VCCO         65% VCCO               VCCO + 0.300       0.450           VCCO – 0.450     Note 5    Note 5
LVCMOS18                     –0.300       35% VCCO         65% VCCO               VCCO + 0.300       0.450           VCCO – 0.450     Note 5    Note 5
LVDCI_15                     –0.300       35% VCCO         65% VCCO               VCCO + 0.300       0.450           VCCO – 0.450       7.0         –7.0
LVDCI_18                     –0.300       35% VCCO         65% VCCO               VCCO + 0.300       0.450           VCCO – 0.450       7.0         –7.0
SSTL12                       –0.300     VREF – 0.100      VREF + 0.100            VCCO + 0.300   VCCO/2 – 0.150     VCCO/2 + 0.150      8.0         –8.0
SSTL135                      –0.300     VREF – 0.090      VREF + 0.090            VCCO + 0.300   VCCO/2 – 0.150     VCCO/2 + 0.150      9.0         –9.0
SSTL15                       –0.300     VREF – 0.100      VREF + 0.100            VCCO + 0.300   VCCO/2 – 0.175     VCCO/2 + 0.175     10.0         –10.0
SSTL18_I                     –0.300     VREF – 0.125      VREF + 0.125            VCCO + 0.300   VCCO/2 – 0.470     VCCO/2 + 0.470      7.0         –7.0
MIPI_DPHY_ DCI_LP6           –0.300          0.550              0.8807            VCCO + 0.300       0.050              1.100          0.01         –0.01
Notes:
1.    Tested according to relevant specifications.
2.    Standards specified using the default I/O standard configuration. For details, see the UltraScale Architecture SelectIO Resources User Guide
      (UG571).
3.    POD10 and POD12 DC input and output levels are shown in Table 16, Table 21, and Table 22.
4.    Supported drive strengths of 2, 4, 6, or 8 mA in HP I/O banks.
5.    Supported drive strengths of 2, 4, 6, 8, or 12 mA in HP I/O banks.
6.    Low-power option for MIPI_DPHY_DCI.
7.    When operating at data rates greater than 1500 Mb/s, the minimum VIH is 0.790V. MIPI D-PHY data rates are outlined in Table 72.

Table 16: DC Input Levels for Single-ended POD10 and POD12 I/O Standards for HP I/O Banks

                                                          VIL                                                            VIH
     I/O Standard1, 2
                                        V, Min                            V, Max                       V, Min                         V, Max
POD10                                    –0.300                          VREF – 0.068                VREF + 0.068                    VCCO + 0.300
POD12                                    –0.300                          VREF – 0.068                VREF + 0.068                    VCCO + 0.300
Notes:
1.    Tested according to relevant specifications.
2.    Standards specified using the default I/O standard configuration. For details, see the UltraScale Architecture SelectIO Resources User Guide
      (UG571).

DS925 (v1.30) July 9, 2026
                                                                                                                          Send Feedback
Product Specification                                                                                                                                      20

                                                              Zynq UltraScale+ MPSoC Data Sheet: DC and AC Switching Characteristics

Table 17: Differential SelectIO DC Input and Output Levels for HD I/O and HP I/O Banks

                                       VICM (V)1                   VID (V)2           VILHS3        VIHHS3         VOCM (V)4                  VOD (V)5
     I/O Standard
                                Min       Typ      Max       Min     Typ      Max     Min           Max      Min      Typ     Max     Min       Typ      Max
SUB_LVDS8                      0.500      0.900    1.300   0.070       –          –     –             –      0.700    0.900   1.100   0.100    0.150     0.200
LVPECL9                        0.300      1.200    1.425   0.100    0.350     0.600     –             –       –        –        –       –        –            –
SLVS_400_1810                  0.070      0.200    0.330   0.140       –      0.450     –             –       –        –        –       –        –            –
SLVS_400_2511                  0.070      0.200    0.330   0.140       –      0.450     –             –       –        –        –       –        –            –
MIPI_DPHY_ DCI_HS12,           0.070       –       0.330   0.070       –          –   –0.040        0.460    0.150    0.200   0.250   0.140    0.200     0.270
13, 14

Notes:
1.       VICM is the input common mode voltage.
2.       VID is the input differential voltage (Q – Q).
3.       VIHHS and VILHS are the single-ended input high and low voltages, respectively.
4.       VOCM is the output common mode voltage.
5.       VOD is the output differential voltage (Q – Q).
6.       LVDS_25 is specified in Table 23.
7.       LVDS is specified in Table 24.
8.       The SUB_LVDS receiver is supported in HP I/O and HD I/O banks. The SUB_LVDS transmitter is supported only in HP I/O banks.
9.       LVPECL is supported only in HD I/O banks.
10. SLVS_400_18 is supported only in HP I/O banks.
11. SLVS_400_25 is supported only in HD I/O banks.
12. MIPI_DPHY_ DCI_HS is supported only in HP I/O banks.
13. High-speed option for MIPI_DPHY_DCI. The VID maximum is aligned with the standard’s specification. A higher VID is acceptable as long
    as the VIN specification is also met.
14. When operating at data rates greater than 1500 Mb/s, the minimum VID is 0.040V. MIPI D-PHY data rates are outlined in Table 72.

Table 18: Complementary Differential SelectIO DC Input and Output Levels for HD I/O Banks

                                       VICM (V)1                    VID (V)2             VOL (V)3                 VOH (V)4            IOL              IOH
     I/O Standard
                               Min         Typ       Max       Min          Max             Max                      Min              mA               mA
DIFF_HSTL_I                    0.300       0.750     1.125     0.100          –             0.400              VCCO – 0.400            8.0             –8.0
DIFF_HSTL_I_18                 0.300       0.900     1.425     0.100          –             0.400              VCCO – 0.400            8.0             –8.0
DIFF_HSUL_12                   0.300       0.600     0.850     0.100          –          20% VCCO                 80% VCCO             0.1             –0.1
DIFF_SSTL12                    0.300       0.600     0.850     0.100          –       (VCCO/2) – 0.150       (VCCO/2) + 0.150         14.25           –14.25
DIFF_SSTL135                   0.300       0.675     1.000     0.100          –       (VCCO/2) – 0.150       (VCCO/2) + 0.150          8.9             –8.9
DIFF_SSTL135_II                0.300       0.675     1.000     0.100          –       (VCCO/2) – 0.150       (VCCO/2) + 0.150         13.0             –13.0
DIFF_SSTL15                    0.300       0.750     1.125     0.100          –       (VCCO/2) – 0.175       (VCCO/2) + 0.175          8.9             –8.9
DIFF_SSTL15_II                 0.300       0.750     1.125     0.100          –       (VCCO/2) – 0.175       (VCCO/2) + 0.175         13.0             –13.0
DIFF_SSTL18_I                  0.300       0.900     1.425     0.100          –       (VCCO/2) – 0.470       (VCCO/2) + 0.470          8.0             –8.0
DIFF_SSTL18_II                 0.300       0.900     1.425     0.100          –       (VCCO/2) – 0.600       (VCCO/2) + 0.600         13.4             –13.4
Notes:
1.       VICM is the input common mode voltage.
2.       VID is the input differential voltage.
3.       VOL is the single-ended low-output voltage.
4.       VOH is the single-ended high-output voltage.

DS925 (v1.30) July 9, 2026
                                                                                                                                Send Feedback
Product Specification                                                                                                                                             21

                                                          Zynq UltraScale+ MPSoC Data Sheet: DC and AC Switching Characteristics

Table 19: Complementary Differential SelectIO DC Input and Output Levels for HP I/O Banks

                                                VICM (V)2                         VID (V)3          VOL (V)4               VOH (V)5              IOL     IOH
 I/O Standard1
                                 Min              Typ            Max            Min      Max          Max                     Min                mA      mA
DIFF_HSTL_I                     0.680            VCCO/2     (VCCO/2) + 0.150    0.100     –           0.400               VCCO – 0.400           5.8     –5.8
DIFF_HSTL_I_12               0.400 x VCCO        VCCO/2      0.600 x VCCO       0.100     –       0.250 x VCCO            0.750 x VCCO           4.1     –4.1
DIFF_HSTL_I_18             (VCCO/2) – 0.175      VCCO/2     (VCCO/2) + 0.175    0.100     –           0.400               VCCO – 0.400           6.2     –6.2
DIFF_HSUL_12               (VCCO/2) – 0.120      VCCO/2     (VCCO/2) + 0.120    0.100     –         20% VCCO                80% VCCO             0.1     –0.1
DIFF_SSTL12                (VCCO/2) – 0.150      VCCO/2     (VCCO/2) + 0.150    0.100     –      (VCCO/2) – 0.150        (VCCO/2) + 0.150        8.0     –8.0
DIFF_SSTL135               (VCCO/2) – 0.150      VCCO/2     (VCCO/2) + 0.150    0.100     –      (VCCO/2) – 0.150        (VCCO/2) + 0.150        9.0     –9.0
DIFF_SSTL15                (VCCO/2) – 0.175      VCCO/2     (VCCO/2) + 0.175    0.100     –      (VCCO/2) – 0.175        (VCCO/2) + 0.175        10.0    –10.0
DIFF_SSTL18_I              (VCCO/2) – 0.175      VCCO/2     (VCCO/2) + 0.175    0.100     –      (VCCO/2) – 0.470        (VCCO/2) + 0.470        7.0     –7.0
Notes:
1.     DIFF_POD10 and DIFF_POD12 HP I/O bank specifications are shown in Table 20, Table 21, and Table 22.
2.     VICM is the input common mode voltage.
3.     VID is the input differential voltage.
4.     VOL is the single-ended low-output voltage.
5.     VOH is the single-ended high-output voltage.

Table 20: DC Input Levels for Differential POD10 and POD12 I/O Standards for HP I/O Banks

                                                             VICM (V)                                                        VID (V)
     I/O Standard1, 2
                                       Min                      Typ                      Max                     Min                         Max
DIFF_POD10                            0.630                     0.700                    0.770                   0.140                           –
DIFF_POD12                            0.756                     0.840                    0.924                   0.160                           –
Notes:
1.     Tested according to relevant specifications.
2.     Standards specified using the default I/O standard configuration. For details, see the UltraScale Architecture SelectIO Resources User Guide
       (UG571).

Table 21: DC Output Levels for Single-ended and Differential POD10 and POD12 Standards for HP
I/O Banks

      Symbol               Description1, 2                                     VOUT                            Min          Typ          Max            Units
ROL                  Pull-down resistance            VOM_DC (as described in Table 22)                           36          40             44           Ω
ROH                  Pull-up resistance              VOM_DC (as described in Table 22)                           36          40             44           Ω
Notes:
1.     Tested according to relevant specifications.
2.     Standards specified using the default I/O standard configuration. For details, see the UltraScale Architecture SelectIO Resources User Guide
       (UG571).

Table 22: Definitions for DC Output Levels for Single-ended and Differential POD10 and POD12
Standards for HP I/O Banks

      Symbol                                                Description                                               All Speed Grades                  Units
VOM_DC               DC output Mid measurement level (for IV curve linearity)                                              0.8 x VCCO                     V

DS925 (v1.30) July 9, 2026
                                                                                                                           Send Feedback
Product Specification                                                                                                                                         22

                                                      Zynq UltraScale+ MPSoC Data Sheet: DC and AC Switching Characteristics

LVDS DC Specifications (LVDS_25)
The LVDS_25 standard is available in the HD I/O banks. See the UltraScale Architecture SelectIO Resources User
Guide (UG571) for more information.

Table 23: LVDS_25 DC Specifications

     Symbol                                         DC Parameter                                             Min        Typ       Max        Units
VCCO   1          Supply voltage                                                                            2.375      2.500      2.625         V
VIDIFF            Differential input voltage:                                                                100        350        6002        mV
                  (Q – Q), Q = High
                  (Q – Q), Q = High
VICM              Input common-mode voltage                                                                 0.300      1.200      1.425         V
Notes:
1.     LVDS_25 in HD I/O banks supports inputs only. LVDS_25 inputs without internal termination have no VCCO requirements. Any VCCO can be
       chosen as long as the input voltage levels do not violate the Recommended Operating Condition (Table 2) specification for the VIN I/O pin
       voltage.
2.     Maximum VIDIFF value is specified for the maximum VICM specification. With a lower VICM, a higher VDIFF is tolerated only when the
       recommended operating conditions and overshoot/undershoot VIN specifications are maintained.

LVDS DC Specifications (LVDS)
The LVDS standard is available in the HP I/O banks. See the UltraScale Architecture SelectIO Resources User Guide
(UG571) for more information.

Table 24: LVDS DC Specifications

     Symbol                  DC Parameter                                   Conditions                       Min        Typ       Max        Units
VCCO1             Supply voltage                                                                            1.710      1.800      1.890         V
VODIFF2           Differential output voltage:               RT = 100Ω across Q and Q signals                247        350        454         mV
                  (Q – Q), Q = High
                  (Q – Q), Q = High
VOCM   2          Output common-mode voltage                 RT = 100Ω across Q and Q signals               1.000      1.250      1.425         V
VIDIFF 3          Differential input voltage:                                                                100        350        6003        mV
                  (Q – Q), Q = High
                  (Q – Q), Q = High
VICM_DC4          Input common-mode voltage (DC coupling)                                                   0.300      1.200      1.425         V
VICM_AC5          Input common-mode voltage (AC coupling)                                                   0.600         –       1.100         V
Notes:
1.     In HP I/O banks, when LVDS is used with input-only functionality, it can be placed in a bank where the VCCO levels are different from the
       specified level only if internal differential termination is not used. In this scenario, VCCO must be chosen to ensure the input pin voltage
       levels do not violate the Recommended Operating Condition (Table 2) specification for the VIN I/O pin voltage.
2.     VOCM and VODIFF values are for LVDS_PRE_EMPHASIS = FALSE.
3.     Maximum VIDIFF value is specified for the maximum VICM specification. With a lower VICM, a higher VDIFF is tolerated only when the
       recommended operating conditions and overshoot/undershoot VIN specifications are maintained.
4.     Input common mode voltage for DC coupled configurations. EQUALIZATION = EQ_NONE (Default).
5.     External input common mode voltage specification for AC coupled configurations. EQUALIZATION = EQ_LEVEL0, EQ_LEVEL1, EQ_LEVEL2,
       EQ_LEVEL3, EQ_LEVEL4.

DS925 (v1.30) July 9, 2026
                                                                                                                       Send Feedback
Product Specification                                                                                                                                 23

                                            Zynq UltraScale+ MPSoC Data Sheet: DC and AC Switching Characteristics

AC Switching Characteristics
All values represented in this data sheet are based on the speed specifications in the AMD Vivado™ Design
Suite as outlined in the following table.

Table 25: Speed Specification Version By Device

       2023.2.1                                                     Device
         1.06          XCZU3TCG, XCZU3TEG
                       XAZU3TEG
         1.30          XCZU1CG, XCZU1EG, XCZU2CG, XCZU2EG, XCZU3CG, XCZU3EG, XCZU4CG, XCZU4EG, XCZU4EV, XCZU5CG, XCZU5EG,
                       XCZU5EV, XCZU6CG, XCZU6EG, XCZU7CG, XCZU7EG, XCZU7EV, XCZU9CG, XCZU9EG, XCZU11EG, XCZU15EG,
                       XCZU17EG, XCZU19EG
                       XAZU1EG
                       XQZU3EG, XQZU5EV, XQZU7EV, XQZU9EG, XQZU11EG, XQZU15EG, XQZU19EG
         1.31          XAZU2EG, XAZU3EG, XAZU4EV, XAZU5EV, XAZU7EV, XAZU11EG

Switching characteristics are specified on a per-speed-grade basis and can be designated as Advance,
Preliminary, or Production. Each designation is defined as follows:

• Advance Product Specification: These specifications are based on simulations only and are typically
  available soon after device design specifications are frozen. Although speed grades with this designation
  are considered relatively stable and conservative, some under-reporting might still occur.

• Preliminary Product Specification: These specifications are based on complete ES (engineering sample)
  silicon characterization. Devices and speed grades with this designation are intended to give a better
  indication of the expected performance of production silicon. The probability of under-reporting delays is
  greatly reduced as compared to Advance data.

• Product Specification: These specifications are released once enough production silicon of a particular
  device family member has been characterized to provide full correlation between specifications and devices
  over numerous production lots. There is no under-reporting of delays, and customers receive formal
  notification of any subsequent changes. Typically, the slowest speed grades transition to production before
  faster speed grades.

Testing of AC Switching Characteristics
Internal timing parameters are derived from measuring internal test patterns. All AC switching characteristics
are representative of worst-case supply voltage and junction temperature conditions.

For more specific, more precise, and worst-case guaranteed data, use the values reported by the static
timing analyzer and back-annotate to the simulation net list. Unless otherwise noted, values apply to all Zynq
UltraScale+ MPSoCs.

Speed Grade Designations
Because individual family members are produced at different times, the migration from one category to another
depends completely on the status of the fabrication process for each device. Table 26 correlates the current
status of the Zynq UltraScale+ MPSoC on a per speed grade basis. See Table 3 for operating voltages listed by
speed grade.

DS925 (v1.30) July 9, 2026
                                                                                                Send Feedback
Product Specification                                                                                                  24

                                       Zynq UltraScale+ MPSoC Data Sheet: DC and AC Switching Characteristics

Table 26: Speed Grade Designations by Device

                               Speed Grade, Temperature Ranges, and VCCINT Operating Voltages1
    Device
                             Advance                  Preliminary                         Production
XCZU1CG                                                                 -2E (VCCINT = 0.85V), -2I (VCCINT = 0.85V)
                                                                        -1E (VCCINT = 0.85V), -1I (VCCINT = 0.85V)
                                                                        -2LE (VCCINT = 0.85V)1, -2LE (VCCINT = 0.72V)1
                                                                        -1LI (VCCINT = 0.85V)1, -1LI (VCCINT = 0.72V)1
XCZU1EG                                                                 -2E (VCCINT = 0.85V), -2I (VCCINT = 0.85V)
                                                                        -1E (VCCINT = 0.85V), -1I (VCCINT = 0.85V)
                                                                        -2LE (VCCINT = 0.85V)1, -2LE (VCCINT = 0.72V)1
                                                                        -1LI (VCCINT = 0.85V)1, -1LI (VCCINT = 0.72V)1
XCZU2CG                                                                 -2E (VCCINT = 0.85V), -2I (VCCINT = 0.85V)
                                                                        -1E (VCCINT = 0.85V), -1I (VCCINT = 0.85V)
                                                                        -2LE (VCCINT = 0.85V)1, -2LE (VCCINT = 0.72V)1
                                                                        -1LI (VCCINT = 0.85V)1, -1LI (VCCINT = 0.72V)1
XCZU2EG                                                                 -2E (VCCINT = 0.85V), -2I (VCCINT = 0.85V)
                                                                        -1E (VCCINT = 0.85V), -1I (VCCINT = 0.85V)
                                                                        -2LE (VCCINT = 0.85V)1, -2LE (VCCINT = 0.72V)1
                                                                        -1LI (VCCINT = 0.85V)1, -1LI (VCCINT = 0.72V)1
XCZU3CG                                                                 -2E (VCCINT = 0.85V), -2I (VCCINT = 0.85V)
                                                                        -1E (VCCINT = 0.85V), -1I (VCCINT = 0.85V)
                                                                        -2LE (VCCINT = 0.85V)1, -2LE (VCCINT = 0.72V)1
                                                                        -1LI (VCCINT = 0.85V)1, -1LI (VCCINT = 0.72V)1
XCZU3EG                                                                 -2E (VCCINT = 0.85V), -2I (VCCINT = 0.85V)
                                                                        -1E (VCCINT = 0.85V), -1I (VCCINT = 0.85V)
                                                                        -2LE (VCCINT = 0.85V)1, -2LE (VCCINT = 0.72V)1
                                                                        -1LI (VCCINT = 0.85V)1, -1LI (VCCINT = 0.72V)1
XCZU3TCG                                                                -2E (VCCINT = 0.85V), -2I (VCCINT = 0.85V)
                                                                        -1E (VCCINT = 0.85V), -1I (VCCINT = 0.85V)
                                                                        -2LE (VCCINT = 0.85V)1, -2LE (VCCINT = 0.72V)1
                                                                        -1LI (VCCINT = 0.85V)1, -1LI (VCCINT = 0.72V)1
XCZU3TEG                                                                -2E (VCCINT = 0.85V), -2I (VCCINT = 0.85V)
                                                                        -1E (VCCINT = 0.85V), -1I (VCCINT = 0.85V)
                                                                        -2LE (VCCINT = 0.85V)1, -2LE (VCCINT = 0.72V)1
                                                                        -1LI (VCCINT = 0.85V)1, -1LI (VCCINT = 0.72V)1
XCZU4CG                                                                 -2E (VCCINT = 0.85V), -2I (VCCINT = 0.85V)
                                                                        -1E (VCCINT = 0.85V), -1I (VCCINT = 0.85V)
                                                                        -2LE (VCCINT = 0.85V)1, -2LE (VCCINT = 0.72V)1
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
                                                                        -1LI (VCCINT = 0.72V)1
XAZU2EG                                                                 -1I (VCCINT = 0.85V)
                                                                        -1Q (VCCINT = 0.85V)
                                                                        -1LI (VCCINT = 0.72V)1
XAZU3EG                                                                 -1I (VCCINT = 0.85V)
                                                                        -1Q (VCCINT = 0.85V)
                                                                        -1LI (VCCINT = 0.72V)1
XAZU3TEG                                                                -1I (VCCINT = 0.85V)
                                                                        -1Q (VCCINT = 0.85V)
                                                                        -1LI (VCCINT = 0.85V)1, -1LI (VCCINT = 0.72V)1
XAZU4EV                                                                 -1I (VCCINT = 0.85V)
                                                                        -1Q (VCCINT = 0.85V)
                                                                        -1LI (VCCINT = 0.72V)1
XAZU5EV                                                                 -1I (VCCINT = 0.85V)
                                                                        -1Q (VCCINT = 0.85V)
                                                                        -1LI (VCCINT = 0.72V)1
XAZU7EV                                                                 -1I (VCCINT = 0.85V)
                                                                        -1Q (VCCINT = 0.85V)
XAZU11EG                                                                -1I (VCCINT = 0.85V)
                                                                        -1Q (VCCINT = 0.85V)
XQZU3EG                                                                 -2I (VCCINT = 0.85V)
                                                                        -1I (VCCINT = 0.85V)
                                                                        -1M (VCCINT = 0.85V)
                                                                        -1LI (VCCINT = 0.85V)1, -1LI (VCCINT = 0.72V)1

DS925 (v1.30) July 9, 2026
                                                                                               Send Feedback
Product Specification                                                                                                    27

                                                      Zynq UltraScale+ MPSoC Data Sheet: DC and AC Switching Characteristics

Table 26: Speed Grade Designations by Device (cont'd)

                                       Speed Grade, Temperature Ranges, and VCCINT Operating Voltages1
     Device
                                   Advance                              Preliminary                                Production
XQZU5EV                                                                                         -2I (VCCINT = 0.85V)
                                                                                                -1I (VCCINT = 0.85V)
                                                                                                -1M (VCCINT = 0.85V)
                                                                                                -1LI (VCCINT = 0.85V)1, -1LI (VCCINT = 0.72V)1
XQZU7EV                                                                                         -2I (VCCINT = 0.85V)
                                                                                                -1I (VCCINT = 0.85V)
                                                                                                -1M (VCCINT = 0.85V)
                                                                                                -1LI (VCCINT = 0.85V)1, -1LI (VCCINT = 0.72V)1
XQZU9EG                                                                                         -2I (VCCINT = 0.85V)
                                                                                                -1I (VCCINT = 0.85V)
                                                                                                -1M (VCCINT = 0.85V)
                                                                                                -1LI (VCCINT = 0.85V)1, -1LI (VCCINT = 0.72V)1
XQZU11EG                                                                                        -2I (VCCINT = 0.85V)
                                                                                                -1I (VCCINT = 0.85V)
                                                                                                -1M (VCCINT = 0.85V)
                                                                                                -1LI (VCCINT = 0.85V)1, -1LI (VCCINT = 0.72V)1
XQZU15EG                                                                                        -2I (VCCINT = 0.85V)
                                                                                                -1I (VCCINT = 0.85V)
                                                                                                -1M (VCCINT = 0.85V)
                                                                                                -1LI (VCCINT = 0.85V)1, -1LI (VCCINT = 0.72V)1
XQZU19EG                                                                                        -2I (VCCINT = 0.85V)
                                                                                                -1I (VCCINT = 0.85V)
                                                                                                -1M (VCCINT = 0.85V)
                                                                                                -1LI (VCCINT = 0.85V)1, -1LI (VCCINT = 0.72V)1
Notes:
1.   The lowest power -1L and -2L devices, where VCCINT = 0.72V, are listed in the Vivado Design Suite as -1LV and -2LV, respectively.
     Otherwise, the -1L and -2L devices, where VCCINT = 0.85V, are listed in the Vivado Design Suite as -1L and -2L, respectively.

Production Silicon and Software Status
In some cases, a particular family member (and speed grade) is released to production before a speed
specification is released with the correct label (Advance, Preliminary, Production). Any labeling discrepancies
are corrected in subsequent speed specification releases.

Table 27 lists the production released Zynq UltraScale+ MPSoC, speed grade, and the minimum corresponding
supported speed specification version and Vivado software revisions. The Vivado software and speed
specifications listed are the minimum releases required for production. All subsequent releases of software
and speed specifications are valid.

Table 27: Zynq UltraScale+ MPSoC Device Production Software and Speed Specification Release

                                                   Speed Grade and VCCINT Operating Voltages1
  Device         0.90V                                                 0.85V                                                       0.72V
                   -3             -2             -1              -1Q             -1M           -2L           -1L           -2L             -1L
XCZU1CG           N/A         Vivado tools 2021.2.1 v1.29        N/A             N/A                     Vivado tools 2021.2.1 v1.29

DS925 (v1.30) July 9, 2026
                                                                                                                       Send Feedback
Product Specification                                                                                                                            28

                                                    Zynq UltraScale+ MPSoC Data Sheet: DC and AC Switching Characteristics

Table 27: Zynq UltraScale+ MPSoC Device Production Software and Speed Specification Release
(cont'd)

                                                Speed Grade and VCCINT Operating Voltages1
  Device      0.90V                                                0.85V                                          0.72V
                -3              -2             -1            -1Q           -1M      -2L        -1L         -2L              -1L
XCZU1EG         N/A         Vivado tools 2021.2.1 v1.29      N/A           N/A             Vivado tools 2021.2.1 v1.29
XCZU2CG         N/A          Vivado tools 2017.1 v1.10       N/A           N/A             Vivado tools 2017.3.1 v1.16
XCZU2EG         N/A          Vivado tools 2017.1 v1.10       N/A           N/A             Vivado tools 2017.3.1 v1.16
XCZU3CG         N/A          Vivado tools 2017.1 v1.10       N/A           N/A             Vivado tools 2017.3.1 v1.16
XCZU3EG         N/A          Vivado tools 2017.1 v1.10       N/A           N/A             Vivado tools 2017.3.1 v1.16
XCZU3TCG        N/A         Vivado tools 2023.1.2 v1.04      N/A           N/A             Vivado tools 2023.1.2 v1.04
XCZU3TEG        N/A         Vivado tools 2023.1.2 v1.04      N/A           N/A             Vivado tools 2023.1.2 v1.04
XCZU4CG         N/A          Vivado tools 2017.4 v1.17       N/A           N/A             Vivado tools 2017.4.1 v1.18
XCZU4EG     Vivado tools     Vivado tools 2017.4 v1.17       N/A           N/A             Vivado tools 2017.4.1 v1.18
           2018.2.1 v1.21
XCZU4EV     Vivado tools     Vivado tools 2017.4 v1.17       N/A           N/A             Vivado tools 2017.4.1 v1.18
           2018.2.1 v1.21
XCZU5CG         N/A          Vivado tools 2017.4 v1.17       N/A           N/A             Vivado tools 2017.4.1 v1.18
XCZU5EG     Vivado tools     Vivado tools 2017.4 v1.17       N/A           N/A             Vivado tools 2017.4.1 v1.18
           2018.2.1 v1.21
XCZU5EV     Vivado tools     Vivado tools 2017.4 v1.17       N/A           N/A             Vivado tools 2017.4.1 v1.18
           2018.2.1 v1.21
XCZU6CG         N/A          Vivado tools 2017.1 v1.10       N/A           N/A             Vivado tools 2017.3.1 v1.16
XCZU6EG     Vivado tools     Vivado tools 2017.1 v1.10       N/A           N/A             Vivado tools 2017.3.1 v1.16
           2018.2.1 v1.21
XCZU7CG         N/A          Vivado tools 2017.4 v1.17       N/A           N/A             Vivado tools 2017.4.1 v1.18
XCZU7EG     Vivado tools     Vivado tools 2017.4 v1.17       N/A           N/A             Vivado tools 2017.4.1 v1.18
           2018.2.1 v1.21
XCZU7EV     Vivado tools     Vivado tools 2017.4 v1.17       N/A           N/A             Vivado tools 2017.4.1 v1.18
           2018.2.1 v1.21
XCZU9CG         N/A          Vivado tools 2017.1 v1.10       N/A           N/A             Vivado tools 2017.3.1 v1.16
XCZU9EG     Vivado tools     Vivado tools 2017.1 v1.10       N/A           N/A             Vivado tools 2017.3.1 v1.16
           2018.2.1 v1.21
XCZU11EG    Vivado tools     Vivado tools 2017.3 v1.15       N/A           N/A             Vivado tools 2017.4.1 v1.18
            2018.1 v1.19
XCZU15EG    Vivado tools     Vivado tools 2017.2 v1.12       N/A           N/A             Vivado tools 2017.3.1 v1.16
            2018.1 v1.19
XCZU17EG    Vivado tools    Vivado tools 2017.2.1 v1.13      N/A           N/A              Vivado tools 2017.4 v1.17
            2018.1 v1.19
XCZU19EG    Vivado tools    Vivado tools 2017.2.1 v1.13      N/A           N/A              Vivado tools 2017.4 v1.17
            2018.1 v1.19
XAZU1EG         N/A            N/A         Vivado tools 2022.1 v1.30       N/A      N/A        N/A         N/A          Vivado tools
                                                                                                                        2022.1 v1.30
XAZU2EG         N/A            N/A         Vivado tools 2017.3 v1.15       N/A      N/A        N/A         N/A       Vivado tools
                                                                                                                    2017.3.1 v1.16
XAZU3EG         N/A            N/A         Vivado tools 2017.3 v1.15       N/A      N/A        N/A         N/A       Vivado tools
                                                                                                                    2017.3.1 v1.16
XAZU3TEG        N/A            N/A        Vivado tools 2023.2.1 v1.06      N/A      N/A    Vivado tools    N/A       Vivado tools
                                                                                          2023.2.1 v1.06            2023.2.1 v1.06

DS925 (v1.30) July 9, 2026
                                                                                                     Send Feedback
Product Specification                                                                                                             29

                                                      Zynq UltraScale+ MPSoC Data Sheet: DC and AC Switching Characteristics

Table 27: Zynq UltraScale+ MPSoC Device Production Software and Speed Specification Release
(cont'd)

                                                  Speed Grade and VCCINT Operating Voltages1
  Device         0.90V                                                0.85V                                                        0.72V
                   -3             -2             -1             -1Q               -1M              -2L          -1L         -2L            -1L
XAZU4EV           N/A            N/A        Vivado tools    Vivado tools           N/A             N/A          N/A         N/A      Vivado tools
                                            2017.4 v1.17    2018.2 v1.20                                                            2017.4.1 v1.18
XAZU5EV           N/A            N/A        Vivado tools    Vivado tools           N/A             N/A          N/A         N/A      Vivado tools
                                            2017.4 v1.17    2018.2 v1.20                                                            2017.4.1 v1.18
XAZU7EV           N/A            N/A        Vivado tools   Vivado tools            N/A             N/A          N/A         N/A            N/A
                                           2020.1.1 v1.30 2020.1.1 v1.30
XAZU11EG          N/A            N/A        Vivado tools   Vivado tools            N/A             N/A          N/A         N/A            N/A
                                           2020.1.1 v1.30 2020.1.1 v1.30
XQZU3EG           N/A         Vivado tools 2018.3 v1.23         N/A            Vivado tools        N/A     Vivado tools     N/A     Vivado tools
                                                                               2018.3 v1.23                2018.3 v1.23             2018.3 v1.23
XQZU5EV           N/A         Vivado tools 2018.2.2 v1.22       N/A         Vivado tools           N/A      Vivado tools    N/A      Vivado tools
                                                                           2018.2.2 v1.22                  2018.2.2 v1.22           2018.2.2 v1.22
XQZU7EV           N/A         Vivado tools 2018.2.2 v1.22       N/A         Vivado tools           N/A      Vivado tools    N/A      Vivado tools
                                                                           2018.2.2 v1.22                  2018.2.2 v1.22           2018.2.2 v1.22
XQZU9EG           N/A         Vivado tools 2018.3 v1.23         N/A            Vivado tools        N/A     Vivado tools     N/A     Vivado tools
                                                                               2018.3 v1.23                2018.3 v1.23             2018.3 v1.23
XQZU11EG          N/A         Vivado tools 2018.3 v1.23         N/A            Vivado tools        N/A     Vivado tools     N/A     Vivado tools
                                                                               2018.3 v1.23                2018.3 v1.23             2018.3 v1.23
XQZU15EG          N/A         Vivado tools 2018.2.2 v1.22       N/A         Vivado tools           N/A      Vivado tools    N/A      Vivado tools
                                                                           2018.2.2 v1.22                  2018.2.2 v1.22           2018.2.2 v1.22
XQZU19EG          N/A         Vivado tools 2018.3 v1.23         N/A            Vivado tools        N/A     Vivado tools     N/A     Vivado tools
                                                                               2018.3 v1.23                2018.3 v1.23             2018.3 v1.23
Notes:
1.   See Table 3 for the complete list of operating voltages by speed grade.

Processor System (PS) Performance Characteristics
Table 28: Processor Performance

                                                                                                         Speed Grade
     Symbol                                Description                                                                                     Units
                                                                                              -3              -2             -1
FAPUMAX            Maximum APU clock frequency                                            1500               1333           1200            MHz
FRPUMAX            Maximum RPU clock frequency                                            600                533            500             MHz
FGPUMAX            Maximum GPU clock frequency                                            667                600            600             MHz

Table 29: Configuration and Security Unit Performance

                                                                                                         Speed Grade
     Symbol                                Description                                                                                     Units
                                                                                              -3              -2             -1
FCSUCIBMAX         Maximum CSU crypto interface block frequency                           400                400            400             MHz

DS925 (v1.30) July 9, 2026
                                                                                                                      Send Feedback
Product Specification                                                                                                                             30

                                              Zynq UltraScale+ MPSoC Data Sheet: DC and AC Switching Characteristics

Table 30: PS DDR Performance

                                                                                                   Speed Grade

                                                                                                  -3E                 -2I
  Memory                                                                                     -2E/-2LE          -1I/-1M/-1Q
                                Package                              DRAM Type                                                     Units
  Standard
                                                                                                  -1E             -1LI

                                                                                            Min     Max        Min      Max
DDR43          All FFV and FFR packages, FBVB900, SFVC784,   1-rank component               664         2400   1000         2400   Mb/s
               SFRC784, SFVD784, and SFVE784
                                                             1-rank DIMM1,                  664         2133   1000         2133   Mb/s
                                                             2-rank component w/dual-rank
                                                             package
                                                             2-rank DIMM1, 2,               664         1866   1000         1866   Mb/s
                                                             2-rank component w/single-
                                                             rank package
               SFVA6256                                      1-rank component               664         2133   1000         2133   Mb/s
                                                             1-rank DIMM1,                  664         1866   1000         1866   Mb/s
                                                             2-rank component w/dual-rank
                                                             package
                                                             2-rank DIMM1, 2,               664         1600   1000         1600   Mb/s
                                                             2-rank component w/single-
                                                             rank package
               SBVA484, UBVA494, and UBVA5306                1-rank component               664         1866   1000         1866   Mb/s
                                                             2-rank component w/dual-rank   664         1600   1000         1600   Mb/s
                                                             package
                                                             2-rank component w/single-     664         1333   1000         1333   Mb/s
                                                             rank package
LPDDR44        All FFV and FFR packages, FBVB900, SFVC784,   1-rank component5              664         2400   1000         2400   Mb/s
               SFRC784, SFVD784, and SFVE784
                                                             2-rank component w/dual-rank   664         2133   1000         2133   Mb/s
                                                             package5
               SFVA6256                                      1-rank component5              664         2133   1000         2133   Mb/s
                                                             2-rank component w/dual-rank   664         1866   1000         1866   Mb/s
                                                             package5
               SBVA484, UBVA494, and UBVA5306                1-rank component5              664         1866   1000         1866   Mb/s
                                                             2-rank component w/dual-rank   664         1600   1000         1600   Mb/s
                                                             package5

DS925 (v1.30) July 9, 2026
                                                                                                           Send Feedback
Product Specification                                                                                                                  31

                                              Zynq UltraScale+ MPSoC Data Sheet: DC and AC Switching Characteristics

Table 30: PS DDR Performance (cont'd)

                                                                                                   Speed Grade

                                                                                                  -3E                 -2I
  Memory                                                                                     -2E/-2LE          -1I/-1M/-1Q
                                Package                              DRAM Type                                                     Units
  Standard
                                                                                                  -1E             -1LI

                                                                                            Min     Max        Min      Max
DDR3           All FFV and FFR packages, FBVB900, SFVC784,   1-rank component               664         2133   1000         2133   Mb/s
               SFRC784, SFVD784, and SFVE784
                                                             1-rank DIMM1,                  664         1866   1000         1866   Mb/s
                                                             2-rank component w/dual-rank
                                                             package
                                                             2-rank DIMM1, 2,               664         1600   1000         1600   Mb/s
                                                             2-rank component w/single-
                                                             rank package
               SFVA6256                                      1-rank component               664         1866   1000         1866   Mb/s
                                                             1-rank DIMM1,                  664         1600   1000         1600   Mb/s
                                                             2-rank component w/dual-rank
                                                             package
                                                             2-rank DIMM1, 2,               664         1333   1000         1333   Mb/s
                                                             2-rank component w/single-
                                                             rank package
               SBVA484, UBVA494, and UBVA5306                1-rank component               664         1066   1000         1066   Mb/s
                                                             2-rank component w/dual-rank   664         1066   1000         1066   Mb/s
                                                             package
                                                             2-rank component w/single-     664         1066   1000         1066   Mb/s
                                                             rank package
DDR3L          All FFV and FFR packages, FBVB900, SFVC784,   1-rank component               664         1866   1000         1866   Mb/s
               SFRC784, SFVD784, and SFVE784
                                                             1-rank DIMM1,                  664         1600   1000         1600   Mb/s
                                                             2-rank component w/dual-rank
                                                             package
                                                             2-rank DIMM1, 2,               664         1333   1000         1333   Mb/s
                                                             2-rank component w/single-
                                                             rank package
               SFVA6256                                      1-rank component               664         1600   1000         1600   Mb/s
                                                             1-rank DIMM1,                  664         1333   1000         1333   Mb/s
                                                             2-rank component w/dual-rank
                                                             package
                                                             2-rank DIMM1, 2,               664         1066   1000         1066   Mb/s
                                                             2-rank component w/single-
                                                             rank package
               SBVA484, UBVA494, and UBVA5306                1-rank component               664         1066   1000         1066   Mb/s
                                                             2-rank component w/dual-rank   664         1066   1000         1066   Mb/s
                                                             package
                                                             2-rank component w/single-     664         1066   1000         1066   Mb/s
                                                             rank package

DS925 (v1.30) July 9, 2026
                                                                                                           Send Feedback
Product Specification                                                                                                                  32

                                                   Zynq UltraScale+ MPSoC Data Sheet: DC and AC Switching Characteristics

Table 30: PS DDR Performance (cont'd)

                                                                                                            Speed Grade

                                                                                                          -3E                   -2I
     Memory                                                                                          -2E/-2LE           -1I/-1M/-1Q
                                      Package                             DRAM Type                                                            Units
     Standard
                                                                                                          -1E               -1LI

                                                                                                   Min      Max          Min      Max
LPDDR38            All FFV and FFR packages, FBVB900, SFVC784,   1-rank component7                  664         1600     1000         1600     Mb/s
                   SFRC784, SFVD784, and SFVE784
                                                                 2-rank component w/dual-rank       664         1333     1000         1333     Mb/s
                                                                 package7
                   SFVA6256                                      1-rank component7                  664         1333     1000         1333     Mb/s
                                                                 2-rank component w/dual-rank       664         1066     1000         1066     Mb/s
                                                                 package7
                   SBVA484, UBVA494, and UBVA5306                1-rank component7                  664         1066     1000         1066     Mb/s
                                                                 2-rank component w/dual-rank       664         1066     1000         1066     Mb/s
                                                                 package7
Notes:
1.    Dual in-line memory module (DIMM) includes RDIMM, SODIMM, and UDIMM.
2.    Includes: 2-rank 1-slot.
3.    The JEDEC JESD79-4C standard for DDR4 SDRAM limits the maximum tCK to 1.6 ns. Because of this limitation, AMD recommends working
      with your DRAM vendor to verify support for data rates at or less than 1066 Mb/s.
4.    LPDDR4 support is only available as a 32-bit interface. Byte-mode LPDDR4 devices are not supported.
5.    LPDDR4 1-rank component with ECC is limited to the performance specified for the LPDDR4 2-rank component.
6.    In SBVA484, SFVA625, UBVA494, and UBVA530 packages, DDR4 support is only available as a 32-bit or 16-bit interface, and other memory
      support is available only as a 32-bit interface.
7.    64-bit LPDDR3 interface performance values are defined without ECC support.
8.    LPDDR3 quad-die package devices are not supported.

Table 31: PS NAND NV-DDR Synchronous Performance

                                                                          Speed Grade
     Memory Standard             Mode                -3                          -2                             -1                       Units
                                                    Max                        Max                          Max
NV-DDR1                           5                 200                         200                             200                          Mb/s
                                  4                 166.6                      166.6                        166.6                            Mb/s
                                  3                 133.3                      133.3                        133.3                            Mb/s
                                  2                 100                         100                             100                          Mb/s
                                  1                 66.6                        66.6                        66.6                             Mb/s
                                  0                  40                          40                             40                           Mb/s
Notes:
1.    The PS NAND memory controller interface for NV-DDR switching characteristics meets the requirements of the ONFI 3.1 specification.

DS925 (v1.30) July 9, 2026
                                                                                                                      Send Feedback
Product Specification                                                                                                                               33

                                                   Zynq UltraScale+ MPSoC Data Sheet: DC and AC Switching Characteristics

Table 32: PS NAND SDR Asynchronous Performance

                                                                           Speed Grade
     Memory Standard           Mode                   -3                          -2                            -1                 Units
                                                    Max                         Max                         Max
SDR1, 2                           5                   50                          50                            50                   Mb/s
                                  4                   40                          40                            40                   Mb/s
                                  3                  33.3                        33.3                        33.3                    Mb/s
                                  2                  28.5                        28.5                        28.5                    Mb/s
                                  1                   20                          20                            20                   Mb/s
                                  0                   10                          10                            10                   Mb/s
Notes:
1.    The PS NAND memory controller interface for SDR switching characteristics meets the requirements of the ONFI 3.1 specification.
2.    The NAND controller reference clock frequency maximum is 83 MHz.

Table 33: PS-PL Interface Performance

          Symbol                                       Description                                        Min              Max        Units
FEMIOGEMCLK              EMIO gigabit Ethernet controller maximum frequency                                 –              125          MHz
FEMIOSDCLK               EMIO SD controller maximum frequency                                               –               25          MHz
FEMIOSPICLK              EMIO SPI controller maximum frequency                                              –               25          MHz
FEMIOTRACECLK            EMIO trace controller maximum frequency                                            –              125          MHz
FFCIDMACLK               Flow control interface DMA maximum frequency                                       –              333          MHz
FAXICLK                  Maximum AXI interface performance                                                  –              333          MHz
FDPLIVEVIDEO             DisplayPort controller live video interface maximum frequency                      –              300          MHz

PS Switching Characteristics
PS Clocks
Table 34: PS Reference Clock Requirements

          Symbol                               Description1                               Min              Typ             Max          Units
TRMSJPSCLK               PS_REF_CLK input RMS clock jitter                                  –               –                3              ps
TPJPSCLK                 PS_REF_CLK input period jitter (peak-to-peak)                      –               –               50              ps
                         Number of clock cycles = 10,000
TDCPSCLK                 PS_REF_CLK duty cycle                                              45              –               55              %
TRFPSCLK                 PS_REF_CLK rise time (20%–80%) and fall time (80%–20%)             –               –               2.22            ns
FPSCLK                   PS_REF_CLK frequency                                               27              –               60          MHz
Notes:
1.    The values in this table are applicable to alternative PS reference clock inputs ALT_REF_CLK, AUX_REF_CLK, and VIDEO_CLK.

DS925 (v1.30) July 9, 2026
                                                                                                                     Send Feedback
Product Specification                                                                                                                            34

                                                        Zynq UltraScale+ MPSoC Data Sheet: DC and AC Switching Characteristics

Table 35: PS RTC Crystal Requirements

          Symbol                                  Description1                                 Min                  Typ           Max        Units
FXTAL                       Parallel resonance crystal frequency                                   –                32.8            –          KHz
TFTXTAL                     Frequency tolerance                                                –20                   –             20         ppm
CXTAL                       Load capacitance for crystal parallel resonance                        –                12.5            –          pF
RESR                        Crystal ESR (16.8 and 19.2 MHz)                                        –                70              –          KΩ
CSHUNT                      Crystal shunt capacitance                                              –                1.4             –          pF
Notes:
1.      See the crystal circuit example in the Zynq UltraScale+ Device Technical Reference Manual (UG1085).

Table 36: PS PLL Switching Characteristics

                                                                                                       Speed Grade
          Symbol                              Description                                                                                     Units
                                                                                        -3                    -2                   -1
TLOCKPSPLL                  PLL maximum lock time                                      100                    100                 100           µs
FPSPLLMAX                   PLL maximum output frequency                               1600               1600                    1600         MHz
FPSPLLMIN                   PLL minimum output frequency                               750                    750                 750          MHz
FPSPLLVCOMAX                PLL maximum VCO frequency                                  3000               3000                    3000         MHz
FPSPLLVCOMIN                PLL minimum VCO frequency                                  1500               1500                    1500         MHz

Table 37: PS Reset Assertion Timing Requirements

          Symbol                            Description                         Min           Typ         Max                      Units
TPSPOR                      Required PS_POR_B assertion time1                    10            –              –                         µs
TPSRST                      Required PS_SRST_B assertion time                     3            –              –            PS_REF_CLK Clock Cycles
Notes:
1.      PS_POR_B must be asserted Low at power-up and continue to be asserted for a duration of TPSPOR after all the PS supply voltages reach
        minimum levels. PS_POR_B must be asserted Low for the duration of TPOR,MAX when the PS and PL power-up at the same time and the
        application uses both the PS and PL after power-up.

DS925 (v1.30) July 9, 2026
                                                                                                                           Send Feedback
Product Specification                                                                                                                                35

                                                    Zynq UltraScale+ MPSoC Data Sheet: DC and AC Switching Characteristics

Table 38: PS Clocks Switching Characteristics

                                                                                                       Speed Grade
       Symbol                             Description                                                                                             Units
                                                                                      -3                         -2                  -1
FTOPSW_MAINMAX         FPD AXI interconnect clock maximum frequency                   600                     533                  533             MHz
FTOPSW_LSBUSMAX        FPD APB bus clock maximum frequency                            100                     100                  100             MHz
FGDMAMAX               FPD-DMA controller clock maximum frequency                     600                     600                  600             MHz
FDPDMAMAX              DisplayPort controller clock maximum frequency                 600                     600                  600             MHz
FLPD_SWITCH_CTRLMAX    LPD AXI interconnect clock maximum frequency                   600                     500                  500             MHz
FLPD_LSBUS_CTRLMAX     LPD APB bus clock maximum frequency                            100                     100                  100             MHz
FADMAMAX               LPD-DMA maximum frequency                                      600                     500                  500             MHz
FAPLL_TO_LPDMAX        APLL_TO_LPD maximum frequency                                  533                     533                  533             MHz
FDPLL_TO_LPDMAX        DPLL_TO_LPD maximum frequency                                  533                     533                  533             MHz
FVPLL_TO_LPDMAX        VPLL_TO_LPD maximum frequency                                  533                     533                  533             MHz
FIOPLL_TO_FPDMAX       IOPLL_TO_FPD maximum frequency                                 533                     533                  533             MHz
FRPLL_TO_FPDMAX        RPLL_TO_FPD maximum frequency                                  533                     533                  533             MHz

PS Configuration
Table 39: Processor Configuration Access Port Switching Characteristics

                                                                             Speed Grade and VCCINT Operating Voltages
 Symbol                              Description                             0.90V                    0.85V                     0.72V             Units
                                                                               -3              -2             -1          -2              -1
FPCAPCK       Maximum processor configuration access port (PCAP)               200            200             200        150              150      MHz
              frequency

Table 40: Boundary-Scan Port Switching Characteristics

                                                                           Speed Grade and VCCINT Operating Voltages
       Symbol                            Description                        0.90V                   0.85V                    0.72V              Units
                                                                              -3              -2            -1          -2           -1
FTCK                   JTAG clock maximum frequency                           25              25            25          15           15          MHz
TTAPTCK/TTCKTAP        TMS and TDI setup and hold                           4.0/2.0         4.0/2.0      4.0/2.0      5.0/2.0     5.0/2.0       ns, Min
TTCKTDO                TCK falling edge to TDO output                        16.1            16.1           16.1        24           24         ns, Max
Notes:
1.     The test conditions are configured to the LVCMOS 3.3V I/O standard with a 12 mA drive strength.

DS925 (v1.30) July 9, 2026
                                                                                                                        Send Feedback
Product Specification                                                                                                                                     36

                                                     Zynq UltraScale+ MPSoC Data Sheet: DC and AC Switching Characteristics

PS Interface Specifications
PS Quad-SPI Controller Interface
Table 41: Generic Quad-SPI Interface

   Symbol                                Description1                         Load Conditions2       Min     Max     Units
Quad-SPI device clock frequency operating at 150 MHz. Loopback enabled.3 LVCMOS 1.8V or LVCMOS 3.3V I/O standard.
TDCQSPICLK1     Quad-SPI clock duty cycle                                           15 pF             45       55     %
TQSPISSSCLK1    Slave select asserted to next clock edge                            15 pF            5.0       –      ns
TQSPISCLKSS1    Clock edge to slave select deasserted                               15 pF            5.0       –      ns
TQSPICKO1       Clock to output delay, all outputs                                  15 pF            2.9      4.5     ns
TQSPIDCK1       Setup time, all inputs                                              15 pF            0.9       –      ns
TQSPICKD1       Hold time, all inputs                                               15 pF            1.0       –      ns
FQSPICLK1       Quad-SPI device clock frequency                                     15 pF             –       150    MHz
FQSPIREFCLK1    Quad-SPI reference clock frequency                                  15 pF             –       300    MHz
Quad-SPI device clock frequency operating at 100 MHz. Loopback enabled.3 LVCMOS 1.8V or LVCMOS 3.3V I/O standard.
TDCQSPICLK2     Quad-SPI clock duty cycle                                           15 pF             45       55     %
                                                                                    30 pF             45       55     %
TQSPISSSCLK2    Slave select asserted to next clock edge                            15 pF            5.0       –      ns
                                                                                    30 pF            5.0       –      ns
TQSPISCLKSS2    Clock edge to slave select deasserted                               15 pF            5.0       –      ns
                                                                                    30 pF            5.0       –      ns
TQSPICKO2       Clock to output delay, all outputs                                  15 pF            3.2      7.4     ns
                                                                                    30 pF            3.2      7.4     ns
TQSPIDCK2       Setup time, all inputs                                              15 pF            2.3       –      ns
                                                                                    30 pF            2.3       –      ns
TQSPICKD2       Hold time, all inputs                                               15 pF            0.0       –      ns
                                                                                    30 pF            0.0       –      ns
FQSPICLK2       Quad-SPI device clock frequency                                     15 pF             –       100    MHz
                                                                                    30 pF             –       100    MHz
FQSPIREFCLK2    Quad-SPI reference clock frequency                                  15 pF             –       200    MHz
                                                                                    30 pF             –       200    MHz
Quad-SPI device clock frequency operating at 40 MHz. Loopback disabled. LVCMOS 1.8V I/O standard.
TDCQSPICLK3     Quad-SPI clock duty cycle                                           15 pF             45       55     %
                                                                                    30 pF             45       55     %
TQSPISSSCLK3    Slave select asserted to next clock edge4                           15 pF            7.0       –      ns
                                                                                    30 pF            7.0       –      ns
TQSPISCLKSS3    Clock edge to slave select deasserted                               15 pF            7.0       –      ns
                                                                                    30 pF            7.0       –      ns
TQSPICKO35      Clock to output delay, all outputs                                  15 pF            5.2      14.8    ns
                                                                                    30 pF            5.2      14.8    ns
TQSPIDCK3       Setup time, all inputs                                              15 pF            13.4      –      ns
                                                                                    30 pF            14.1      –      ns

DS925 (v1.30) July 9, 2026
                                                                                                     Send Feedback
Product Specification                                                                                                        37

                                                        Zynq UltraScale+ MPSoC Data Sheet: DC and AC Switching Characteristics

Table 41: Generic Quad-SPI Interface (cont'd)

     Symbol                                 Description1                               Load Conditions2             Min       Max        Units
TQSPICKD3          Hold time, all inputs                                                       15 pF                 0.0        –             ns
                                                                                               30 pF                 0.0        –             ns
FQSPIREFCLK3       Quad-SPI reference clock frequency                                          15 pF                  –        160        MHz
                                                                                               30 pF                  –        160        MHz
FQSPICLK3          Quad-SPI clock frequency                                                    15 pF                  –        40         MHz
                                                                                               30 pF                  –        40         MHz
Quad-SPI device clock frequency operating at 40 MHz. Loopback disabled. LVCMOS 3.3V I/O standard.
TDCQSPICLK4        Quad-SPI clock duty cycle                                                   15 pF                 45        55             %
                                                                                               30 pF                 45        55             %
TQSPISSSCLK4       Slave select asserted to next clock edge4                                   15 pF                 7.0        –             ns
                                                                                               30 pF                 7.0        –             ns
TQSPISCLKSS4       Clock edge to slave select deasserted                                       15 pF                 7.0        –             ns
                                                                                               30 pF                 7.0        –             ns
TQSPICKO45         Clock to output delay, all outputs                                          15 pF                 5.2      14.8            ns
                                                                                               30 pF                 5.2      14.8            ns
TQSPIDCK4          Setup time, all inputs                                                      15 pF                13.9        –             ns
                                                                                               30 pF                14.9        –             ns
TQSPICKD4          Hold time, all inputs                                                       15 pF                 0.0        –             ns
                                                                                               30 pF                 0.0        –             ns
FQSPIREFCLK4       Quad-SPI reference clock frequency                                          15 pF                  –        160        MHz
                                                                                               30 pF                  –        160        MHz
FQSPICLK4          Quad-SPI clock frequency                                                    15 pF                  –        40         MHz
                                                                                               30 pF                  –        40         MHz
Notes:
1.    The test conditions are configured for the generic Quad-SPI interface at 150/100 MHz with a 12 mA drive strength and fast slew rate.
2.    30 pF loads are for dual-parallel stacked or stacked modes.
3.    When the Quad-SPI clock frequency is greater than 40 MHz, the Quad-SPI feedback clock (MIO[6]) must be enabled in the processing
      system configuration wizard (PCW), and the associated MIO[6] (clk_for_lpbk) pin must be left unconnected on the board.
4.    TQSPISSSCLK3 and TQSPISSSCLK4 are only valid when two reference clock cycles are programmed between the chip select and clock.
5.    TQSPICKO is verified at 40 MHz. It varies with Quad-SPI clock frequency and can be greater than the specification at low frequencies.

Table 42: Linear Quad-SPI Interface

     Symbol                                 Description1                               Load Conditions2             Min       Max        Units
Quad-SPI device clock frequency operating at 100 MHz. Loopback enabled.3 LVCMOS 1.8V or LVCMOS 3.3V I/O standard.
TDCQSPICLK5        Quad-SPI clock duty cycle                                                   15 pF                 45        55             %
                                                                                               30 pF                 45        55             %
TQSPISSSCLK5       Slave select asserted to next clock edge4                                   15 pF                 5.0        –             ns
                                                                                               30 pF                 5.0        –             ns
TQSPISCLKSS5       Clock edge to slave select deasserted                                       15 pF                 5.0        –             ns
                                                                                               30 pF                 5.0        –             ns
TQSPICKO5          Clock to output delay, all outputs                                          15 pF                 3.2       7.4            ns
                                                                                               30 pF                 3.2       7.4            ns

DS925 (v1.30) July 9, 2026
                                                                                                                    Send Feedback
Product Specification                                                                                                                              38

                                                     Zynq UltraScale+ MPSoC Data Sheet: DC and AC Switching Characteristics

Table 42: Linear Quad-SPI Interface (cont'd)

   Symbol                                Description1                         Load Conditions2      Min    Max      Units
TQSPIDCK5       Setup time, all inputs                                              15 pF           2.4      –       ns
                                                                                    30 pF           2.4      –       ns
TQSPICKD5       Hold time, all inputs                                               15 pF           0.0      –       ns
                                                                                    30 pF           0.0      –       ns
FQSPIREFCLK5    Quad-SPI reference clock frequency                                  15 pF            –      200     MHz
                                                                                    30 pF            –      200     MHz
FQSPICLK5       Quad-SPI device clock frequency                                     15 pF            –      100     MHz
                                                                                    30 pF            –      100     MHz
Quad-SPI device clock frequency operating at 40 MHz. Loopback disabled. LVCMOS 1.8V I/O standard.
TDCQSPICLK6     Quad-SPI clock duty cycle                                           15 pF           45      55       %
                                                                                    30 pF           45      55       %
TQSPISSSCLK6    Slave select asserted to next clock edge                            15 pF           7.0      –       ns
                                                                                    30 pF           7.0      –       ns
TQSPISCLKSS6    Clock edge to slave select deasserted                               15 pF           7.0      –       ns
                                                                                    30 pF           7.0      –       ns
TQSPICKO6       Clock to output delay, all outputs                                  15 pF           5.2    14.8      ns
                                                                                    30 pF           5.2    14.8      ns
TQSPIDCK6       Setup time, all inputs                                              15 pF           13.4     –       ns
                                                                                    30 pF           13.4     –       ns
TQSPICKD6       Hold time, all inputs                                               15 pF           0.0      –       ns
                                                                                    30 pF           0.0      –       ns
FQSPIREFCLK6    Quad-SPI reference clock frequency                                  15 pF            –      160     MHz
                                                                                    30 pF            –      160     MHz
FQSPICLK6       Quad-SPI device clock frequency                                     15 pF            –      40      MHz
                                                                                    30 pF            –      40      MHz
Quad-SPI device clock frequency operating at 40 MHz. Loopback disabled. LVCMOS 3.3V I/O standard.
TDCQSPICLK7     Quad-SPI clock duty cycle                                           15 pF           45      55       %
                                                                                    30 pF           45      55       %
TQSPISSSCLK7    Slave select asserted to next clock edge                            15 pF           7.0      –       ns
                                                                                    30 pF           7.0      –       ns
TQSPISCLKSS7    Clock edge to slave select deasserted                               15 pF           7.0      –       ns
                                                                                    30 pF           7.0      –       ns
TQSPICKO7       Clock to output delay, all outputs                                  15 pF           5.2    14.8      ns
                                                                                    30 pF           5.2    14.8      ns
TQSPIDCK7       Setup time, all inputs                                              15 pF           14.0     –       ns
                                                                                    30 pF           14.0     –       ns
TQSPICKD7       Hold time, all inputs                                               15 pF           0.0      –       ns
                                                                                    30 pF           0.0      –       ns
FQSPIREFCLK7    Quad-SPI reference clock frequency                                  15 pF            –      160     MHz
                                                                                    30 pF            –      160     MHz

DS925 (v1.30) July 9, 2026
                                                                                                    Send Feedback
Product Specification                                                                                                       39

                                                     Zynq UltraScale+ MPSoC Data Sheet: DC and AC Switching Characteristics

Table 42: Linear Quad-SPI Interface (cont'd)

     Symbol                                Description1                               Load Conditions2            Min       Max         Units
FQSPICLK7          Quad-SPI device clock frequency                                            15 pF                 –         40          MHz
                                                                                              30 pF                 –         40          MHz
Notes:
1.    The test conditions are configured for the linear Quad-SPI interface at 100 MHz with a 12 mA drive strength and fast slew rate.
2.    30 pF loads are for stacked modes.
3.    When the Quad-SPI clock frequency is greater than 40 MHz, the Quad-SPI feedback clock (MIO[6]) must be enabled in the processing
      system configuration wizard (PCW), and the associated MIO[6] (clk_for_lpbk) pin must be left unconnected on the board.
4.    TQSPISSSCLK5 is only valid when two reference clock cycles are programmed between chip select and clock.

PS USB Interface
Table 43: ULPI Interface

     Symbol                                   Description1                                    Min                 Max               Units
TULPIDCK            Input setup to ULPI clock, all inputs                                      4.5                  –                   ns
TULPICKD            Input hold to ULPI clock, all inputs                                        0                   –                   ns
TULPICKO            ULPI clock to output valid, all outputs                                    2.0                 8.86                 ns
FULPICLK            ULPI reference clock frequency                                              –                   60                  MHz
Notes:
1.    The test conditions are configured to the LVCMOS 3.3V I/O standard with a 12 mA drive strength, fast slew rate, and a 15 pF load.

PS Gigabit Ethernet Controller Interface
Table 44: RGMII Interface

     Symbol                                     Description1                                   Min                Max               Units
TDCGEMTXCLK         Transmit clock duty cycle                                                   45                  55                  %
TGEMTXCKO           TXD output clock to out time                                               –0.5                0.5                  ns
TGEMRXDCK           RXD input setup time                                                       0.8                  –                   ns
TGEMRXCKD           RXD input hold time                                                        0.8                  –                   ns
TMDIOCLK            MDC output clock period                                                    400                  –                   ns
TMDIOCKL            MDC low time                                                               160                  –                   ns
TMDIOCKH            MDC high time                                                              160                  –                   ns
TMDIODCK            MDIO input data setup time                                                  80                  –                   ns
TMDIOCKD            MDIO input data hold time                                                  0.0                  –                   ns
TMDIOCKO            MDIO output data delay time                                                –1.0                 15                  ns
FGETXCLK            RGMII_TX_CLK transmit clock frequency                                       –                  125                  MHz
FGERXCLK            RGMII_RX_CLK receive clock frequency                                        –                  125                  MHz
FENET_REF_CLK       Ethernet reference clock frequency                                          –                  125                  MHz
Notes:
1.    The test conditions are configured to the LVCMOS 2.5V I/O standard with a 12 mA drive strength, fast slew rate, and a 15 pF load.

DS925 (v1.30) July 9, 2026
                                                                                                                  Send Feedback
Product Specification                                                                                                                           40

                                                   Zynq UltraScale+ MPSoC Data Sheet: DC and AC Switching Characteristics

PS SD/SDIO Controller Interface
Table 45: SD/SDIO Interface

      Symbol                                 Description1                            Min            Max           Units
SD/SDIO Interface DDR50 Mode
TDCDDRCLK           SD device clock duty cycle                                        45             55            %
TSDDDRCKO1          Clock to output delay, data2                                      1.0            6.8           ns
TSDDDRIVW           Input valid data window3                                          3.5             –            ns
TSDDDRDCK2          Input setup time, command                                         4.7             –            ns
TSDDDRCKD2          Input hold time, command                                          1.5             –            ns
TSDDDRCKO2          Clock to output delay, command                                    1.0            13.8          ns
FSDDDRCLK           High-speed mode SD device clock frequency                          –             50           MHz
SD/SDIO Interface SDR104
TDCSDHSCLK1         SD device clock duty cycle                                        40             60            %
TSDSDRCKO1          Clock to output delay, all output2                                1.0            3.2           ns
TSDSDR1IVW          Input valid data window3                                          0.5             –            UI
FSDSDRCLK1          SDR104 mode device clock frequency                                 –             200          MHz
SD/SDIO Interface SDR50/25
TDCSDHSCLK2         SD device clock duty cycle                                        40             60            %
TSDSDRCKO2          Clock to output delay, all outputs2                               1.0            6.8           ns
TSDSDR2IVW          Input valid data window3                                          0.3             –            UI
FSDSDRCLK2          SDR50 mode device clock frequency                                  –             100          MHz
                    SDR25 mode device clock frequency                                  –             50           MHz
SD/SDIO Interface SDR12
TDCSDHSCLK3         SD device clock duty cycle                                        40             60            %
TSDSDRCKO3          Clock to output delay, all outputs                                1.0           36.8           ns
TSDSDRDCK3          Input setup time, all inputs                                      10.0            –            ns
TSDSDRCKD3          Input hold time, all inputs                                       1.5             –            ns
FSDSDRCLK3          SDR12 mode device clock frequency                                  –             25           MHz
SD/SDIO Interface High-Speed Mode
TDCSDHSCLK          SD device clock duty cycle                                        47             53            %
TSDHSCKO            Clock to output delay, all outputs2                               2.2           13.8           ns
TSDHSDIVW           Input valid data window3                                          0.35            –            UI
FSDHSCLK            High-speed mode SD device clock frequency                          –             50           MHz
SD/SDIO Interface Standard Mode
TDCSDSCLK           SD device clock duty cycle                                        45             55            %
TSDSCKO             Clock to output delay, all outputs                                –2.0           4.5           ns
TSDSDCK             Input setup time, all inputs                                      2.0             –            ns
TSDSCKD             Input hold time, all inputs                                       2.0             –            ns
FSDIDCLK            Clock frequency in identification mode                             –             400           KHz

DS925 (v1.30) July 9, 2026
                                                                                                  Send Feedback
Product Specification                                                                                                     41

                                                      Zynq UltraScale+ MPSoC Data Sheet: DC and AC Switching Characteristics

Table 45: SD/SDIO Interface (cont'd)

      Symbol                                     Description1                                   Min                 Max             Units
FSDSCLK                Standard SD device clock frequency                                         –                  19              MHz
Notes:
1.   The test conditions SD/SDIO standard mode (default speed mode) use an 8 mA drive strength, fast slew rate, and a 30 pF load. For
     SD/SDIO high-speed mode, the test conditions use a 12 mA drive strength, fast slew rate, and a 30 pF load. For other SD/SDIO modes,
     the test conditions use a 12 mA drive strength, fast slew rate, and a 15 pF load.
2.   This specification is achieved using pre-determined DLL tuning.
3.   This specification is required for capturing input data using DLL tuning.

PS eMMC Standard Interface
Table 46: eMMC Standard Interface

      Symbol                                     Description1                                   Min                 Max             Units
eMMC Standard Interface
TDCEMMCHSCLK           eMMC clock duty cycle                                                     45                  55                %
TEMMCHSCKO             Clock to output delay, all outputs                                        –2.0                4.5              ns
TEMMCHSDCK             Input setup time, all inputs                                              2.0                  –               ns
TEMMCHSCKD             Input hold time, all inputs                                               2.0                  –               ns
FEMMCHSCLK             eMMC clock frequency                                                       –                  25              MHz
eMMC High-Speed SDR Interface
TDCEMMCHSCLK           eMMC high-speed SDR clock duty cycle                                      45                  55                %
TEMMCHSCKO             Clock to output delay, all outputs2                                       3.2                16.8              ns
TEMMCHSDIVW            Input valid data window3                                                  0.4                  –               UI
FEMMCHSCLK             eMMC high speed SDR clock frequency                                        –                  50              MHz
eMMC High-Speed DDR Interface
TDCEMMCDDRCLK          eMMC high-speed DDR clock duty cycle                                      45                  55                %
TEMMCDDRSCKO1          Data clock to output delay2                                               2.7                 7.3              ns
TEMMCDDRIVW            Input valid data window3                                                  3.5                  –               ns
TEMMCDDRSCKO2          Command clock to output delay                                             3.2                 16               ns
TEMMCDDRDCK2           Command input setup time                                                  3.9                  –               ns
TEMMCDDRCKD2           Command input hold time                                                   2.5                  –               ns
FEMMCDDRCLK            eMMC high-speed DDR clock frequency                                        –                  50              MHz
eMMC HS200 Interface
TDCEMMCHS200CLK        eMMC HS200 clock duty cycle                                               40                  60                %
TEMMCHS200CKO          Clock to output delay, all outputs2                                       1.0                 3.4              ns
TEMMCSDR1IVW           Input valid data window3                                                  0.4                  –               UI
FEMMCHS200CLK          eMMC HS200 clock frequency                                                 –                  200             MHz
Notes:
1.   The test conditions for eMMC standard mode use an 8 mA drive strength, fast slew rate, and a 30 pF load. For eMMC high-speed mode,
     the test conditions use a 12 mA drive strength, fast slew rate, and a 30 pF load. For other eMMC modes, the test conditions use a 12 mA
     drive strength, fast slew rate, and a 15 pF load.
2.   This specification is achieved using pre-determined DLL tuning.
3.   This specification is required for capturing input data using DLL tuning.

DS925 (v1.30) July 9, 2026
                                                                                                                 Send Feedback
Product Specification                                                                                                                          42

                                                    Zynq UltraScale+ MPSoC Data Sheet: DC and AC Switching Characteristics

PS I2C Controller Interface
Table 47: I2C Interface

      Symbol                                     Description1                                    Min                Max                  Units
I2C Fast-mode Interface
TI2CFCKL               SCL Low time                                                              1.3                  –                   µs
TI2CFCKH               SCL High time                                                             0.6                  –                   µs
TI2CFCKO               SDA clock to out delay                                                     –                  900                  ns
TI2CFDCK               SDA input setup time                                                      100                  –                   ns
FI2CFCLK               SCL clock frequency                                                        –                  400                  KHz
I2C Standard-mode Interface
TI2CSCKL               SCL Low time                                                              4.7                  –                   µs
TI2CSCKH               SCL High time                                                             4.0                  –                   µs
TI2CSCKO               SDA clock to out delay                                                     –                  3450                 ns
TI2CSDCK               SDA input setup time                                                      250                  –                   ns
FI2CSCLK               SCL clock frequency                                                        –                  100                  KHz
Notes:
1.   The test conditions are configured to the LVCMOS 3.3V I/O standard with a 12 mA drive strength, fast slew rate, and a 15 pF load.

PS SPI Controller Interface
Table 48: SPI Interfaces

      Symbol                                    Description1                              Min              Max                   Units
SPI Master Interface
TDCMSPICLK             SPI master mode clock duty cycle                                    45                55                     %
TMSPISSSCLK            Slave select asserted to first active clock edge                    12                –              FSPI_REF_CLK cycles
TMSPISCLKSS            Last active clock edge to slave select deasserted                   12                –              FSPI_REF_CLK cycles
TMSPIDCK               Input setup time for MISO                                          –2.0               –                      ns
TMSPICKD               Input hold time for MISO                                            0.3               –               FMSPICLK cycles
TMSPICKO               MOSI and slave select clock to out delay                           –2.0              5.0                     ns
FMSPICLK               SPI master device clock frequency                                    –                50                   MHz
FSPI_REF_CLK           SPI reference clock frequency                                        –               200                   MHz
SPI Slave Interface
TSSPISSSCLK            Slave select asserted to first active clock edge                     2                –              FSPI_REF_CLK cycles
TSSPISCLKSS            Last active clock edge to slave select deasserted                    2                –              FSPI_REF_CLK cycles
TSSPIDCK               Input setup time for MOSI                                           5.0               –                      ns
TSSPICKD               Input hold time for MOSI                                             1                –              FSPI_REF_CLK cycles
TSSPICKO               MISO clock to out delay                                             0.0              13.0                    ns
FSSPICLK               SPI slave mode device clock frequency                                –                25                   MHz

DS925 (v1.30) July 9, 2026
                                                                                                                   Send Feedback
Product Specification                                                                                                                             43

                                                     Zynq UltraScale+ MPSoC Data Sheet: DC and AC Switching Characteristics

Table 48: SPI Interfaces (cont'd)

      Symbol                                  Description1                                Min              Max                 Units
FSPI_REF_CLK           SPI reference clock frequency                                        –               200                  MHz
Notes:
1.   The test conditions are configured to the LVCMOS 3.3V I/O standard with a 12 mA drive strength, fast slew rate, and a 30 pF load.
2.   Valid when two SPI_REF_CLK delays are programmed between CS and CLK for TMSPISSSCLK, and between CLK and CS for TMSPISCLKSS in the
     SPI delay_reg0 register.

PS CAN Controller Interface
Table 49: CAN Interface

      Symbol                                    Description1                                    Min            Max               Units
TPWCANRX               Receive pulse width                                                      1.0                –                µs
TPWCANTX               Transmit pulse width                                                     1.0                –                µs
FCAN_REF_CLK           Internally sourced CAN reference clock frequency                          –                100              MHz
                       Externally sourced CAN reference clock frequency                          –                40               MHz
Notes:
1.   The test conditions are configured to the LVCMOS 3.3V I/O standard with a 12 mA drive strength, fast slew rate, and a 15 pF load.

PS DAP Interface
Table 50: DAP Interface

      Symbol                                  Description1, 2                                   Min            Max               Units
TPDAPDCK               PS DAP input setup time                                                  3.0                –                ns
TPDAPCKD               PS DAP input hold time                                                   2.0                –                ns
TPDAPCKO               PS DAP clock to out delay                                                 –             10.86                ns
FPDAPCLK               PS DAP clock frequency                                                    –                44               MHz
Notes:
1.   The test conditions are configured to the LVCMOS 3.3V I/O standard with a 12 mA drive strength, fast slew rate, and a 15 pF load.
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
