fingoldin/lpddr5-testbed/fab/verify/gerber_B_Cu.png

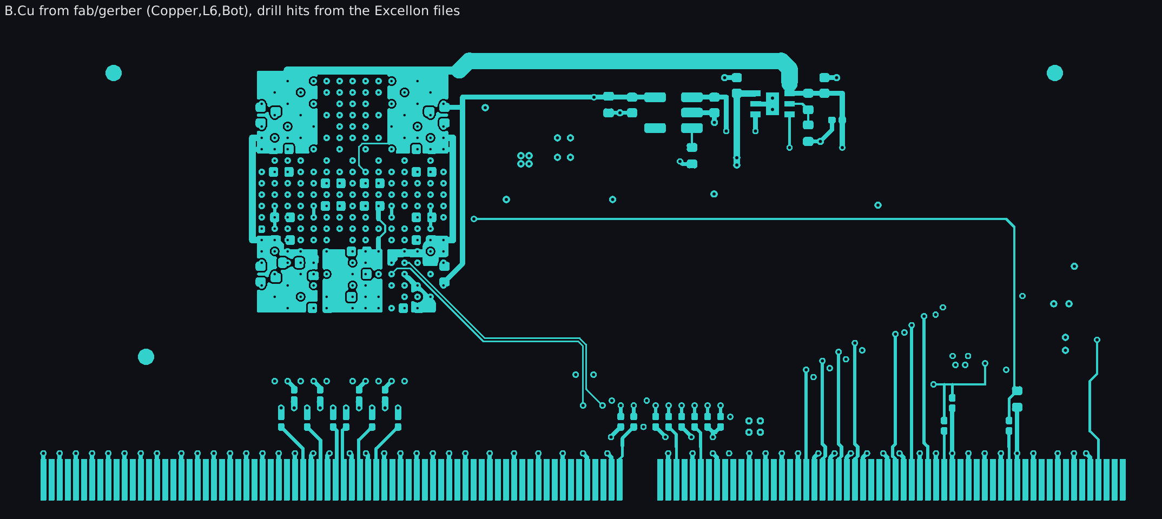
fab/verify/gerber_B_Cu.png
