fingoldin/lpddr5-testbed/fab/verify/gerber_B_Mask.png

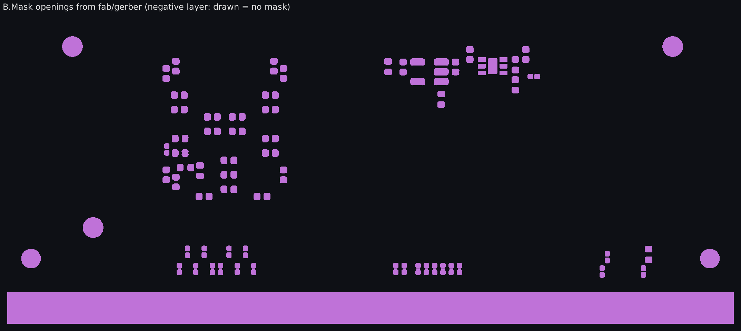
fab/verify/gerber_B_Mask.png
