fingoldin/lpddr5-testbed/fab/verify/gerber_B_Paste.png

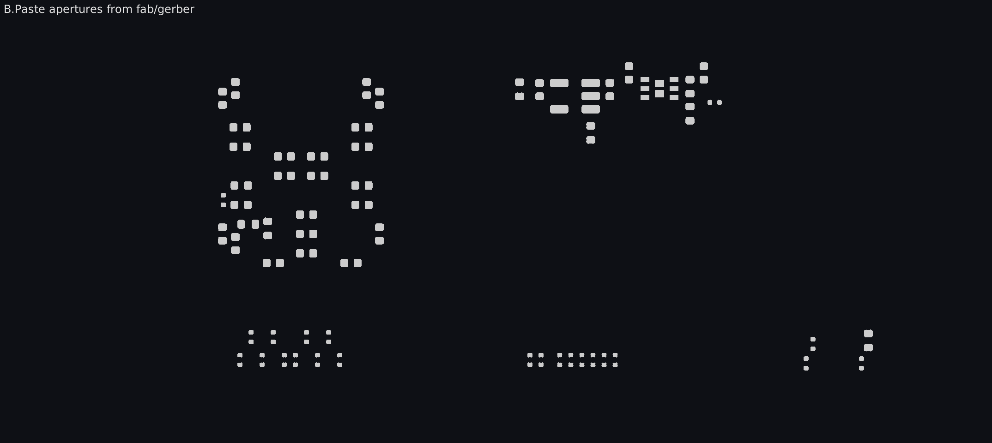
fab/verify/gerber_B_Paste.png
