fingoldin/lpddr5-testbed/fab/verify/gerber_B_Silkscreen.png

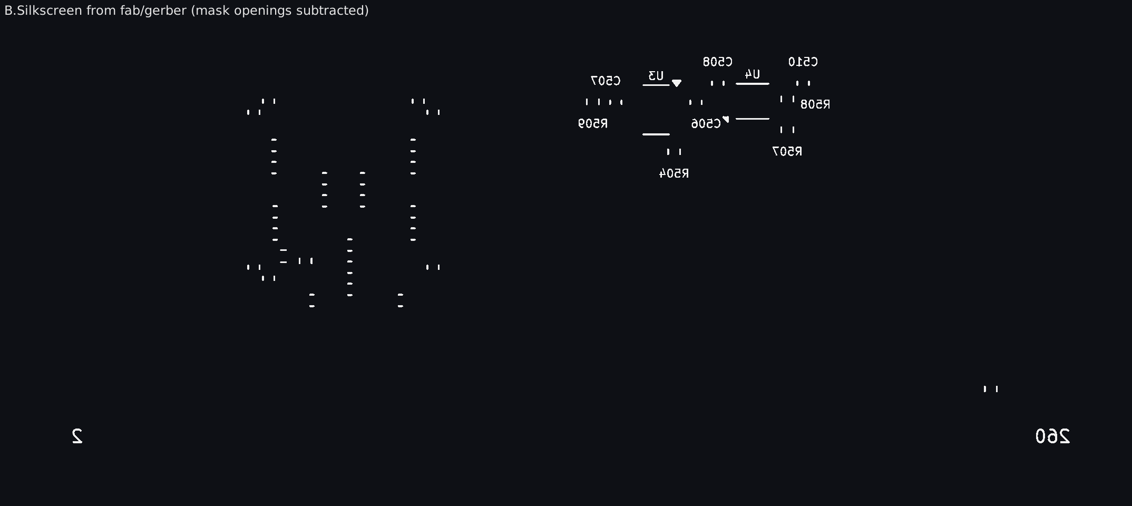
fab/verify/gerber_B_Silkscreen.png
