fingoldin/lpddr5-testbed/fab/verify/gerber_Edge_Cuts.png

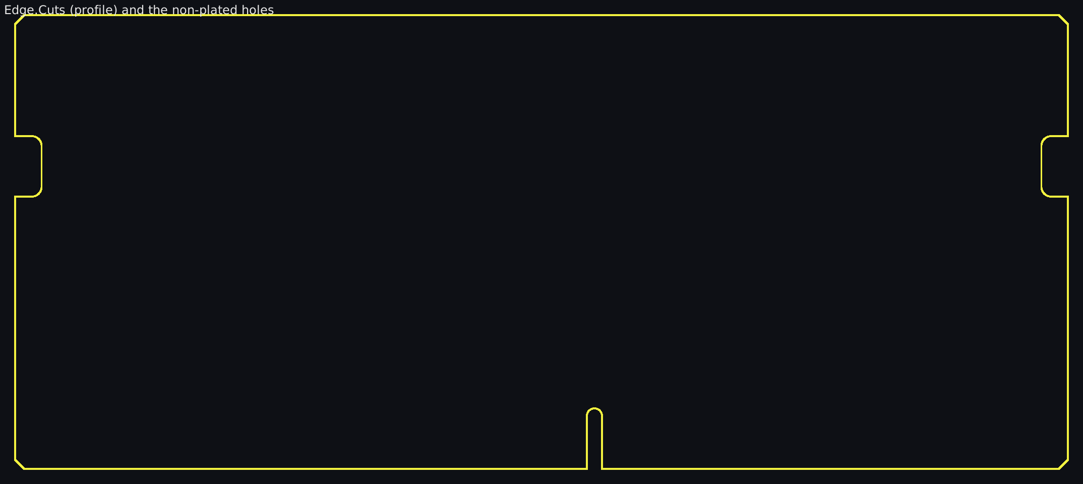
fab/verify/gerber_Edge_Cuts.png
