fingoldin/lpddr5-testbed/fab/verify/gerber_F_Cu.png

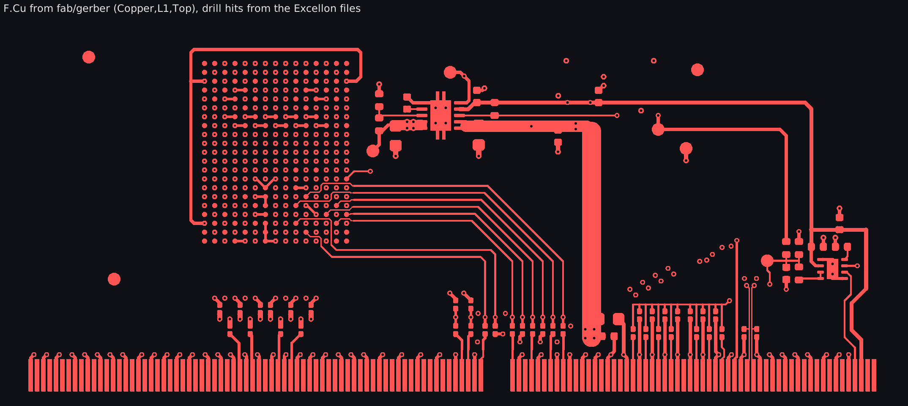
fab/verify/gerber_F_Cu.png
