fingoldin/lpddr5-testbed/fab/verify/gerber_F_Mask.png

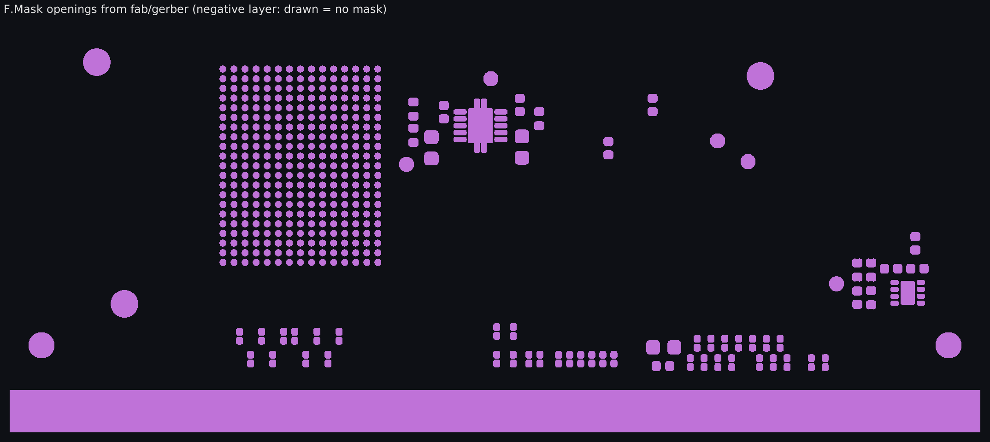
fab/verify/gerber_F_Mask.png
