fingoldin/lpddr5-testbed/fab/verify/gerber_F_Paste.png

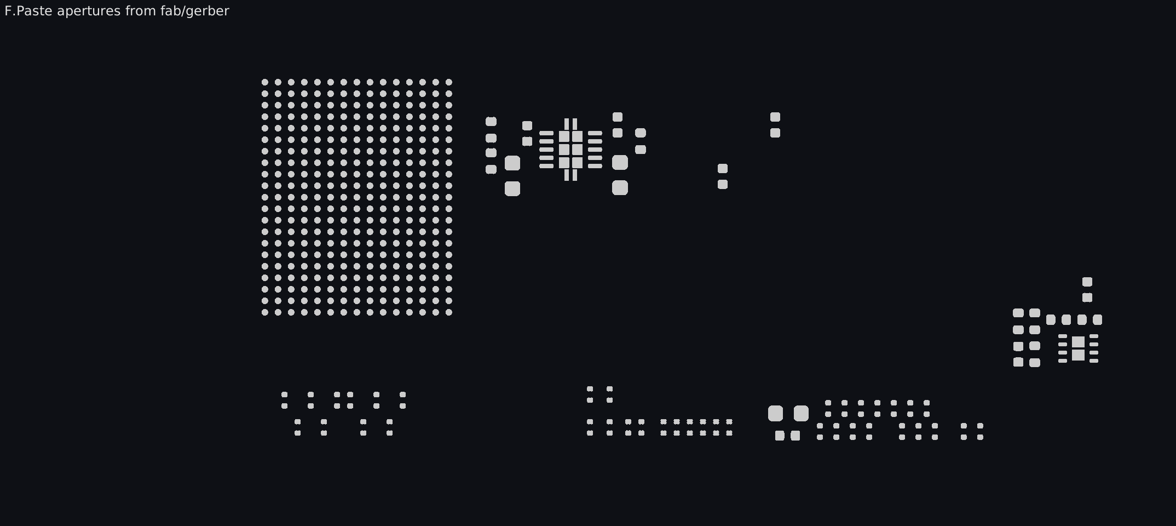
fab/verify/gerber_F_Paste.png
