fingoldin/lpddr5-testbed/fab/verify/gerber_F_Silkscreen.png

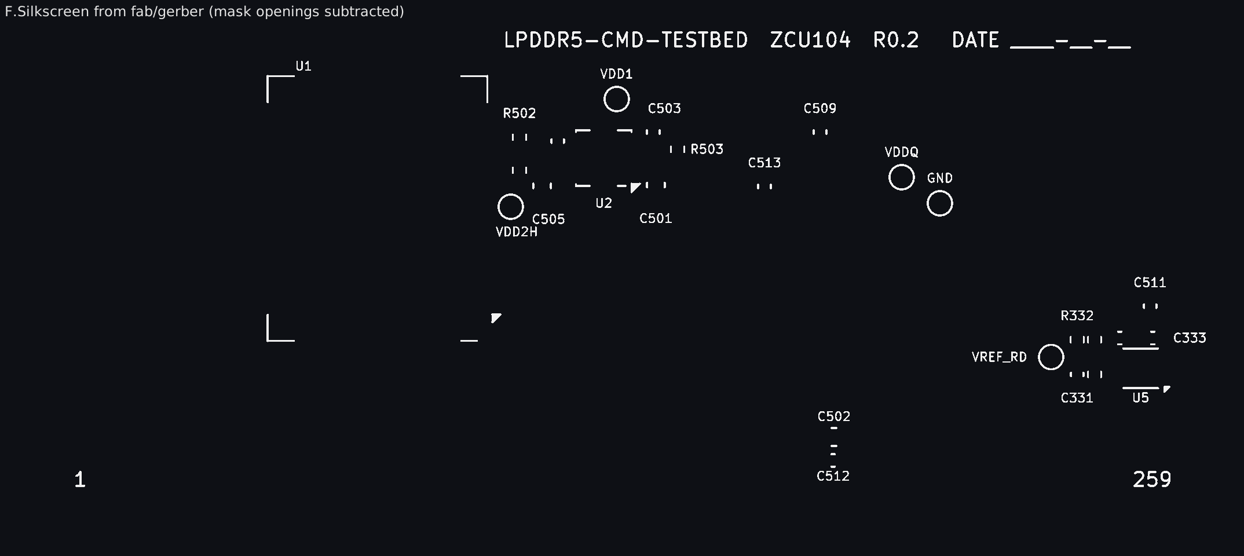
fab/verify/gerber_F_Silkscreen.png
