fingoldin/lpddr5-testbed/fab/verify/gerber_In3_Cu.png

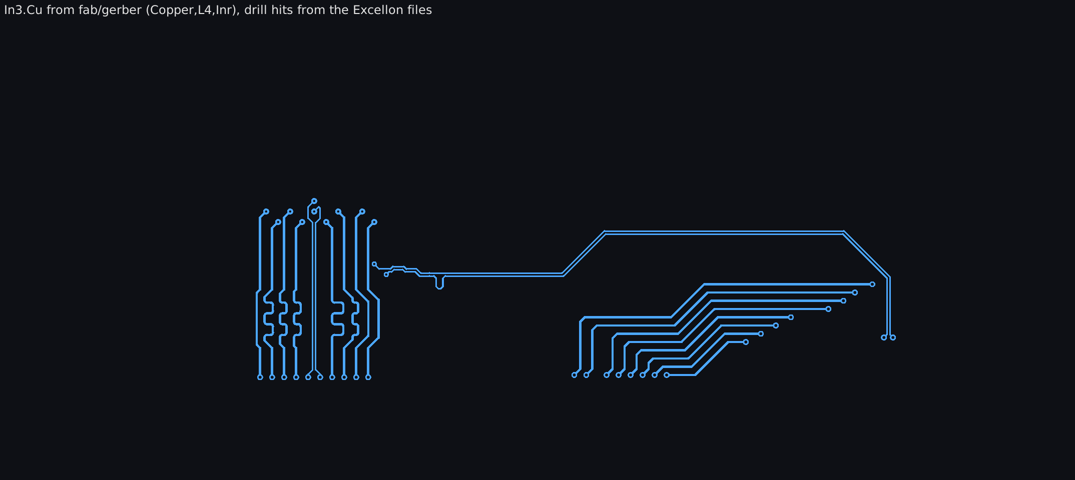
fab/verify/gerber_In3_Cu.png
