fingoldin/lpddr5-testbed/fab/verify/gerber_In4_Cu.png

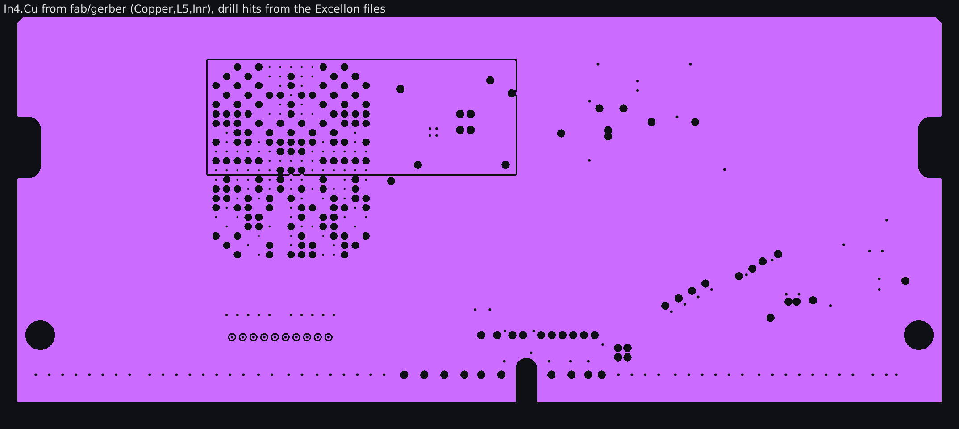
fab/verify/gerber_In4_Cu.png
