fingoldin/lpddr5-testbed/fab/assembly/lpddr5-testbed-assembly-bottom.pdf

BOTTOM SIDE, scale 4.5 : 1, 60 parts to place. Black: part outlines and references (Fab layer); blue-grey: legend; grey: mask openings (lands).

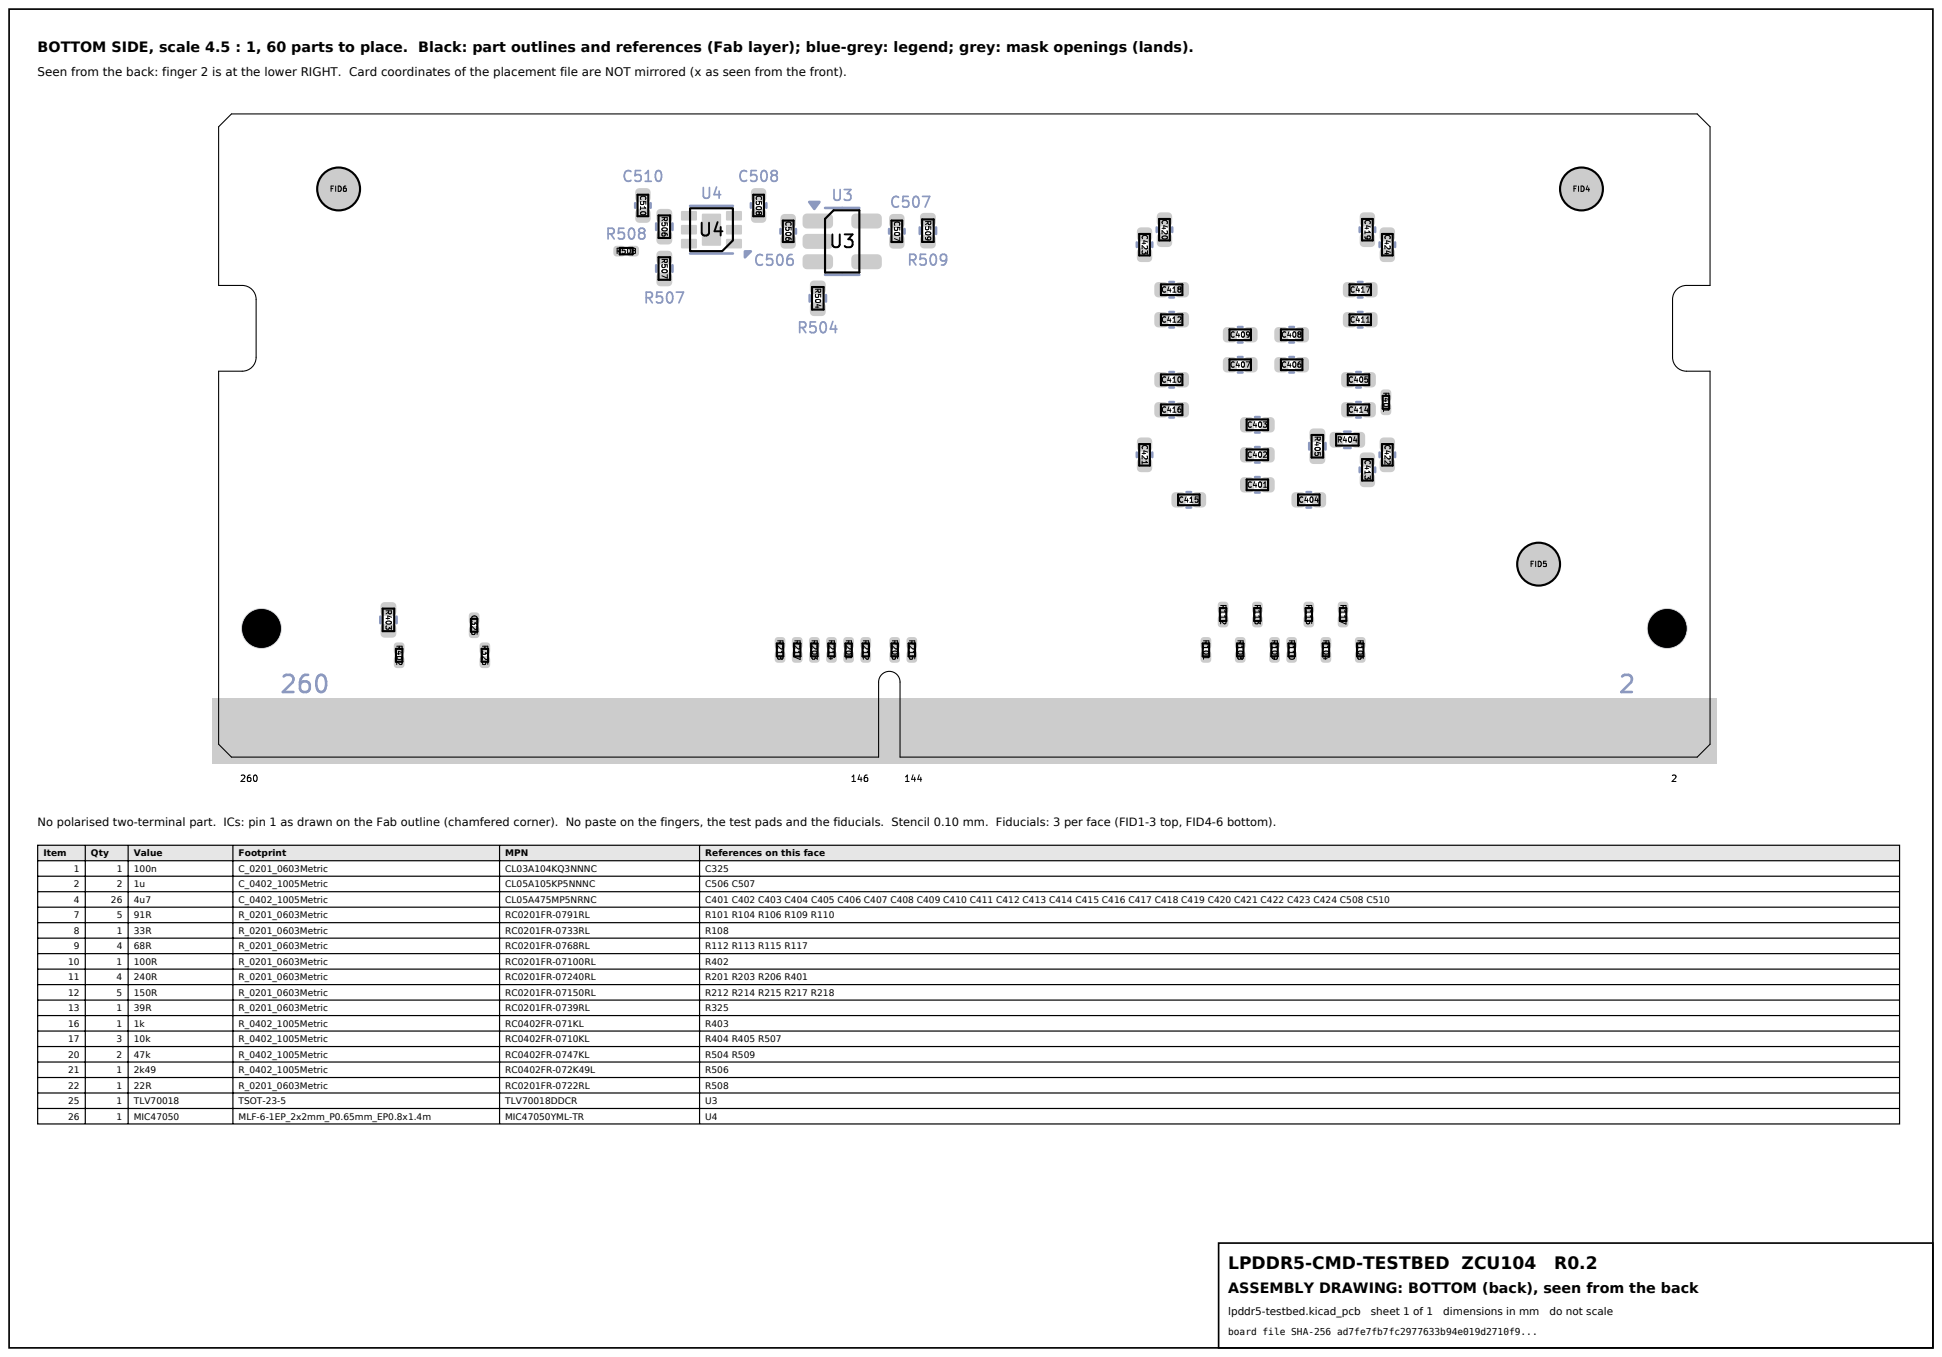
[picture p27: page 1]

Seen from the back: finger 2 is at the lower RIGHT. Card coordinates of the placement file are NOT mirrored (x as seen from the front).

No polarised two-terminal part. ICs: pin 1 as drawn on the Fab outline (chamfered corner). No paste on the fingers, the test pads and the fiducials. Stencil 0.10 mm. Fiducials: 3 per face (FID1-3 top, FID4-6 bottom).

Item | Qty | Value | Footprint | MPN | References on this face
1 | 1 | 100n | C_0201_0603Metric | CL03A104KQ3NNNC | C325
2 | 2 | 1u | C_0402_1005Metric | CL05A105KP5NNNC | C506 C507
4 | 26 | 4u7 | C_0402_1005Metric | CL05A475MP5NRNC | C401 C402 C403 C404 C405 C406 C407 C408 C409 C410 C411 C412 C413 C414 C415 C416 C417 C418 C419 C420 C421 C422 C423 C424 C508 C510
7 | 5 | 91R | R_0201_0603Metric | RC0201FR-0791RL | R101 R104 R106 R109 R110
8 | 1 | 33R | R_0201_0603Metric | RC0201FR-0733RL | R108
9 | 4 | 68R | R_0201_0603Metric | RC0201FR-0768RL | R112 R113 R115 R117
10 | 1 | 100R | R_0201_0603Metric | RC0201FR-07100RL | R402
11 | 4 | 240R | R_0201_0603Metric | RC0201FR-07240RL | R201 R203 R206 R401
12 | 5 | 150R | R_0201_0603Metric | RC0201FR-07150RL | R212 R214 R215 R217 R218
13 | 1 | 39R | R_0201_0603Metric | RC0201FR-0739RL | R325
16 | 1 | 1k | R_0402_1005Metric | RC0402FR-071KL | R403
17 | 3 | 10k | R_0402_1005Metric | RC0402FR-0710KL | R404 R405 R507
20 | 2 | 47k | R_0402_1005Metric | RC0402FR-0747KL | R504 R509
21 | 1 | 2k49 | R_0402_1005Metric | RC0402FR-072K49L | R506
22 | 1 | 22R | R_0201_0603Metric | RC0201FR-0722RL | R508
25 | 1 | TLV70018 | TSOT-23-5 | TLV70018DDCR | U3
26 | 1 | MIC47050 | MLF-6-1EP_2x2mm_P0.65mm_EP0.8x1.4m | MIC47050YML-TR | U4

LPDDR5-CMD-TESTBED ZCU104 R0.2
ASSEMBLY DRAWING: BOTTOM (back), seen from the back

lpddr5-testbed.kicad_pcb sheet 1 of 1 dimensions in mm do not scale
