fingoldin/lpddr5-testbed/fab/assembly/lpddr5-testbed-assembly-top.pdf

TOP SIDE, scale 4.5 : 1, 59 parts to place. Black: part outlines and references (Fab layer); blue-grey: legend; grey: mask openings (lands).

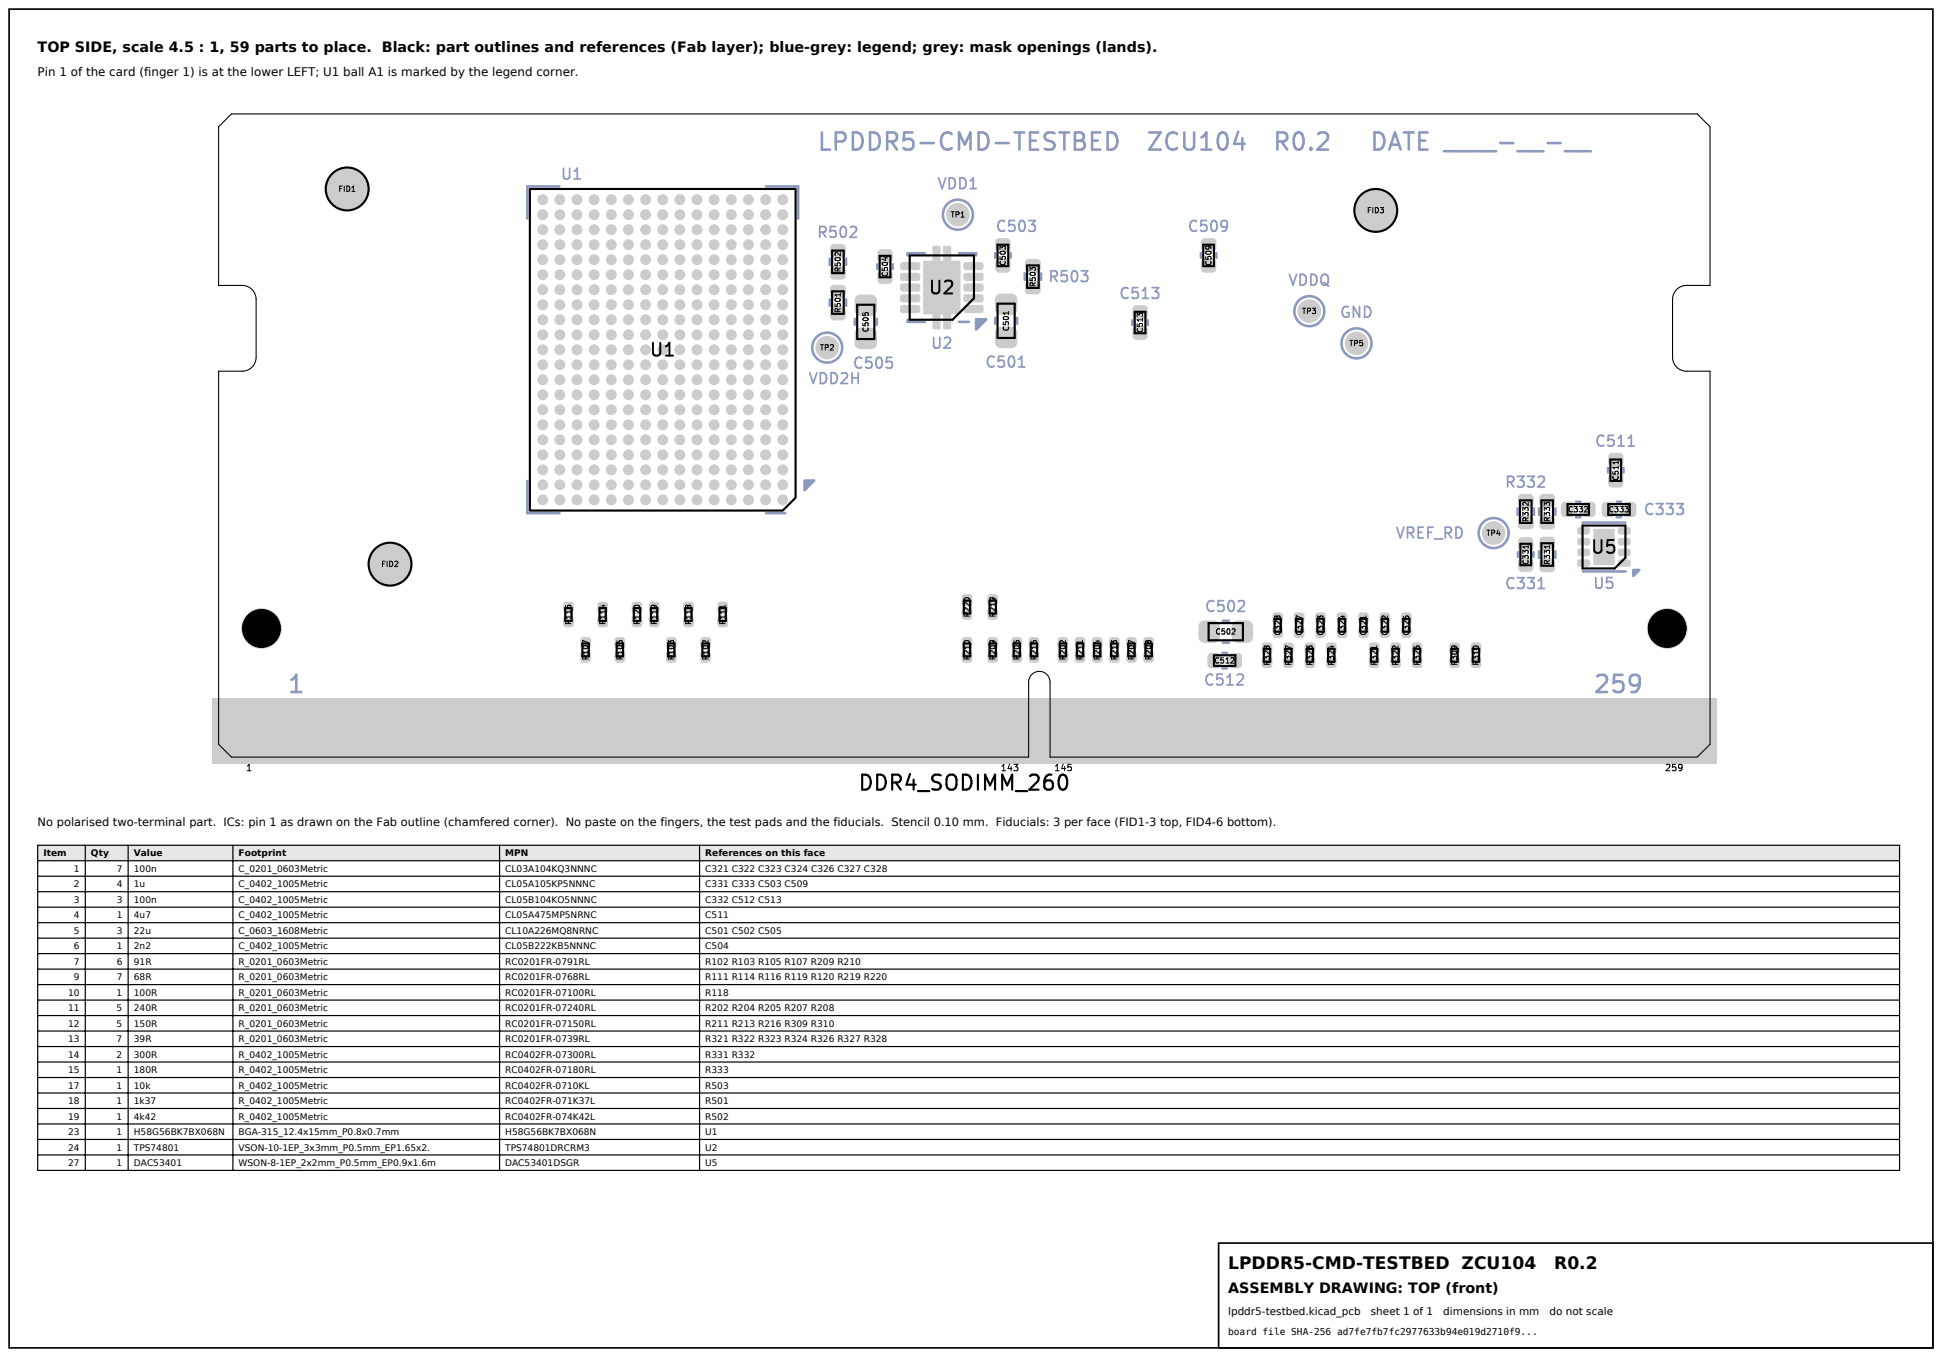
[picture p28: page 1]

Pin 1 of the card (finger 1) is at the lower LEFT; U1 ball A1 is marked by the legend corner.

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

Item | Qty | Value | Footprint | MPN | References on this face
1 | 7 | 100n | C_0201_0603Metric | CL03A104KQ3NNNC | C321 C322 C323 C324 C326 C327 C328
2 | 4 | 1u | C_0402_1005Metric | CL05A105KP5NNNC | C331 C333 C503 C509
3 | 3 | 100n | C_0402_1005Metric | CL05B104KO5NNNC | C332 C512 C513
4 | 1 | 4u7 | C_0402_1005Metric | CL05A475MP5NRNC | C511
5 | 3 | 22u | C_0603_1608Metric | CL10A226MQ8NRNC | C501 C502 C505
6 | 1 | 2n2 | C_0402_1005Metric | CL05B222KB5NNNC | C504
7 | 6 | 91R | R_0201_0603Metric | RC0201FR-0791RL | R102 R103 R105 R107 R209 R210
9 | 7 | 68R | R_0201_0603Metric | RC0201FR-0768RL | R111 R114 R116 R119 R120 R219 R220
10 | 1 | 100R | R_0201_0603Metric | RC0201FR-07100RL | R118
11 | 5 | 240R | R_0201_0603Metric | RC0201FR-07240RL | R202 R204 R205 R207 R208
12 | 5 | 150R | R_0201_0603Metric | RC0201FR-07150RL | R211 R213 R216 R309 R310
13 | 7 | 39R | R_0201_0603Metric | RC0201FR-0739RL | R321 R322 R323 R324 R326 R327 R328
14 | 2 | 300R | R_0402_1005Metric | RC0402FR-07300RL | R331 R332
15 | 1 | 180R | R_0402_1005Metric | RC0402FR-07180RL | R333
17 | 1 | 10k | R_0402_1005Metric | RC0402FR-0710KL | R503
18 | 1 | 1k37 | R_0402_1005Metric | RC0402FR-071K37L | R501
19 | 1 | 4k42 | R_0402_1005Metric | RC0402FR-074K42L | R502
23 | 1 | H58G56BK7BX068N | BGA-315_12.4x15mm_P0.8x0.7mm | H58G56BK7BX068N | U1
24 | 1 | TPS74801 | VSON-10-1EP_3x3mm_P0.5mm_EP1.65x2. | TPS74801DRCRM3 | U2
27 | 1 | DAC53401 | WSON-8-1EP_2x2mm_P0.5mm_EP0.9x1.6m | DAC53401DSGR | U5

LPDDR5-CMD-TESTBED ZCU104 R0.2
ASSEMBLY DRAWING: TOP (front)

lpddr5-testbed.kicad_pcb sheet 1 of 1 dimensions in mm do not scale
