fingoldin/lpddr5-testbed/lpddr5-testbed.kicad_pcb

## KiCad design lpddr5-testbed.kicad_pcb (2026-11-12)

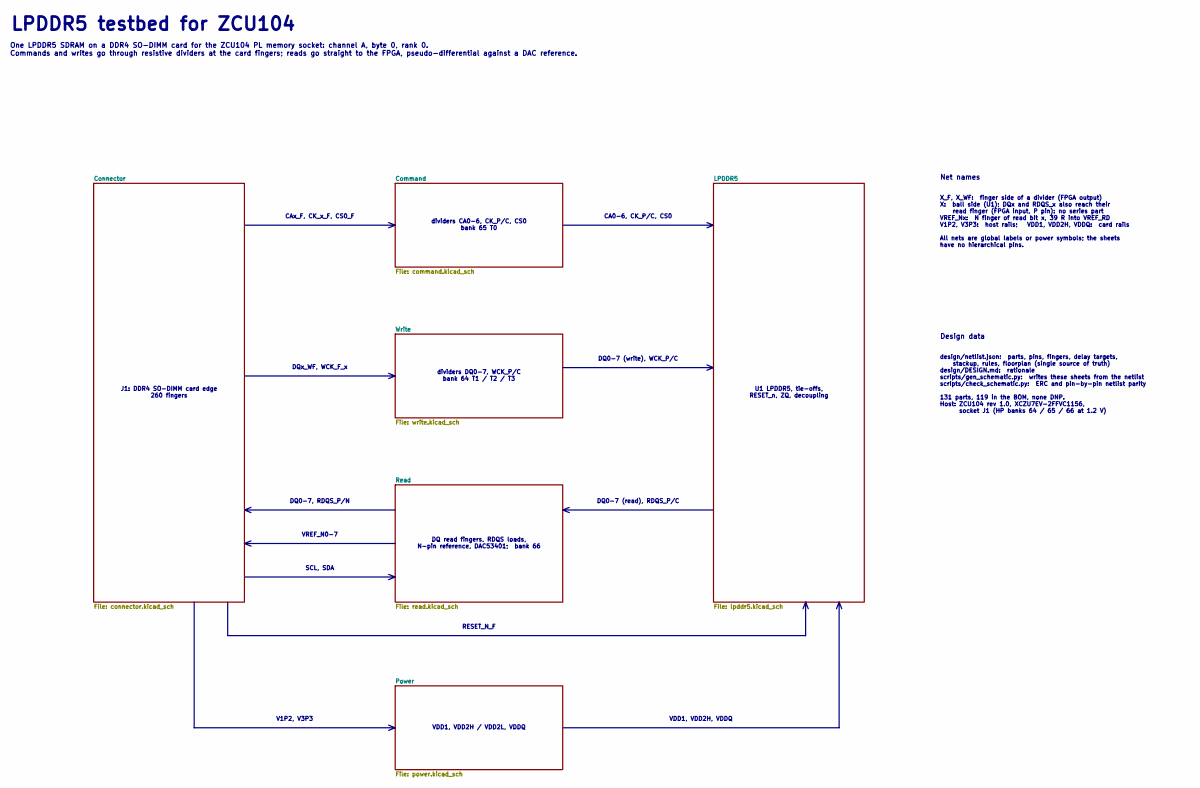
[picture p29: schematic lpddr5-testbed.kicad_sch, LPDDR5 testbed for ZCU104]

Notes on the sheet:
Net names
DQ0-7 (write), WCK_P/C
X_F, X_WF: finger side of a divider (FPGA output) X: ball side (U1); DQx and RDQS_x also reach their read finger (FPGA input, P pin): no series part VREF_Nx: N finger of read bit x, 39 R into VREF_RD V1P2, V3P3: host rails; VDD1, VDD2H, VDDQ: card rails All nets are global labels or power symbols; 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
DQ read fingers, RDQS loads, N-pin reference, DAC53401; bank 66
DQ0-7 (read), RDQS_P/C
CA0-6, CK_P/C, CS0
LPDDR5 testbed for ZCU104
CAx_F, CK_x_F, CS0_F
RESET_N_F
DQ0-7, RDQS_P/N
J1: DDR4 SO-DIMM card edge 260 fingers
V1P2, V3P3
VDD1, VDD2H / VDD2L, VDDQ
VREF_N0-7
Design data
SCL, SDA
design/netlist.json: parts, pins, fingers, delay targets, stackup, rules, floorplan (single source of truth) design/DESIGN.md: rationale scripts/gen_schematic.py: writes these sheets from the netlist scripts/check_schematic.py: ERC and pin-by-pin netlist parity 131 parts, 119 in the BOM, none DNP. 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
DQx_WF, WCK_F_x
dividers CA0-6, CK_P/C, CS0 bank 65 T0
dividers DQ0-7, WCK_P/C bank 64 T1 / T2 / T3
U1 LPDDR5, tie-offs, RESET_n, ZQ, decoupling
One LPDDR5 SDRAM on a DDR4 SO-DIMM card for the ZCU104 PL memory socket: channel A, byte 0, rank 0. Commands and writes go through resistive dividers at the card fingers; reads go straight to the FPGA, pseudo-differential against a DAC reference.
VDD1, VDD2H, VDDQ

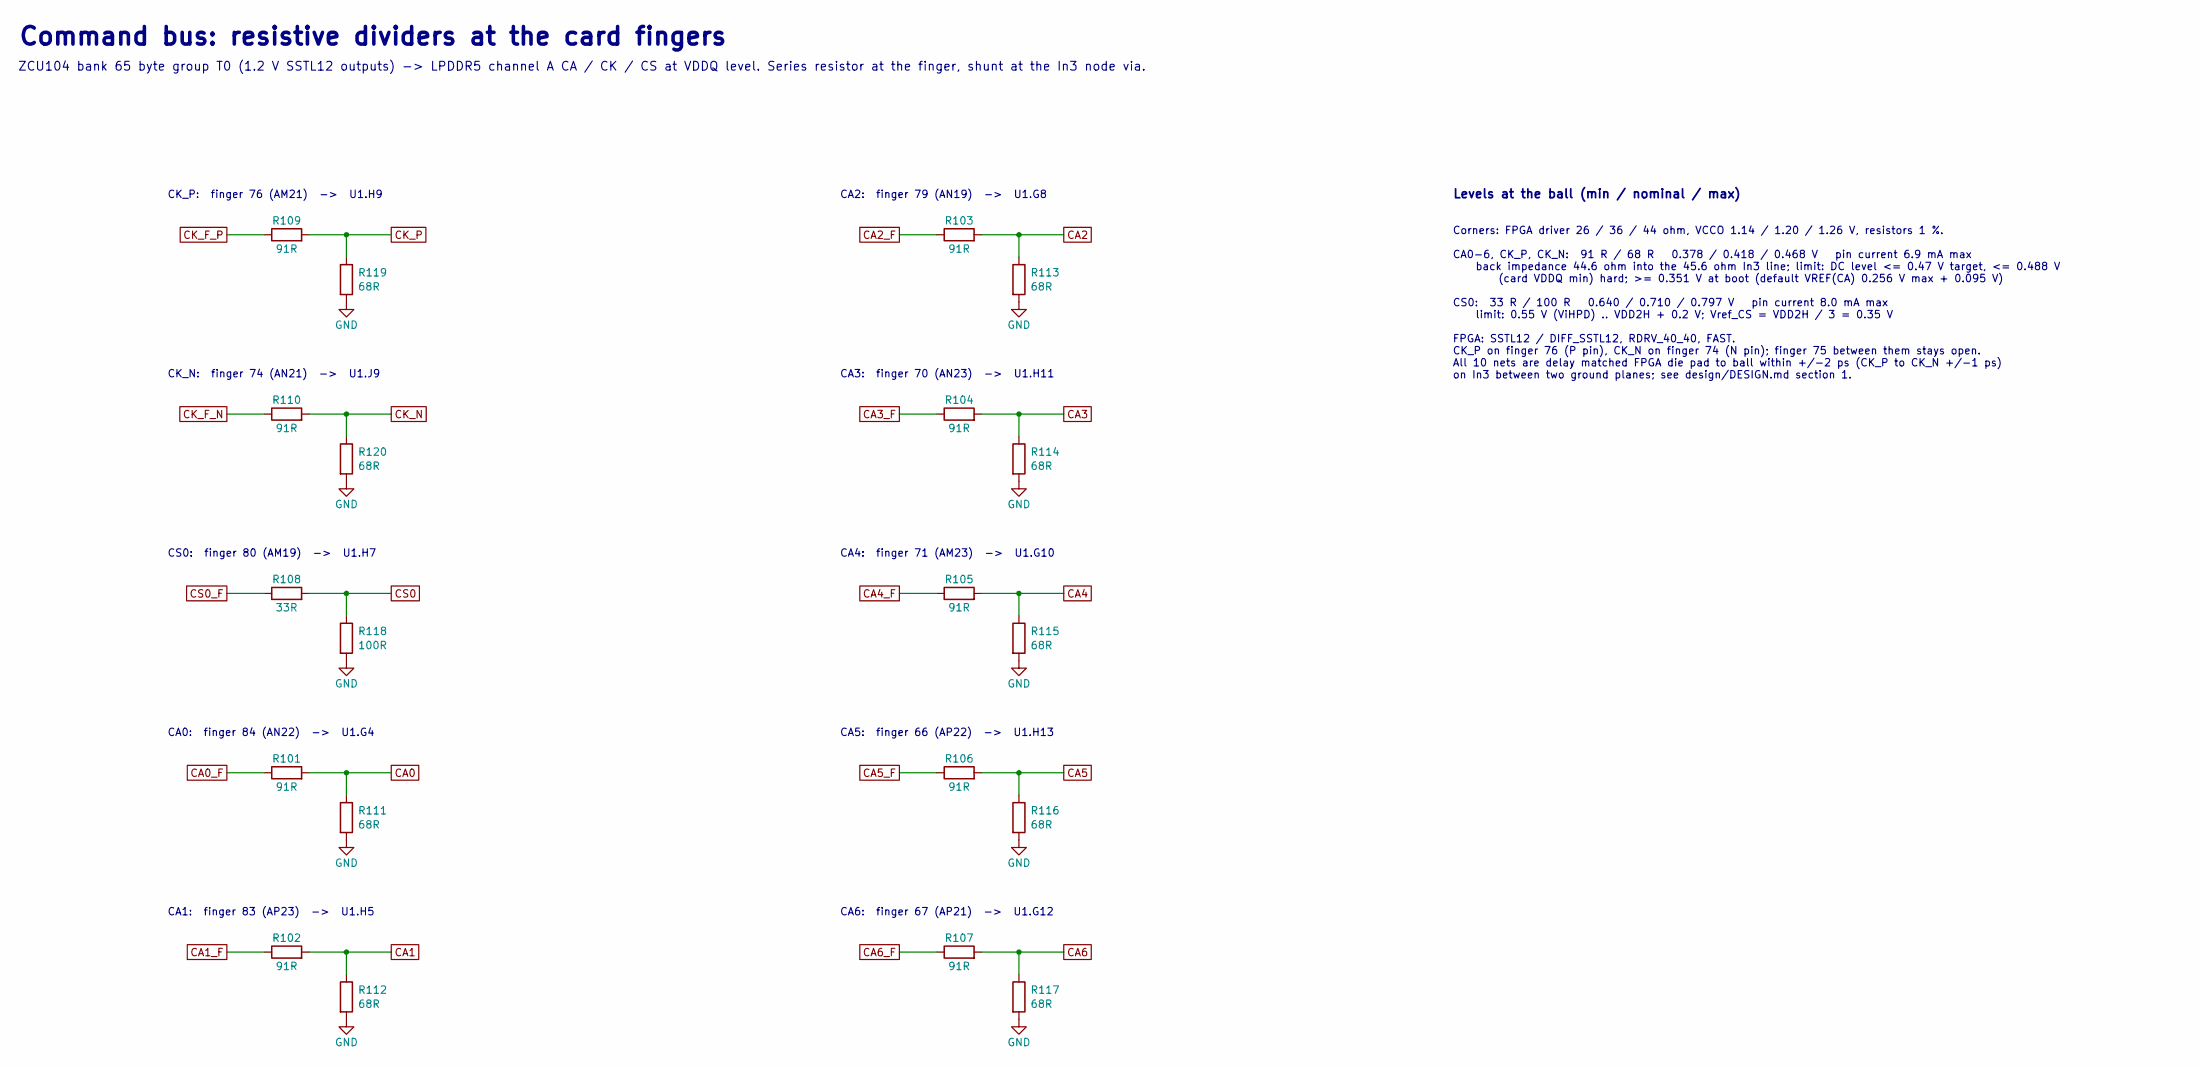
[picture p30: schematic command.kicad_sch, LPDDR5 testbed for ZCU104]

Parts:
R101, R102, R103, R104, R105, R106, R107, R109, R110: 91R; R_0201_0603Metric; MPN RC0201FR-0791RL
R108: 33R; R_0201_0603Metric; MPN RC0201FR-0733RL
R111, R112, R113, R114, R115, R116, R117, R119, R120: 68R; R_0201_0603Metric; MPN RC0201FR-0768RL
R118: 100R; R_0201_0603Metric; MPN RC0201FR-07100RL

Connections:
CA0: R101.2, R111.1; also elsewhere on the board
CA0_F: R101.1; also elsewhere on the board
CA1: R102.2, R112.1; also elsewhere on the board
CA1_F: R102.1; also elsewhere on the board
CA2: R103.2, R113.1; also elsewhere on the board
CA2_F: R103.1; also elsewhere on the board
CA3: R104.2, R114.1; also elsewhere on the board
CA3_F: R104.1; also elsewhere on the board
CA4: R105.2, R115.1; also elsewhere on the board
CA4_F: R105.1; also elsewhere on the board
CA5: R106.2, R116.1; also elsewhere on the board
CA5_F: R106.1; also elsewhere on the board
CA6: R107.2, R117.1; also elsewhere on the board
CA6_F: R107.1; also elsewhere on the board
CK_F_N: R110.1; also elsewhere on the board
CK_F_P: R109.1; also elsewhere on the board
CK_N: R110.2, R120.1; also elsewhere on the board
CK_P: R109.2, R119.1; also elsewhere on the board
CS0: R108.2, R118.1; also elsewhere on the board
CS0_F: R108.1; also elsewhere on the board
GND: R111.2, R112.2, R113.2, R114.2, R115.2, R116.2, R117.2, R118.2, R119.2, R120.2; also elsewhere on the board

Notes on the sheet:
CS0: finger 80 (AM19) -> U1.H7
CA0: finger 84 (AN22) -> U1.G4
Corners: FPGA driver 26 / 36 / 44 ohm, VCCO 1.14 / 1.20 / 1.26 V, resistors 1 %. CA0-6, CK_P, CK_N: 91 R / 68 R 0.378 / 0.418 / 0.468 V pin current 6.9 mA max back impedance 44.6 ohm into the 45.6 ohm In3 line; limit: DC level <= 0.47 V target, <= 0.488 V (card VDDQ min) hard; >= 0.351 V at boot (d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
CA6: finger 67 (AP21) -> U1.G12
Command bus: resistive dividers at the card fingers
CA4: finger 71 (AM23) -> U1.G10
CK_N: finger 74 (AN21) -> U1.J9
ZCU104 bank 65 byte group T0 (1.2 V SSTL12 outputs) -> LPDDR5 channel A CA / CK / CS at VDDQ level. Series resistor at the finger, shunt at the In3 node via.
CA1: finger 83 (AP23) -> U1.H5
Levels at the ball (min / nominal / max)
CK_P: finger 76 (AM21) -> U1.H9
CA2: finger 79 (AN19) -> U1.G8
CA5: finger 66 (AP22) -> U1.H13
CA3: finger 70 (AN23) -> U1.H11

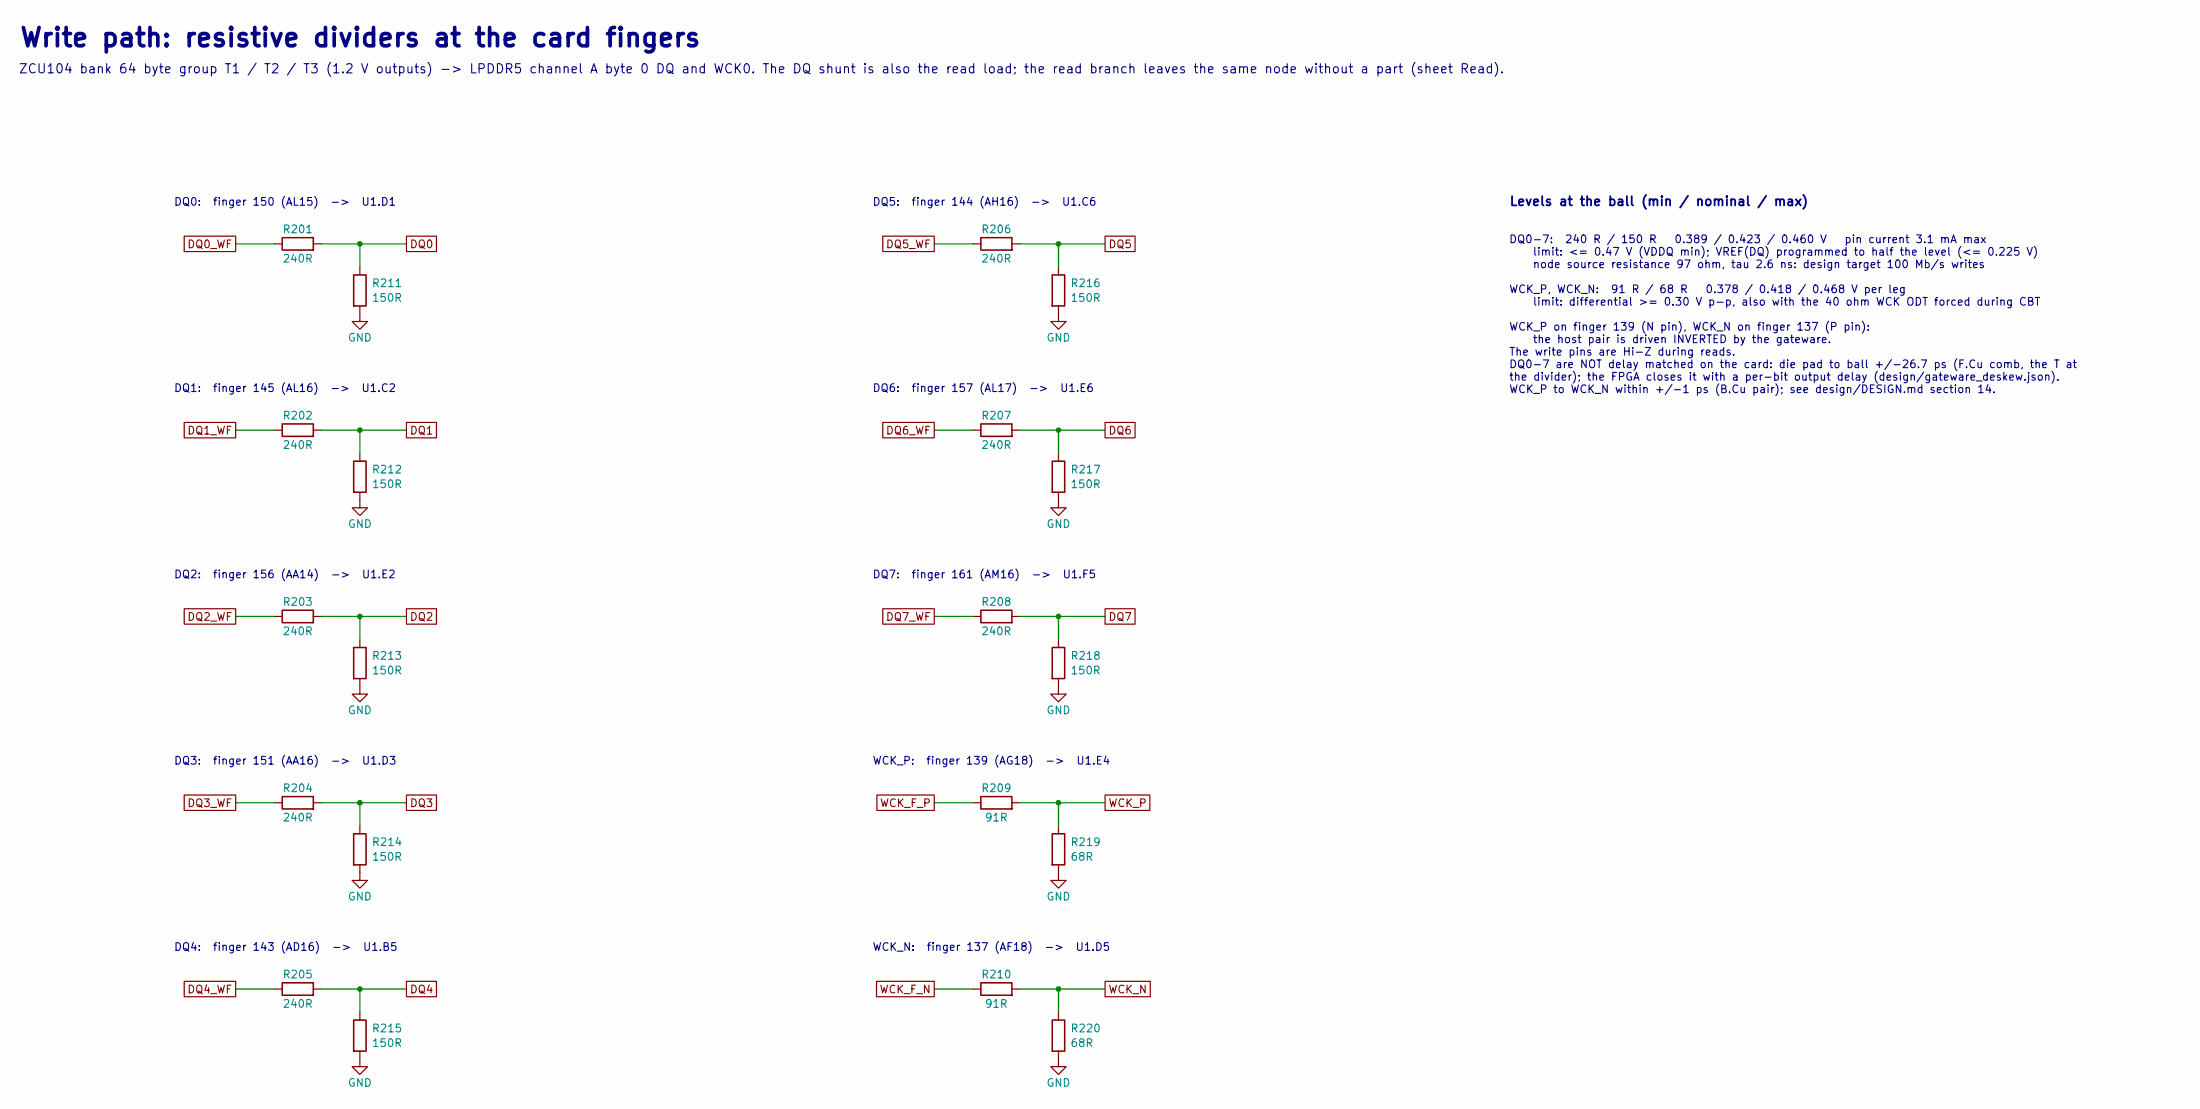
[picture p31: schematic write.kicad_sch, LPDDR5 testbed for ZCU104]

Parts:
R201, R202, R203, R204, R205, R206, R207, R208: 240R; R_0201_0603Metric; MPN RC0201FR-07240RL
R209, R210: 91R; R_0201_0603Metric; MPN RC0201FR-0791RL
R211, R212, R213, R214, R215, R216, R217, R218: 150R; R_0201_0603Metric; MPN RC0201FR-07150RL
R219, R220: 68R; R_0201_0603Metric; MPN RC0201FR-0768RL

Connections:
DQ0: R201.2, R211.1; also elsewhere on the board
DQ0_WF: R201.1; also elsewhere on the board
DQ1: R202.2, R212.1; also elsewhere on the board
DQ1_WF: R202.1; also elsewhere on the board
DQ2: R203.2, R213.1; also elsewhere on the board
DQ2_WF: R203.1; also elsewhere on the board
DQ3: R204.2, R214.1; also elsewhere on the board
DQ3_WF: R204.1; also elsewhere on the board
DQ4: R205.2, R215.1; also elsewhere on the board
DQ4_WF: R205.1; also elsewhere on the board
DQ5: R206.2, R216.1; also elsewhere on the board
DQ5_WF: R206.1; also elsewhere on the board
DQ6: R207.2, R217.1; also elsewhere on the board
DQ6_WF: R207.1; also elsewhere on the board
DQ7: R208.2, R218.1; also elsewhere on the board
DQ7_WF: R208.1; also elsewhere on the board
GND: R211.2, R212.2, R213.2, R214.2, R215.2, R216.2, R217.2, R218.2, R219.2, R220.2; also elsewhere on the board
WCK_F_N: R210.1; also elsewhere on the board
WCK_F_P: R209.1; also elsewhere on the board
WCK_N: R210.2, R220.1; also elsewhere on the board
WCK_P: R209.2, R219.1; also elsewhere on the board

Notes on the sheet:
DQ4: finger 143 (AD16) -> U1.B5
ZCU104 bank 64 byte group T1 / T2 / T3 (1.2 V outputs) -> LPDDR5 channel A byte 0 DQ and WCK0. The DQ shunt is also the read load; the read branch leaves the same node without a part (sheet Read).
DQ5: finger 144 (AH16) -> U1.C6
Write path: resistive dividers at the card fingers
DQ6: finger 157 (AL17) -> U1.E6
DQ0: finger 150 (AL15) -> U1.D1
WCK_N: finger 137 (AF18) -> U1.D5
DQ7: finger 161 (AM16) -> U1.F5
DQ1: finger 145 (AL16) -> U1.C2
DQ2: finger 156 (AA14) -> U1.E2
Levels at the ball (min / nominal / max)
DQ3: finger 151 (AA16) -> U1.D3
DQ0-7: 240 R / 150 R 0.389 / 0.423 / 0.460 V pin current 3.1 mA max limit: <= 0.47 V (VDDQ min); VREF(DQ) programmed to half the level (<= 0.225 V) node source resistance 97 ohm, tau 2.6 ns: design target 100 Mb/s writes WCK_P, WCK_N: 91 R / 68 R 0.378 / 0.418 / 0.468 V per leg limit: differential 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
WCK_P: finger 139 (AG18) -> U1.E4

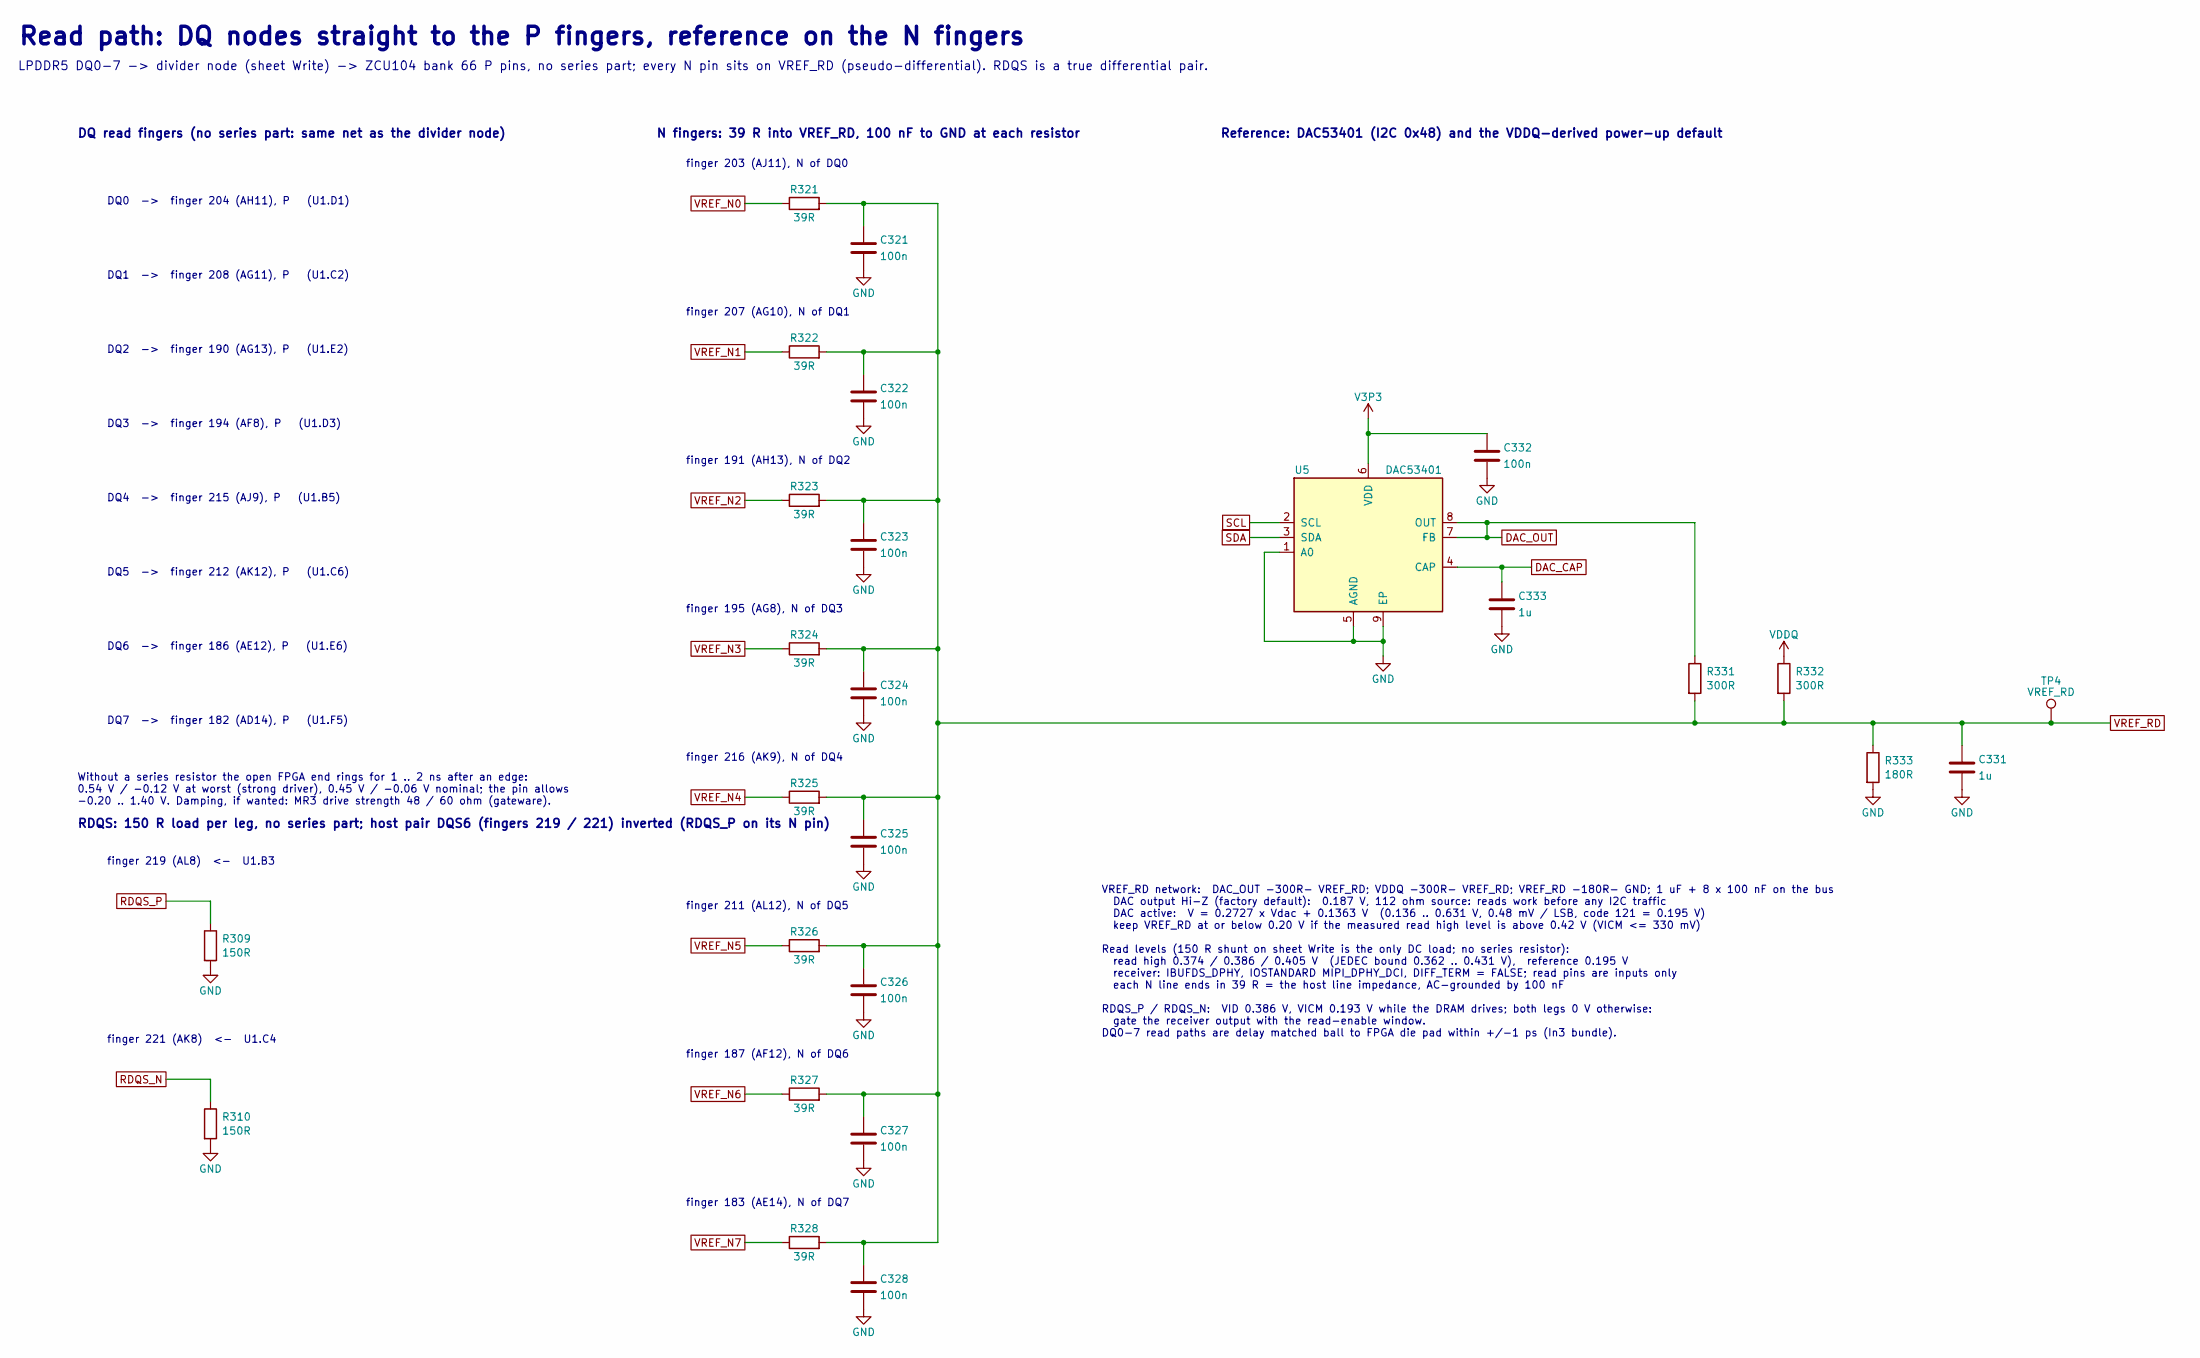
[picture p32: schematic read.kicad_sch, LPDDR5 testbed for ZCU104]

Parts:
C321, C322, C323, C324, C325, C326, C327, C328: 100n; C_0201_0603Metric; MPN CL03A104KQ3NNNC
C331, C333: 1u; C_0402_1005Metric; MPN CL05A105KP5NNNC
C332: 100n; C_0402_1005Metric; MPN CL05B104KO5NNNC
R309, R310: 150R; R_0201_0603Metric; MPN RC0201FR-07150RL
R321, R322, R323, R324, R325, R326, R327, R328: 39R; R_0201_0603Metric; MPN RC0201FR-0739RL
R331, R332: 300R; R_0402_1005Metric; MPN RC0402FR-07300RL
R333: 180R; R_0402_1005Metric; MPN RC0402FR-07180RL
TP4: VREF_RD; TestPoint_Pad_D1.0mm; MPN N/A (PCB pad)
U5: DAC53401; WSON-8-1EP_2x2mm_P0.5mm_EP0.9x1.6mm; MPN DAC53401DSGR

Connections:
DAC_CAP: C333.1, U5.4 (CAP)
DAC_OUT: R331.1, U5.7 (FB), U5.8 (OUT)
GND: C321.2, C322.2, C323.2, C324.2, C325.2, C326.2, C327.2, C328.2, C331.2, C332.2, C333.2, R309.2, R310.2, R333.2, U5.1 (A0), U5.5 (AGND), U5.9 (EP); also elsewhere on the board
RDQS_N: R310.1; also elsewhere on the board
RDQS_P: R309.1; also elsewhere on the board
SCL: U5.2 (SCL); also elsewhere on the board
SDA: U5.3 (SDA); also elsewhere on the board
V3P3: C332.1, U5.6 (VDD); also elsewhere on the board
VDDQ: R332.1; also elsewhere on the board
VREF_N0: R321.1; also elsewhere on the board
VREF_N1: R322.1; also elsewhere on the board
VREF_N2: R323.1; also elsewhere on the board
VREF_N3: R324.1; also elsewhere on the board
VREF_N4: R325.1; also elsewhere on the board
VREF_N5: R326.1; also elsewhere on the board
VREF_N6: R327.1; also elsewhere on the board
VREF_N7: R328.1; also elsewhere on the board
VREF_RD: C321.1, C322.1, C323.1, C324.1, C325.1, C326.1, C327.1, C328.1, C331.1, R321.2, R322.2, R323.2, R324.2, R325.2, R326.2, R327.2, R328.2, R331.2, R332.2, R333.1, TP4.1

Notes on the sheet:
DQ7 -> finger 182 (AD14), P (U1.F5)
DQ1 -> finger 208 (AG11), P (U1.C2)
Reference: DAC53401 (I2C 0x48) and the VDDQ-derived power-up default
RDQS: 150 R load per leg, no series part; host pair DQS6 (fingers 219 / 221) inverted (RDQS_P on its N pin)
Without a series resistor the open FPGA end rings for 1 .. 2 ns after an edge: 0.54 V / -0.12 V at worst (strong driver), 0.45 V / -0.06 V nominal; the pin allows -0.20 .. 1.40 V. Damping, if wanted: MR3 drive strength 48 / 60 ohm (gateware).
N fingers: 39 R into VREF_RD, 100 nF to GND at each resistor
LPDDR5 DQ0-7 -> divider node (sheet Write) -> ZCU104 bank 66 P pins, no series part; every N pin sits on VREF_RD (pseudo-differential). RDQS is a true differential pair.
VREF_RD network: DAC_OUT -300R- VREF_RD; VDDQ -300R- VREF_RD; VREF_RD -180R- GND; 1 uF + 8 x 100 nF on the bus DAC output Hi-Z (factory default): 0.187 V, 112 ohm source: reads work before any I2C traffic DAC active: V = 0.2727 x Vdac + 0.1363 V (0.136 .. 0.631 V, 0.48 mV / LSB, code 121 = 0.195 V)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
finger 195 (AG8), N of DQ3
DQ2 -> finger 190 (AG13), P (U1.E2)
finger 211 (AL12), N of DQ5
finger 203 (AJ11), N of DQ0
finger 191 (AH13), N of DQ2
finger 221 (AK8) <- U1.C4
DQ0 -> finger 204 (AH11), P (U1.D1)
DQ5 -> finger 212 (AK12), P (U1.C6)
DQ6 -> finger 186 (AE12), P (U1.E6)
DQ4 -> finger 215 (AJ9), P (U1.B5)
finger 183 (AE14), N of DQ7
DQ read fingers (no series part: same net as the divider node)
finger 207 (AG10), N of DQ1
Read path: DQ nodes straight to the P fingers, reference on the N fingers
finger 216 (AK9), N of DQ4
finger 219 (AL8) <- U1.B3
DQ3 -> finger 194 (AF8), P (U1.D3)
finger 187 (AF12), N of DQ6

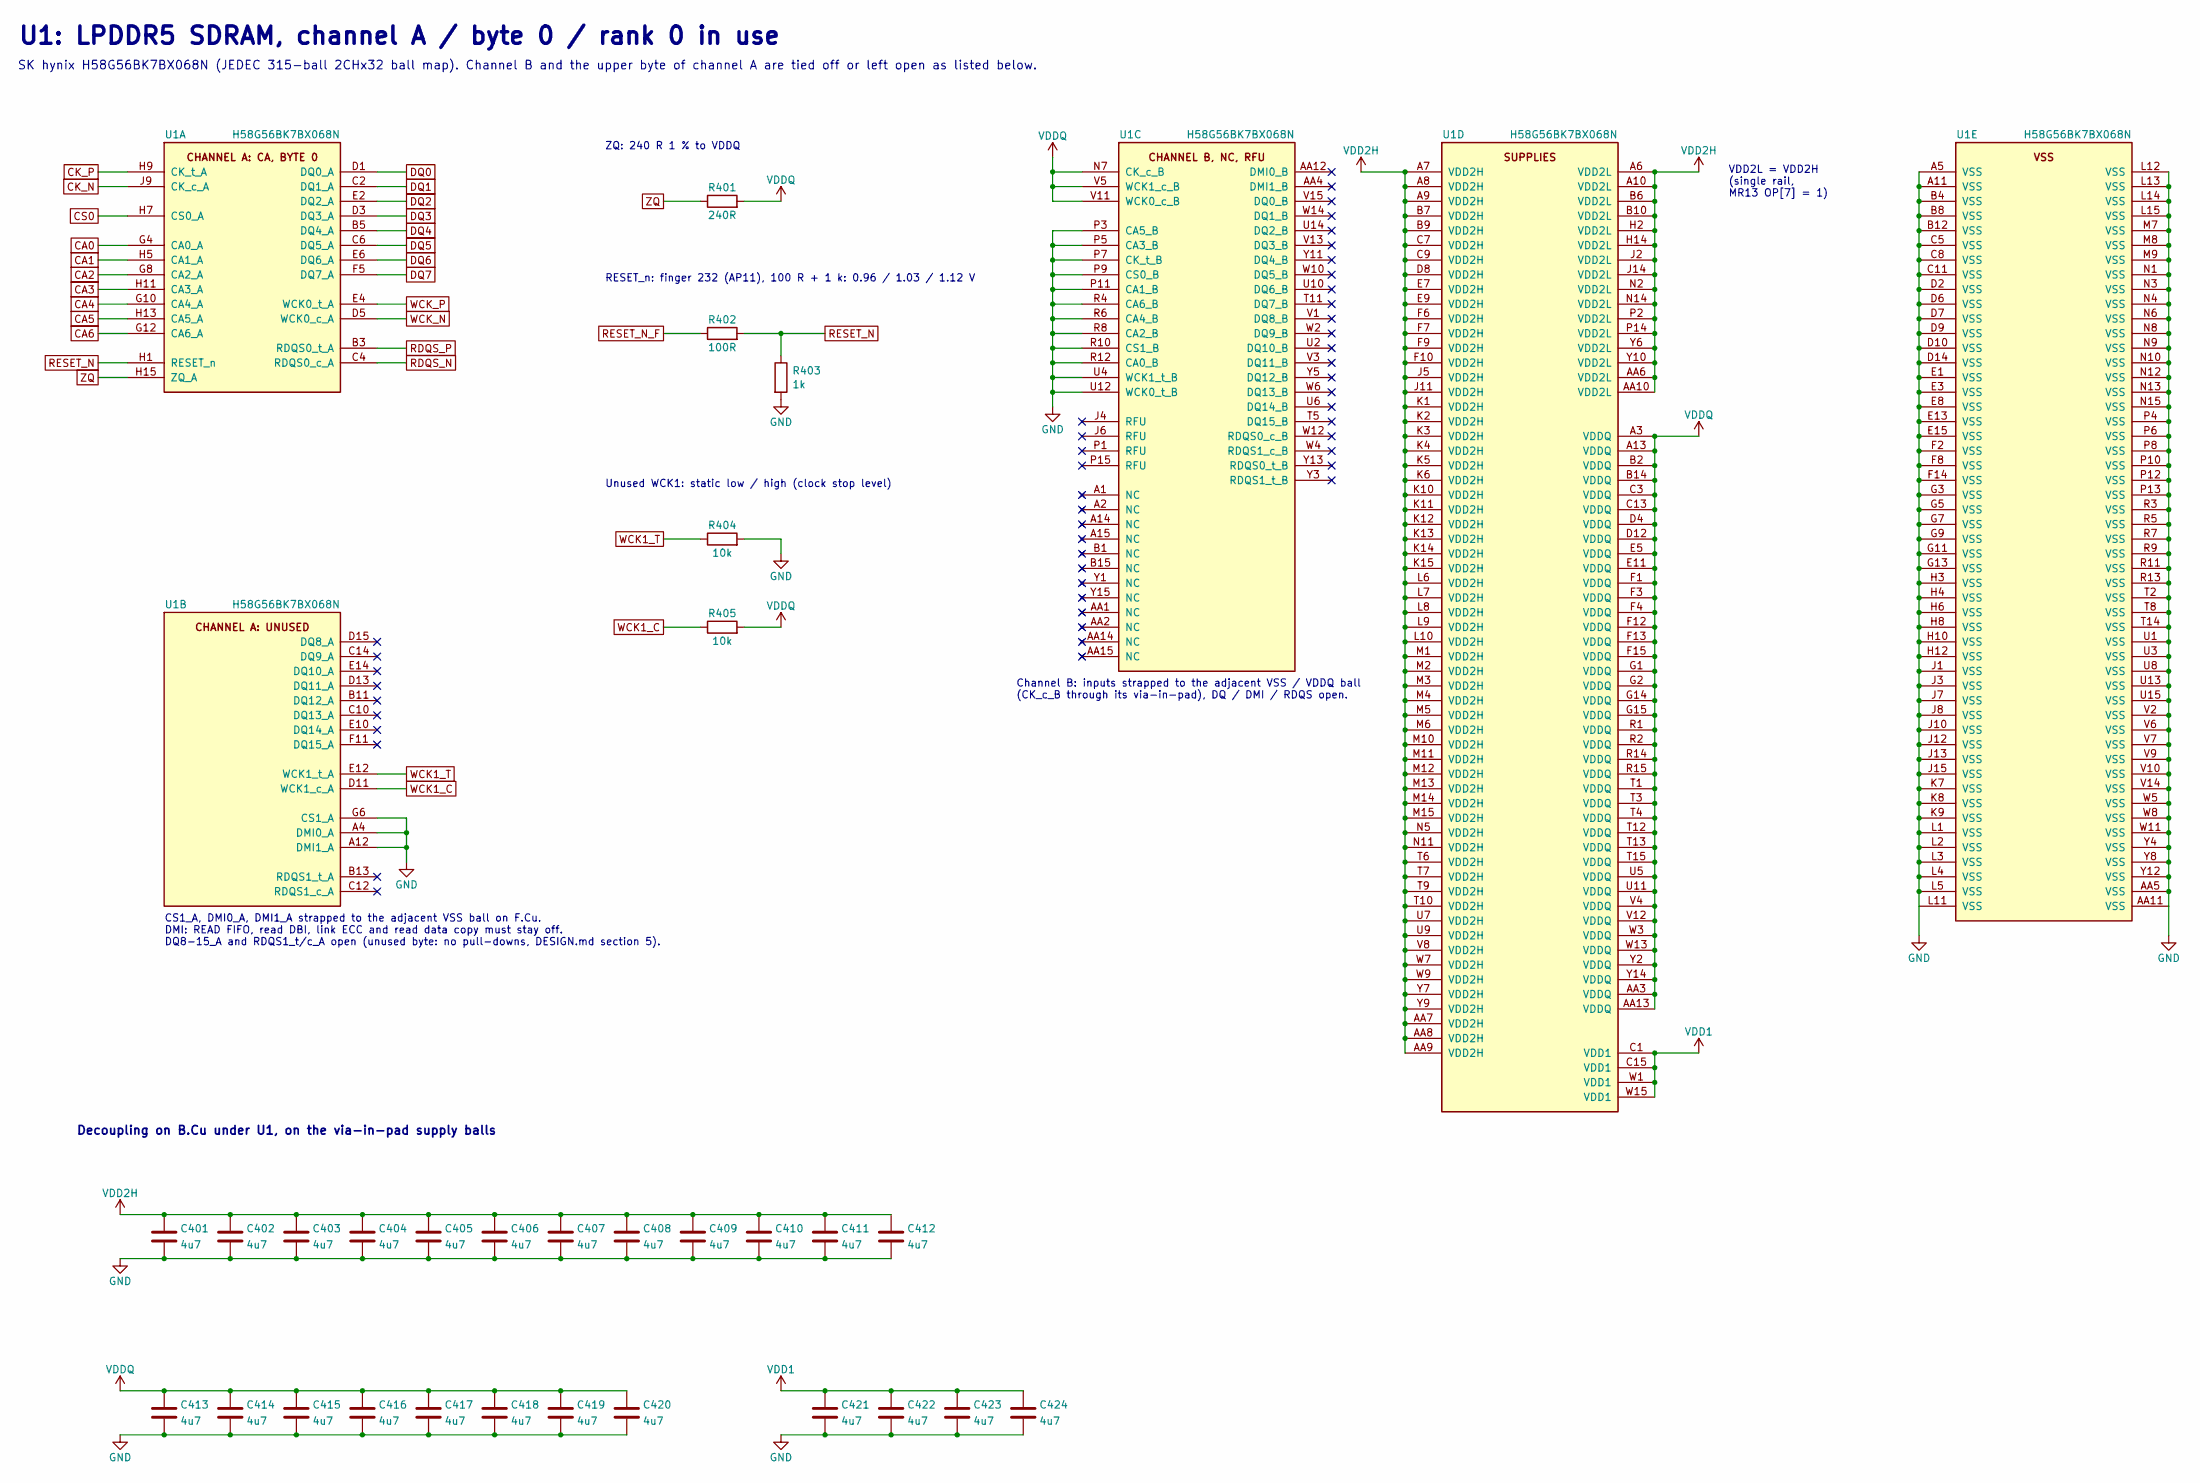
[picture p33: schematic lpddr5.kicad_sch, LPDDR5 testbed for ZCU104]

Parts:
C401, C402, C403, C404, C405, C406, C407, C408, C409, C410, C411, C412, C413, C414, C415, C416, C417, C418, C419, C420, C421, C422, C423, C424: 4u7; C_0402_1005Metric; MPN CL05A475MP5NRNC
R401: 240R; R_0201_0603Metric; MPN RC0201FR-07240RL
R402: 100R; R_0201_0603Metric; MPN RC0201FR-07100RL
R403: 1k; R_0402_1005Metric; MPN RC0402FR-071KL
R404, R405: 10k; R_0402_1005Metric; MPN RC0402FR-0710KL
U1: H58G56BK7BX068N; BGA-315_12.4x15mm_P0.8x0.7mm; MPN H58G56BK7BX068N

Connections:
CA0: U1.G4 (CA0_A); also elsewhere on the board
CA1: U1.H5 (CA1_A); also elsewhere on the board
CA2: U1.G8 (CA2_A); also elsewhere on the board
CA3: U1.H11 (CA3_A); also elsewhere on the board
CA4: U1.G10 (CA4_A); also elsewhere on the board
CA5: U1.H13 (CA5_A); also elsewhere on the board
CA6: U1.G12 (CA6_A); also elsewhere on the board
CK_N: U1.J9 (CK_c_A); also elsewhere on the board
CK_P: U1.H9 (CK_t_A); also elsewhere on the board
CS0: U1.H7 (CS0_A); also elsewhere on the board
DQ0: U1.D1 (DQ0_A); also elsewhere on the board
DQ1: U1.C2 (DQ1_A); also elsewhere on the board
DQ2: U1.E2 (DQ2_A); also elsewhere on the board
DQ3: U1.D3 (DQ3_A); also elsewhere on the board
DQ4: U1.B5 (DQ4_A); also elsewhere on the board
DQ5: U1.C6 (DQ5_A); also elsewhere on the board
DQ6: U1.E6 (DQ6_A); also elsewhere on the board
DQ7: U1.F5 (DQ7_A); also elsewhere on the board
GND: C401.2, C402.2, C403.2, C404.2, C405.2, C406.2, C407.2, C408.2, C409.2, C410.2, C411.2, C412.2, C413.2, C414.2, C415.2, C416.2, C417.2, C418.2, C419.2, C420.2, C421.2, C422.2, C423.2, C424.2, R403.2, R404.2, U1.A4 (DMI0_A), U1.A5 (VSS), U1.A11 (VSS), U1.A12 (DMI1_A), U1.AA5 (VSS), U1.AA11 (VSS), U1.B4 (VSS), U1.B8 (VSS), U1.B12 (VSS), U1.C5 (VSS), U1.C8 (VSS), U1.C11 (VSS), U1.D2 (VSS), U1.D6 (VSS), U1.D7 (VSS), U1.D9 (VSS), U1.D10 (VSS), U1.D14 (VSS), U1.E1 (VSS), U1.E3 (VSS), U1.E8 (VSS), U1.E13 (VSS), U1.E15 (VSS), U1.F2 (VSS), U1.F8 (VSS), U1.F14 (VSS), U1.G3 (VSS), U1.G5 (VSS), U1.G6 (CS1_A), U1.G7 (VSS), U1.G9 (VSS), U1.G11 (VSS), U1.G13 (VSS), U1.H3 (VSS), U1.H4 (VSS), U1.H6 (VSS), U1.H8 (VSS), U1.H10 (VSS), U1.H12 (VSS), U1.J1 (VSS), U1.J3 (VSS), U1.J7 (VSS), U1.J8 (VSS), U1.J10 (VSS), U1.J12 (VSS), U1.J13 (VSS), U1.J15 (VSS), U1.K7 (VSS), U1.K8 (VSS), U1.K9 (VSS), U1.L1 (VSS), U1.L2 (VSS), U1.L3 (VSS), U1.L4 (VSS), U1.L5 (VSS), U1.L11 (VSS), U1.L12 (VSS), U1.L13 (VSS), U1.L14 (VSS), U1.L15 (VSS), U1.M7 (VSS), U1.M8 (VSS), U1.M9 (VSS), U1.N1 (VSS), U1.N3 (VSS), U1.N4 (VSS), U1.N6 (VSS), U1.N8 (VSS), U1.N9 (VSS), U1.N10 (VSS), U1.N12 (VSS), U1.N13 (VSS), U1.N15 (VSS), U1.P3 (CA5_B), U1.P4 (VSS), U1.P5 (CA3_B), U1.P6 (VSS), U1.P7 (CK_t_B), U1.P8 (VSS), U1.P9 (CS0_B), U1.P10 (VSS), U1.P11 (CA1_B), U1.P12 (VSS), U1.P13 (VSS), U1.R3 (VSS), U1.R4 (CA6_B), U1.R5 (VSS), U1.R6 (CA4_B), U1.R7 (VSS), U1.R8 (CA2_B), U1.R9 (VSS), U1.R10 (CS1_B), U1.R11 (VSS), U1.R12 (CA0_B), U1.R13 (VSS), U1.T2 (VSS), U1.T8 (VSS), U1.T14 (VSS), U1.U1 (VSS), U1.U3 (VSS), U1.U4 (WCK1_t_B), U1.U8 (VSS), U1.U12 (WCK0_t_B), U1.U13 (VSS), U1.U15 (VSS), U1.V2 (VSS), U1.V6 (VSS), U1.V7 (VSS), U1.V9 (VSS), U1.V10 (VSS), U1.V14 (VSS), U1.W5 (VSS), U1.W8 (VSS), U1.W11 (VSS), U1.Y4 (VSS), U1.Y8 (VSS), U1.Y12 (VSS); also elsewhere on the board
RDQS_N: U1.C4 (RDQS0_c_A); also elsewhere on the board
RDQS_P: U1.B3 (RDQS0_t_A); also elsewhere on the board
RESET_N: R402.2, R403.1, U1.H1 (RESET_n)
RESET_N_F: R402.1; also elsewhere on the board
VDD1: C421.1, C422.1, C423.1, C424.1, U1.C1 (VDD1), U1.C15 (VDD1), U1.W1 (VDD1), U1.W15 (VDD1); also elsewhere on the board
VDD2H: C401.1, C402.1, C403.1, C404.1, C405.1, C406.1, C407.1, C408.1, C409.1, C410.1, C411.1, C412.1, U1.A6 (VDD2L), U1.A7 (VDD2H), U1.A8 (VDD2H), U1.A9 (VDD2H), U1.A10 (VDD2L), U1.AA6 (VDD2L), U1.AA7 (VDD2H), U1.AA8 (VDD2H), U1.AA9 (VDD2H), U1.AA10 (VDD2L), U1.B6 (VDD2L), U1.B7 (VDD2H), U1.B9 (VDD2H), U1.B10 (VDD2L), U1.C7 (VDD2H), U1.C9 (VDD2H), U1.D8 (VDD2H), U1.E7 (VDD2H), U1.E9 (VDD2H), U1.F6 (VDD2H), U1.F7 (VDD2H), U1.F9 (VDD2H), U1.F10 (VDD2H), U1.H2 (VDD2L), U1.H14 (VDD2L), U1.J2 (VDD2L), U1.J5 (VDD2H), U1.J11 (VDD2H), U1.J14 (VDD2L), U1.K1 (VDD2H), U1.K2 (VDD2H), U1.K3 (VDD2H), U1.K4 (VDD2H), U1.K5 (VDD2H), U1.K6 (VDD2H), U1.K10 (VDD2H), U1.K11 (VDD2H), U1.K12 (VDD2H), U1.K13 (VDD2H), U1.K14 (VDD2H), U1.K15 (VDD2H), U1.L6 (VDD2H), U1.L7 (VDD2H), U1.L8 (VDD2H), U1.L9 (VDD2H), U1.L10 (VDD2H), U1.M1 (VDD2H), U1.M2 (VDD2H), U1.M3 (VDD2H), U1.M4 (VDD2H), U1.M5 (VDD2H), U1.M6 (VDD2H), U1.M10 (VDD2H), U1.M11 (VDD2H), U1.M12 (VDD2H), U1.M13 (VDD2H), U1.M14 (VDD2H), U1.M15 (VDD2H), U1.N2 (VDD2L), U1.N5 (VDD2H), U1.N11 (VDD2H), U1.N14 (VDD2L), U1.P2 (VDD2L), U1.P14 (VDD2L), U1.T6 (VDD2H), U1.T7 (VDD2H), U1.T9 (VDD2H), U1.T10 (VDD2H), U1.U7 (VDD2H), U1.U9 (VDD2H), U1.V8 (VDD2H), U1.W7 (VDD2H), U1.W9 (VDD2H), U1.Y6 (VDD2L), U1.Y7 (VDD2H), U1.Y9 (VDD2H), U1.Y10 (VDD2L); also elsewhere on the board
VDDQ: C413.1, C414.1, C415.1, C416.1, C417.1, C418.1, C419.1, C420.1, R401.2, R405.2, U1.A3 (VDDQ), U1.A13 (VDDQ), U1.AA3 (VDDQ), U1.AA13 (VDDQ), U1.B2 (VDDQ), U1.B14 (VDDQ), U1.C3 (VDDQ), U1.C13 (VDDQ), U1.D4 (VDDQ), U1.D12 (VDDQ), U1.E5 (VDDQ), U1.E11 (VDDQ), U1.F1 (VDDQ), U1.F3 (VDDQ), U1.F4 (VDDQ), U1.F12 (VDDQ), U1.F13 (VDDQ), U1.F15 (VDDQ), U1.G1 (VDDQ), U1.G2 (VDDQ), U1.G14 (VDDQ), U1.G15 (VDDQ), U1.N7 (CK_c_B), U1.R1 (VDDQ), U1.R2 (VDDQ), U1.R14 (VDDQ), U1.R15 (VDDQ), U1.T1 (VDDQ), U1.T3 (VDDQ), U1.T4 (VDDQ), U1.T12 (VDDQ), U1.T13 (VDDQ), U1.T15 (VDDQ), U1.U5 (VDDQ), U1.U11 (VDDQ), U1.V4 (VDDQ), U1.V5 (WCK1_c_B), U1.V11 (WCK0_c_B), U1.V12 (VDDQ), U1.W3 (VDDQ), U1.W13 (VDDQ), U1.Y2 (VDDQ), U1.Y14 (VDDQ); also elsewhere on the board
WCK1_C: R405.1, U1.D11 (WCK1_c_A)
WCK1_T: R404.1, U1.E12 (WCK1_t_A)
WCK_N: U1.D5 (WCK0_c_A); also elsewhere on the board
WCK_P: U1.E4 (WCK0_t_A); also elsewhere on the board
ZQ: R401.1, U1.H15 (ZQ_A)

Notes on the sheet:
CS1_A, DMI0_A, DMI1_A strapped to the adjacent VSS ball on F.Cu. DMI: READ FIFO, read DBI, link ECC and read data copy must stay off. DQ8-15_A and RDQS1_t/c_A open (unused byte: no pull-downs, DESIGN.md section 5).
VDD2L = VDD2H (single rail, MR13 OP[7] = 1)
RESET_n: finger 232 (AP11), 100 R + 1 k: 0.96 / 1.03 / 1.12 V
SK hynix H58G56BK7BX068N (JEDEC 315-ball 2CHx32 ball map). Channel B and the upper byte of channel A are tied off or left open as listed below.
Unused WCK1: static low / high (clock stop level)
ZQ: 240 R 1 % to VDDQ
Decoupling on B.Cu under U1, on the via-in-pad supply balls
Channel B: inputs strapped to the adjacent VSS / VDDQ ball (CK_c_B through its via-in-pad), DQ / DMI / RDQS open.
U1: LPDDR5 SDRAM, channel A / byte 0 / rank 0 in use
