fingoldin/lpddr5-testbed/lpddr5-testbed.kicad_pcb

## KiCad design lpddr5-testbed.kicad_pcb (continued)

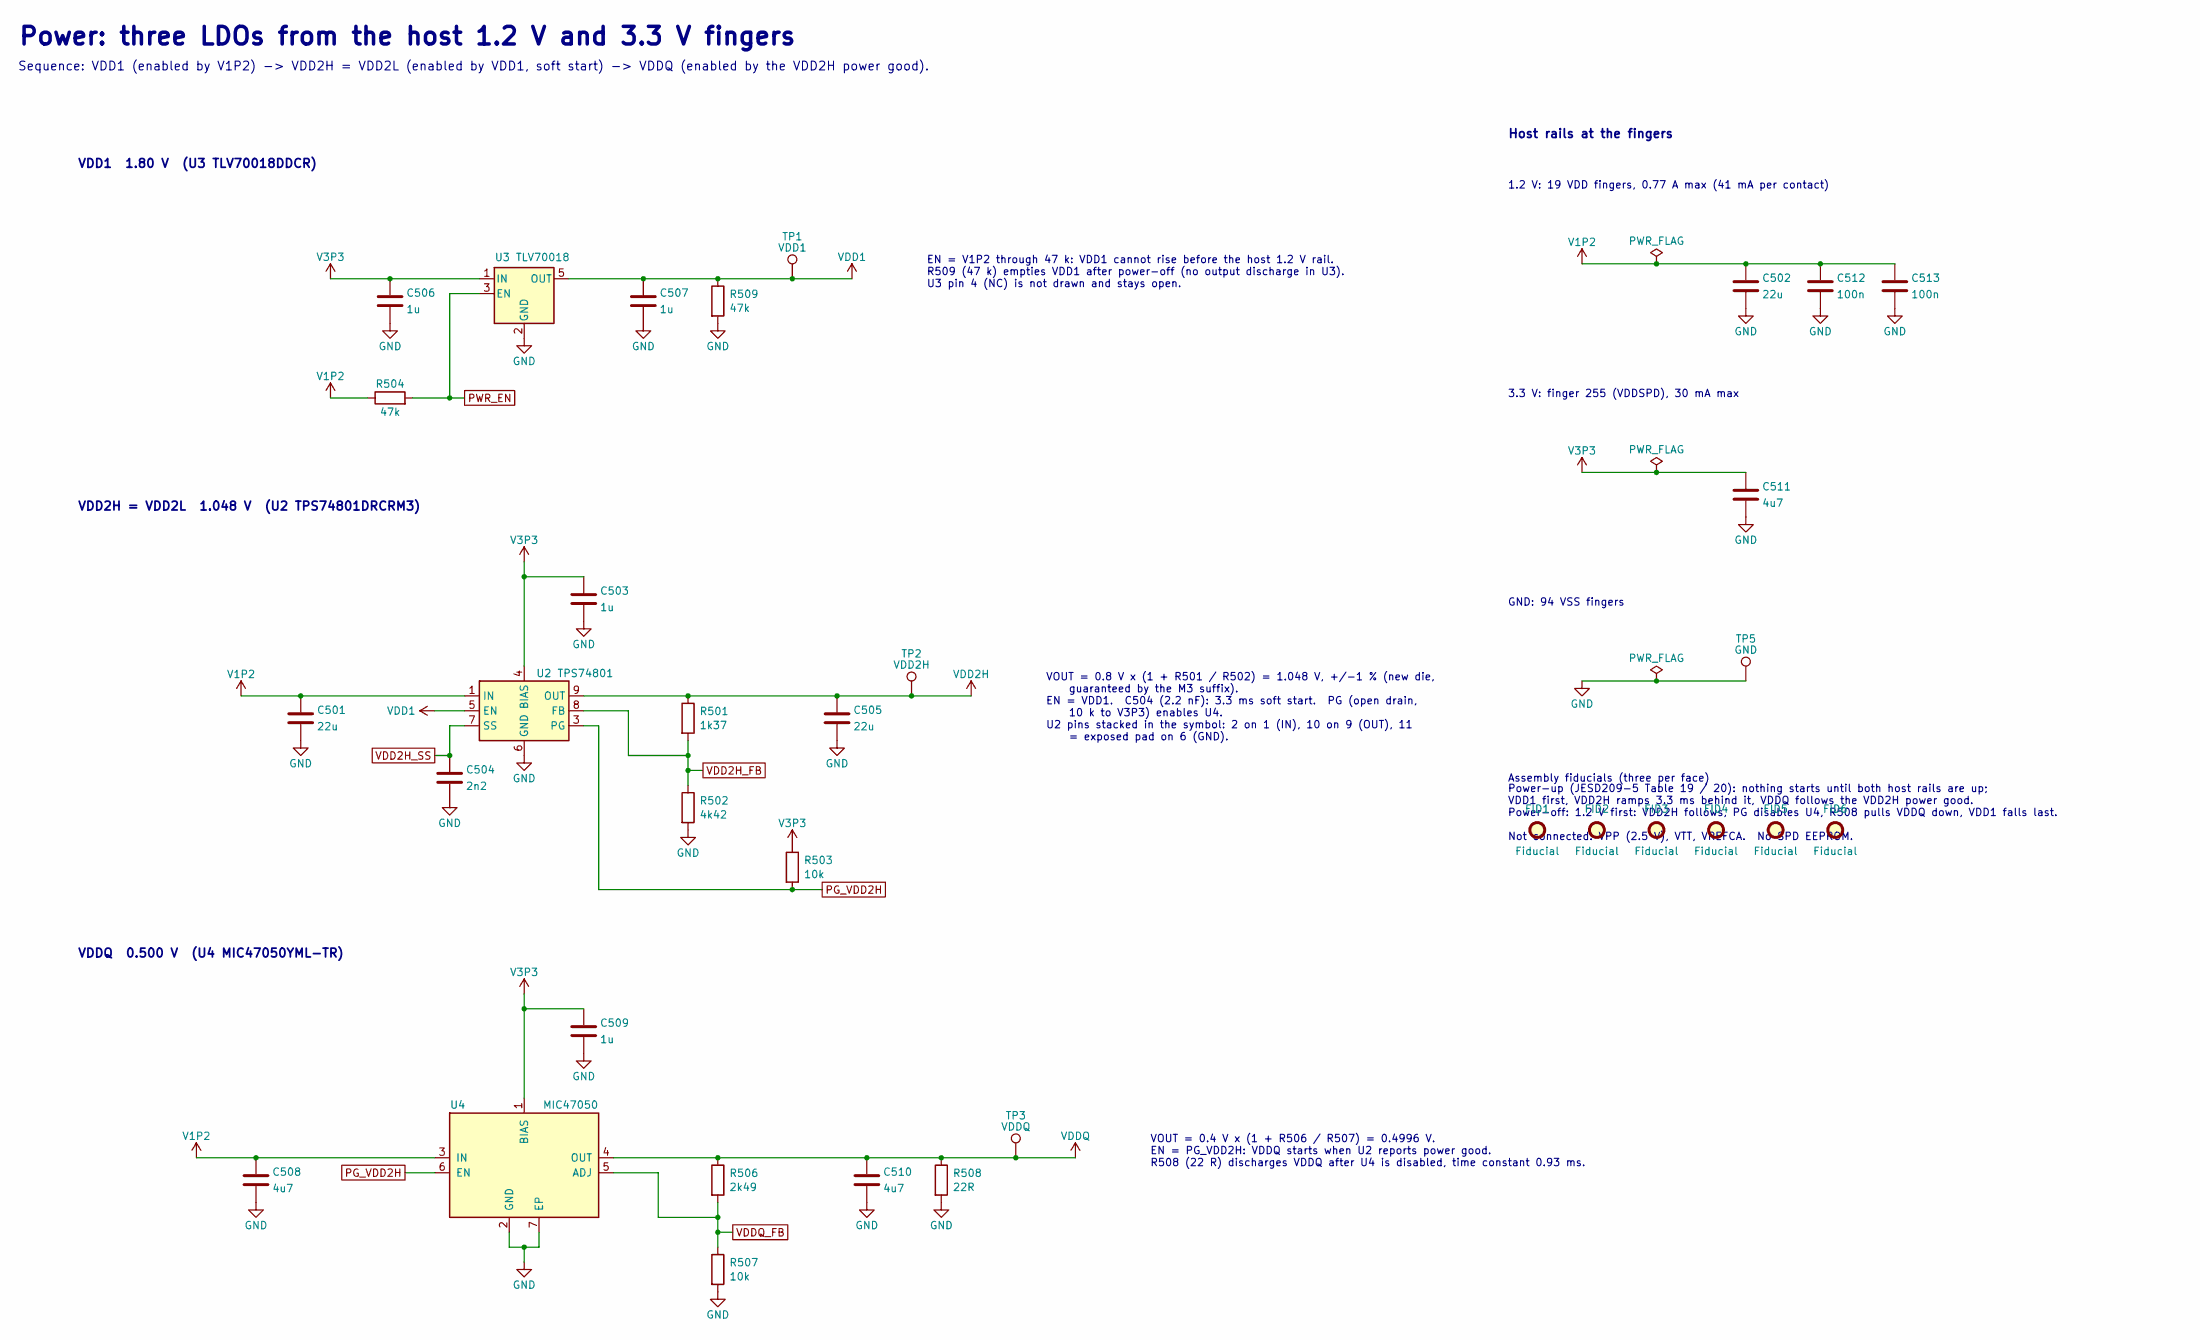
[picture p34: schematic power.kicad_sch, LPDDR5 testbed for ZCU104]

Parts:
C501, C502, C505: 22u; C_0603_1608Metric; MPN CL10A226MQ8NRNC
C503, C506, C507, C509: 1u; C_0402_1005Metric; MPN CL05A105KP5NNNC
C504: 2n2; C_0402_1005Metric; MPN CL05B222KB5NNNC
C508, C510, C511: 4u7; C_0402_1005Metric; MPN CL05A475MP5NRNC
C512, C513: 100n; C_0402_1005Metric; MPN CL05B104KO5NNNC
FID1, FID2, FID3, FID4, FID5, FID6: Fiducial; Fiducial_1mm_Mask2mm; MPN N/A (PCB feature)
R501: 1k37; R_0402_1005Metric; MPN RC0402FR-071K37L
R502: 4k42; R_0402_1005Metric; MPN RC0402FR-074K42L
R503, R507: 10k; R_0402_1005Metric; MPN RC0402FR-0710KL
R504, R509: 47k; R_0402_1005Metric; MPN RC0402FR-0747KL
R506: 2k49; R_0402_1005Metric; MPN RC0402FR-072K49L
R508: 22R; R_0201_0603Metric; MPN RC0201FR-0722RL
TP1: VDD1; TestPoint_Pad_D1.0mm; MPN N/A (PCB pad)
TP2: VDD2H; TestPoint_Pad_D1.0mm; MPN N/A (PCB pad)
TP3: VDDQ; TestPoint_Pad_D1.0mm; MPN N/A (PCB pad)
TP5: GND; TestPoint_Pad_D1.0mm; MPN N/A (PCB pad)
U2: TPS74801; VSON-10-1EP_3x3mm_P0.5mm_EP1.65x2.4mm; MPN TPS74801DRCRM3
U3: TLV70018; TSOT-23-5; MPN TLV70018DDCR
U4: MIC47050; MLF-6-1EP_2x2mm_P0.65mm_EP0.8x1.4mm; MPN MIC47050YML-TR

Connections:
GND: C501.2, C502.2, C503.2, C504.2, C505.2, C506.2, C507.2, C508.2, C509.2, C510.2, C511.2, C512.2, C513.2, R502.2, R507.2, R508.2, R509.2, TP5.1, U2.6 (GND), U2.11 (GND), U3.2 (GND), U4.2 (GND), U4.7 (EP); also elsewhere on the board
PG_VDD2H: R503.2, U2.3 (PG), U4.6 (EN)
PWR_EN: R504.2, U3.3 (EN)
V1P2: C501.1, C502.1, C508.1, C512.1, C513.1, R504.1, U2.1 (IN), U2.2 (IN), U4.3 (IN); also elsewhere on the board
V3P3: C503.1, C506.1, C509.1, C511.1, R503.1, U2.4 (BIAS), U3.1 (IN), U4.1 (BIAS); also elsewhere on the board
VDD1: C507.1, R509.1, TP1.1, U2.5 (EN), U3.5 (OUT); also elsewhere on the board
VDD2H: C505.1, R501.1, TP2.1, U2.9 (OUT), U2.10 (OUT); also elsewhere on the board
VDD2H_FB: R501.2, R502.1, U2.8 (FB)
VDD2H_SS: C504.1, U2.7 (SS)
VDDQ: C510.1, R506.1, R508.1, TP3.1, U4.4 (OUT); also elsewhere on the board
VDDQ_FB: R506.2, R507.1, U4.5 (ADJ)

Notes on the sheet:
3.3 V: finger 255 (VDDSPD), 30 mA max
VDDQ 0.500 V (U4 MIC47050YML-TR)
1.2 V: 19 VDD fingers, 0.77 A max (41 mA per contact)
Assembly fiducials (three per face)
GND: 94 VSS fingers
VDD1 1.80 V (U3 TLV70018DDCR)
Power-up (JESD209-5 Table 19 / 20): nothing starts until both host rails are up; VDD1 first, VDD2H ramps 3.3 ms behind it, VDDQ follows the VDD2H power good. Power-off: 1.2 V first: VDD2H follows, PG disables U4, R508 pulls VDDQ down, VDD1 falls last. Not connected: VPP (2.5 V), VTT, VREFCA. No SPD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
Sequence: VDD1 (enabled by V1P2) -> VDD2H = VDD2L (enabled by VDD1, soft start) -> VDDQ (enabled by the VDD2H power good).
VOUT = 0.4 V x (1 + R506 / R507) = 0.4996 V. EN = PG_VDD2H: VDDQ starts when U2 reports power good. R508 (22 R) discharges VDDQ after U4 is disabled, time constant 0.93 ms.
VDD2H = VDD2L 1.048 V (U2 TPS74801DRCRM3)
VOUT = 0.8 V x (1 + R501 / R502) = 1.048 V, +/-1 % (new die, guaranteed by the M3 suffix). EN = VDD1. C504 (2.2 nF): 3.3 ms soft start. PG (open drain, 10 k to V3P3) enables U4. U2 pins stacked in the symbol: 2 on 1 (IN), 10 on 9 (OUT), 11 = exposed pad on 6 (GND).
EN = V1P2 through 47 k: VDD1 cannot rise before the host 1.2 V rail. R509 (47 k) empties VDD1 after power-off (no output discharge in U3). U3 pin 4 (NC) is not drawn and stays open.
Power: three LDOs from the host 1.2 V and 3.3 V fingers
Host rails at the fingers

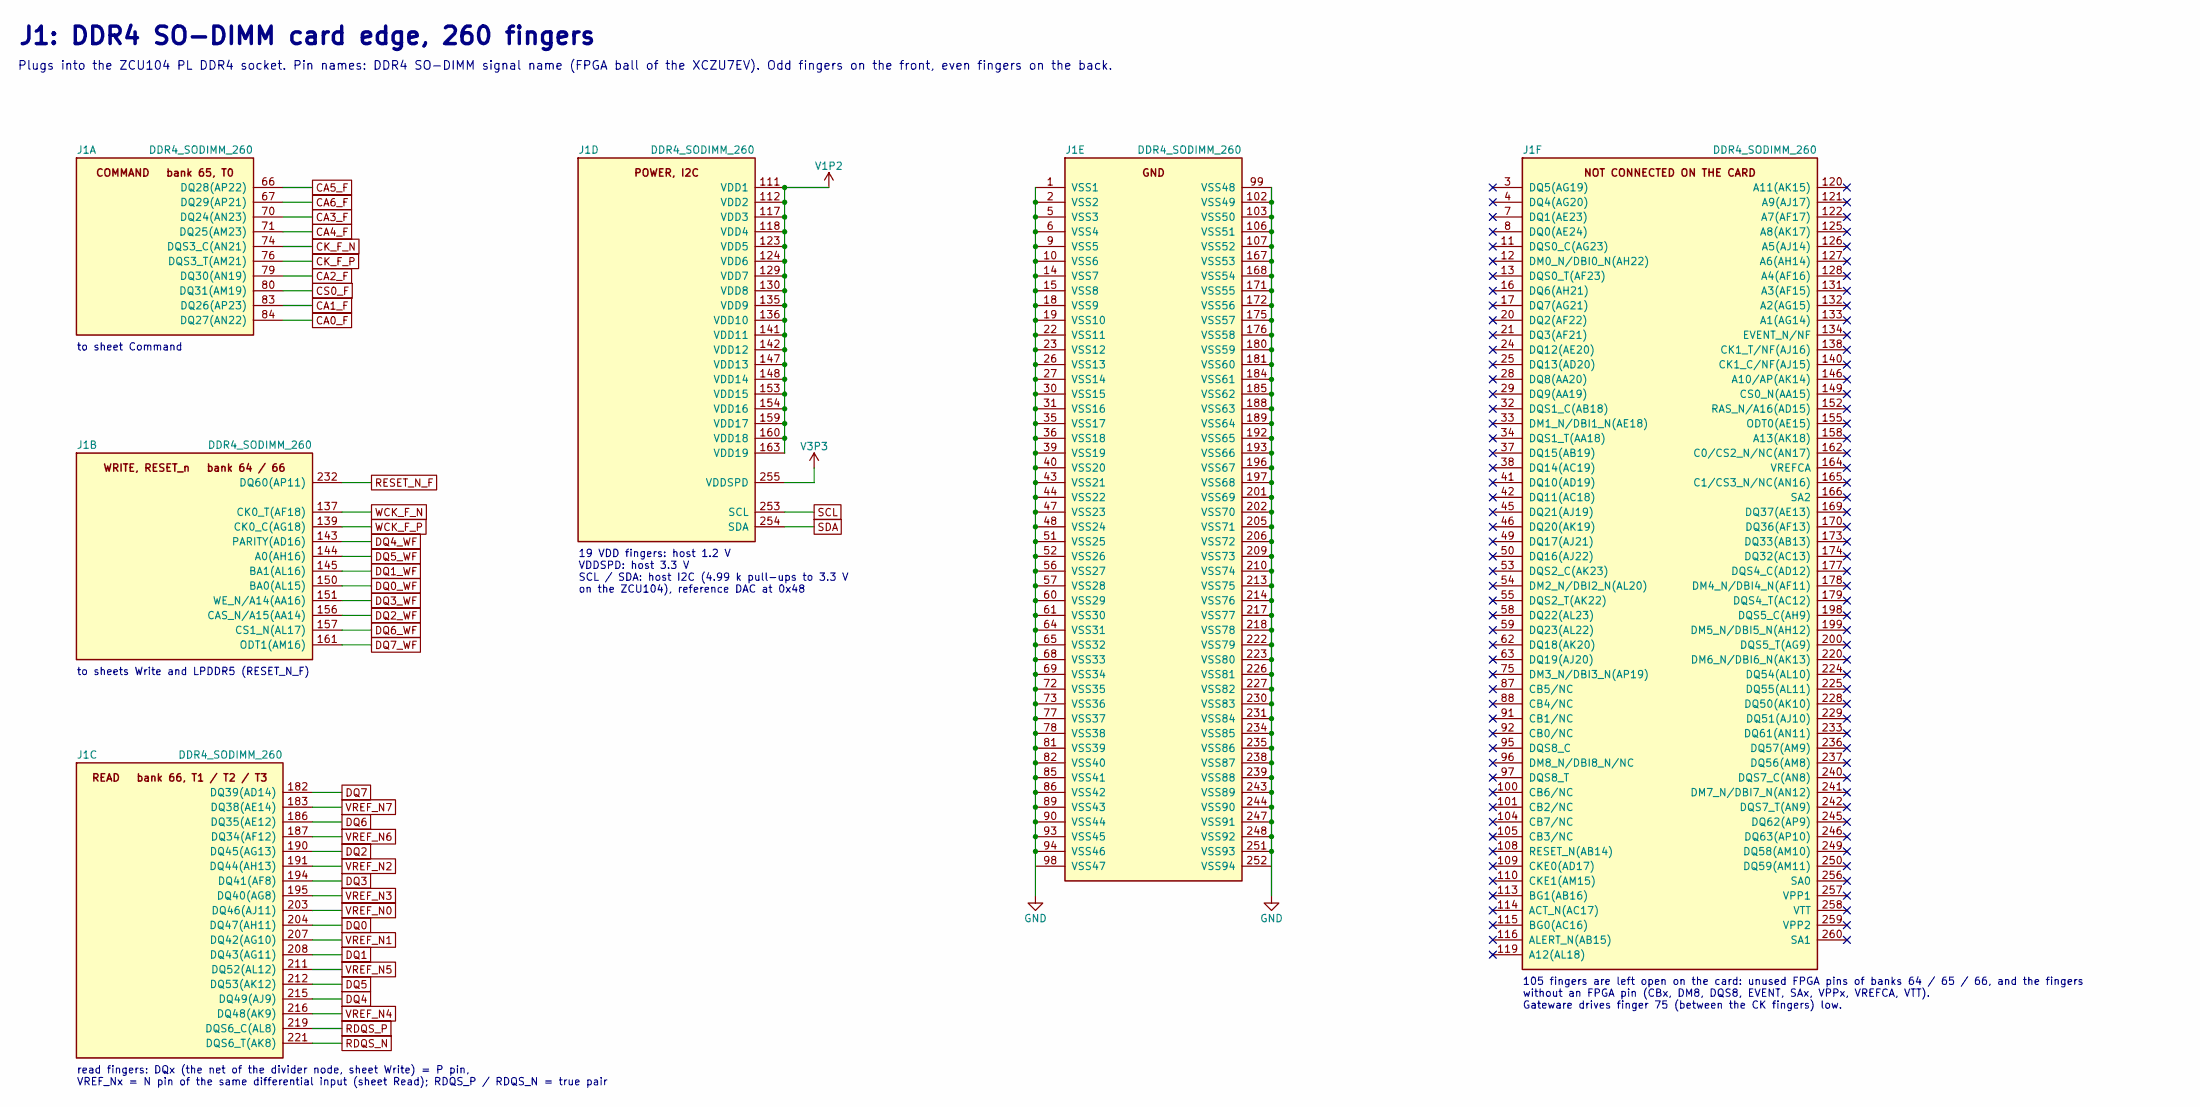
[picture p35: schematic connector.kicad_sch, LPDDR5 testbed for ZCU104]

Parts:
J1: DDR4_SODIMM_260; DDR4_SODIMM_260_Edge; MPN N/A (card edge, hard-gold fingers)

Connections:
CA0_F: J1.84 (DQ27(AN22)); also elsewhere on the board
CA1_F: J1.83 (DQ26(AP23)); also elsewhere on the board
CA2_F: J1.79 (DQ30(AN19)); also elsewhere on the board
CA3_F: J1.70 (DQ24(AN23)); also elsewhere on the board
CA4_F: J1.71 (DQ25(AM23)); also elsewhere on the board
CA5_F: J1.66 (DQ28(AP22)); also elsewhere on the board
CA6_F: J1.67 (DQ29(AP21)); also elsewhere on the board
CK_F_N: J1.74 (DQS3_C(AN21)); also elsewhere on the board
CK_F_P: J1.76 (DQS3_T(AM21)); also elsewhere on the board
CS0_F: J1.80 (DQ31(AM19)); also elsewhere on the board
DQ0: J1.204 (DQ47(AH11)); also elsewhere on the board
DQ0_WF: J1.150 (BA0(AL15)); also elsewhere on the board
DQ1: J1.208 (DQ43(AG11)); also elsewhere on the board
DQ1_WF: J1.145 (BA1(AL16)); also elsewhere on the board
DQ2: J1.190 (DQ45(AG13)); also elsewhere on the board
DQ2_WF: J1.156 (CAS_N/A15(AA14)); also elsewhere on the board
DQ3: J1.194 (DQ41(AF8)); also elsewhere on the board
DQ3_WF: J1.151 (WE_N/A14(AA16)); also elsewhere on the board
DQ4: J1.215 (DQ49(AJ9)); also elsewhere on the board
DQ4_WF: J1.143 (PARITY(AD16)); also elsewhere on the board
DQ5: J1.212 (DQ53(AK12)); also elsewhere on the board
DQ5_WF: J1.144 (A0(AH16)); also elsewhere on the board
DQ6: J1.186 (DQ35(AE12)); also elsewhere on the board
DQ6_WF: J1.157 (CS1_N(AL17)); also elsewhere on the board
DQ7: J1.182 (DQ39(AD14)); also elsewhere on the board
DQ7_WF: J1.161 (ODT1(AM16)); also elsewhere on the board
GND: J1.1 (VSS1), J1.2 (VSS2), J1.5 (VSS3), J1.6 (VSS4), J1.9 (VSS5), J1.10 (VSS6), J1.14 (VSS7), J1.15 (VSS8), J1.18 (VSS9), J1.19 (VSS10), J1.22 (VSS11), J1.23 (VSS12), J1.26 (VSS13), J1.27 (VSS14), J1.30 (VSS15), J1.31 (VSS16), J1.35 (VSS17), J1.36 (VSS18), J1.39 (VSS19), J1.40 (VSS20), J1.43 (VSS21), J1.44 (VSS22), J1.47 (VSS23), J1.48 (VSS24), J1.51 (VSS25), J1.52 (VSS26), J1.56 (VSS27), J1.57 (VSS28), J1.60 (VSS29), J1.61 (VSS30), J1.64 (VSS31), J1.65 (VSS32), J1.68 (VSS33), J1.69 (VSS34), J1.72 (VSS35), J1.73 (VSS36), J1.77 (VSS37), J1.78 (VSS38), J1.81 (VSS39), J1.82 (VSS40), J1.85 (VSS41), J1.86 (VSS42), J1.89 (VSS43), J1.90 (VSS44), J1.93 (VSS45), J1.94 (VSS46), J1.98 (VSS47), J1.99 (VSS48), J1.102 (VSS49), J1.103 (VSS50), J1.106 (VSS51), J1.107 (VSS52), J1.167 (VSS53), J1.168 (VSS54), J1.171 (VSS55), J1.172 (VSS56), J1.175 (VSS57), J1.176 (VSS58), J1.180 (VSS59), J1.181 (VSS60), J1.184 (VSS61), J1.185 (VSS62), J1.188 (VSS63), J1.189 (VSS64), J1.192 (VSS65), J1.193 (VSS66), J1.196 (VSS67), J1.197 (VSS68), J1.201 (VSS69), J1.202 (VSS70), J1.205 (VSS71), J1.206 (VSS72), J1.209 (VSS73), J1.210 (VSS74), J1.213 (VSS75), J1.214 (VSS76), J1.217 (VSS77), J1.218 (VSS78), J1.222 (VSS79), J1.223 (VSS80), J1.226 (VSS81), J1.227 (VSS82), J1.230 (VSS83), J1.231 (VSS84), J1.234 (VSS85), J1.235 (VSS86), J1.238 (VSS87), J1.239 (VSS88), J1.243 (VSS89), J1.244 (VSS90), J1.247 (VSS91), J1.248 (VSS92), J1.251 (VSS93), J1.252 (VSS94); also elsewhere on the board
RDQS_N: J1.221 (DQS6_T(AK8)); also elsewhere on the board
RDQS_P: J1.219 (DQS6_C(AL8)); also elsewhere on the board
RESET_N_F: J1.232 (DQ60(AP11)); also elsewhere on the board
SCL: J1.253 (SCL); also elsewhere on the board
SDA: J1.254 (SDA); also elsewhere on the board
V1P2: J1.111 (VDD1), J1.112 (VDD2), J1.117 (VDD3), J1.118 (VDD4), J1.123 (VDD5), J1.124 (VDD6), J1.129 (VDD7), J1.130 (VDD8), J1.135 (VDD9), J1.136 (VDD10), J1.141 (VDD11), J1.142 (VDD12), J1.147 (VDD13), J1.148 (VDD14), J1.153 (VDD15), J1.154 (VDD16), J1.159 (VDD17), J1.160 (VDD18), J1.163 (VDD19); also elsewhere on the board
V3P3: J1.255 (VDDSPD); also elsewhere on the board
VREF_N0: J1.203 (DQ46(AJ11)); also elsewhere on the board
VREF_N1: J1.207 (DQ42(AG10)); also elsewhere on the board
VREF_N2: J1.191 (DQ44(AH13)); also elsewhere on the board
VREF_N3: J1.195 (DQ40(AG8)); also elsewhere on the board
VREF_N4: J1.216 (DQ48(AK9)); also elsewhere on the board
VREF_N5: J1.211 (DQ52(AL12)); also elsewhere on the board
VREF_N6: J1.187 (DQ34(AF12)); also elsewhere on the board
VREF_N7: J1.183 (DQ38(AE14)); also elsewhere on the board
WCK_F_N: J1.137 (CK0_T(AF18)); also elsewhere on the board
WCK_F_P: J1.139 (CK0_C(AG18)); also elsewhere on the board

Notes on the sheet:
to sheet Command
105 fingers are left open on the card: unused FPGA pins of banks 64 / 65 / 66, and the fingers without an FPGA pin (CBx, DM8, DQS8, EVENT, SAx, VPPx, VREFCA, VTT). Gateware drives finger 75 (between the CK fingers) low.
read fingers: DQx (the net of the divider node, sheet Write) = P pin, VREF_Nx = N pin of the same differential input (sheet Read); RDQS_P / RDQS_N = true pair
19 VDD fingers: host 1.2 V VDDSPD: host 3.3 V SCL / SDA: host I2C (4.99 k pull-ups to 3.3 V on the ZCU104), reference DAC at 0x48
to sheets Write and LPDDR5 (RESET_N_F)
Plugs into the ZCU104 PL DDR4 socket. Pin names: DDR4 SO-DIMM signal name (FPGA ball of the XCZU7EV). Odd fingers on the front, even fingers on the back.
J1: DDR4 SO-DIMM card edge, 260 fingers

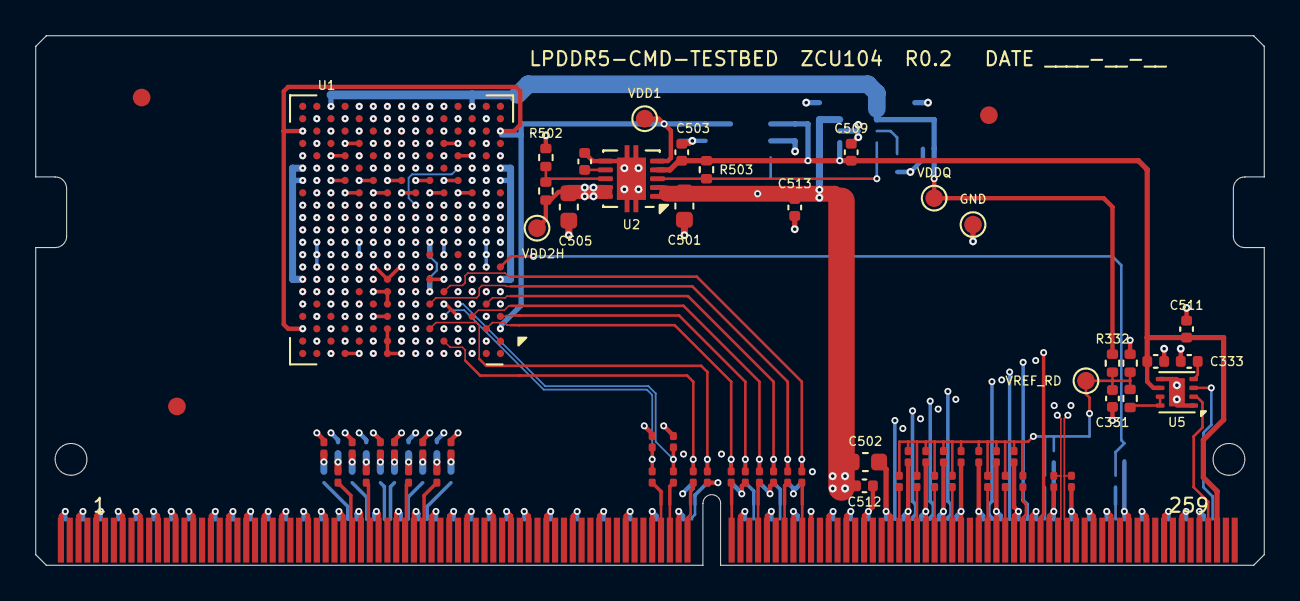
[picture p36: board lpddr5-testbed.kicad_pcb from above]

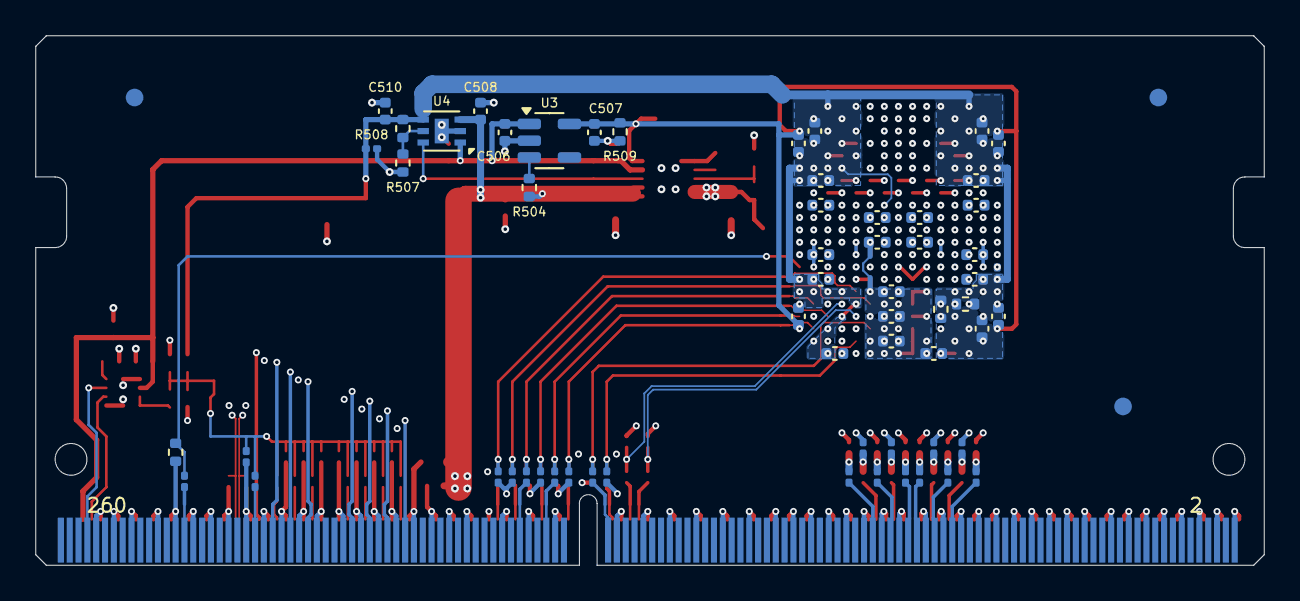
[picture p37: board lpddr5-testbed.kicad_pcb from below]

Board: 6 copper layers, 69.6 x 30.0 mm, 131 parts (63 on the bottom side), 71 nets.
