fingoldin/lpddr5-testbed/references/sodimm_module/antmicro_lpddr4-testbed/lpddr4-testbed.kicad_pcb

## KiCad design references/sodimm_module/antmicro_lpddr4-testbed/lpddr4-testbed.kicad_pcb (2026-11-10)

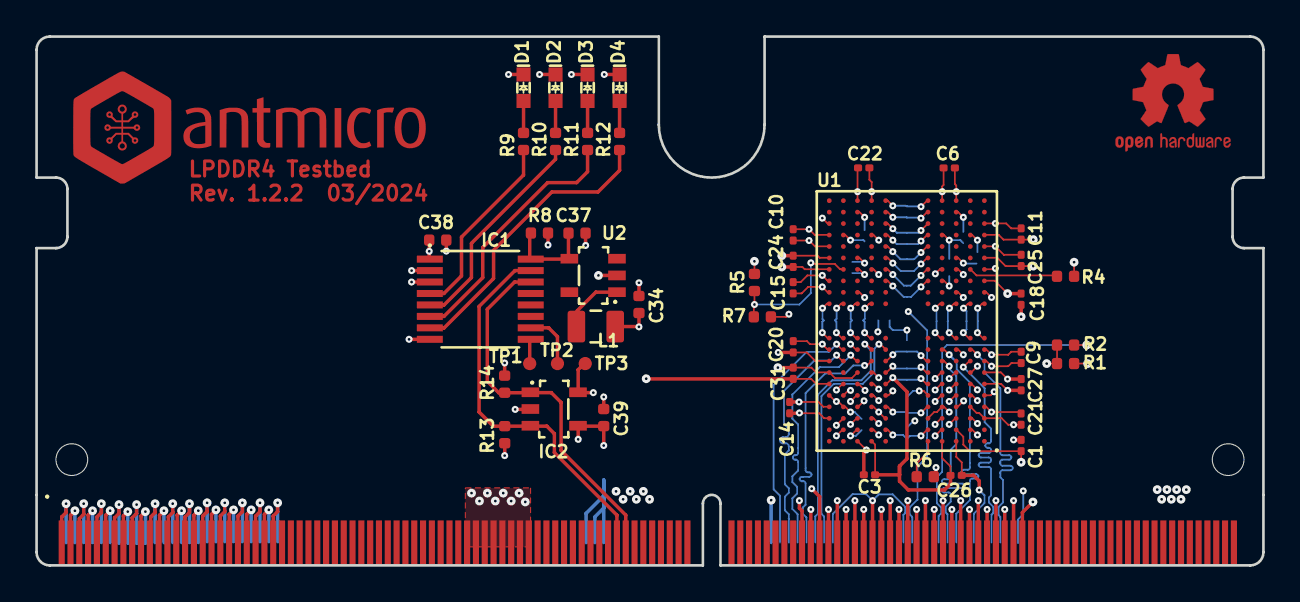
[picture p38: board lpddr4-testbed.kicad_pcb from above]

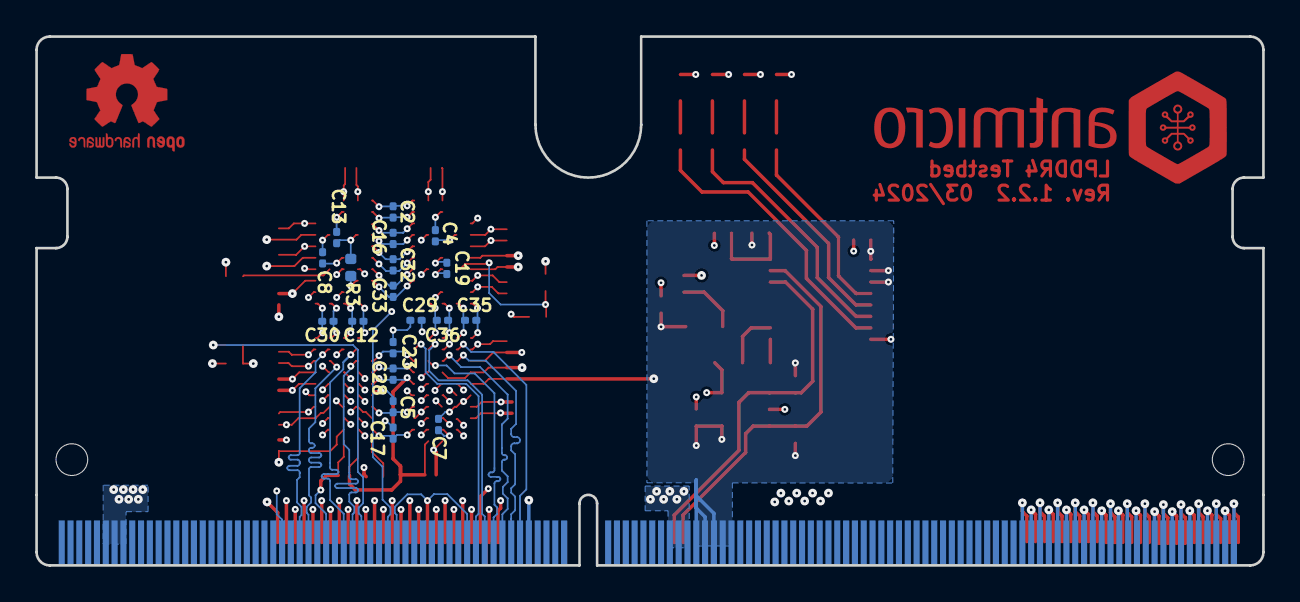
[picture p39: board lpddr4-testbed.kicad_pcb from below]

Board: 6 copper layers, 69.6 x 30.0 mm, 66 parts (19 on the bottom side), 57 nets.

Parts:
C1, C2, C3, C4, C5, C6, C7, C8, C9, C10, C11, C12, C13, C14, C15, C16, C17, C18, C19, C20, C21, C22, C23, C24, C25, C26, C27, C28, C29, C30, C31, C32, C33, C35, C36: C_100n_0201; C_0201
C34, C37: C_4u7_0402; C_0402_1005Metric
C38, C39: C_100n_0402; C_0402_1005Metric
D1, D2, D3, D4: LED_G_0603_KP-1608CGCK; LED_0603_1608Metric_G
IC1: PCA6408A_TSSOP; TSSOP-16_4.4x5mm_P0.65mm
IC2: AT24CS01_SOT23; SOT-23-5
J1: Bus_DDR4_Edge_Conn; Edge_Conn_Bus_DDR4
L1: L_2u2_1.5A_1285AS-H; L_0806_2016Metric
R1, R3, R4, R5, R13, R14: R_10k_0402; R_0402_1005Metric
R2, R7, R8: R_0R_0402; R_0402_1005Metric
R6: R_240R_0402; R_0402_1005Metric
R9, R10, R11, R12: R_220R_0402; R_0402_1005Metric
TP1, TP2, TP3: TP_0.75mm_SMD; TP_SMD_0.75mm
U1: MT53E1G32D2NP-046; BGA-264-200_10x14.5mm_Layout12x22_P0.8x0.65mm
U2: TPS613221A_SOT-23-5; SOT-23-5

Connections:
CA0_A: J1.204, U1.H2 (CA0_A)
CA1_A: J1.206, U1.J2 (CA1_A)
CA2_A: J1.162, U1.H9 (CA2_A)
CA3_A: J1.160, U1.H10 (CA3_A)
CA4_A: J1.158, U1.H11 (CA4_A)
CA5_A: J1.156, U1.J11 (CA5_A)
CKE0_A: J1.196, U1.J4 (CKE0_A)
CK_C_A: J1.164, U1.J9 (CK_C_A)
CK_T_A: J1.166, U1.J8 (CK_T_A)
CS0_A: J1.194, U1.H4 (CS0_A)
CS0_B: R3.1, U1.R4 (CS0_B)
DMI_0A: J1.197, U1.C3 (DMI0_A)
DMI_1A: J1.171, U1.C10 (DMI1_A)
DQ00_A: J1.203, U1.B2 (DQ0_A)
DQ01_A: J1.205, U1.C2 (DQ1_A)
DQ02_A: J1.207, U1.E2 (DQ2_A)
DQ03_A: J1.209, U1.F2 (DQ3_A)
DQ04_A: J1.187, U1.F4 (DQ4_A)
DQ05_A: J1.189, U1.E4 (DQ5_A)
DQ06_A: J1.191, U1.C4 (DQ6_A)
DQ07_A: J1.193, U1.B4 (DQ7_A)
DQ08_A: J1.169, U1.B11 (DQ8_A)
DQ09_A: J1.167, U1.C11 (DQ9_A)
DQ10_A: J1.165, U1.E11 (DQ10_A)
DQ11_A: J1.163, U1.F11 (DQ11_A)
DQ12_A: J1.185, U1.F9 (DQ12_A)
DQ13_A: J1.183, U1.E9 (DQ13_A)
DQ14_A: J1.181, U1.C9 (DQ14_A)
DQ15_A: J1.179, U1.B9 (DQ15_A)
DQ_S0_CA: J1.199, U1.E3 (DQS0_C_A)
DQ_S0_TA: J1.201, U1.D3 (DQS0_T_A)
DQ_S1_CA: J1.173, U1.E10 (DQS1_C_A)
DQ_S1_TA: J1.175, U1.D10 (DQS1_T_A)
GND: C1.1, C2.1, C3.1, C4.1, C5.1, C6.1, C7.1, C8.1, C9.1, C10.1, C11.1, C12.1, C13.1, C14.1, C15.1, C16.1, C17.1, C18.1, C19.1, C20.1, C21.1, C22.1, C23.1, C24.1, C25.1, C26.1, C27.1, C28.1, C29.1, C30.1, C31.1, C32.1, C33.1, C34.1, C35.1, C36.1, C37.1, C38.1, C39.1, D1.2, D2.2, D3.2, D4.2, IC1.8 (GND), IC2.2 (GND), IC2.5 (WP), J1.1, J1.2, J1.3, J1.4, J1.5, J1.6, J1.7, J1.8, J1.9, J1.10, J1.11, J1.12, J1.13, J1.14, J1.15, J1.16, J1.17, J1.18, J1.19, J1.20, J1.21, J1.22, J1.23, J1.24, J1.25, J1.26, J1.27, J1.28, J1.29, J1.30, J1.31, J1.32, J1.33, J1.34, J1.35, J1.36, J1.37, J1.38, J1.39, J1.40, J1.41, J1.42, J1.43, J1.44, J1.45, J1.46, J1.47, J1.48, J1.49, J1.50, J1.154, J1.161, J1.168, J1.177, J1.184, J1.195, J1.200, J1.210, J1.211, R3.2, R6.2, TP3.1, U1.A3 (VSS), U1.A10 (VSS), U1.AB3 (VSS), U1.AB5 (VSS), U1.AB8 (VSS), U1.AB10 (VSS), U1.C1 (VSS), U1.C5 (VSS), U1.C8 (VSS), U1.C12 (VSS), U1.D2 (VSS), U1.D4 (VSS), U1.D9 (VSS), U1.D11 (VSS), U1.E1 (VSS), U1.E5 (VSS), U1.E8 (VSS), U1.E12 (VSS), U1.G1 (VSS), U1.G3 (VSS), U1.G5 (VSS), U1.G8 (VSS), U1.G10 (VSS), U1.G12 (VSS), U1.J1 (VSS), U1.J3 (VSS), U1.J10 (VSS), U1.J12 (VSS), U1.K2 (VSS), U1.K4 (VSS), U1.K9 (VSS), U1.K11 (VSS), U1.N2 (VSS), U1.N4 (VSS), U1.N9 (VSS), U1.N11 (VSS), U1.P1 (VSS), U1.P3 (VSS), U1.P10 (VSS), U1.P12 (VSS), U1.T1 (VSS), U1.T3 (VSS), U1.T5 (VSS), U1.T8 (VSS), U1.T10 (VSS), U1.T12 (VSS), U1.V1 (VSS), U1.V5 (VSS), U1.V8 (VSS), U1.V12 (VSS), U1.W2 (VSS), U1.W4 (VSS), U1.W9 (VSS), U1.W11 (VSS), U1.Y1 (VSS), U1.Y5 (VSS), U1.Y8 (VSS), U1.Y12 (VSS), U2.2 (GND)
unnamed: D1.1, R9.2
unnamed: D2.1, R10.2
unnamed: D3.1, R11.2
unnamed: D4.1, R12.2
unnamed: IC1.4 (P0), R9.1
unnamed: IC1.5 (P1), R10.1
unnamed: IC1.6 (P2), R11.1
unnamed: IC1.7 (P3), R12.1
unnamed: IC1.9 (P4), TP1.1
unnamed: IC1.10 (P5), TP2.1
unnamed: R1.2, R2.1, U1.G2 (ODT_CA_A)
unnamed: R5.2, R7.1, U1.T11 (RESET_N)
unnamed: R6.1, U1.A5 (ZQ0)
unnamed: R4.2, U1.T2 (ODT_CA_B)
unnamed: L1.2, U2.1 (SW)
ODT_CA_A: J1.192, R2.2
RESET_N: J1.186, R7.2
SCL: IC1.14 (SCL), IC2.1 (SCL), J1.129, R14.2
SDA: IC1.15 (SDA), IC2.3 (SDA), J1.127, R13.2
VDD1: C24.2, C25.2, C27.2, C29.2, C31.2, C34.2, C38.2, C39.2, IC1.1 (VDD(I2C)), IC1.2 (ADDR), IC1.3 (~RESET), IC2.4 (VCC), J1.116, J1.118, J1.120, J1.122, J1.124, L1.1, R8.1, R13.1, R14.1, U1.F1 (VDD1), U1.F12 (VDD1), U1.G4 (VDD1), U1.G9 (VDD1), U1.T4 (VDD1), U1.T9 (VDD1), U1.U1 (VDD1), U1.U12 (VDD1)
VDD2: C3.2, C6.2, C9.2, C12.2, C15.2, C18.2, C20.2, C22.2, C23.2, C26.2, C28.2, C30.2, C32.2, C33.2, C35.2, C36.2, J1.93, J1.95, J1.97, J1.99, J1.101, J1.103, J1.105, J1.107, U1.A4 (VDD2), U1.A9 (VDD2), U1.AB4 (VDD2), U1.AB9 (VDD2), U1.F5 (VDD2), U1.F8 (VDD2), U1.H1 (VDD2), U1.H5 (VDD2), U1.H8 (VDD2), U1.H12 (VDD2), U1.K1 (VDD2), U1.K3 (VDD2), U1.K10 (VDD2), U1.K12 (VDD2), U1.N1 (VDD2), U1.N3 (VDD2), U1.N10 (VDD2), U1.N12 (VDD2), U1.R1 (VDD2), U1.R5 (VDD2), U1.R8 (VDD2), U1.R12 (VDD2), U1.U5 (VDD2), U1.U8 (VDD2)
VDDLED: C37.2, IC1.16 (VDD(P)), R8.2, U2.4 (VOUT)
VDDQ: C1.2, C2.2, C4.2, C5.2, C7.2, C8.2, C10.2, C11.2, C13.2, C14.2, C16.2, C17.2, C19.2, C21.2, J1.126, J1.128, J1.130, J1.246, J1.248, J1.250, R1.1, R4.1, R5.1, U1.AA3 (VDDQ), U1.AA5 (VDDQ), U1.AA8 (VDDQ), U1.AA10 (VDDQ), U1.B3 (VDDQ), U1.B5 (VDDQ), U1.B8 (VDDQ), U1.B10 (VDDQ), U1.D1 (VDDQ), U1.D5 (VDDQ), U1.D8 (VDDQ), U1.D12 (VDDQ), U1.F3 (VDDQ), U1.F10 (VDDQ), U1.U3 (VDDQ), U1.U10 (VDDQ), U1.W1 (VDDQ), U1.W5 (VDDQ), U1.W8 (VDDQ), U1.W12 (VDDQ)
