fingoldin/lpddr5-testbed/scripts/make_fab.py

#!/usr/bin/env python3
"""Fabrication and assembly package of the board:  make_fab.py [--out fab] [--no-verify] [--no-step]

Everything is exported from lpddr5-testbed.kicad_pcb / the schematic as they stand (run scripts/pcb/build.sh first); the board file is
only read (its SHA-256 is taken before and after and written to fab/README.md).  No fab vendor is targeted: plain Gerber X2 + Excellon.

  fab/gerber/     Gerber X2: six copper layers, both masks, both pastes, both legends, the profile, the fabrication notes (User.Comments),
                  the mechanical drawing layer (User.Drawings), both assembly (Fab) layers; the Gerber job file
  fab/drill/      Excellon, plated and non-plated holes in separate files, drill map (PDF), drill report; the filled-and-capped vias as a
                  drill file and as a list; gerber_x2/: the same holes as Gerber X2 drill files with KiCad's filling / capping layers
  fab/netlist/    IPC-D-356 bare-board netlist
  fab/assembly/   pick-and-place per face, fiducials, BOM (grouped and per part), assembly drawings
  fab/drawings/   fabrication drawing (outline with dimensions, drill map and table, stackup, impedance, filled vias, notes), schematic
  fab/3d/         STEP model of the assembled card
  fab/verify/     written by scripts/check_fab.py: report and images of the Gerbers read back
  fab/README.md   every file, the order parameters, the conventions, the verification and DRC result

The origin of every coordinate file is the drill / place origin of the board = the lower-left corner of the card seen from the front
(pin-1 end of the finger edge), x to the right, y up, millimetres.
"""
import argparse
import csv
import datetime
import json
import math
import os
import shutil
import subprocess
import sys

import cairo
import gi
gi.require_version("Rsvg", "2.0")
from gi.repository import Rsvg      # noqa: E402

HERE = os.path.dirname(os.path.abspath(__file__))
ROOT = os.path.dirname(HERE)
sys.path.insert(0, HERE)
sys.path.insert(0, os.path.join(HERE, "pcb"))
import common as C          # noqa: E402
import pcbnew               # noqa: E402
import render as RENDER     # noqa: E402  (SVG export of single layers, recolouring)
import check_fab as V       # noqa: E402

PROJECT = C.PROJECT
SCH = os.path.join(ROOT, PROJECT + ".kicad_sch")
GERBER_LAYERS = ["F.Cu", "In1.Cu", "In2.Cu", "In3.Cu", "In4.Cu", "B.Cu", "F.Mask", "B.Mask", "F.Paste", "B.Paste",
                 "F.Silkscreen", "B.Silkscreen", "Edge.Cuts", "User.Comments", "User.Drawings", "F.Fab", "B.Fab"]
SUBDIRS = ["gerber", "drill", "netlist", "assembly", "drawings", "3d", "verify"]
MM = 72.0 / 25.4
A3 = (420.0, 297.0)


def kicad(*args):
    r = subprocess.run(["kicad-cli"] + list(args), cwd=ROOT, stdout=subprocess.PIPE, stderr=subprocess.PIPE, text=True)
    if r.returncode != 0:
        sys.stderr.write(r.stdout + r.stderr)
        raise RuntimeError("kicad-cli %s failed" % " ".join(args[:3]))
    return r.stdout


def log(msg):
    print("[make_fab] " + msg)
    sys.stdout.flush()


# ====================================================================================================== data files
def export_gerbers(out):
    kicad("pcb", "export", "gerbers", "-o", out + os.sep, "--layers", ",".join(GERBER_LAYERS), "--subtract-soldermask",
          "--use-drill-file-origin", "--no-protel-ext", "--precision", "6", C.BOARD)


def export_drill(out, B):
    kicad("pcb", "export", "drill", "-o", out + os.sep, "--format", "excellon", "--drill-origin", "plot", "--excellon-units", "mm",
          "--excellon-zeros-format", "decimal", "--excellon-separate-th", "--generate-map", "--map-format", "pdf",
          "--generate-report", "--report-path", os.path.join(out, "%s-drill_report.txt" % PROJECT), C.BOARD)
    x2 = os.path.join(out, "gerber_x2")
    os.makedirs(x2, exist_ok=True)
    kicad("pcb", "export", "drill", "-o", x2 + os.sep, "--format", "gerber", "--drill-origin", "plot", "--generate-tenting", C.BOARD)
    fixed = []
    for f in sorted(os.listdir(x2)):          # KiCad 10.0.6 writes "%TF,FileFunction" (a comma) in the filling / capping files: malformed X2
        p = os.path.join(x2, f)
        s = open(p).read()
        if "%TF,FileFunction" in s:
            open(p, "w").write(s.replace("%TF,FileFunction", "%TF.FileFunction"))
            fixed.append(f)
    # the filled-and-capped vias as their own Excellon file and as a list with the reason of each
    vias = [v for v in B.vias() if v["filled"] and v["capped"]]
    pads = []
    for fp in B.b.GetFootprints():
        for p in fp.Pads():
            if p.GetNumber() != "" and fp.GetReference() != "J1":
                pads.append((fp.GetReference(), p.GetNumber(), p))
    rows = []
    for v in sorted(vias, key=lambda v: (v["drill"], round(v["x"], 4), round(v["y"], 4))):
        pos = v["item"].GetPosition()
        hit = sorted("%s.%s" % (r, n) for r, n, p in pads if p.HitTest(pos))
        where = "in the land of " + " and ".join(hit) if hit else "command divider node via (0201 lands 0.05-0.10 mm from its pad)"
        rows.append({"x_mm": "%.3f" % v["x"], "y_mm": "%.3f" % v["y"], "drill_mm": "%.2f" % v["drill"], "pad_mm": "%.2f" % v["pad"],
                     "net": v["net"], "where": where})
    with open(os.path.join(out, "filled_capped_vias.csv"), "w", newline="") as fh:
        w = csv.DictWriter(fh, fieldnames=["x_mm", "y_mm", "drill_mm", "pad_mm", "net", "where"])
        w.writeheader()
        w.writerows(rows)
    tools = sorted({r["drill_mm"] for r in rows})
    with open(os.path.join(out, "%s-filled_capped.drl" % PROJECT), "w") as fh:
        fh.write("M48\n; Filled and capped vias (IPC-4761 type VII): a SUBSET of %s-PTH.drl, written by scripts/make_fab.py from the via attributes of the board\n" % PROJECT)
        fh.write("; FORMAT={-:-/ absolute / metric / decimal}\nFMAT,2\nMETRIC\n")
        for i, t in enumerate(tools):
            fh.write("T%dC%.3f\n" % (i + 1, float(t)))
        fh.write("%\nG90\nG05\n")
        for i, t in enumerate(tools):
            fh.write("T%d\n" % (i + 1))
            for r in rows:
                if r["drill_mm"] == t:
                    fh.write("X%sY%s\n" % (r["x_mm"], r["y_mm"]))
        fh.write("M30\n")
    return rows, fixed


def export_positions(out, B):
    for side, name in (("front", "top"), ("back", "bottom")):
        kicad("pcb", "export", "pos", "--side", side, "--format", "csv", "--units", "mm", "--use-drill-file-origin",
              "-o", os.path.join(out, "%s-%s.pos.csv" % (PROJECT, name)), C.BOARD)
    rows = []
    for fp in sorted(B.b.GetFootprints(), key=lambda f: f.GetReference()):
        if fp.GetReference().startswith("FID"):
            x, y = B.c(fp.GetPosition())
            rows.append({"Ref": fp.GetReference(), "PosX": "%.6f" % x, "PosY": "%.6f" % y, "Side": "bottom" if fp.IsFlipped() else "top",
                         "Copper_mm": "1.0", "Mask_opening_mm": "2.0"})
    with open(os.path.join(out, "%s-fiducials.csv" % PROJECT), "w", newline="") as fh:
        w = csv.DictWriter(fh, fieldnames=["Ref", "PosX", "PosY", "Side", "Copper_mm", "Mask_opening_mm"])
        w.writeheader()
        w.writerows(rows)


def refkey(r):
    head = r.rstrip("0123456789")
    return (head, int(r[len(head):] or 0))


def export_bom(out, B, spec):
    side = {fp.GetReference(): ("bottom" if fp.IsFlipped() else "top") for fp in B.b.GetFootprints()}
    parts = {p["ref"]: p for p in spec["parts"]}
    lines = sorted(spec["bom_summary"], key=lambda b: refkey(sorted(b["refs"], key=refkey)[0]))
    with open(os.path.join(out, "%s-bom.csv" % PROJECT), "w", newline="") as fh:
        w = csv.writer(fh)
        w.writerow(["Item", "Quantity", "References", "Value", "Footprint", "Manufacturer", "MPN", "DNP", "Side", "Qty top", "Qty bottom", "Description"])
        for i, b in enumerate(lines):
            refs = sorted(b["refs"], key=refkey)
            nt = sum(1 for r in refs if side[r] == "top")
            nb = len(refs) - nt
            desc = parts[refs[0]].get("description", "")
            desc = desc.split(", ", 1)[1] if len(refs) > 1 and ", " in desc else desc      # the part, not the role of one reference
            w.writerow([i + 1, b["qty"], " ".join(refs), b["value"], b["footprint"], b["manufacturer"], b["mpn"], "yes" if b["dnp"] else "no",
                        "top" if nb == 0 else "bottom" if nt == 0 else "top + bottom", nt, nb, desc])
    with open(os.path.join(out, "%s-bom-per-part.csv" % PROJECT), "w", newline="") as fh:
        w = csv.writer(fh)
        w.writerow(["Reference", "Value", "Footprint", "Manufacturer", "MPN", "DNP", "Side", "Description"])
        for p in sorted(spec["parts"], key=lambda p: refkey(p["ref"])):
            if p.get("in_bom"):
                w.writerow([p["ref"], p["value"], p["footprint"], p["manufacturer"], p["mpn"], "yes" if p["dnp"] else "no", side[p["ref"]], p.get("description", "")])
    return lines


# ====================================================================================================== drawings (cairo, millimetres)
class Page:
    """One PDF page in millimetres, y down."""

    def __init__(self, ctx, title, sheet, nsheets, spec, sha):
        self.ctx = ctx
        ctx.set_source_rgb(0, 0, 0)
        ctx.set_line_width(0.35)
        ctx.rectangle(8, 8, A3[0] - 16, A3[1] - 16)
        ctx.stroke()
        # title block
        x0, y0, w, h = A3[0] - 8 - 150, A3[1] - 8 - 22, 150, 22
        ctx.rectangle(x0, y0, w, h)
        ctx.stroke()
        self.text(x0 + 2, y0 + 5.5, "LPDDR5-CMD-TESTBED  ZCU104   R%s" % spec["meta"]["revision"], 3.6, bold=True)
        self.text(x0 + 2, y0 + 10.5, title, 3.0, bold=True)
        self.text(x0 + 2, y0 + 15.0, "%s   sheet %d of %d   dimensions in mm   do not scale" % (PROJECT + ".kicad_pcb", sheet, nsheets), 2.2)
        self.text(x0 + 2, y0 + 19.2, "board file SHA-256 %s" % sha[:32] + "...", 2.0, mono=True)

    def text(self, x, y, s, size=2.5, bold=False, mono=False, align="l", colour=(0, 0, 0), angle=0.0):
        ctx = self.ctx
        ctx.save()
        ctx.select_font_face("DejaVu Sans Mono" if mono else "DejaVu Sans", cairo.FONT_SLANT_NORMAL, cairo.FONT_WEIGHT_BOLD if bold else cairo.FONT_WEIGHT_NORMAL)
        ctx.set_font_size(size)
        ctx.set_source_rgb(*colour)
        ext = ctx.text_extents(s)
        ctx.translate(x, y)
        ctx.rotate(angle)
        dx = 0 if align == "l" else -ext.x_advance if align == "r" else -ext.x_advance / 2
        ctx.move_to(dx, 0)
        ctx.show_text(s)
        ctx.restore()
        return ext.x_advance

    def table(self, x, y, cols, rows, size=2.4, row_h=4.4, head=True, mono=False):
        """cols = [(title, width, align)]; returns the y below the table."""
        ctx = self.ctx
        w = sum(c[1] for c in cols)
        n = len(rows) + (1 if head else 0)
        ctx.set_line_width(0.25)
        ctx.set_source_rgb(0, 0, 0)
        if head:
            ctx.set_source_rgb(0.90, 0.90, 0.90)
            ctx.rectangle(x, y, w, row_h)
            ctx.fill()
            ctx.set_source_rgb(0, 0, 0)
        ctx.rectangle(x, y, w, n * row_h)
        for i in range(1, n):
            ctx.move_to(x, y + i * row_h)
            ctx.line_to(x + w, y + i * row_h)
        cx = x
        for c in cols[:-1]:
            cx += c[1]
            ctx.move_to(cx, y)
            ctx.line_to(cx, y + n * row_h)
        ctx.stroke()
        for r, row in enumerate(([[c[0] for c in cols]] if head else []) + rows):
            cx = x
            for c, cell in zip(cols, row):
                al = c[2] if not (head and r == 0) else "l"
                tx = cx + 1.2 if al == "l" else cx + c[1] - 1.2 if al == "r" else cx + c[1] / 2
                self.text(tx, y + r * row_h + row_h * 0.72, str(cell), size, bold=(head and r == 0), align=al, mono=mono and not (head and r == 0))
                cx += c[1]
        return y + n * row_h

    def arrow(self, x, y, ang, size=1.6):
        ctx = self.ctx
        ctx.save()
        ctx.translate(x, y)
        ctx.rotate(ang)
        ctx.move_to(0, 0)
        ctx.line_to(size, size * 0.28)
        ctx.line_to(size, -size * 0.28)
        ctx.close_path()
        ctx.fill()
        ctx.restore()

    def dim_h(self, xa, xb, y_obj, y_dim, label, size=2.5):
        """Horizontal dimension between the page x positions xa, xb; extension lines from y_obj to y_dim."""
        ctx = self.ctx
        ctx.set_line_width(0.18)
        ctx.set_source_rgb(0, 0, 0)
        d = 1.0 if y_dim > y_obj else -1.0
        for x in (xa, xb):
            ctx.move_to(x, y_obj + d * 0.8)
            ctx.line_to(x, y_dim + d * 1.2)
        ctx.move_to(xa, y_dim)
        ctx.line_to(xb, y_dim)
        ctx.stroke()
        self.arrow(xa, y_dim, 0.0)
        self.arrow(xb, y_dim, math.pi)
        if abs(xb - xa) > len(label) * size * 0.62 + 4:
            self.text((xa + xb) / 2, y_dim - 0.8, label, size, align="c")
        else:
            self.text(max(xa, xb) + 1.5, y_dim + size * 0.36, label, size)

    def dim_v(self, ya, yb, x_obj, x_dim, label, size=2.5):
        ctx = self.ctx
        ctx.set_line_width(0.18)
        ctx.set_source_rgb(0, 0, 0)
        d = 1.0 if x_dim > x_obj else -1.0
        for y in (ya, yb):
            ctx.move_to(x_obj + d * 0.8, y)
            ctx.line_to(x_dim + d * 1.2, y)
        ctx.move_to(x_dim, ya)
        ctx.line_to(x_dim, yb)
        ctx.stroke()
        self.arrow(x_dim, ya, math.pi / 2 if yb > ya else -math.pi / 2)
        self.arrow(x_dim, yb, -math.pi / 2 if yb > ya else math.pi / 2)
        self.text(x_dim - 0.8, (ya + yb) / 2, label, size, align="c", angle=-math.pi / 2)

    def leader(self, x, y, tx, ty, label, size=2.4, align="l"):
        ctx = self.ctx
        ctx.set_line_width(0.18)
        ctx.set_source_rgb(0, 0, 0)
        ctx.move_to(x, y)
        ctx.line_to(tx, ty)
        ctx.stroke()
        self.arrow(x, y, math.atan2(ty - y, tx - x), 1.4)
        self.text(tx + (0.8 if align == "l" else -0.8), ty + size * 0.36, label, size, align=align)


def outline_path(ctx, poly, tf):
    for k, (x, y) in enumerate(poly.exterior.coords):
        (ctx.move_to if k == 0 else ctx.line_to)(*tf(x, y))
    ctx.close_path()


def drill_symbol(ctx, kind, x, y, s):
    """kind: vip (0.15 filled, solid dot), fill20 (0.20 filled, solid square), plain (0.20 plain, open circle), npth (cross in a circle)."""
    ctx.new_path()
    if kind == "vip":
        ctx.arc(x, y, s * 0.42, 0, 2 * math.pi)
        ctx.fill()
    elif kind == "fill20":
        ctx.rectangle(x - s * 0.5, y - s * 0.5, s, s)
        ctx.fill()
    elif kind == "plain":
        ctx.set_line_width(0.16)
        ctx.arc(x, y, s * 0.5, 0, 2 * math.pi)
        ctx.stroke()
    else:
        ctx.set_line_width(0.25)
        ctx.arc(x, y, s, 0, 2 * math.pi)
        ctx.move_to(x - s * 1.5, y)
        ctx.line_to(x + s * 1.5, y)
        ctx.move_to(x, y - s * 1.5)
        ctx.line_to(x, y + s * 1.5)
        ctx.stroke()
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
