fingoldin/lpddr5-testbed/scripts/check_fab.py

#!/usr/bin/env python3
"""Verify the fabrication package in fab/ against the board, without KiCad's plot code:  check_fab.py [--fab dir] [--out dir]

scripts/make_fab.py writes the package with kicad-cli; this script reads the files back with its own parsers (Gerber RS-274X / X2 with
aperture macros, regions, arcs and polarity; Excellon; IPC-D-356; the CSV files) and compares them with the board file as pcbnew reports
it (items and their geometry, not plots):

  gerber    six copper files with the X2 file functions L1 .. L6; every selected aperture defined and non-zero; the profile is one closed
            contour whose extents are the 69.6 x 30.0 mm outline; each copper layer rasterised from the Gerber equals the same layer
            rasterised from the pcbnew items (tracks, arcs, vias with their per-layer pads, pad polygons, zone fills) to one pixel;
            no copper outside the profile, smallest distance to the edge per layer
  mask      every finger of J1, every test pad and every fiducial lies inside a mask opening; the centre of every plain (tented) via is
            covered on both faces; no legend on exposed copper
  paste     one opening per pad that has paste; none on the fingers, test pads and fiducials
  drill     plated / non-plated Excellon files: every hit is a via or a hole of the board with that diameter, and the reverse; the
            filled-and-capped list equals the vias that carry the attribute in the board file
  netlist   IPC-D-356: one record per via and per numbered pad, net names in one-to-one relation with the board's nets
  position  one row per placed part of that face; X / Y = footprint position in the card frame; rotation = KiCad orientation; pad 1 of
            every part lands where that convention puts it
  bom       references, values, MPN and quantities equal the board and design/netlist.json; nothing fitted that is not in the BOM
  drc       kicad-cli DRC with all severities and schematic parity (KiCad's own check, recorded here)

Writes <out>/report.json, <out>/report.txt and PNG images of the Gerbers (drill hits overlaid) for the eye.  Exit status 1 if a check fails.
"""
import argparse
import csv
import hashlib
import json
import math
import os
import re
import subprocess
import sys

import cairo
import numpy as np

HERE = os.path.dirname(os.path.abspath(__file__))
ROOT = os.path.dirname(HERE)
sys.path.insert(0, os.path.join(HERE, "pcb"))
import common as C      # noqa: E402
import pcbnew           # noqa: E402

PROJECT = C.PROJECT
CU_FILES = [("F.Cu", "F_Cu", "Copper,L1,Top"), ("In1.Cu", "In1_Cu", "Copper,L2,Inr"), ("In2.Cu", "In2_Cu", "Copper,L3,Inr"),
            ("In3.Cu", "In3_Cu", "Copper,L4,Inr"), ("In4.Cu", "In4_Cu", "Copper,L5,Inr"), ("B.Cu", "B_Cu", "Copper,L6,Bot")]
OTHER_FILES = [("F.Mask", "F_Mask", "Soldermask,Top"), ("B.Mask", "B_Mask", "Soldermask,Bot"), ("F.Paste", "F_Paste", "Paste,Top"),
               ("B.Paste", "B_Paste", "Paste,Bot"), ("F.Silkscreen", "F_Silkscreen", "Legend,Top"), ("B.Silkscreen", "B_Silkscreen", "Legend,Bot"),
               ("Edge.Cuts", "Edge_Cuts", "Profile,NP"), ("User.Comments", "User_Comments", "Other,Comment"),
               ("User.Drawings", "User_Drawings", "OtherDrawing,Comment"), ("F.Fab", "F_Fab", "AssemblyDrawing,Top"), ("B.Fab", "B_Fab", "AssemblyDrawing,Bot")]
COL = {"F.Cu": (1.00, 0.33, 0.33), "In1.Cu": (0.36, 0.80, 0.36), "In2.Cu": (0.88, 0.66, 0.22), "In3.Cu": (0.30, 0.66, 1.00),
       "In4.Cu": (0.80, 0.42, 1.00), "B.Cu": (0.20, 0.82, 0.80), "F.Mask": (0.75, 0.45, 0.85), "B.Mask": (0.75, 0.45, 0.85),
       "F.Paste": (0.80, 0.80, 0.80), "B.Paste": (0.80, 0.80, 0.80), "F.Silkscreen": (0.95, 0.95, 0.95), "B.Silkscreen": (0.95, 0.95, 0.95),
       "Edge.Cuts": (0.95, 0.95, 0.25)}
BG = (0.055, 0.065, 0.085)
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
