fingoldin/lpddr5-testbed/scripts/check_footprints.py

#!/usr/bin/env python3
"""Check the generated footprints with pcbnew and render them.

    python3 scripts/check_footprints.py [--no-render]

Loads lib/lpddr5_testbed.pretty/{DDR4_SODIMM_260_Edge,BGA-315_12.4x15mm_P0.8x0.7mm,MLF-6-1EP_2x2mm_P0.65mm_EP0.8x1.4mm} with the
pcbnew API, prints pad counts / extents / key coordinates and asserts the DDR4 SO-DIMM
(JEDEC MO-310) numbers independently of gen_footprints.py (literal values from the drawings,
see lib/README.md), cross-checks the finger pattern against the stock KiCad DDR4 SO-DIMM
socket footprint, and writes PNG renders to lib/render/.
All coordinates printed are in the CARD frame (x from the pin-1 side, y up from the finger
edge) for the edge footprint and in the footprint frame for the BGA.
"""
import os
import subprocess
import sys
import tempfile

import pcbnew

HERE = os.path.dirname(os.path.abspath(__file__))
sys.path.insert(0, HERE)
import gen_footprints as g  # noqa: E402

LIB = g.LIB_DIR
OUT = os.path.normpath(os.path.join(LIB, '..', 'render'))
STOCK = '/usr/share/kicad/footprints/Connector_PCBEdge.pretty'
mm = pcbnew.ToMM
EPS = 1e-6
nfail = 0


def check(cond, msg):
    global nfail
    print('  %s %s' % ('ok  ' if cond else 'FAIL', msg))
    if not cond:
        nfail += 1


def near(a, b, tol=EPS):
    return abs(a - b) <= tol


def pads_of(fp):
    d = {}
    for p in fp.Pads():
        d.setdefault(p.GetNumber(), []).append(p)
    return d
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
