fingoldin/lpddr5-testbed/(notices)

Notices in the files:
references/amd/DS925_ZynqUSplus_DC_AC_Switching_Characteristics_v1.30.txt:
© Copyright 2015–2026 Advanced Micro Devices, Inc. AMD, the AMD Arrow logo, UltraScale, UltraScale+,
are trademarks of PCI-SIG and used under license. Other product names used in this publication are for
references/hs_design/Altera_AN958_Board_Design_Guidelines_2023-06-26.txt:
© Altera Corporation. Altera, the Altera logo, the ‘a’ logo, and other Altera marks are trademarks of Altera Corporation. Altera
references/hs_design/Altera_AN224_HighSpeed_Board_Layout_Guidelines.txt:
Copyright © 2009 Altera Corporation. All rights reserved. Altera, The Programmable Solutions Company, the
references/micron/TN-46-14_Hardware_Tips_Point-to-Point_System_Design_RevB_2008-06.txt:
TN4614.fm - Rev. B 6/30/08 EN 13 ©2006 Micron Technology, Inc. All rights reserved.
TN4614.fm - Rev. B 6/30/08 EN 14 ©2006 Micron Technology, Inc. All rights reserved.
TN4614.fm - Rev. B 6/30/08 EN 15 ©2006 Micron Technology, Inc. All rights reserved.
TN4614.fm - Rev. B 6/30/08 EN 16 ©2006 Micron Technology, Inc. All rights reserved.
parts and their libraries:
License: Apache-2.0
